jun1okamura/TR-1um_C4004_Clone2Build/Summary.md

# TR-1um C4004 4-bit CPU 設計・最適化 試行サマリー (`Summary.md`)

本ドキュメントは、OpenSUSI `TR-1um` PDK（1 µm CMOS、2層メタル `M1`/`M2`、電源電圧 `5.0 V`、`2500 µm × 2500 µm` 16パッドフレーム）を用いた Intel 4004 互換 4-bit CPU（`C4004`）の自動設計・レイアウト・ポストレイアウト検証の試行結果を試行番号順（**全10回試行：`TR-1um_C4004_01` 〜 `TR-1um_C4004_10` 完了**）に記載したものです。

---

## 試行比較一覧表（第1回〜第10回 全試行サマリー）

| 項目 | 第1回試行 (`TR-1um_C4004_01`) | 第2回試行 (`TR-1um_C4004_02`) | 第3回試行 (`TR-1um_C4004_03`) | 第4回試行 (`TR-1um_C4004_04`) | 第5回試行 (`TR-1um_C4004_05`) | 第6回試行 (`TR-1um_C4004_06`) | 第7回試行 (`TR-1um_C4004_07`) | 第8回試行 (`TR-1um_C4004_08`) | **第9回試行 (`TR-1um_C4004_09`) [最短WL・最低電力!]** | **第10回試行 (`TR-1um_C4004_10`) [歴代最速19.0MHz更新!!]** |
| :--- | :---: | :---: | :---: | :---: | :---: | :---: | :---: | :---: | :---: | :---: |
| **チップ外形 / コア領域** | `2500×2500 µm` / `1840×1840 µm` | `2500×2500 µm` / `1840×1840 µm` | `2500×2500 µm` / `1840×1840 µm` | `2500×2500 µm` / `1840×1840 µm` | `2500×2500 µm` / `1840×1840 µm` | `2500×2500 µm` / `1840×1840 µm` | `2500×2500 µm` / `1840×1840 µm` | `2500×2500 µm` / `1840×1840 µm` | `2500×2500 µm` / `1840×1840 µm` | **`2500×2500 µm` / `1840×1840 µm`** |
| **RTLマイクロアーキテクチャ最適化** | 基本37-FF + リップルキャリー共有加算器 | シャドウPCバイパス (`buf_l/m/h` 直出) + 明示的4-bit CLA | `X1` 先行レジスタ読出しパイプラインALU (`buf_l` 共用) | 完全ノンストップShadow PC + 専用 `reg_buf` `X1` 先行読出しフルサイクルCLA | 完全ノンストップShadow PC + 4-bit完全対称 `NAND3+MUXDFFRB` `reg_buf[3:0]` | 完全ノンストップShadow PC + 4-bit対称 `reg_buf[3:0]` + `d_hiz`/`d_oe` 専用高駆動 `BUF_X2` | 完全ノンストップShadow PC + 4-bit対称 `reg_buf[3:0]` + `d_hiz`/`d_oe` `BUF_X2` + `OR3+INV_X1` `sram_ce` ドライバ | 完全ノンストップShadow PC + 4-bit対称 `reg_buf[3:0]` + `clk_in_th` 直結単段 `NOR3` `sram_ce` + 9系統クロック/リセットツリー | 完全ノンストップShadow PC + 4-bit対称 `reg_buf[3:0]` + `clk_in_th` 直結単段 `NOR3` `sram_ce` + `_1072_` 南端直近配置 + 8系統低容量クロック/リセットツリー (`FO=9`) | **完全ノンストップShadow PC + 8系統クロック/リセットツリー (`FO=9`) + `d_hiz`/`d_oe` カスケード分離 (`FO(d_hiz_pre)=1`) + `X1` 半周期 `reg_buf[3:0]`・`NAND2/3` Row 8 `SRAM128` 直下集約配置** |
| **`SRAM128` 配置座標 `(X, Y)`** | `(338.2 µm, 1603.8 µm)` | `(334.8 µm, 1587.6 µm)` | `(334.8 µm, 1609.2 µm)` | `(334.8 µm, 1614.6 µm)` | `(340.2 µm, 1614.6 µm)` | `(345.6 µm, 1614.6 µm)` | `(340.2 µm, 1609.2 µm)` | `(340.2 µm, 1614.6 µm)` | `(334.8 µm, 1614.6 µm)` | **`(340.2 µm, 1614.6 µm)`（水平中央・北端）** |
| **スタンダードセル行数（チャネル数）** | `9` 行（ピッチ `178.2 µm` / チャネル `118.8 µm`） | `10` 行（ピッチ `156.6 µm` / チャネル `97.2 µm`） | `10` 行（GCell整合ピッチ `162.0 µm` / チャネル `102.6 µm`） | `11` 行（ピッチ `145.8 µm` / チャネル `86.4 µm` = 16トラック） | `11` 行（ピッチ `145.8 µm` / チャネル `86.4 µm` = 16トラック） | `11` 行（ピッチ `145.8 µm` / チャネル `86.4 µm` = 16トラック） | `11` 行（ピッチ `145.8 µm` / チャネル `86.4 µm` = 16トラック） | `11` 行（ピッチ `145.8 µm` / チャネル `86.4 µm` = 16トラック） | `11` 行（ピッチ `145.8 µm` / チャネル `86.4 µm` = 16トラック） | **`11` 行（ピッチ `145.8 µm` / チャネル `86.4 µm` = 16トラック）** |
| **総サイト数 / ロジック使用サイト数** | `2,925` / `2,726` (`93.20%`) | `3,250` / `2,649` (`81.51%`) | `3,250` / `2,764` (`85.05%`) | `3,575` / `2,839` (`79.41%`) | `3,575` / `2,837` (`79.36%`) | `3,575` / `2,843` (`79.52%`) | `3,575` / `2,846` (`79.61%`) | `3,575` / `2,837` (`79.36%`) | **`3,575` / `2,831` (`79.19%` 最低密度!)** | **`3,575` / `2,831` (`79.19%` 最低密度タイ!)** |
| **論理セル数（標準セル + マクロ）** | `599` (`598` stdcells + `1 SRAM128`) | `579` (`578` stdcells + `1 SRAM128`) | `607` (`606` stdcells + `1 SRAM128`) | `616` (`615` stdcells + `1 SRAM128`) | `614` (`613` stdcells + `1 SRAM128`) | `616` (`615` stdcells + `1 SRAM128`) | `617` (`616` stdcells + `1 SRAM128`) | `614` (`613` stdcells + `1 SRAM128`) | **`612` (`611` stdcells + `1 SRAM128` 41-FF最少!)** | **`612` (`611` stdcells + `1 SRAM128` 41-FF最少タイ!)** |
| **順序回路（FF）数** | `37` (`22 MUXDFFRB` + `15 DFFRB`) | `37` (`22 MUXDFFRB` + `15 DFFRB`) | `37` (`22 MUXDFFRB` + `15 DFFRB`) | `41` (`25 MUXDFFRB` + `16 DFFRB`) | `41` (`26 MUXDFFRB` + `15 DFFRB`) | `41` (`26 MUXDFFRB` + `15 DFFRB`) | `41` (`26 MUXDFFRB` + `15 DFFRB`) | `41` (`26 MUXDFFRB` + `15 DFFRB`) | `41` (`26 MUXDFFRB` + `15 DFFRB`) | **`41` (`26 MUXDFFRB` + `15 DFFRB`)** |
| **デキャップ（Filler）セル数 / サイト数** | `72` (`55 FILL3` + `17 FILL2`) / `199` sites | `211` (`179 FILL3` + `32 FILL2`) / `601` sites | `175` (`136 FILL3` + `39 FILL2`) / `486` sites | `257` (`222 FILL3` + `35 FILL2`) / `736` sites | `254` (`230 FILL3` + `24 FILL2`) / `738` sites | `253` (`226 FILL3` + `27 FILL2`) / `732` sites | `255` (`219 FILL3` + `36 FILL2`) / `729` sites | `258` (`222 FILL3` + `36 FILL2`) / `738` sites | **`256` (`232 FILL3` + `24 FILL2`) / `744` sites（最大!）** | **`258` (`228 FILL3` + `30 FILL2`) / `744` sites（最大タイ!）** |
| **総トランジスタ数（結合後 / マルチフィンガ展開）** | `6,108` / `6,368` MOSFETs (+ `28` Diodes) | `6,252` / `6,512` MOSFETs (+ `28` Diodes) | `6,364` / `6,624` MOSFETs (+ `28` Diodes) | `6,692` / `6,952` MOSFETs (+ `28` Diodes) | `6,686` / `6,946` MOSFETs (+ `28` Diodes) | `6,692` / `6,952` MOSFETs (+ `28` Diodes) | `6,700` / `6,960` MOSFETs (+ `28` Diodes) | `6,694` / `6,954` MOSFETs (+ `28` Diodes) | **`6,682` / `6,942` MOSFETs (+ `28` Diodes, 41-FF最少!)** | `6,686` / `6,946` MOSFETs (+ `28` Diodes) |
| **OpenROAD 総配線長 (`M1` + `M2`)** | `442,818 µm` (`218,035` + `224,783 µm`) | **`420,271 µm`** (`215,633` + `204,637 µm`) | `431,639 µm` (`214,383` + `217,256 µm`) | `448,871 µm` (`224,708` + `224,162 µm`) | `446,626 µm` (`222,628` + `223,997 µm`) | `448,037 µm` (`224,286` + `223,750 µm`) | `456,846 µm` (`225,921` + `230,924 µm`) | `438,162 µm` (`217,831` + `220,331 µm`) | **`430,680 µm` (`216,368` + `214,312 µm`) [41-FF最短!]** | `450,643 µm` (`220,437` + `230,206 µm`) |
| **信号ビア (`V1`) 総数** | `2,756` | `2,643` | **`2,607`（最小ビア数）** | `2,890` | `2,906` | `2,939` | `2,910` | `2,844` | **`2,717` [41-FF最少! 第1回37-FFより少!]** | `2,985` |
| **OpenROAD DRC / KLayout DRC** | **`0` 件 / `0` 件** | **`0` 件 / `0` 件** | **`0` 件 / `0` 件** | **`0` 件 / `0` 件** | **`0` 件 / `0` 件** | **`0` 件 / `0` 件** | **`0` 件 / `0` 件** | **`0` 件 / `0` 件** | **`0` 件 / `0` 件** | **`0` 件 / `0` 件** |
| **KLayout LVS (`deep` & `flat`)** | **`Match`（完全一致）** | **`Match`（完全一致）** | **`Match`（完全一致）** | **`Match`（完全一致）** | **`Match`（完全一致）** | **`Match`（完全一致）** | **`Match`（完全一致）** | **`Match`（完全一致）** | **`Match`（完全一致）** | **`Match`（完全一致）** |
| **最大動作周波数 `FMAX` (`ngspice`, `1.0 pF`)** | `8.0 MHz` (内部ALU `9.0 MHz`) | `11.0 MHz` (内部ALU `11.0 MHz`) | `8.5 MHz` (内部ALU `15.0 MHz`) | `16.5 MHz` (外部PC `20.0+ MHz`) | `17.0 MHz` (外部PC `20.0+ MHz`) | `17.0 MHz` (外部PC `22.0+ MHz`) | `16.0 MHz` | `18.5 MHz` (`+131.3%` / `2.313倍`) | `18.5 MHz` (`+131.3%` + `19 MHz` 外部バスPASS!) | **`19.0 MHz` (`+137.5%` / `2.375倍` 全10回歴代最高速更新!!)** |
| **命令サイクル時間 (`8 × T_clk`) @ `FMAX`** | `1.000 µs` (`1.00 MIPS`) | `0.727 µs` (`1.375 MIPS`) | `0.941 µs` (`1.063 MIPS`) | `0.485 µs` (`2.063 MIPS`) | `0.471 µs` (`2.125 MIPS`) | `0.471 µs` (`2.125 MIPS`) | `0.500 µs` (`2.000 MIPS`) | `0.432 µs` (`2.313 MIPS`) | `0.432 µs` (`2.313 MIPS`) | **`0.421 µs` (`2.375 MIPS` 歴代最高スループット更新!!)** |
| **パッド出力遅延 `t_pd` (`sync` / `cm_rom` / `d_oe` / `D[3:0]`)** | `33.66` / `33.89` / `43.13` / `39.83 ns` | `34.23` / `39.32` / `44.72` / `40.72 ns` | `33.82` / `34.03` / `44.66` / `39.44 ns` | `35.30` / `35.59` / `47.42` / `41.41 ns` | `35.29` / `35.57` / `47.40` / `41.39 ns` | `35.29` / `35.57` / `44.86` / `40.85 ns` | `34.78` / `35.09` / `44.39` / `40.37 ns` | `34.71` / `35.00` / `44.29` / `40.28 ns` | **`34.37` / `34.69` / `43.95` / `39.96 ns` (@ `18.5 MHz`)** | **`34.37` / `34.67` / `45.47` / `39.81 ns` (@ `19.0 MHz` 41-FF最短 `D[3:0]` 遅延!)** |
| **消費電力 (`@ 1 MHz` / `@ 8 MHz` / `@ FMAX`)** | `1.688 mW` / `12.509 mW` / `12.509 mW` | `1.560 mW` / `11.508 mW` / `15.750 mW` (`@ 11 MHz`) | `1.686 mW` / `12.407 mW` / `13.177 mW` (`@ 8.5 MHz`) | `1.604 mW` / `11.911 mW` / `24.329 mW` (`@ 16.5 MHz`) | `1.602 mW` / `11.897 mW` / `25.045 mW` (`@ 17.0 MHz`) | `1.613 mW` / `11.973 mW` / `25.208 mW` (`@ 17.0 MHz`) | `1.609 mW` / `11.952 mW` / `23.658 mW` (`@ 16.0 MHz`) | `1.588 mW` / `11.783 mW` / `26.995 mW` (`@ 18.5 MHz`) | **`1.570 mW` / `11.630 mW` (41-FF最小!) / `26.641 mW` (`@ 18.5 MHz`)** | `1.574 mW` / `11.673 mW` / **`27.469 mW` (`@ 19.0 MHz`)** |

---

## 第1回試行：`TR-1um_C4004_01`

### 1. アーキテクチャおよびフロアプランの特徴
1. **アーキテクチャ構成**:
   - Intel 4004 の全45命令を完全実装。16本の4-bitインデックスレジスタ（`R0〜R15`）および4レベルの12-bitプログラムカウンタ/スタック（`4 × 3 nibbles`）を単一の `SRAM128` に統合。
   - `A1〜A3` フェーズのシリアルPCインクリメンタと `X2` フェーズのALU/レジスタインクリメンタで単一の4-bit加算器を共有し、37個のフリップフロップ（`22 MUXDFFRB` + `15 DFFRB`）に状態機械を凝縮。
2. **フロアプラン・`SRAM128` 配置・チャネル構成**:
   - **スタンダードセル行数**: 9行（`Y = 32.4 µm 〜 1458.0 µm`、行ピッチ `178.2 µm`、配線チャネル高さ `118.8 µm` = 22トラック、全 `2,925` サイト）。
   - **`SRAM128` マクロ配置**: コア上部中央 `(X = 338.2 µm, Y = 1603.8 µm)` に配置。
   - **最大動作周波数**: ポストレイアウト `ngspice` 検証で **`FMAX = 8.0 MHz`**（内部ALUは `9.0 MHz` まで動作、`A1` での `negedge clk` からの `SRAM128` PC読み出し → `D[3:0]` パッド出力パスが律速）。

### 2. セル・素子・配線統計諸表 (`TR-1um_C4004_01`)

| カテゴリ | 項目 | 数値 | 備考 |
| :--- | :--- | :---: | :--- |
| **セル・サイト統計** | ロジック標準セル数 | `598` 個 | 使用サイト数 `2,726` / `2,925` (`93.20%`) |
| | 内 順序回路（FF） | `37` 個 | `MUXDFFRB`: 22個, `DFFRB`: 15個 |
| | 内 入力シュミットバッファ | `7` 個 | `BUFTH`: 7個 (`clk, rst, test, d_in[3:0]`) |
| | 内 クロック/リセット/高FOバッファ | `56` 個 | `BUF_X2`: クロック9 + リセット9 + 高FO 38個 |
| | 内 組み合わせ論理セル | `498` 個 | 基本37-FF + リップルキャリー共有加算器 |
| | メモリマクロ | `1` 個 | `SRAM128` (`(338.2 µm, 1603.8 µm)`, `1,212` MOSFETs) |
| | 基板タップセル (`TAP2`) | `36` 個 | 4列 × 9行 |
| | デキャップFillerセル | `72` 個 | `FILL3`: 55個 (`165` sites), `FILL2`: 17個 (`34` sites), `FILL1`: 0個（計 `199` sites） |
| **抽出素子統計** | フルチップ総MOSFET数（展開後） | `6,368` 個 | `PMOS`: 2,990, `NMOS`: 3,218, `NMOSE`: 160 (+`28` Diodes) |
| | フルチップ総MOSFET数（結合後） | `6,108` 個 | `PMOS`: 2,860, `NMOS`: 3,218, `NMOSE`: 30 (+`28` Diodes) |
| | コア (`c4004_core`) MOSFET数 | `5,824` 個 | `PMOS`: 2,718, `NMOS`: 3,106（内 `SRAM128`: `1,212` 個） |
| **配線・サインオフ** | 総信号ネット数 / 最大FO | `647` / `10` | 全ネット `FO <= 10` 達成 |
| | OpenROAD 総配線長 | `442,818 µm` | `METAL1`: `218,035 µm` (`49.24%`), `METAL2`: `224,783 µm` (`50.76%`) |
| | 信号ビア (`V1`) 数 | `2,756` 個 | OpenROAD DRC `0` 件完走 |
| | KLayout DRC / LVS | **`0` 件 / `Match`** | `deep` / `flat` 両モードで完全一致 |

### 3. ポストレイアウト `ngspice` 検証・周波数スイープ結果 (`TR-1um_C4004_01`)

| クロック周波数 | 周期 `T_clk` | 総合判定 | `PC` 出力 (`A1..A3`) | 内部ALU `ACC` (`X2`) | `t_pd(sync)` | `t_pd(cm_rom)` | `t_pd(d_oe)` | `t_pd(D[3:0])` | 平均電流 `I_VDD` | 平均消費電力 `P_avg` |
| :---: | :---: | :---: | :---: | :---: | :---: | :---: | :---: | :---: | :---: | :---: |
| **`1.0 MHz`** | `1000.0 ns` | **PASS** | `0x006` | **`0xA`** | `33.65 ns` | `33.87 ns` | `43.14 ns` | `39.84 ns` | `0.338 mA` | `1.688 mW` |
| **`2.0 MHz`** | `500.0 ns` | **PASS** | `0x006` | **`0xA`** | `33.66 ns` | `33.87 ns` | `43.14 ns` | `39.84 ns` | `0.649 mA` | `3.246 mW` |
| **`4.0 MHz`** | `250.0 ns` | **PASS** | `0x006` | **`0xA`** | `33.66 ns` | `33.88 ns` | `43.14 ns` | `39.84 ns` | `1.270 mA` | `6.349 mW` |
| **`6.0 MHz`** | `166.7 ns` | **PASS** | `0x006` | **`0xA`** | `33.66 ns` | `33.88 ns` | `43.13 ns` | `39.83 ns` | `1.886 mA` | `9.431 mW` |
| **`8.0 MHz`** | `125.0 ns` | **PASS (`FMAX`)** | `0x006` | **`0xA`** | `33.66 ns` | `33.89 ns` | `43.13 ns` | `39.83 ns` | `2.502 mA` | `12.509 mW` |
| `9.0 MHz` | `111.1 ns` | FAIL (外部PC) | `0x000` | **`0xA` (内部PASS)** | `33.65 ns` | `33.89 ns` | `43.12 ns` | `39.83 ns` | `2.753 mA` | `13.765 mW` |
| `10.0 MHz` | `100.0 ns` | FAIL | `0x009` | `0xB` | `33.65 ns` | `33.89 ns` | `43.12 ns` | `39.83 ns` | `3.004 mA` | `15.019 mW` |
| `12.0 MHz` | `83.3 ns` | FAIL | `0x019` | `0x3` | `33.54 ns` | `33.76 ns` | `42.99 ns` | `39.71 ns` | `3.707 mA` | `18.537 mW` |
| `14.0 MHz` | `71.4 ns` | FAIL | `0x819` | `0x9` | `33.46 ns` | `33.69 ns` | `42.92 ns` | `39.64 ns` | `4.656 mA` | `23.282 mW` |
| `16.0 MHz` | `62.5 ns` | FAIL | `0x819` | `0x5` | `33.42 ns` | `33.63 ns` | `42.86 ns` | `39.58 ns` | `5.210 mA` | `26.052 mW` |

---

## 第2回試行：`TR-1um_C4004_02`

### 1. RTL最適化・`SRAM128` 配置・チャネル構成の特徴
1. **RTLマイクロアーキテクチャの刷新**:
   - **シャドウPCバイパス (`pc_init_n` 機構)**: `A3` で `pc_init_n <= 1'b0` となった後は、`buf_l/m/h` に保持されているPC+1を次サイクルの `A1〜A3` で `posedge clk` 直後から直接出力・インクリメントするバイパス回路を実装し、外部PC出力タイミングを半クロック周期（`0.5 × T_clk`）前倒し。
   - **明示的4ビット桁上げ先見加算器 (CLA)**: 共有4ビット加算器を2段論理のCLAに変更。
2. **フロアプラン・`SRAM128` 配置・チャネル構成**:
   - **スタンダードセル行数**: 9行から **10行**（行ピッチ `156.6 µm`、チャネル幅 `97.2 µm` = 18トラック、全 `3,250` サイト）に拡張し、`SRAM128` を `(334.8 µm, 1587.6 µm)` に配置。
   - **デキャップ増強・配線短縮**: 空きサイトに **`211` 個（`601` サイト、第1回比 3.02倍）** のデキャップFillerを挿入し、総配線長を `420,271 µm`（`-5.09%`）に短縮。
   - **最大動作周波数**: **`FMAX = 11.0 MHz`（第1回比 `+37.5%` 高速化）** を達成。`11.5 MHz` では `X2` 半周期内での `SRAM128` 読み出し＋CLA加算パスが律速。

### 2. セル・素子・配線統計諸表 (`TR-1um_C4004_02`)

| カテゴリ | 項目 | 数値 | 備考 |
| :--- | :--- | :---: | :--- |
| **セル・サイト統計** | ロジック標準セル数 | `578` 個 | 使用サイト数 `2,649` / `3,250` (`81.51%`) |
| | 内 順序回路（FF） | `37` 個 | `MUXDFFRB`: 22個, `DFFRB`: 15個 |
| | 内 入力シュミットバッファ | `7` 個 | `BUFTH`: 7個 (`clk, rst, test, d_in[3:0]`) |
| | 内 クロック/リセット/高FOバッファ | `56` 個 | `BUF_X2`: クロック10 + リセット10 + 高FO 36個 |
| | 内 組み合わせ論理セル | `478` 個 | Shadow PCバイパス + 明示的4-bit CLA（`-20` セル削減） |
| | メモリマクロ | `1` 個 | `SRAM128` (`(334.8 µm, 1587.6 µm)`, `1,212` MOSFETs) |
| | 基板タップセル (`TAP2`) | `40` 個 | 4列 × 10行 |
| | デキャップFillerセル | `211` 個 | `FILL3`: 179個 (`537` sites), `FILL2`: 32個 (`64` sites), `FILL1`: 0個（計 `601` sites） |
| **抽出素子統計** | フルチップ総MOSFET数（展開後） | `6,512` 個 | `PMOS`: 3,062, `NMOS`: 3,290, `NMOSE`: 160 (+`28` Diodes) |
| | フルチップ総MOSFET数（結合後） | `6,252` 個 | `PMOS`: 2,932, `NMOS`: 3,290, `NMOSE`: 30 (+`28` Diodes) |
| | コア (`c4004_core`) MOSFET数 | `5,968` 個 | `PMOS`: 2,790, `NMOS`: 3,178（内 `SRAM128`: `1,212` 個） |
| **配線・サインオフ** | 総信号ネット数 / 最大FO | `627` / `10` | 全ネット `FO <= 10` 達成 |
| | OpenROAD 総配線長 | **`420,271 µm`** | `METAL1`: `215,633 µm` (`51.31%`), `METAL2`: `204,637 µm` (`48.69%`) [最短配線長] |
| | 信号ビア (`V1`) 数 | `2,643` 個 | OpenROAD DRC `0` 件完走 |
| | KLayout DRC / LVS | **`0` 件 / `Match`** | `deep` / `flat` 両モードで完全一致 |

### 3. ポストレイアウト `ngspice` 検証・周波数スイープ結果 (`TR-1um_C4004_02`)

| クロック周波数 | 周期 `T_clk` | 総合判定 | `PC` 出力 (`A1..A3`) | 内部ALU `ACC` (`X2`) | `t_pd(sync)` | `t_pd(cm_rom)` | `t_pd(d_oe)` | `t_pd(D[3:0])` | 平均電流 `I_VDD` | 平均消費電力 `P_avg` |
| :---: | :---: | :---: | :---: | :---: | :---: | :---: | :---: | :---: | :---: | :---: |
| **`1.0 MHz`** | `1000.0 ns` | **PASS** | `0x006` | **`0xA`** | `34.30 ns` | `39.38 ns` | `44.80 ns` | `40.80 ns` | `0.312 mA` | `1.560 mW` |
| **`2.0 MHz`** | `500.0 ns` | **PASS** | `0x006` | **`0xA`** | `34.30 ns` | `39.38 ns` | `44.80 ns` | `40.80 ns` | `0.599 mA` | `2.996 mW` |
| **`4.0 MHz`** | `250.0 ns` | **PASS** | `0x006` | **`0xA`** | `34.30 ns` | `39.39 ns` | `44.77 ns` | `40.79 ns` | `1.169 mA` | `5.846 mW` |
| **`6.0 MHz`** | `166.7 ns` | **PASS** | `0x006` | **`0xA`** | `34.30 ns` | `39.38 ns` | `44.80 ns` | `40.79 ns` | `1.733 mA` | `8.665 mW` |
| **`8.0 MHz`** | `125.0 ns` | **PASS** | `0x006` | **`0xA`** | `34.31 ns` | `39.39 ns` | `44.79 ns` | `40.79 ns` | `2.302 mA` | `11.508 mW` |
| **`8.5 MHz`** | `117.6 ns` | **PASS** | `0x006` | **`0xA`** | `34.31 ns` | `39.38 ns` | `44.79 ns` | `40.80 ns` | `2.444 mA` | `12.220 mW` |
| **`9.0 MHz`** | `111.1 ns` | **PASS** | `0x006` | **`0xA`** | `34.30 ns` | `39.38 ns` | `44.77 ns` | `40.79 ns` | `2.587 mA` | `12.933 mW` |
| **`9.5 MHz`** | `105.3 ns` | **PASS** | `0x006` | **`0xA`** | `34.28 ns` | `39.37 ns` | `44.77 ns` | `40.79 ns` | `2.729 mA` | `13.645 mW` |
| **`10.0 MHz`** | `100.0 ns` | **PASS** | `0x006` | **`0xA`** | `34.29 ns` | `39.37 ns` | `44.76 ns` | `40.78 ns` | `2.872 mA` | `14.359 mW` |
| **`10.5 MHz`** | `95.2 ns` | **PASS** | `0x006` | **`0xA`** | `34.26 ns` | `39.36 ns` | `44.72 ns` | `40.76 ns` | `3.010 mA` | `15.051 mW` |
| **`11.0 MHz`** | `90.9 ns` | **PASS (`FMAX`)** | `0x006` | **`0xA`** | `34.23 ns` | `39.32 ns` | `44.69 ns` | `40.72 ns` | `3.150 mA` | `15.750 mW` |
| `11.5 MHz` | `87.0 ns` | FAIL (`X2` SRAM+CLA) | `0x026` | `0x3` | `34.20 ns` | `39.29 ns` | `44.66 ns` | `40.70 ns` | `3.350 mA` | `16.749 mW` |
| `12.0 MHz` | `83.3 ns` | FAIL | `0x024` | `0x3` | `34.18 ns` | `39.26 ns` | `44.62 ns` | `40.67 ns` | `3.456 mA` | `17.282 mW` |
| `14.0 MHz` | `71.4 ns` | FAIL | `0x02B` | `0x7` | `34.10 ns` | `39.17 ns` | `44.55 ns` | `40.59 ns` | `4.102 mA` | `20.510 mW` |
| `16.0 MHz` | `62.5 ns` | FAIL | `0x02B` | `0xA` | `34.04 ns` | `39.12 ns` | `44.49 ns` | `40.53 ns` | `4.639 mA` | `23.195 mW` |

---

## 第3回試行：`TR-1um_C4004_03`

### 1. RTL最適化・`SRAM128` 配置・チャネル構成の特徴
1. **RTLマイクロアーキテクチャの刷新（`X1` 先行レジスタ読み出しパイプラインALU）**:
   - 第2回試行で `11.5 MHz` のボトルネックとなった「`X2` ステート半周期内での `SRAM128` インデックスレジスタ読み出し ＋ 4ビットCLA加算」を解消するため、命令コード `opr` とレジスタ番号 `opa` が `M2`（`phase == 4`）で既に確定していることを利用し、**1ステート前の `X1`（`phase == 5`）で `SRAM128` からインデックスレジスタ `R[opa]` を先行読み出しして `buf_l` FFに直接ラッチし、`X2`（`phase == 6`）では1クロック周期丸ごと（`1.0 × T_clk`）を使ってFF間（`buf_l` → CLA → `acc`）でALU演算を実行するパイプライン方式** を実装。
2. **フロアプラン・`SRAM128` 配置・チャネル構成の再設計（GCellグリッド完全整合10行）**:
   - OpenROAD の GCell グリッド（`81.0 µm = 15 × 5.4 µm`）に完全整合するよう、10行の行ピッチを **`162.0 µm`（`30` トラック = `2.0 × GCell`、`Y = 27.0 µm 〜 1485.0 µm`）** に拡大し、各行間の配線チャネル幅を **`102.6 µm`（19トラック）** に拡張。
   - `SRAM128` を北側の **`(X = 334.8 µm, Y = 1609.2 µm)`** に再配置。

### 2. セル・素子・配線統計諸表 (`TR-1um_C4004_03`)

| カテゴリ | 項目 | 数値 | 備考 |
| :--- | :--- | :---: | :--- |
| **セル・サイト統計** | ロジック標準セル数 | `606` 個 | 使用サイト数 `2,764` / `3,250` (`85.05%`) |
| | 内 順序回路（FF） | `37` 個 | `MUXDFFRB`: 22個, `DFFRB`: 15個（追加FFゼロでパイプライン化） |
| | 内 入力シュミットバッファ | `7` 個 | `BUFTH`: 7個 (`clk, rst, test, d_in[3:0]`) |
| | 内 クロック/リセット/高FOバッファ | `49` 個 | `BUF_X2`: クロック10 + リセット10 + 高FO 29個 (`-7` 個さらに削減) |
| | 内 組み合わせ論理セル | `513` 個 | `X1` 先行アドレス選択・`X2` スタック書き込み制御を含む |
| | メモリマクロ | `1` 個 | `SRAM128` (`(334.8 µm, 1609.2 µm)`, `1,212` MOSFETs) |
| | 基板タップセル (`TAP2`) | `40` 個 | 4列 × 10行 |
| | デキャップFillerセル | `175` 個 | `FILL3`: 136個 (`408` sites), `FILL2`: 39個 (`78` sites), `FILL1`: 0個（計 `486` sites） |
| **抽出素子統計** | フルチップ総MOSFET数（展開後） | `6,624` 個 | `PMOS`: 3,118, `NMOS`: 3,346, `NMOSE`: 160 |
| | フルチップ総MOSFET数（結合後） | `6,364` 個 | `PMOS`: 2,988, `NMOS`: 3,346, `NMOSE`: 30 |
| | コア (`c4004_core`) MOSFET数 | `6,080` 個 | `PMOS`: 2,846, `NMOS`: 3,234（内 `SRAM128`: `1,212` 個） |
| **配線・サインオフ** | 総信号ネット数 / 最大FO | `654` / `10` | 全ネット `FO <= 10` 達成 |
| | OpenROAD 総配線長 | `431,639 µm` | `METAL1`: `214,383 µm`（最小M1長更新）, `METAL2`: `217,256 µm` |
| | 信号ビア (`V1`) 数 | **`2,607` 個** | **全試行で最小ビア数更新（第1回比 `-149` 個 / `-5.41%`）**、13反復でDRC 0件収束 |
| | KLayout DRC / LVS | **`0` 件 / `Match`** | `deep` / `flat` 両モードで完全一致 |

### 3. ポストレイアウト `ngspice` 検証・周波数スイープ結果 (`TR-1um_C4004_03`)
- **`X1` 先行レジスタ読み出しパイプラインの効果**: 内部ALUおよびレジスタファイル演算結果（`ACC = 0xA`）は、第2回試行の上限 `11.0 MHz` を大きく超え、**`15.0 MHz`（`T_clk = 66.7 ns`、第1回比 `+66.7%`、第2回比 `+36.4%`）まで完全にPASS** しました。
- **`buf_l` 共用による副作用の発見**: FF数を37個に抑えるために `X1` の先行読み出しラッチ先として `buf_l`（Shadow PC_L）を共用し `pc_init_n <= 1'b1` に戻したため、`LD`/`ADD` 命令の直後の `A1` フェーズで毎回 `SRAM128` からのPC読み出しが発生し、外部バスへの `PC` 出力が `8.5 MHz` で律速となりました。

| クロック周波数 | 周期 `T_clk` | 総合判定 | `PC` 出力 (`A1..A3`) | 内部ALU `ACC` (`X2`) | `t_pd(sync)` | `t_pd(cm_rom)` | `t_pd(d_oe)` | `t_pd(D[3:0])` | 平均電流 `I_VDD` | 平均消費電力 `P_avg` |
| :---: | :---: | :---: | :---: | :---: | :---: | :---: | :---: | :---: | :---: | :---: |
| **`1.0 MHz`** | `1000.0 ns` | **PASS** | `0x006` | **`0xA` (PASS)** | `33.80 ns` | `34.03 ns` | `42.25 ns` | `39.43 ns` | `0.337 mA` | `1.686 mW` |
| **`2.0 MHz`** | `500.0 ns` | **PASS** | `0x006` | **`0xA` (PASS)** | `33.82 ns` | `34.03 ns` | `42.24 ns` | `39.44 ns` | `0.645 mA` | `3.224 mW` |
| **`4.0 MHz`** | `250.0 ns` | **PASS** | `0x006` | **`0xA` (PASS)** | `33.81 ns` | `34.01 ns` | `42.22 ns` | `39.44 ns` | `1.258 mA` | `6.292 mW` |
| **`6.0 MHz`** | `166.7 ns` | **PASS** | `0x006` | **`0xA` (PASS)** | `33.82 ns` | `34.03 ns` | `42.20 ns` | `39.44 ns` | `1.880 mA` | `9.399 mW` |
| **`8.0 MHz`** | `125.0 ns` | **PASS** | `0x006` | **`0xA` (PASS)** | `33.82 ns` | `34.03 ns` | `42.22 ns` | `39.44 ns` | `2.481 mA` | `12.407 mW` |
| **`8.5 MHz`** | `117.6 ns` | **PASS (`FMAX`)** | `0x006` | **`0xA` (PASS)** | `33.84 ns` | `34.03 ns` | `42.21 ns` | `39.45 ns` | `2.635 mA` | `13.177 mW` |
| `9.0 MHz` | `111.1 ns` | FAIL (外部PC) | `0x000` | **`0xA` (内部PASS)** | `33.83 ns` | `34.02 ns` | `42.22 ns` | `39.44 ns` | `2.789 mA` | `13.945 mW` |
| `10.0 MHz` | `100.0 ns` | FAIL (外部PC) | `0x069` | **`0xA` (内部PASS)** | `33.83 ns` | `34.04 ns` | `42.21 ns` | `39.44 ns` | `3.116 mA` | `15.582 mW` |
| `12.0 MHz` | `83.3 ns` | FAIL (外部PC) | `0x029` | **`0xA` (内部PASS)** | `33.71 ns` | `33.90 ns` | `42.07 ns` | `39.32 ns` | `3.672 mA` | `18.359 mW` |
| `14.0 MHz` | `71.4 ns` | FAIL (外部PC) | `0xA19` | **`0xA` (内部PASS)** | `33.64 ns` | `33.82 ns` | `41.98 ns` | `39.25 ns` | `4.396 mA` | `21.980 mW` |
| `15.0 MHz` | `66.7 ns` | FAIL (外部PC) | `0xA99` | **`0xA` (内部PASS!)** | `33.62 ns` | `33.80 ns` | `41.95 ns` | `39.22 ns` | `4.700 mA` | `23.501 mW` |
| `16.0 MHz` | `62.5 ns` | FAIL | `0xA99` | `0x2` | `33.58 ns` | `33.78 ns` | `41.94 ns` | `39.19 ns` | `5.069 mA` | `25.346 mW` |

---

## 第4回試行：`TR-1um_C4004_04`

### 1. RTL最適化・`SRAM128` 配置・チャネル構成の特徴
1. **RTLマイクロアーキテクチャの刷新（完全ノンストップShadow PC ＋ 専用 `reg_buf` `X1` 先行読み出しフルサイクルCLA）**:
   - 第2回試行（**Shadow PCバイパスによる外部PC高速出力**）と、第3回試行（**`X1` 先行レジスタ読み出しによる `15.0 MHz` 内部ALU動作**）を100%両立させるため、**専用4ビットパイプラインレジスタ `reg_buf[3:0]`（計41 FF）** を新設。
   - `X1`（`phase == 5`）で先行読み出ししたインデックスレジスタ値 `R[opa]` や、`FIM` 第2サイクル（`M1`/`M2`）の即値データをすべて `reg_buf[3:0]` に格納し、`FIM` では `M2`/`X1` で早期に `SRAM128` へ書き込むアーキテクチャを実装。
   - これにより、**`FIM`・`LD`・`ADD`・`SUB`・`INC`・`ISZ`・`XCH`・`SRC` の実行中も Shadow PC (`buf_l/buf_m/buf_h`) が一切上書きされず常時 `PC+1` を保持し続け（`pc_init_n` が常時 `0` を維持）**、外部PC出力も `SRC` アドレス出力も `X2` ALU演算もすべて `posedge clk` 直後からFF出力で動作するノンストップパイプラインを実現。
2. **フロアプラン・`SRAM128` 配置・11行チャネル構成の再設計**:
   - **スタンダードセル行数**: 10行から **11行**（行ピッチ `145.8 µm` = `27` トラック、配線チャネル幅 `86.4 µm` = `16` トラック×11チャネル、`Y = 27.0 µm 〜 1544.4 µm`、総サイト数 **`3,575` サイト**）に拡張。
   - **`SRAM128` マクロ配置**: 北側の **`(X = 334.8 µm, Y = 1614.6 µm)`** に配置。
   - **最大デキャップ容量**: ロジック使用率を **`79.41%`（`2,839 / 3,575` サイト）** まで低減し、空きサイトに **`257` 個（`222 FILL3` + `35 FILL2` = `736` サイト、第1回比 3.70倍、`FILL1 = 0`）** のMOSデカップリングキャパシタを配置。

### 2. セル・素子・配線統計諸表 (`TR-1um_C4004_04`)

| カテゴリ | 項目 | 数値 | 備考 |
| :--- | :--- | :---: | :--- |
| **セル・サイト統計** | ロジック標準セル数 | `615` 個 | 使用サイト数 `2,839` / `3,575` (`79.41%`) |
| | 内 順序回路（FF） | `41` 個 | `MUXDFFRB`: 25個, `DFFRB`: 16個（専用 `reg_buf[3:0]` 4-FF追加） |
| | 内 入力シュミットバッファ | `7` 個 | `BUFTH`: 7個 (`clk, rst, test, d_in[3:0]`) |
| | 内 クロック/リセット/高FOバッファ | `45` 個 | `BUF_X2`: クロック10 + リセット10 + 高FO 25個（第3回比 `-4` 個削減） |
| | 内 組み合わせ論理セル | `522` 個 | 完全ノンストップShadow PC + フルサイクルCLA制御 |
| | メモリマクロ | `1` 個 | `SRAM128` (`(334.8 µm, 1614.6 µm)`, `1,212` MOSFETs) |
| | 基板タップセル (`TAP2`) | `44` 個 | 4列 × 11行 |
| | デキャップFillerセル | `257` 個 | `FILL3`: 222個 (`666` sites), `FILL2`: 35個 (`70` sites), `FILL1`: 0個（計 `736` sites） |
| **抽出素子統計** | フルチップ総MOSFET数（展開後） | `6,952` 個 | `PMOS`: 3,282, `NMOS`: 3,510, `NMOSE`: 160 |
| | フルチップ総MOSFET数（結合後） | `6,692` 個 | `PMOS`: 3,152, `NMOS`: 3,510, `NMOSE`: 30 |
| | コア (`c4004_core`) MOSFET数 | `6,408` 個 | `PMOS`: 3,010, `NMOS`: 3,398（内 `SRAM128`: `1,212` 個） |
| **配線・サインオフ** | 総信号ネット数 / 最大FO | `667` / `10` | 全ネット `FO <= 10` 達成 |
| | OpenROAD 総配線長 | `448,871 µm` | `METAL1`: `224,708 µm` (`50.06%`), `METAL2`: `224,162 µm` (`49.94%`) |
| | 信号ビア (`V1`) 数 | `2,890` 個 | 13反復 (`68.69 s`) で OpenROAD DRC `0` 件収束 |
| | KLayout DRC / LVS | **`0` 件 / `Match`** | `deep` / `flat` 両モードで完全一致 |

### 3. ポストレイアウト `ngspice` 検証・周波数スイープ結果 (`TR-1um_C4004_04`)
- **大幅な最高周波数更新**:
   - Test 4 周波数スイープにおいて、**`1.0 MHz` から `16.5 MHz`（`T_clk = 60.61 ns`、命令実行速度 `2.063 MIPS`）まで外部PC出力（`0x006`）とALU演算結果（`0xA`）の両方が完全PASS** しました（第1回試行 `8.0 MHz` の `2.06倍`）。
   - 一方、`17.0 MHz`（`T_clk = 58.82 ns`）での内部波形を詳細解析した結果、`reg_buf[0..2]`（`_1143_.._1145_`）はすべて `NAND2 -> NAND3 -> MUXDFFRB` の高速2段反転＋統合マルチプレクサFF構成となっていて `17.0 MHz` でも余裕をもってラッチできていたのに対し、**最上位ビット `reg_buf[3]`（`_1146_`）のみがABCマッピングの非対称性により `NOR2 (_1005_) + AND3_X1 (_1011_) + AOI21 (_1012_) + DFFRB (_1146_)` という4段相当の直列ゲート＋単体FF構成となっていたため、`X1` 半周期（`29.4 ns`）の `sram_do[3] -> reg_buf[3]` パスが約 `1.5 ns` だけセットアップ時間に届いていない** ことを特定しました。

| クロック周波数 | 周期 `T_clk` | 総合判定 | `PC` 出力 (`A1..A3`) | 内部ALU `ACC` (`X2`) | `t_pd(sync)` | `t_pd(cm_rom)` | `t_pd(d_oe)` | `t_pd(D[3:0])` | 平均電流 `I_VDD` | 平均消費電力 `P_avg` |
| :---: | :---: | :---: | :---: | :---: | :---: | :---: | :---: | :---: | :---: | :---: |
| **`1.0 MHz`** | `1000.0 ns` | **PASS** | `0x006` | **`0xA`** | `35.55 ns` | `35.83 ns` | `47.77 ns` | `41.68 ns` | `0.321 mA` | `1.604 mW` |
| **`2.0 MHz`** | `500.0 ns` | **PASS** | `0x006` | **`0xA`** | `35.56 ns` | `35.84 ns` | `47.78 ns` | `41.69 ns` | `0.617 mA` | `3.087 mW` |
| **`4.0 MHz`** | `250.0 ns` | **PASS** | `0x006` | **`0xA`** | `35.56 ns` | `35.85 ns` | `47.77 ns` | `41.69 ns` | `1.207 mA` | `6.034 mW` |
| **`6.0 MHz`** | `166.7 ns` | **PASS** | `0x006` | **`0xA`** | `35.56 ns` | `35.84 ns` | `47.76 ns` | `41.67 ns` | `1.794 mA` | `8.969 mW` |
| **`8.0 MHz`** | `125.0 ns` | **PASS** | `0x006` | **`0xA`** | `35.56 ns` | `35.85 ns` | `47.74 ns` | `41.66 ns` | `2.382 mA` | `11.911 mW` |
| **`10.0 MHz`** | `100.0 ns` | **PASS** | `0x006` | **`0xA`** | `35.56 ns` | `35.84 ns` | `47.72 ns` | `41.67 ns` | `2.972 mA` | `14.860 mW` |
| **`11.0 MHz`** | `90.9 ns` | **PASS** | `0x006` | **`0xA`** | `35.49 ns` | `35.77 ns` | `47.64 ns` | `41.59 ns` | `3.262 mA` | `16.310 mW` |
| **`12.0 MHz`** | `83.3 ns` | **PASS** | `0x006` | **`0xA`** | `35.45 ns` | `35.73 ns` | `47.58 ns` | `41.56 ns` | `3.552 mA` | `17.761 mW` |
| **`13.0 MHz`** | `76.9 ns` | **PASS** | `0x006` | **`0xA`** | `35.40 ns` | `35.68 ns` | `47.56 ns` | `41.51 ns` | `3.842 mA` | `19.211 mW` |
| **`14.0 MHz`** | `71.4 ns` | **PASS** | `0x006` | **`0xA`** | `35.36 ns` | `35.65 ns` | `47.54 ns` | `41.47 ns` | `4.132 mA` | `20.661 mW` |
| **`15.0 MHz`** | `66.7 ns` | **PASS** | `0x006` | **`0xA`** | `35.33 ns` | `35.63 ns` | `47.49 ns` | `41.44 ns` | `4.425 mA` | `22.126 mW` |
| **`16.0 MHz`** | `62.5 ns` | **PASS** | `0x006` | **`0xA`** | `35.31 ns` | `35.60 ns` | `47.44 ns` | `41.42 ns` | `4.717 mA` | `23.587 mW` |
| **`16.5 MHz`** | `60.6 ns` | **PASS (`FMAX`)** | `0x006` | **`0xA`** | `35.30 ns` | `35.59 ns` | `47.42 ns` | `41.41 ns` | `4.866 mA` | `24.329 mW` |
| `17.0 MHz` | `58.8 ns` | FAIL (`reg_buf[3]`) | `0x006` (PASS) | `0x2` | `35.29 ns` | `35.57 ns` | `47.40 ns` | `41.39 ns` | `4.982 mA` | `24.909 mW` |
| `18.0 MHz` | `55.6 ns` | FAIL (`M1` バス解放待ち) | `0x006` (PASS) | `0x0` | `35.26 ns` | `35.55 ns` | `47.39 ns` | `41.37 ns` | `5.191 mA` | `25.954 mW` |
| `20.0 MHz` | `50.0 ns` | FAIL (`M1` バス解放待ち) | `0x006` (PASS) | `0x0` | `35.23 ns` | `35.52 ns` | `47.36 ns` | `41.33 ns` | `5.766 mA` | `28.829 mW` |

---

## 第5回試行：`TR-1um_C4004_05`（最終試行・最高性能達成）

### 1. RTL・ゲートレベル対称最適化・`SRAM128` 配置・チャネル構成の特徴
1. **`reg_buf[3:0]` の完全対称 `NAND3 + MUXDFFRB` パイプライン化（クリティカルパス2段削減）**:
   - 第4回試行の `17.0 MHz` において唯一のボトルネックであった `reg_buf[3]`（`_1146_`）の入力コーン `NOR2 (_1005_) + AND3_X1 (_1011_) + AOI21 (_1012_) -> DFFRB (_1146_)` が、ブール代数的に `MUX2(.A(reg_buf[3]), .B(NAND3(_0468_, _0469_, _0470_)), .S(_0307_))` と完全に等価であることに着目。
   - これを下位3ビット `reg_buf[0..2]`（`_0824_.._0837_` + `_1143_.._1145_`）と完全同一の **`NAND3 (_1011_) + MUXDFFRB (_1146_)`** 構造へ再構築し、全41個のFFのうち **`26` 個を `MUXDFFRB` に統合** しました。
   - これにより、`sram_do[3] -> reg_buf[3]` の `X1` プリリードパスから **ゲート段数2段分（約 `3.5 ns`）の遅延を削減** すると同時に、**標準セル数を `615` 個から `613` 個へ削減、使用サイト数を `2,839` サイトから `2,837` サイト（利用率 `79.36%`：全5回試行で最低密度！）へ削減** しました。
2. **フロアプラン・`SRAM128` 水平中央配置・11行チャネル構成**:
   - **スタンダードセル行数**: 11行構成（行ピッチ `145.8 µm` = `27` トラック、配線チャネル幅 `86.4 µm` = `16` トラック×11チャネル、`Y = 27.0 µm 〜 1544.4 µm`、総サイト数 `3,575` サイト）を採用。
   - **`SRAM128` マクロ配置**: 11行コアの水平方向完全中央である **`(X = 340.2 µm, Y = 1614.6 µm)`** に配置し、左右の `TAP2` 電源ストラップおよび東西信号パッドへの配線対称性を最適化。
   - **最大デキャップ容量の更新**: 空きサイト数が全試行最大の **`738` サイト（`230 FILL3` + `24 FILL2` = `254` 個、`FILL1 = 0`、第1回試行 `199` サイトの `3.71倍`）** に到達し、さらに `reg_buf[3]`（`_1146_`）の配置も第4回試行の Row 2（`Y = 318.6 µm`）から Row 3（`Y = 464.4 µm`）へと `SRAM128` に `145.8 µm` 近づいたことで、配線長を `448,871 µm` から **`446,626 µm`（`-2,245 µm` 短縮）** に改善しました。

### 2. セル・素子・配線統計諸表 (`TR-1um_C4004_05`)

| カテゴリ | 項目 | 数値 | 備考 |
| :--- | :--- | :---: | :--- |
| **セル・サイト統計** | ロジック標準セル数 | **`613` 個** | **使用サイト数 `2,837` / `3,575` (`79.36%`：全試行最低利用率!)** |
| | 内 順序回路（FF） | `41` 個 | **`MUXDFFRB`: 26個（`reg_buf[3:0]` 全4ビット統合!）**, `DFFRB`: 15個 |
| | 内 入力シュミットバッファ | `7` 個 | `BUFTH`: 7個 (`clk, rst, test, d_in[3:0]`) |
| | 内 クロック/リセット/高FOバッファ | `45` 個 | `BUF_X2`: クロック10 + リセット10 + 高FO 25個 |
| | 内 組み合わせ論理セル | `520` 個 | 第4回比 `-2` セル削減（`NOR2 _1005_` 削除 + `MUX2 _1012_` 統合） |
| | メモリマクロ | `1` 個 | `SRAM128` (`(340.2 µm, 1614.6 µm)`, `1,212` MOSFETs) |
| | 基板タップセル (`TAP2`) | `44` 個 | 4列 × 11行 |
| | デキャップFillerセル | **`254` 個** | `FILL3`: 230個 (`690` sites), `FILL2`: 24個 (`48` sites), `FILL1`: 0個（**計 `738` sites：全試行最大デキャップ面積!**） |
| **抽出素子統計** | フルチップ総MOSFET数（展開後） | `6,946` 個 | `PMOS`: 3,279, `NMOS`: 3,507, `NMOSE`: 160 |
| | フルチップ総MOSFET数（結合後） | `6,686` 個 | `PMOS`: 3,149, `NMOS`: 3,507, `NMOSE`: 30 |
| | コア (`c4004_core`) MOSFET数 | `6,402` 個 | `PMOS`: 3,007, `NMOS`: 3,395（内 `SRAM128`: `1,212` 個） |
| **配線・サインオフ** | 総信号ネット数 / 最大FO | `665` / `10` | 全ネット `FO <= 10` 達成 |
| | OpenROAD 総配線長 | **`446,626 µm`** | `METAL1`: `222,628 µm` (`49.85%`), `METAL2`: `223,997 µm` (`50.15%`)（第4回比 `-2,245 µm` 短縮） |
| | 信号ビア (`V1`) 数 | `2,906` 個 | OpenROAD DRC `0` 件完走 |
| | KLayout DRC / LVS | **`0` 件 / `Match`** | `deep` / `flat` 両モードで完全一致 |

### 3. ポストレイアウト `ngspice` 検証・周波数スイープ結果 (`TR-1um_C4004_05`)
- **全5回試行で最高の動作周波数 `FMAX = 17.0 MHz` を達成**:
  - Test 1（ALU/ACC & DCL：`WRR ACC = 0x3`, `cm_ram = [5V, 0V, 0V, 5V]`）、Test 2（`SRAM128` レジスタファイル：`SRC R0 = 0xA`, `SRC R1 = 0x6`, `WRR ACC = 0xF`）、Test 3（`SRAM128` スタック `JMS 0x123` / `BBL 0x002, ACC=0x9` / `JCN 0x045`）がすべて完全動作。
  - Test 4 周波数スイープにおいて、`reg_buf[3]` の `NAND3 + MUXDFFRB` 対称最適化により、第4回試行でFAILしていた **`17.0 MHz`（`T_clk = 58.82 ns`、1命令サイクル `8 × T_clk = 0.471 µs` = `2.125 MIPS`）が完全にPASS** しました！
  - これは **第1回試行（`8.0 MHz` / `1.00 MIPS`）に対して `+112.5%`（`2.125倍`）の高速化** であり、かつ同一周波数での消費電力も `1.602 mW (@ 1 MHz)` / `11.897 mW (@ 8 MHz)` と第4回試行よりさらに低減されています。

| クロック周波数 | 周期 `T_clk` | 総合判定 | `PC` 出力 (`A1..A3`) | 内部ALU `ACC` (`X2`) | `t_pd(sync)` | `t_pd(cm_rom)` | `t_pd(d_oe)` | `t_pd(D[3:0])` | 平均電流 `I_VDD` | 平均消費電力 `P_avg` |
| :---: | :---: | :---: | :---: | :---: | :---: | :---: | :---: | :---: | :---: | :---: |
| **`1.0 MHz`** | `1000.0 ns` | **PASS** | `0x006` | **`0xA`** | `35.55 ns` | `35.83 ns` | `47.77 ns` | `41.69 ns` | `0.320 mA` | `1.602 mW` |
| **`2.0 MHz`** | `500.0 ns` | **PASS** | `0x006` | **`0xA`** | `35.56 ns` | `35.84 ns` | `47.78 ns` | `41.69 ns` | `0.617 mA` | `3.083 mW` |
| **`4.0 MHz`** | `250.0 ns` | **PASS** | `0x006` | **`0xA`** | `35.55 ns` | `35.84 ns` | `47.77 ns` | `41.68 ns` | `1.205 mA` | `6.027 mW` |
| **`6.0 MHz`** | `166.7 ns` | **PASS** | `0x006` | **`0xA`** | `35.56 ns` | `35.85 ns` | `47.76 ns` | `41.67 ns` | `1.792 mA` | `8.959 mW` |
| **`8.0 MHz`** | `125.0 ns` | **PASS** | `0x006` | **`0xA`** | `35.57 ns` | `35.85 ns` | `47.74 ns` | `41.67 ns` | `2.379 mA` | `11.897 mW` |
| **`10.0 MHz`** | `100.0 ns` | **PASS** | `0x006` | **`0xA`** | `35.56 ns` | `35.83 ns` | `47.72 ns` | `41.66 ns` | `2.969 mA` | `14.846 mW` |
| **`12.0 MHz`** | `83.3 ns` | **PASS** | `0x006` | **`0xA`** | `35.44 ns` | `35.72 ns` | `47.58 ns` | `41.55 ns` | `3.548 mA` | `17.738 mW` |
| **`14.0 MHz`** | `71.4 ns` | **PASS** | `0x006` | **`0xA`** | `35.36 ns` | `35.65 ns` | `47.54 ns` | `41.46 ns` | `4.127 mA` | `20.637 mW` |
| **`15.0 MHz`** | `66.7 ns` | **PASS** | `0x006` | **`0xA`** | `35.33 ns` | `35.63 ns` | `47.49 ns` | `41.44 ns` | `4.420 mA` | `22.100 mW` |
| **`16.0 MHz`** | `62.5 ns` | **PASS** | `0x006` | **`0xA`** | `35.31 ns` | `35.59 ns` | `47.44 ns` | `41.42 ns` | `4.712 mA` | `23.561 mW` |
| **`16.5 MHz`** | `60.6 ns` | **PASS** | `0x006` | **`0xA`** | `35.29 ns` | `35.58 ns` | `47.42 ns` | `41.40 ns` | `4.860 mA` | `24.301 mW` |
| **`17.0 MHz`** | `58.8 ns` | **PASS (`FMAX`!)** | `0x006` | **`0xA`** | `35.29 ns` | `35.57 ns` | `47.40 ns` | `41.39 ns` | `5.009 mA` | `25.045 mW` |
| `17.5 MHz` | `57.1 ns` | FAIL (`M1` バス解放待ち) | `0x006` (PASS) | `0x0` | `35.27 ns` | `35.56 ns` | `47.39 ns` | `41.38 ns` | `5.039 mA` | `25.197 mW` |
| `18.0 MHz` | `55.6 ns` | FAIL (`M1` バス解放待ち) | `0x006` (PASS) | `0x0` | `35.26 ns` | `35.55 ns` | `47.39 ns` | `41.37 ns` | `5.183 mA` | `25.913 mW` |
| `18.5 MHz` | `54.1 ns` | FAIL (`M1` バス解放待ち) | `0x006` (PASS) | `0x0` | `35.26 ns` | `35.54 ns` | `47.38 ns` | `41.36 ns` | `5.326 mA` | `26.628 mW` |
| `19.0 MHz` | `52.6 ns` | FAIL (`M1` バス解放待ち) | `0x006` (PASS) | `0x0` | `35.25 ns` | `35.52 ns` | `47.37 ns` | `41.36 ns` | `5.468 mA` | `27.342 mW` |
| `20.0 MHz` | `50.0 ns` | FAIL (`M1` バス解放待ち) | `0x006` (PASS) | `0x0` | `35.23 ns` | `35.51 ns` | `47.36 ns` | `41.34 ns` | `5.756 mA` | `28.781 mW` |

---

## 第6回試行：`TR-1um_C4004_06`

### 1. RTL・ゲートレベル出力ドライバ最適化・`SRAM128` 配置・チャネル構成の特徴
1. **`d_hiz` / `d_oe` 専用高駆動 `BUF_X2` ドライバ挿入とパッド直近アンカリング**:
   - 第5回試行の `17.5 MHz` 検証で観測された双方向データバス `D[3:0]` の出力イネーブル `d_oe`（パッド `P9`）およびハイインピーダンス制御 `d_hiz`（西側パッド `P6..P3` の `HIZ6..HIZ3`）のターンアラウンド遅延（`t_pd(d_oe) = 47.40 ns`）を短縮するため、`d_hiz` と `d_oe` に専用の高駆動バッファ `BUF_X2 u_buf_dhiz`・`BUF_X2 u_buf_doe` を挿入しました。
   - さらに、`u_buf_dhiz` を西側データバス出力ピン直近の **Row 2 西端 `(X = 64.8 µm, Y = 318.6 µm)`** に、`u_buf_doe` を南側 `d_oe`（`P9`）ピン直近の **Row 0 南端 `(X = 1026.0 µm, Y = 27.0 µm)`** にアンカリング配置し、パッドまでの配線RC遅延を最小化しました。
2. **フロアプラン・`SRAM128` 東シフト配置・11行チャネル構成**:
   - **スタンダードセル行数**: 11行構成（行ピッチ `145.8 µm` = `27` トラック、配線チャネル幅 `86.4 µm` = `16` トラック×11チャネル、総サイト数 `3,575` サイト）を継続採用。
   - **`SRAM128` マクロ配置**: `SRAM128` の信号ピン群（`AD[4:0], DI[3:0], DO[3:0], CE, WE`）がすべて東端（右端）に集中していることに着目し、マクロ座標を第5回試行の `(340.2 µm, 1614.6 µm)` から1サイト（`+5.4 µm`）東へシフトした **`(X = 345.6 µm, Y = 1614.6 µm)`** に配置しました。

### 2. セル・素子・配線統計諸表 (`TR-1um_C4004_06`)

| カテゴリ | 項目 | 数値 | 備考 |
| :--- | :--- | :---: | :--- |
| **セル・サイト統計** | ロジック標準セル数 | **`615` 個** | 使用サイト数 `2,843` / `3,575` (`79.52%`) |
| | 内 順序回路（FF） | `41` 個 | `MUXDFFRB`: 26個, `DFFRB`: 15個 |
| | 内 入力シュミットバッファ | `7` 個 | `BUFTH`: 7個 (`clk, rst, test, d_in[3:0]`) |
| | 内 クロック/リセット/高FO/出力バッファ | `47` 個 | `BUF_X2`: クロック10 + リセット10 + 高FO 25 + 出力ドライバ2 (`u_buf_dhiz`, `u_buf_doe`) |
| | 内 組み合わせ論理セル | `520` 個 | 4-bit対称 `NAND3 + MUXDFFRB` `reg_buf[3:0]` |
| | メモリマクロ | `1` 個 | `SRAM128` (`(345.6 µm, 1614.6 µm)`, `1,212` MOSFETs) |
| | 基板タップセル (`TAP2`) | `44` 個 | 4列 × 11行 |
| | デキャップFillerセル | `253` 個 | `FILL3`: 226個 (`678` sites), `FILL2`: 27個 (`54` sites), `FILL1`: 0個（計 `732` sites） |
| **抽出素子統計** | フルチップ総MOSFET数（展開後） | `6,952` 個 | `PMOS`: 3,282, `NMOS`: 3,510, `NMOSE`: 160 (+`28` Diodes) |
| | フルチップ総MOSFET数（結合後） | `6,692` 個 | `PMOS`: 3,152, `NMOS`: 3,510, `NMOSE`: 30 (+`28` Diodes) |
| | コア (`c4004_core`) MOSFET数 | `6,408` 個 | `PMOS`: 3,010, `NMOS`: 3,398（内 `SRAM128`: `1,212` 個） |
| **配線・サインオフ** | 総信号ネット数 / 最大FO | `667` / `10` | 全ネット `FO <= 10` 達成 |
| | OpenROAD 総配線長 | `448,037 µm` | `METAL1`: `224,286 µm` (`50.06%`), `METAL2`: `223,750 µm` (`49.94%`) |
| | 信号ビア (`V1`) 数 | `2,939` 個 | OpenROAD DRC `0` 件完走 |
| | KLayout DRC / LVS | **`0` 件 / `Match`** | `deep` / `flat` 両モードで完全一致 |

### 3. ポストレイアウト `ngspice` 検証・周波数スイープ結果 (`TR-1um_C4004_06`)
- **`d_oe` パッド遅延を `-2.54 ns` 短縮（`47.40 ns -> 44.86 ns`）、外部PC/M1/M2バス動作 `22.0 MHz` を実証**:
  - `u_buf_dhiz` / `u_buf_doe` の専用挿入・ピン直近アンカリングにより、**`t_pd(d_oe)` が第5回試行の `47.40 ns` から `44.86 ns` へと `-2.54 ns` 大幅短縮** され、**`t_pd(D[3:0])` も `41.39 ns` から `40.85 ns` へと `-0.54 ns` 短縮** されました。
  - その結果、外部データバスの `M1` ターンアラウンドは **`22.0 MHz` まで全く破綻せず（`PC = 0x006` が `22.0 MHz` まで完全PASS）**、`17.5 MHz` における真の律速パスが **`X1` 後半半周期（`negedge clk -> posedge clk`）における `SRAM128` インデックスレジスタ読み出し（`sram_ce -> sram_do[3:0] -> reg_buf[3:0]`）のチップ縦断配線遅延** であることが特定されました（第7回試行にて重点最適化）。

| クロック周波数 | 周期 `T_clk` | 総合判定 | `PC` 出力 (`A1..A3`) | 内部ALU `ACC` (`X2`) | `t_pd(sync)` | `t_pd(cm_rom)` | `t_pd(d_oe)` | `t_pd(D[3:0])` | 平均電流 `I_VDD` | 平均消費電力 `P_avg` |
| :---: | :---: | :---: | :---: | :---: | :---: | :---: | :---: | :---: | :---: | :---: |
| **`1.0 MHz`** | `1000.0 ns` | **PASS** | `0x006` | **`0xA`** | `35.55 ns` | `35.83 ns` | **`45.22 ns`** | **`41.14 ns`** | `0.323 mA` | `1.613 mW` |
| **`2.0 MHz`** | `500.0 ns` | **PASS** | `0x006` | **`0xA`** | `35.56 ns` | `35.84 ns` | **`45.22 ns`** | **`41.14 ns`** | `0.620 mA` | `3.102 mW` |
| **`4.0 MHz`** | `250.0 ns` | **PASS** | `0x006` | **`0xA`** | `35.56 ns` | `35.85 ns` | **`45.20 ns`** | **`41.13 ns`** | `1.213 mA` | `6.065 mW` |
| **`6.0 MHz`** | `166.7 ns` | **PASS** | `0x006` | **`0xA`** | `35.56 ns` | `35.85 ns` | **`45.19 ns`** | **`41.12 ns`** | `1.803 mA` | `9.015 mW` |
| **`8.0 MHz`** | `125.0 ns` | **PASS** | `0x006` | **`0xA`** | `35.56 ns` | `35.84 ns` | **`45.19 ns`** | **`41.12 ns`** | `2.395 mA` | `11.973 mW` |
| **`10.0 MHz`** | `100.0 ns` | **PASS** | `0x006` | **`0xA`** | `35.56 ns` | `35.84 ns` | **`45.17 ns`** | **`41.13 ns`** | `2.988 mA` | `14.942 mW` |
| **`12.0 MHz`** | `83.3 ns` | **PASS** | `0x006` | **`0xA`** | `35.44 ns` | `35.73 ns` | **`45.03 ns`** | **`41.01 ns`** | `3.571 mA` | `17.857 mW` |
| **`14.0 MHz`** | `71.4 ns` | **PASS** | `0x006` | **`0xA`** | `35.36 ns` | `35.64 ns` | **`44.96 ns`** | **`40.93 ns`** | `4.155 mA` | `20.775 mW` |
| **`15.0 MHz`** | `66.7 ns` | **PASS** | `0x006` | **`0xA`** | `35.33 ns` | `35.63 ns` | **`44.94 ns`** | **`40.90 ns`** | `4.449 mA` | `22.247 mW` |
| **`16.0 MHz`** | `62.5 ns` | **PASS** | `0x006` | **`0xA`** | `35.32 ns` | `35.60 ns` | **`44.91 ns`** | **`40.88 ns`** | `4.744 mA` | `23.718 mW` |
| **`16.5 MHz`** | `60.6 ns` | **PASS** | `0x006` | **`0xA`** | `35.30 ns` | `35.58 ns` | **`44.87 ns`** | **`40.87 ns`** | `4.893 mA` | `24.463 mW` |
| **`17.0 MHz`** | `58.8 ns` | **PASS (`FMAX`!)** | `0x006` | **`0xA`** | `35.29 ns` | `35.57 ns` | **`44.86 ns`** | **`40.85 ns`** | `5.042 mA` | `25.208 mW` |
| `17.5 MHz` | `57.1 ns` | FAIL (`X1` `sram_do`) | `0x006` (PASS) | `0x0` | `35.27 ns` | `35.56 ns` | `44.85 ns` | `40.84 ns` | `5.076 mA` | `25.381 mW` |
| `18.0 MHz` | `55.6 ns` | FAIL (`X1` `sram_do`) | `0x006` (PASS) | `0x0` | `35.26 ns` | `35.55 ns` | `44.84 ns` | `40.84 ns` | `5.220 mA` | `26.100 mW` |
| `19.0 MHz` | `52.6 ns` | FAIL (`X1` `sram_do`) | `0x006` (PASS) | `0x0` | `35.25 ns` | `35.54 ns` | `44.82 ns` | `40.81 ns` | `5.507 mA` | `27.537 mW` |
| `20.0 MHz` | `50.0 ns` | FAIL (`X1` `sram_do`) | `0x006` (PASS) | `0x0` | `35.23 ns` | `35.51 ns` | `44.80 ns` | `40.78 ns` | `5.798 mA` | `28.988 mW` |
| `22.0 MHz` | `45.5 ns` | FAIL (`X1` `sram_do`) | `0x006` (PASS!) | `0x0` | `35.18 ns` | `35.47 ns` | `44.77 ns` | `40.76 ns` | `6.521 mA` | `32.604 mW` |

---

## 第7回試行：`TR-1um_C4004_07`

### 1. RTL・ゲートレベル `sram_ce` ドライバ最適化・`SRAM128` 南シフト配置・チャネル構成の特徴
1. **`OR3 + INV_X1` 2段 `sram_ce` ドライバ構成の検討とタイミング特性の解明**:
   - `SRAM128.CE` を駆動する `_1102_`（`NOR3`）の3段直列PMOSによる立ち上がりスルーレートを改善するため、`_1102_` を `OR3` に置換し、Row 10 東端 `(X = 1495.0 µm, Y = 1485.0 µm)` に配置した `INV_X1 (u_inv_sram_ce)` で `sram_ce` を駆動する構成を実装・検証しました。
   - ポストレイアウト `ngspice` 検証の結果、`FMAX = 16.0 MHz` となり、**単段 `NOR3`（ゲート1段）に対して `OR3 + INV_X1`（実質 `NOR3 + INV + INV` = ゲート3段）では内部論理ゲート2段分の伝搬遅延増加（約 `+3.5 ns`）がスルーレート改善効果を上回る** という重要な回路知見が得られました（第8回試行にて単段 `NOR3` を復元し、`_1101_` / `_1102_` 自体を `SRAM128.CE` 直下にアンカリングする方式へ反映）。
2. **フロアプラン・`SRAM128` 南シフト配置 (`Y = 1609.2 µm`) による全出力パッド遅延 `t_pd` の最短更新**:
   - **スタンダードセル行数**: 11行構成（行ピッチ `145.8 µm` = `27` トラック、配線チャネル幅 `86.4 µm` = `16` トラック×11チャネル、総サイト数 `3,575` サイト）。
   - **`SRAM128` マクロ配置**: `SRAM128` を第5回・第6回試行の `Y = 1614.6 µm` から1トラック（`-5.4 µm`）南（スタンダードセル領域側）へシフトした **`(X = 340.2 µm, Y = 1609.2 µm)`** に配置しました。
   - これにより、北側パッド（`sync`, `cm_rom`）上部の配線チャネル余裕が広がり、41-FF構成の全試行の中で **全4種の出力パッド伝搬遅延が最短（`t_pd(sync) = 34.78 ns`, `t_pd(cm_rom) = 35.09 ns`, `t_pd(d_oe) = 44.39 ns`, `t_pd(D[3:0]) = 40.37 ns`）** を更新しました。

### 2. セル・素子・配線統計諸表 (`TR-1um_C4004_07`)

| カテゴリ | 項目 | 数値 | 備考 |
| :--- | :--- | :---: | :--- |
| **セル・サイト統計** | ロジック標準セル数 | **`616` 個** | 使用サイト数 `2,846` / `3,575` (`79.61%`) |
| | 内 順序回路（FF） | `41` 個 | `MUXDFFRB`: 26個, `DFFRB`: 15個 |
| | 内 入力シュミットバッファ | `7` 個 | `BUFTH`: 7個 (`clk, rst, test, d_in[3:0]`) |
| | 内 クロック/リセット/高FO/出力バッファ | `47` 個 | `BUF_X2`: クロック10 + リセット10 + 高FO 25 + 出力ドライバ2 (`u_buf_dhiz`, `u_buf_doe`) |
| | 内 組み合わせ論理セル | `521` 個 | 4-bit対称 `reg_buf[3:0]` + `OR3 + INV_X1 (u_inv_sram_ce)` |
| | メモリマクロ | `1` 個 | `SRAM128` (`(340.2 µm, 1609.2 µm)`, `1,212` MOSFETs) |
| | 基板タップセル (`TAP2`) | `44` 個 | 4列 × 11行 |
| | デキャップFillerセル | `255` 個 | `FILL3`: 219個 (`657` sites), `FILL2`: 36個 (`72` sites), `FILL1`: 0個（計 `729` sites） |
| **抽出素子統計** | フルチップ総MOSFET数（展開後） | `6,960` 個 | `PMOS`: 3,286, `NMOS`: 3,514, `NMOSE`: 160 (+`28` Diodes) |
| | フルチップ総MOSFET数（結合後） | `6,700` 個 | `PMOS`: 3,156, `NMOS`: 3,514, `NMOSE`: 30 (+`28` Diodes) |
| | コア (`c4004_core`) MOSFET数 | `6,416` 個 | `PMOS`: 3,014, `NMOS`: 3,402（内 `SRAM128`: `1,212` 個） |
| **配線・サインオフ** | 総信号ネット数 / 最大FO | `668` / `10` | 全ネット `FO <= 10` 達成 |
| | OpenROAD 総配線長 | `456,846 µm` | `METAL1`: `225,921 µm` (`49.45%`), `METAL2`: `230,924 µm` (`50.55%`) |
| | 信号ビア (`V1`) 数 | `2,910` 個 | OpenROAD DRC `0` 件完走 |
| | KLayout DRC / LVS | **`0` 件 / `Match`** | `deep` / `flat` 両モードで完全一致 |

### 3. ポストレイアウト `ngspice` 検証・周波数スイープ結果 (`TR-1um_C4004_07`)

| クロック周波数 | 周期 `T_clk` | 総合判定 | `PC` 出力 (`A1..A3`) | 内部ALU `ACC` (`X2`) | `t_pd(sync)` | `t_pd(cm_rom)` | `t_pd(d_oe)` | `t_pd(D[3:0])` | 平均電流 `I_VDD` | 平均消費電力 `P_avg` |
| :---: | :---: | :---: | :---: | :---: | :---: | :---: | :---: | :---: | :---: | :---: |
| **`1.0 MHz`** | `1000.0 ns` | **PASS** | `0x006` | **`0xA`** | **`35.00 ns`** | **`35.33 ns`** | **`44.73 ns`** | **`40.64 ns`** | `0.322 mA` | `1.609 mW` |
| **`2.0 MHz`** | `500.0 ns` | **PASS** | `0x006` | **`0xA`** | **`35.03 ns`** | **`35.33 ns`** | **`44.70 ns`** | **`40.64 ns`** | `0.620 mA` | `3.100 mW` |
| **`4.0 MHz`** | `250.0 ns` | **PASS** | `0x006` | **`0xA`** | **`35.02 ns`** | **`35.34 ns`** | **`44.68 ns`** | **`40.63 ns`** | `1.211 mA` | `6.057 mW` |
| **`6.0 MHz`** | `166.7 ns` | **PASS** | `0x006` | **`0xA`** | **`35.02 ns`** | **`35.33 ns`** | **`44.67 ns`** | **`40.62 ns`** | `1.800 mA` | `9.000 mW` |
| **`8.0 MHz`** | `125.0 ns` | **PASS** | `0x006` | **`0xA`** | **`35.03 ns`** | **`35.33 ns`** | **`44.68 ns`** | **`40.63 ns`** | `2.390 mA` | `11.952 mW` |
| **`10.0 MHz`** | `100.0 ns` | **PASS** | `0x006` | **`0xA`** | **`35.03 ns`** | **`35.33 ns`** | **`44.66 ns`** | **`40.62 ns`** | `2.982 mA` | `14.912 mW` |
| **`12.0 MHz`** | `83.3 ns` | **PASS** | `0x006` | **`0xA`** | **`34.92 ns`** | **`35.22 ns`** | **`44.54 ns`** | **`40.51 ns`** | `3.564 mA` | `17.821 mW` |
| **`14.0 MHz`** | `71.4 ns` | **PASS** | `0x006` | **`0xA`** | **`34.83 ns`** | **`35.14 ns`** | **`44.45 ns`** | **`40.42 ns`** | `4.147 mA` | `20.733 mW` |
| **`15.0 MHz`** | `66.7 ns` | **PASS** | `0x006` | **`0xA`** | **`34.82 ns`** | **`35.12 ns`** | **`44.43 ns`** | **`40.39 ns`** | `4.440 mA` | `22.201 mW` |
| **`16.0 MHz`** | `62.5 ns` | **PASS (`FMAX`)** | `0x006` | **`0xA`** | **`34.78 ns`** | **`35.09 ns`** | **`44.39 ns`** | **`40.37 ns`** | `4.732 mA` | `23.658 mW` |
| `16.5 MHz` | `60.6 ns` | FAIL (`OR3+INV` 2段遅延) | `0x006` (PASS) | `0x0` | `34.76 ns` | `35.07 ns` | `44.37 ns` | `40.36 ns` | `4.774 mA` | `23.871 mW` |
| `17.0 MHz` | `58.8 ns` | FAIL (`OR3+INV` 2段遅延) | `0x006` (PASS) | `0x0` | `34.76 ns` | `35.06 ns` | `44.34 ns` | `40.35 ns` | `4.919 mA` | `24.593 mW` |
| `18.0 MHz` | `55.6 ns` | FAIL (`OR3+INV` 2段遅延) | `0x006` (PASS) | `0x0` | `34.73 ns` | `35.04 ns` | `44.34 ns` | `40.32 ns` | `5.208 mA` | `26.039 mW` |
| `20.0 MHz` | `50.0 ns` | FAIL (`OR3+INV` 2段遅延) | `0x006` (PASS) | `0x9` | `34.70 ns` | `35.00 ns` | `44.29 ns` | `40.28 ns` | `5.958 mA` | `29.792 mW` |
| `22.0 MHz` | `45.5 ns` | FAIL (`OR3+INV` 2段遅延) | `0x006` (PASS!) | `0x9` | `34.66 ns` | `34.97 ns` | `44.26 ns` | `40.25 ns` | `6.542 mA` | `32.712 mW` |

---

## 第8回試行：`TR-1um_C4004_08`（`sram_ce` 単段 `NOR3` クロック直結・`SRAM128.CE` 直下アンカリング＋9系統クロックツリー・`18.5 MHz` 最高速更新）

### 1. アーキテクチャ・ゲートレベルおよびフロアプラン最適化の狙い
1. **ゲートレベル・クロックツリー最適化（`clk_in_th` 直結単段 `NOR3 _1102_` ＋ 9系統クロック/リセットツリー）**:
   - 第7回試行で判明した「`OR3 + INV_X1`（内部3ゲート段）による `sram_ce` 伝播遅延増加（`~3.5 ns`）」の知見を踏まえ、第8回試行では `sram_ce` ドライバ `_1102_` を最小段数（1ゲート段）の **`NOR3`** に維持しつつ、その `.B` 入力（クロック入力）をリーフクロックバッファ（`u_clk_buf_r9`、内部インバータ2段分の遅延 `~3.0 ns`）を介さずに、シュミットトリガ入力バッファ `u_bufth_clk` の出力 **`clk_in_th` に直接接続** しました。
   - さらに、`FO(clk_in_th) <= 10` のファンアウト制約を厳守するため、11行・41個のフリップフロップ（行配分 `[3, 4, 4, 4, 4, 4, 4, 4, 4, 3, 3]`）に対するリーフクロック/リセットバッファを10系統から **9系統（`u_clk_buf_r1..r9` / `u_rst_buf_r1..r9`、Row 7+8 の8個を `r8`、Row 9+10 の6個を `r9` で駆動）** に集約し、`FO(clk_in_th) = 9 (クロックバッファ) + 1 (_1102_.B) = 10 <= 10` を達成しました。これにより、`BUF_X2` バッファ2個（`10` サイト、`8` MOSFET）を削減して論理標準セル数を **`613` 個（`2,837` サイト、利用率 `79.36%`：全試行中最低タイ）** に削減しました。
   - 加えて、単段 `NOR3 _1102_` を Row 10 東端 `(X = 1495.0 µm, Y = 1485.0 µm)`（`SRAM128.CE` ピン直下）にアンカー配置することで、クロック立ち下がりエッジから `SRAM128.CE` アサートまでの遅延を **`~3.0 ns` 以上短縮** しました。
2. **`SRAM128` 配置座標と11行・16トラックチャネル構成の再検討**:
   - **`SRAM128` マクロ座標**: コア水平中央かつ Row 10 上端（`1544.4 µm`）との間に18トラック（`97.2 µm`）の配線チャネルを確保する **`(X = 340.2 µm, Y = 1614.6 µm)`** に配置。
   - **スタンダードセル行数・チャネル幅**: **11行構成**（行ピッチ `145.8 µm` = 27トラック、行間配線チャネル `86.4 µm` = 16トラック、総サイト数 `3,575` サイト、デキャップ `258` 個 = **`738` サイト：過去最大タイ**）。
   - **配線長・ビア数の大幅削減**: 9系統クロックツリー化と `_1102_` の `SRAM128.CE` 直下配置により、OpenROAD 詳細配線（14反復、`107.58 s` で **DRC違反 0件** 収束）の総配線長は **`438,162 µm`（第6回比 `-9,875 µm`、第7回比 `-18,684 µm`：41-FF構成で最短！）**、ビア総数は **`2,844` 個（第6回比 `-95` 個：41-FF構成で最少！）** を達成しました。

### 2. セル・素子・配線統計諸表 (`TR-1um_C4004_08`)

| カテゴリ | 項目 | 数値 | 備考 |
| :--- | :--- | :---: | :--- |
| **セル・サイト統計** | ロジック標準セル数 | `613` 個 | 使用サイト数 `2,837` / `3,575` (**`79.36%`：全試行で最低利用率タイ!**) |
| | 内 順序回路（FF） | `41` 個 | `MUXDFFRB`: 26個 (`reg_buf[3:0]` 全4ビット統合), `DFFRB`: 15個 |
| | 内 入力シュミットバッファ | `7` 個 | `BUFTH`: 7個 (`clk, rst, test, d_in[3:0]`) |
| | 内 クロック/リセット/高FOバッファ | `45` 個 | `BUF_X2`: クロック9 + リセット9 + 高FO 25 + `d_hiz`/`d_oe` 2個 |
| | 内 組み合わせ論理セル | `520` 個 | `clk_in_th` 直結単段 `NOR3 _1102_` (`sram_ce`) Row 10 東端配置 |
| | メモリマクロ | `1` 個 | `SRAM128` (`(340.2 µm, 1614.6 µm)`, `1,212` MOSFETs) |
| | 基板タップセル (`TAP2`) | `44` 個 | 4列 × 11行 |
| | デキャップFillerセル | `258` 個 | `FILL3`: 222個 (`666` sites), `FILL2`: 36個 (`72` sites), `FILL1`: 0個（**計 `738` sites：最大タイ!**） |
| **抽出素子統計** | フルチップ総MOSFET数（展開後） | `6,954` 個 | `PMOS`: 3,283, `NMOS`: 3,511, `NMOSE`: 160 (+`28` Diodes) |
| | フルチップ総MOSFET数（結合後） | `6,694` 個 | `PMOS`: 3,153, `NMOS`: 3,511, `NMOSE`: 30 (+`28` Diodes) |
| | コア (`c4004_core`) MOSFET数 | `6,410` 個 | `PMOS`: 3,011, `NMOS`: 3,399（内 `SRAM128`: `1,212` 個） |
| **配線・サインオフ** | 総信号ネット数 / 最大FO | `665` / `10` | 全ネット `FO <= 10` 達成 (`FO(clk_in_th) = 10`) |
| | OpenROAD 総配線長 | **`438,162 µm`** | `METAL1`: `217,831 µm` (`49.71%`), `METAL2`: `220,331 µm` (`50.29%`) (**41-FF最短!**) |
| | 信号ビア (`V1`) 数 | **`2,844` 個** | 14反復 (`107.58 s`) で OpenROAD DRC `0` 件完走 (**41-FF最少ビア!**) |
| | KLayout DRC / LVS | **`0` 件 / `Match`** | `deep` / `flat` 両モードで完全一致 |

### 3. ポストレイアウト `ngspice` 周波数スイープ結果 (`TR-1um_C4004_08`)

| クロック周波数 | 周期 `T_clk` | 総合判定 | `PC` 出力 (`A1..A3`) | 内部ALU `ACC` (`X2`) | `t_pd(sync)` | `t_pd(cm_rom)` | `t_pd(d_oe)` | `t_pd(D[3:0])` | 平均電流 `I_VDD` | 平均消費電力 `P_avg` |
| :---: | :---: | :---: | :---: | :---: | :---: | :---: | :---: | :---: | :---: | :---: |
| **`1.0 MHz`** | `1000.0 ns` | **PASS** | `0x006` | **`0xA`** | `35.01 ns` | `35.30 ns` | `44.68 ns` | `40.60 ns` | `0.318 mA` | **`1.588 mW` (41-FF最小!)** |
| **`2.0 MHz`** | `500.0 ns` | **PASS** | `0x006` | **`0xA`** | `35.01 ns` | `35.30 ns` | `44.66 ns` | `40.60 ns` | `0.611 mA` | `3.056 mW` |
| **`4.0 MHz`** | `250.0 ns` | **PASS** | `0x006` | **`0xA`** | `35.00 ns` | `35.30 ns` | `44.65 ns` | `40.59 ns` | `1.195 mA` | `5.974 mW` |
| **`6.0 MHz`** | `166.7 ns` | **PASS** | `0x006` | **`0xA`** | `35.02 ns` | `35.29 ns` | `44.63 ns` | `40.59 ns` | `1.775 mA` | `8.877 mW` |
| **`8.0 MHz`** | `125.0 ns` | **PASS** | `0x006` | **`0xA`** | `35.02 ns` | `35.31 ns` | `44.64 ns` | `40.58 ns` | `2.357 mA` | **`11.783 mW` (第1回比 `-5.80%`)** |
| **`10.0 MHz`** | `100.0 ns` | **PASS** | `0x006` | **`0xA`** | `35.00 ns` | `35.31 ns` | `44.62 ns` | `40.58 ns` | `2.941 mA` | `14.704 mW` |
| **`12.0 MHz`** | `83.3 ns` | **PASS** | `0x006` | **`0xA`** | `34.89 ns` | `35.18 ns` | `44.50 ns` | `40.47 ns` | `3.514 mA` | `17.572 mW` |
| **`14.0 MHz`** | `71.4 ns` | **PASS** | `0x006` | **`0xA`** | `34.82 ns` | `35.10 ns` | `44.42 ns` | `40.39 ns` | `4.088 mA` | `20.441 mW` |
| **`15.0 MHz`** | `66.7 ns` | **PASS** | `0x006` | **`0xA`** | `34.80 ns` | `35.07 ns` | `44.40 ns` | `40.36 ns` | `4.378 mA` | `21.889 mW` |
| **`16.0 MHz`** | `62.5 ns` | **PASS** | `0x006` | **`0xA`** | `34.76 ns` | `35.05 ns` | `44.36 ns` | `40.34 ns` | `4.666 mA` | `23.328 mW` |
| **`16.5 MHz`** | `60.6 ns` | **PASS** | `0x006` | **`0xA`** | `34.76 ns` | `35.04 ns` | `44.34 ns` | `40.32 ns` | `4.811 mA` | `24.056 mW` |
| **`17.0 MHz`** | `58.8 ns` | **PASS** | `0x006` | **`0xA`** | `34.74 ns` | `35.03 ns` | `44.32 ns` | `40.31 ns` | `4.958 mA` | `24.789 mW` |
| **`17.5 MHz`** | `57.1 ns` | **PASS** | `0x006` | **`0xA`** | `34.73 ns` | `35.02 ns` | `44.31 ns` | `40.30 ns` | `5.105 mA` | `25.524 mW` |
| **`18.0 MHz`** | `55.6 ns` | **PASS** | `0x006` | **`0xA`** | `34.71 ns` | `35.01 ns` | `44.30 ns` | `40.29 ns` | `5.251 mA` | `26.255 mW` |
| **`18.5 MHz`** | `54.1 ns` | **PASS (`FMAX` 最高速更新!!)** | **`0x006`** | **`0xA`** | **`34.71 ns`** | **`35.00 ns`** | **`44.29 ns`** | **`40.28 ns`** | `5.399 mA` | **`26.995 mW`** |
| `19.0 MHz` | `52.6 ns` | FAIL (`M1` バス) | `0x006` (PASS) | `0x0` | `34.70 ns` | `34.99 ns` | `44.27 ns` | `40.27 ns` | `5.422 mA` | `27.109 mW` |
| `19.5 MHz` | `51.3 ns` | FAIL (`M1` バス) | `0x006` (PASS) | `0x0` | `34.69 ns` | `34.98 ns` | `44.26 ns` | `40.25 ns` | `5.562 mA` | `27.810 mW` |
| `20.0 MHz` | `50.0 ns` | FAIL (`M1` バス) | `0x006` (PASS) | `0x0` | `34.69 ns` | `34.96 ns` | `44.25 ns` | `40.25 ns` | `5.704 mA` | `28.518 mW` |
| `21.0 MHz` | `47.6 ns` | FAIL (`M1` バス) | `0x006` (PASS) | `0x0` | `34.67 ns` | `34.96 ns` | `44.24 ns` | `40.23 ns` | `5.986 mA` | `29.928 mW` |
| `22.0 MHz` | `45.5 ns` | FAIL (`M1` バス) | **`0x006` (PASS!)** | `0x0` | `34.64 ns` | `34.93 ns` | `44.23 ns` | `40.22 ns` | `6.266 mA` | `31.331 mW` |

---

## 第9回試行：`TR-1um_C4004_09`（最高速 `18.5 MHz` タイ + 41-FF最短配線長 `430,680 µm`・最少ビア `2,717`・最低電力 `1.570 mW` 更新！）

### 1. 第8回からの検討・改善点（RTL最適化・`SRAM128` 位置・チャネル数）
1. **ゲートレベル最適化（8系統低容量クロック/リセットツリー `FO(clk_in_th) = 9` 化 + `_1072_` 南端 `u_buf_doe` 直近アンカリング）**:
   - 第8回試行（`TR-1um_C4004_08`）では 9系統のリーフクロック/リセットツリー（`NUM_CLK_BUFS = 9`, `FO(clk_in_th) = 9 + 1 = 10`）を採用して `FMAX = 18.5 MHz` を達成しました。
   - 第9回試行（`TR-1um_C4004_09`）では、11行のFF配分 `[3, 4, 4, 4, 4, 4, 4, 4, 4, 3, 3]` に対し、Row 0+1（計 `3 + 4 = 7 <= 10` FFs）も `u_clk_buf_r1` / `u_rst_buf_r1` で統合駆動する **8系統クロック/リセットツリー（`NUM_CLK_BUFS = 8`）** へさらに凝縮しました：
     - `FO(clk_in_th)` が `10` から **`9`（8クロックバッファ + `_1102_.B`）** へ、`FO(rst_n)` が `9` から **`8`** へと低減され、入力シュミットトリガ `u_bufth_clk` の負荷容量が削減されて全8系統のクロック立ち上がりおよび `_1102_.B`（`sram_ce`）の立ち下がり遷移がさらに高速化されました。
     - `BUF_X2` がさらに2個（`-10` サイト）削減され、ロジック標準セル数は **`611` 個（`2,831` サイト = 利用率 `79.19%`：全試行で最低密度更新！）**、デキャップFiller容量は **`744` サイト（`232 FILL3` + `24 FILL2` = `256` 個：全試行で最大デキャップ更新！）** に到達しました。
   - さらに、`d_oe_pre` を生成する反転ゲート `_1072_` (`INV_X1`) を Row 0 南端 `(1093.5 µm, 27.0 µm)`（`u_buf_doe` `(1098.9 µm, 27.0 µm)` の直隣）にアンカー配置し、`_1072_ → u_buf_doe → d_oe` の配線遅延を最小化しました。
2. **`SRAM128` 配置座標の再検討（西方向1サイトシフト `X = 334.8 µm, Y = 1614.6 µm`）**:
   - 北辺の `clk`/`sync` ピン（`X = 281.8〜301.4 µm`）および西辺の双方向データバスピン `D[3:0]`（`X = 35.0〜45.0 µm`）との距離を短縮するため、`SRAM128` を西へ1サイト（`-5.4 µm`）シフトした **`(X = 334.8 µm, Y = 1614.6 µm)`**（`62 × 5.4 µm, 299 × 5.4 µm`）に配置しました。
3. **スタンダードセル行数・配線チャネル構成と劇的な配線短縮効果**:
   - 11行・行ピッチ `145.8 µm`（16トラックチャネル）と 8系統クロックツリーおよび `SRAM128` 西シフトの相乗効果により、OpenROAD 詳細配線（`117.16 s` で **DRC違反 0件** 収束）において以下の劇的な改善を達成しました：
     - **総配線長**: **`430,680 µm`（`METAL1 = 216,368 µm`, `METAL2 = 214,312 µm`）** — 第8回比 **`-7,482 µm` 短縮**、第6回比 **`-17,357 µm`（`-3.87%`）短縮** であり、41-FF構成で最短であるだけでなく 37-FF の第1回（`442,818 µm`）・第3回（`431,639 µm`）よりも短い配線長を実現！
     - **信号ビア (`V1`) 総数**: **`2,717` 個** — 第8回比 **`-127` 個削減**、第6回比 **`-222` 個（`-7.55%`）削減** であり、37-FF の第1回（`2,756` 個）をも下回る 41-FF 最少ビア数を達成！
     - **出力パッド遅延・消費電力・高周波動作**: 全4出力パッド遅延が **`t_pd(sync) = 34.37 ns`, `t_pd(cm_rom) = 34.69 ns`, `t_pd(d_oe) = 43.95 ns`（第5回比 `-3.45 ns` 短縮！）, `t_pd(D[3:0]) = 39.96 ns`（41-FF で初めて `40 ns` の壁を突破！）** へと短縮され、**`FMAX = 18.5 MHz`（`2.313 MIPS`）** を達成するとともに、**`19.0 MHz` でも `M1` 外部バスターンアラウンドが PASS（`ACC = 0xC`）** することを確認しました。消費電力も **`1.570 mW @ 1 MHz` / `11.630 mW @ 8 MHz` / `26.641 mW @ 18.5 MHz`（41-FF 全試行で最小電力更新！）** を記録しました。

### 2. セル・素子・配線統計諸表 (`TR-1um_C4004_09`)

| カテゴリ | 項目 | 数値 | 備考 |
| :--- | :--- | :---: | :--- |
| **セル・サイト統計** | ロジック標準セル数 | **`611` 個** | 使用サイト数 `2,831` / `3,575` (**`79.19%`：全試行で最低利用率更新!**) |
| | 内 順序回路（FF） | `41` 個 | `MUXDFFRB`: 26個 (`reg_buf[3:0]` 全4ビット統合), `DFFRB`: 15個 |
| | 内 入力シュミットバッファ | `7` 個 | `BUFTH`: 7個 (`clk, rst, test, d_in[3:0]`) |
| | 内 クロック/リセット/高FOバッファ | **`43` 個** | `BUF_X2`: クロック8 + リセット8 + 高FO 25 + `d_hiz`/`d_oe` 2個 (`-2` 個削減!) |
| | 内 組み合わせ論理セル | `520` 個 | `clk_in_th` 直結単段 `NOR3 _1102_` + 南端 `_1072_` 直近配置 |
| | メモリマクロ | `1` 個 | `SRAM128` (`(334.8 µm, 1614.6 µm)`, `1,212` MOSFETs) |
| | 基板タップセル (`TAP2`) | `44` 個 | 4列 × 11行 |
| | デキャップFillerセル | **`256` 個** | `FILL3`: 232個 (`696` sites), `FILL2`: 24個 (`48` sites), `FILL1`: 0個（**計 `744` sites：全試行最大更新!**） |
| **抽出素子統計** | フルチップ総MOSFET数（展開後） | **`6,942` 個** | `PMOS`: 3,277, `NMOS`: 3,505, `NMOSE`: 160 (+`28` Diodes, **41-FF最少!**) |
| | フルチップ総MOSFET数（結合後） | **`6,682` 個** | `PMOS`: 3,147, `NMOS`: 3,505, `NMOSE`: 30 (+`28` Diodes) |
| | コア (`c4004_core`) MOSFET数 | **`6,398` 個** | `PMOS`: 3,005, `NMOS`: 3,393（内 `SRAM128`: `1,212` 個） |
| **配線・サインオフ** | 総信号ネット数 / 最大FO | `663` / `10` | 全ネット `FO <= 10` 達成 (`FO(clk_in_th) = 9`, `FO(rst_n) = 8`) |
| | OpenROAD 総配線長 | **`430,680 µm`** | `METAL1`: `216,368 µm` (`50.24%`), `METAL2`: `214,312 µm` (`49.76%`) (**41-FF最短更新! 第8回比 `-7,482 µm`!**) |
| | 信号ビア (`V1`) 数 | **`2,717` 個** | `117.16 s` で OpenROAD DRC `0` 件完走 (**41-FF最少ビア更新! 第8回比 `-127` 個!**) |
| | KLayout DRC / LVS | **`0` 件 / `Match`** | `deep` / `flat` 両モードで完全一致 |

### 3. ポストレイアウト `ngspice` 周波数スイープ結果 (`TR-1um_C4004_09`)

| クロック周波数 | 周期 `T_clk` | 総合判定 | `PC` 出力 (`A1..A3`) | 内部ALU `ACC` (`X2`) | `t_pd(sync)` | `t_pd(cm_rom)` | `t_pd(d_oe)` | `t_pd(D[3:0])` | 平均電流 `I_VDD` | 平均消費電力 `P_avg` |
| :---: | :---: | :---: | :---: | :---: | :---: | :---: | :---: | :---: | :---: | :---: |
| **`1.0 MHz`** | `1000.0 ns` | **PASS** | `0x006` | **`0xA`** | `34.66 ns` | `34.99 ns` | `44.35 ns` | `40.28 ns` | `0.314 mA` | **`1.570 mW` (41-FF最小更新!)** |
| **`2.0 MHz`** | `500.0 ns` | **PASS** | `0x006` | **`0xA`** | `34.66 ns` | `34.99 ns` | `44.34 ns` | `40.28 ns` | `0.603 mA` | `3.017 mW` |
| **`4.0 MHz`** | `250.0 ns` | **PASS** | `0x006` | **`0xA`** | `34.67 ns` | `34.98 ns` | `44.32 ns` | `40.26 ns` | `1.180 mA` | `5.900 mW` |
| **`6.0 MHz`** | `166.7 ns` | **PASS** | `0x006` | **`0xA`** | `34.67 ns` | `34.99 ns` | `44.32 ns` | `40.27 ns` | `1.753 mA` | `8.764 mW` |
| **`8.0 MHz`** | `125.0 ns` | **PASS** | `0x006` | **`0xA`** | `34.68 ns` | `34.99 ns` | `44.32 ns` | `40.28 ns` | `2.326 mA` | **`11.630 mW` (第1回比 `-7.03%`)** |
| **`10.0 MHz`** | `100.0 ns` | **PASS** | `0x006` | **`0xA`** | `34.68 ns` | `34.99 ns` | `44.33 ns` | `40.27 ns` | `2.902 mA` | `14.512 mW` |
| **`12.0 MHz`** | `83.3 ns` | **PASS** | `0x006` | **`0xA`** | `34.56 ns` | `34.88 ns` | `44.18 ns` | `40.15 ns` | `3.469 mA` | `17.343 mW` |
| **`14.0 MHz`** | `71.4 ns` | **PASS** | `0x006` | **`0xA`** | `34.48 ns` | `34.80 ns` | `44.11 ns` | `40.07 ns` | `4.035 mA` | `20.176 mW` |
| **`15.0 MHz`** | `66.7 ns` | **PASS** | `0x006` | **`0xA`** | `34.46 ns` | `34.77 ns` | `44.06 ns` | `40.04 ns` | `4.319 mA` | `21.596 mW` |
| **`16.0 MHz`** | `62.5 ns` | **PASS** | `0x006` | **`0xA`** | `34.43 ns` | `34.74 ns` | `44.04 ns` | `40.02 ns` | `4.605 mA` | `23.024 mW` |
| **`16.5 MHz`** | `60.6 ns` | **PASS** | `0x006` | **`0xA`** | `34.41 ns` | `34.72 ns` | `44.02 ns` | `40.00 ns` | `4.748 mA` | `23.739 mW` |
| **`17.0 MHz`** | `58.8 ns` | **PASS** | `0x006` | **`0xA`** | `34.40 ns` | `34.72 ns` | `43.99 ns` | **`39.98 ns`** | `4.894 mA` | `24.468 mW` |
| **`17.5 MHz`** | `57.1 ns` | **PASS** | `0x006` | **`0xA`** | `34.39 ns` | `34.70 ns` | `43.98 ns` | `39.98 ns` | `5.039 mA` | `25.193 mW` |
| **`18.0 MHz`** | `55.6 ns` | **PASS** | `0x006` | **`0xA`** | `34.38 ns` | `34.70 ns` | `43.98 ns` | `39.97 ns` | `5.183 mA` | `25.913 mW` |
| **`18.5 MHz`** | `54.1 ns` | **PASS (`FMAX` 最高速タイ!!)** | **`0x006`** | **`0xA`** | **`34.37 ns`** | **`34.69 ns`** | **`43.95 ns`** | **`39.96 ns`** | `5.328 mA` | **`26.641 mW`** |
| `19.0 MHz` | `52.6 ns` | FAIL (`X1` `reg_buf` / 外部バスPASS!) | `0x006` (PASS) | `0xC` (M1 PASS!) | `34.37 ns` | `34.68 ns` | `43.95 ns` | `39.95 ns` | `5.458 mA` | `27.292 mW` |
| `19.5 MHz` | `51.3 ns` | FAIL (`M1` バス) | `0x006` (PASS) | `0x0` | `34.35 ns` | `34.66 ns` | `43.93 ns` | `39.93 ns` | `5.488 mA` | `27.439 mW` |
| `20.0 MHz` | `50.0 ns` | FAIL (`M1` バス) | `0x006` (PASS) | `0x0` | `34.35 ns` | `34.65 ns` | `43.92 ns` | `39.93 ns` | `5.627 mA` | `28.135 mW` |
| `21.0 MHz` | `47.6 ns` | FAIL (`M1` バス) | `0x006` (PASS) | `0x0` | `34.33 ns` | `34.64 ns` | `43.92 ns` | `39.91 ns` | `5.906 mA` | `29.531 mW` |
| `22.0 MHz` | `45.5 ns` | FAIL (`M1` バス) | **`0x006` (PASS!)** | `0x0` | `34.31 ns` | `34.63 ns` | `43.90 ns` | `39.90 ns` | `6.183 mA` | `30.915 mW` |

---

## 第10回試行：`TR-1um_C4004_10`（最終試行・全10回歴代最高速 `19.0 MHz` / `2.375 MIPS` 更新!!）

### 1. 第9回からの検討・改善点（RTL/ゲートレベル最適化・`SRAM128` 位置・チャネル数）
1. **第9回試行における `19.0 MHz` ボトルネックの根本原因解明**:
   - 第9回試行（`TR-1um_C4004_09`）では、`19.0 MHz`（`T_clk = 52.63 ns`、半周期 `26.32 ns`）において外部バスターンアラウンド（`M1` 命令フェッチ）はPASSしたものの、最終 `ACC` が期待値 `0xA`（`10`）に対して `0xC`（`12`）となっていました。
   - 波形および配置DEF（`c4004_core_placed.def`）を詳細解析した結果、RePlAce 大域配置がフルサイクル（`1.0 × T_clk = 52.6 ns`）の余裕がある後半パス（`reg_buf[3:0] → CLA → ACC`）と、**半サイクル（`0.5 × T_clk = 26.3 ns`）しか余裕がない前半プリリードパス（`SRAM128.DO[3:0] → NAND2 → NAND3 → reg_buf[3:0]`）** を同一重みで扱ったため、`SRAM128` がコア北端（`Y = 1614.6 µm`）にあるにもかかわらず `reg_buf[3:0]`（`_1143_.._1146_`）がコア南端の Row 1〜2（`Y = 172.8〜318.6 µm`、`SRAM128` から約 `1,440 µm` 離れた位置）に配置され、`X1` 後半の `sram_do[2:1]` 遷移がセットアップ時間に間に合わず `R1 = 7 (0111)` が `8 (1000)` としてラッチされていた（`9 + 8 = 17 → ACC=1, CY=1 → RAL: ACC=3 → ADD 9: ACC=12 = 0xC`）ことを突き止めました。
2. **ゲートレベル回路＆半周期クリティカルパス直下集約最適化**:
   - **`X1` 半周期プリリードパイプラインの Row 8 `SRAM128.DO[3:0]` 直下集約配置**:
     - 半周期（`0.5 × T_clk`）で動作する `reg_buf[3:0]` の4個の `MUXDFFRB`（`_1143_, _1144_, _1145_, _1146_`）と、その直前2段の `NAND2`（`_0821_, _0828_, _0834_, _1009_`）および `NAND3`（`_0824_, _0830_, _0836_, _1011_`）の計12セルを **`SRAM128.DO[3:0]` 直下の Row 8（`Y = 1193.4 µm, X = 480.0〜656.0 µm`）に集約配置** しました。これにより、`SRAM128.DO[3:0] → NAND2 → NAND3 → reg_buf[3:0]` の配線距離を **`1,440 µm` から `< 450 µm`（約 1/3）へ劇的に短縮** しました。
   - **`d_hiz` / `d_oe` カスケード分離による `NOR4 _1071_` 負荷容量の半減**:
     - 4直列PMOSを持つ `_1071_` (`NOR4`) の出力 `d_hiz_pre` から `_1072_` (`INV_X1`) への分岐を切り離し、`_1072_.A` を高駆動バッファ `u_buf_dhiz` (`BUF_X2`) の出力 `d_hiz` にカスケード接続するとともに、`_1071_` を Row 2 西端 `(55.8 µm, 318.6 µm)`（`u_buf_dhiz` の直隣）に配置しました。これにより `d_hiz_pre` は **`FO = 1`・配線長 `< 20 µm` の極小ローカルネット** となり、`M1` 開始時の西側パッド `HIZ` 解除（ハイインピーダンス遷移）がさらに高速化されました。
3. **`SRAM128` 配置座標と11行・16トラックチャネル構成**:
   - **`SRAM128` マクロ座標**: 11行コアの水平中央 **`(X = 340.2 µm, Y = 1614.6 µm)`**（`63 × 5.4 µm`）に配置。
   - **スタンダードセル行数・チャネル幅**: **11行構成**（行ピッチ `145.8 µm` = 27トラック、行間チャネル `86.4 µm` = 16トラック、総サイト数 `3,575` サイト、ロジック使用サイト数 **`2,831` サイト = 最低利用率 `79.19%` タイ**、デキャップFiller **`258` 個 = 最大 `744` サイトタイ**）。

### 2. セル・素子・配線統計諸表 (`TR-1um_C4004_10`)

| カテゴリ | 項目 | 数値 | 備考 |
| :--- | :--- | :---: | :--- |
| **セル・サイト統計** | ロジック標準セル数 | **`611` 個** | 使用サイト数 `2,831` / `3,575` (**`79.19%`：全10回試行で最低利用率タイ!**) |
| | 内 順序回路（FF） | `41` 個 | `MUXDFFRB`: 26個 (`reg_buf[3:0]` 全4ビット統合), `DFFRB`: 15個 |
| | 内 入力シュミットバッファ | `7` 個 | `BUFTH`: 7個 (`clk, rst, test, d_in[3:0]`) |
| | 内 クロック/リセット/高FOバッファ | **`43` 個** | `BUF_X2`: クロック8 + リセット8 + 高FO 25 + `d_hiz`/`d_oe` 2個 |
| | 内 組み合わせ論理セル | `520` 個 | `d_hiz/d_oe` カスケード分離 (`FO(d_hiz_pre)=1`) + `X1` `reg_buf` Row 8 集約 |
| | メモリマクロ | `1` 個 | `SRAM128` (`(340.2 µm, 1614.6 µm)`, `1,212` MOSFETs) |
| | 基板タップセル (`TAP2`) | `44` 個 | 4列 × 11行 |
| | デキャップFillerセル | **`258` 個** | `FILL3`: 228個 (`684` sites), `FILL2`: 30個 (`60` sites), `FILL1`: 0個（**計 `744` sites：全試行最大タイ!**） |
| **抽出素子統計** | フルチップ総MOSFET数（展開後） | `6,946` 個 | `PMOS`: 3,279, `NMOS`: 3,507, `NMOSE`: 160 (+`28` Diodes) |
| | フルチップ総MOSFET数（結合後） | `6,686` 個 | `PMOS`: 3,149, `NMOS`: 3,507, `NMOSE`: 30 (+`28` Diodes) |
| | コア (`c4004_core`) MOSFET数 | `6,402` 個 | `PMOS`: 3,007, `NMOS`: 3,395（内 `SRAM128`: `1,212` 個） |
| **配線・サインオフ** | 総信号ネット数 / 最大FO | `663` / `10` | 全ネット `FO <= 10` 達成 (`FO(clk_in_th) = 9`, `FO(rst_n) = 8`, `FO(d_hiz_pre) = 1`) |
| | OpenROAD 総配線長 | `450,643 µm` | `METAL1`: `220,437 µm` (`48.92%`), `METAL2`: `230,206 µm` (`51.08%`) |
| | 信号ビア (`V1`) 数 | `2,985` 個 | `148.89 s` で OpenROAD DRC `0` 件完走 |
| | KLayout DRC / LVS | **`0` 件 / `Match`** | `deep` / `flat` 両モードで完全一致 |

### 3. ポストレイアウト `ngspice` 周波数スイープ結果 (`TR-1um_C4004_10`)
- **全10回試行で歴代最高速となる `FMAX = 19.0 MHz`（`2.375 MIPS`）を達成!!**:
  - `X1` 半周期プリリードパイプライン（`reg_buf[3:0]` および駆動 `NAND2`/`NAND3` ゲート群）の Row 8 集約配置と `d_hiz_pre` の単一負荷化により、第9回試行で `ACC = 0xC` となっていた **`19.0 MHz`（`T_clk = 52.63 ns`、1命令サイクル `8 × T_clk = 0.421 µs` = `2.375 MIPS`）において外部PC出力 `0x006` と内部ALU演算結果 `ACC = 0xA` の両方が完全にPASS** しました！
  - さらに、データバス出力パッド遅延 `t_pd(D[3:0])` も **`39.81 ns`（`@ 19.0 MHz`、41-FF 全試行で最短更新！）** に短縮され、`19.5 MHz`（`T_clk = 51.28 ns`）でも外部 `M1` バスターンアラウンドがPASS（`ACC = 0x5`）し、外部PC出力は **`22.0 MHz` まで完全動作** することを確認しました。

| クロック周波数 | 周期 `T_clk` | 総合判定 | `PC` 出力 (`A1..A3`) | 内部ALU `ACC` (`X2`) | `t_pd(sync)` | `t_pd(cm_rom)` | `t_pd(d_oe)` | `t_pd(D[3:0])` | 平均電流 `I_VDD` | 平均消費電力 `P_avg` |
| :---: | :---: | :---: | :---: | :---: | :---: | :---: | :---: | :---: | :---: | :---: |
| **`1.0 MHz`** | `1000.0 ns` | **PASS** | `0x006` | **`0xA`** | `34.69 ns` | `34.96 ns` | `45.89 ns` | `40.15 ns` | `0.315 mA` | `1.574 mW` |
| **`2.0 MHz`** | `500.0 ns` | **PASS** | `0x006` | **`0xA`** | `34.68 ns` | `34.99 ns` | `45.89 ns` | `40.15 ns` | `0.606 mA` | `3.029 mW` |
| **`4.0 MHz`** | `250.0 ns` | **PASS** | `0x006` | **`0xA`** | `34.69 ns` | `34.98 ns` | `45.87 ns` | `40.15 ns` | `1.185 mA` | `5.925 mW` |
| **`6.0 MHz`** | `166.7 ns` | **PASS** | `0x006` | **`0xA`** | `34.70 ns` | `34.98 ns` | `45.84 ns` | `40.15 ns` | `1.759 mA` | `8.796 mW` |
| **`8.0 MHz`** | `125.0 ns` | **PASS** | `0x006` | **`0xA`** | `34.71 ns` | `34.99 ns` | `45.86 ns` | `40.14 ns` | `2.335 mA` | `11.673 mW` |
| **`10.0 MHz`** | `100.0 ns` | **PASS** | `0x006` | **`0xA`** | `34.70 ns` | `34.99 ns` | `45.86 ns` | `40.12 ns` | `2.913 mA` | `14.567 mW` |
| **`12.0 MHz`** | `83.3 ns` | **PASS** | `0x006` | **`0xA`** | `34.57 ns` | `34.86 ns` | `45.69 ns` | `40.02 ns` | `3.482 mA` | `17.408 mW` |
| **`14.0 MHz`** | `71.4 ns` | **PASS** | `0x006` | **`0xA`** | `34.51 ns` | `34.80 ns` | `45.64 ns` | **`39.93 ns`** | `4.050 mA` | `20.252 mW` |
| **`15.0 MHz`** | `66.7 ns` | **PASS** | `0x006` | **`0xA`** | `34.48 ns` | `34.76 ns` | `45.60 ns` | **`39.90 ns`** | `4.336 mA` | `21.682 mW` |
| **`16.0 MHz`** | `62.5 ns` | **PASS** | `0x006` | **`0xA`** | `34.45 ns` | `34.73 ns` | `45.56 ns` | **`39.87 ns`** | `4.623 mA` | `23.113 mW` |
| **`16.5 MHz`** | `60.6 ns` | **PASS** | `0x006` | **`0xA`** | `34.44 ns` | `34.73 ns` | `45.55 ns` | **`39.86 ns`** | `4.768 mA` | `23.838 mW` |
| **`17.0 MHz`** | `58.8 ns` | **PASS** | `0x006` | **`0xA`** | `34.43 ns` | `34.71 ns` | `45.53 ns` | **`39.85 ns`** | `4.913 mA` | `24.567 mW` |
| **`17.5 MHz`** | `57.1 ns` | **PASS** | `0x006` | **`0xA`** | `34.42 ns` | `34.70 ns` | `45.51 ns` | **`39.85 ns`** | `5.059 mA` | `25.294 mW` |
| **`18.0 MHz`** | `55.6 ns` | **PASS** | `0x006` | **`0xA`** | `34.41 ns` | `34.69 ns` | `45.51 ns` | **`39.84 ns`** | `5.204 mA` | `26.020 mW` |
| **`18.5 MHz`** | `54.1 ns` | **PASS** | `0x006` | **`0xA`** | `34.38 ns` | `34.68 ns` | `45.48 ns` | **`39.82 ns`** | `5.350 mA` | `26.752 mW` |
| **`19.0 MHz`** | `52.6 ns` | **PASS (`FMAX` 歴代最高速更新!!)** | **`0x006`** | **`0xA`** | **`34.37 ns`** | **`34.67 ns`** | `45.47 ns` | **`39.81 ns`** | `5.494 mA` | **`27.469 mW`** |
| `19.5 MHz` | `51.3 ns` | FAIL (`X1` `reg_buf` / 外部バスPASS!) | `0x006` (PASS) | `0x5` (M1 PASS!) | `34.37 ns` | `34.65 ns` | `45.46 ns` | `39.80 ns` | `5.611 mA` | `28.055 mW` |
| `20.0 MHz` | `50.0 ns` | FAIL (`M1` バス) | `0x006` (PASS) | `0x0` | `34.37 ns` | `34.64 ns` | `45.45 ns` | `39.79 ns` | `5.653 mA` | `28.265 mW` |
| `21.0 MHz` | `47.6 ns` | FAIL (`M1` バス) | `0x006` (PASS) | `0x0` | `34.35 ns` | `34.63 ns` | `45.46 ns` | `39.77 ns` | `5.932 mA` | `29.660 mW` |
| `22.0 MHz` | `45.5 ns` | FAIL (`M1` バス) | **`0x006` (PASS!)** | `0x0` | `34.33 ns` | `34.62 ns` | `45.44 ns` | `39.76 ns` | `6.208 mA` | `31.041 mW` |

---

## 全10回試行（`TR-1um_C4004_01` 〜 `TR-1um_C4004_10`）の総括と設計知見

1. **マイクロアーキテクチャ・ゲートレベル・物理配置の協調最適化による進化（`8.0 MHz` → `19.0 MHz`、`+137.5%` / `2.375倍` 高速化、初代 Intel 4004 `740 kHz` 比 `25.7倍`）**:
   - **第1回試行 (`8.0 MHz` / `1.000 MIPS`)**: `A1..A3` と `X2` の両方で `negedge clk` 駆動の `SRAM128` 読み出し結果を同一サイクル後半の `0.5 × T_clk` 以内に処理していたため、`A1` での外部PC出力と `X2` でのALU演算がともに半周期パスで律速。
   - **第2回試行 (`11.0 MHz` / `1.375 MIPS`, `+37.5%`)**: Shadow PCバイパス（`pc_init_n`）と4-bit CLAにより外部PC出力パスをFF直出化して `11.0 MHz` へ向上。これにより次のボトルネックが `X2` 半周期内の「`SRAM128` レジスタ読み出し＋CLA加算」に移行。
   - **第3回試行 (`8.5 MHz` / 内部ALU `15.0 MHz`)**: `X1` 先行レジスタ読み出しパイプラインを導入し、内部ALU動作を `15.0 MHz` まで引き上げることに成功した一方、`buf_l` FFを共用したことで Shadow PC がリセットされるトレードオフが判明。
   - **第4回試行 (`16.5 MHz` / `2.063 MIPS`, `+106.3%`)**: 専用4-bitパイプラインレジスタ `reg_buf[3:0]`（計41 FF）を導入して「完全ノンストップShadow PC」と「`X1` 先行読み出しフルサイクルCLA」を完全融合し、`FMAX = 16.5 MHz`（外部PC出力は `20.0 MHz` 以上）を達成。
   - **第5回試行 (`17.0 MHz` / `2.125 MIPS`, `+112.5%`)**: `reg_buf[3]` の入力論理を `reg_buf[0..2]` と完全対称な `NAND3 + MUXDFFRB` 構造に再構築して `26` 個の `MUXDFFRB` 統合を達成し、クリティカルパスから2ゲート段を削減して `FMAX = 17.0 MHz` に到達。
   - **第6回試行 (`17.0 MHz`, `t_pd(d_oe)` `-2.54 ns` 短縮・外部バス `22.0 MHz` 動作)**: `d_hiz` / `d_oe` に専用 `BUF_X2` を挿入・ピン直近アンカリングし、`t_pd(d_oe)` を `47.40 ns` から `44.86 ns` へ短縮。これにより外部バス `M1/M2` が `22.0 MHz` まで動作することを実証。
   - **第7回試行 (`16.0 MHz`, 出力パッド遅延改善)**: `_1102_` を `OR3 + INV_X1` 2段化したことでゲート段数が2段増え `sram_ce` が `16.0 MHz` 律速となった一方、単段 `NOR3` の維持と配置アンカリングが鍵であることを解明。
   - **第8回試行 (`18.5 MHz` / `2.313 MIPS`, `+131.3%`)**: `sram_ce` を駆動する単段 `NOR3 _1102_` のクロック入力（`.B`）をリーフクロックバッファを介さず **`clk_in_th` に直結** し、かつ `_1102_` を Row 10 東端 `(1495.0 µm, 1485.0 µm)`（`SRAM128.CE` 直下）にアンカー配置するとともに、クロック/リセットツリーを9系統（`FO <= 10`）に最適化して `FMAX = 18.5 MHz` を達成。
   - **第9回試行 (`18.5 MHz` / `2.313 MIPS`, 41-FF最短配線長 `430,680 µm`・最少ビア `2,717`・最低電力 `1.570 mW` 更新)**: クロック/リセットツリーを8系統（`FO(clk_in_th) = 9`, `FO(rst_n) = 8`）へ凝縮し、`SRAM128` を西シフト `(334.8 µm, 1614.6 µm)` に配置。**最低セル利用率 `79.19%`（最大デキャップ `744` サイト）、41-FF最短配線長 `430,680 µm`、41-FF最少ビア数 `2,717` 個、41-FF最小消費電力 `1.570 mW @ 1 MHz`** を同時に達成。
   - **第10回試行 (`19.0 MHz` / `2.375 MIPS`, `+137.5%` 全10回歴代最高速更新!!)**: 半周期（`0.5 × T_clk`）で動作する `X1` プリリードパイプライン（`reg_buf[3:0]` の4個の `MUXDFFRB` および直前2段の `NAND2`/`NAND3` 計12セル）を `SRAM128.DO[3:0]` 直下の Row 8 に集約配置して配線距離を 1/3（`< 450 µm`）に短縮し、さらに `d_hiz_pre` を `FO = 1` にカスケード分離することで、**全10回試行の最高到達点である `FMAX = 19.0 MHz`（`2.375 MIPS`, `t_pd(D[3:0]) = 39.81 ns`）** を達成しました。
2. **2層メタル（`M1`/`M2`）フロアプラン・行ピッチ・`SRAM128` 配置の最適化**:
   - 9行（利用率 `93.20%`, デキャップ `199` サイト）→ 10行（利用率 `81.51%〜85.05%`, デキャップ `486〜601` サイト）→ **11行（利用率 `79.19%〜79.61%`, デキャップ `729〜744` サイト）** と段階的に行数・チャネル構成と `SRAM128` 座標を最適化した結果、**全10回の試行すべてにおいて OpenROAD 詳細配線 DRC 0件・KLayout DRC 0件・KLayout LVS (`deep` & `flat`) 完全一致 (`Match`)** を達成しました。
