jun1okamura/TR-1um_C4004_Clone2Build/TR-1um_C4004_01/apr/sim_test1_alu.sp

* Test 1: ALU/ACC & DCL
.param vthMP=0 vthMN=0 vthMPE=0 vthMNE=0 magRR=1 magRS=1 magCSIO=1
.include "../TR-1um/libs.tech/spice/models/models_IP62_cap_v5p1.lib"
.include "../TR-1um/libs.tech/spice/models/models_IP62_diode_v2.lib"
.include "../TR-1um/libs.tech/spice/models/models_IP62_mos_v2.lib"
.include "../TR-1um/libs.tech/spice/models/models_IP62_res_v5.lib"
.include "OSS_FRAME_sim.spice"

.options reltol=1e-3 abstol=1e-9 vntol=1e-3 method=gear

* Power supplies
VVDD VDD 0 5.0
VVSS VSS 0 0.0

* DUT: Full-chip extracted netlist OSS_FRAME
* Pin order: P1 P10 P11 P12 P13 P14 P15 P2 P3 P4 P5 P6 P7 P9 VDD VSS
Xchip P1 P10 P11 P12 P13 P14 P15 P2 P3 P4 P5 P6 P7 P9 VDD VSS OSS_FRAME

* 1.0 pF load capacitance on all 14 signal pads
CP1  P1  0 1.0p
CP2  P2  0 1.0p
CP3  P3  0 1.0p
CP4  P4  0 1.0p
CP5  P5  0 1.0p
CP6  P6  0 1.0p
CP7  P7  0 1.0p
CP9  P9  0 1.0p
CP10 P10 0 1.0p
CP11 P11 0 1.0p
CP12 P12 0 1.0p
CP13 P13 0 1.0p
CP14 P14 0 1.0p
CP15 P15 0 1.0p

* Input stimulus on P1 (clk), P7 (rst), P10 (test)
VP1  P1  0 PWL(0.000n 0.0 998.000n 0.0 1000.000n 5.0 1498.000n 5.0 1500.000n 0.0 1998.000n 0.0 2000.000n 5.0 2498.000n 5.0 2500.000n 0.0 2998.000n 0.0 3000.000n 5.0 3498.000n 5.0 3500.000n 0.0 3998.000n 0.0 4000.000n 5.0 4498.000n 5.0 4500.000n 0.0 4998.000n 0.0 5000.000n 5.0 5498.000n 5.0 5500.000n 0.0 5998.000n 0.0 6000.000n 5.0 6498.000n 5.0 6500.000n 0.0 6998.000n 0.0 7000.000n 5.0 7498.000n 5.0 7500.000n 0.0 7998.000n 0.0 8000.000n 5.0 8498.000n 5.0 8500.000n 0.0 8998.000n 0.0 9000.000n 5.0 9498.000n 5.0 9500.000n 0.0 9998.000n 0.0 10000.000n 5.0 10498.000n 5.0 10500.000n 0.0 10998.000n 0.0 11000.000n 5.0 11498.000n 5.0 11500.000n 0.0 11998.000n 0.0 12000.000n 5.0 12498.000n 5.0 12500.000n 0.0 12998.000n 0.0 13000.000n 5.0 13498.000n 5.0 13500.000n 0.0 13998.000n 0.0 14000.000n 5.0 14498.000n 5.0 14500.000n 0.0 14998.000n 0.0 15000.000n 5.0 15498.000n 5.0 15500.000n 0.0 15998.000n 0.0 16000.000n 5.0 16498.000n 5.0 16500.000n 0.0 16998.000n 0.0 17000.000n 5.0 17498.000n 5.0 17500.000n 0.0 17998.000n 0.0 18000.000n 5.0 18498.000n 5.0 18500.000n 0.0 18998.000n 0.0 19000.000n 5.0 19498.000n 5.0 19500.000n 0.0 19998.000n 0.0 20000.000n 5.0 20498.000n 5.0 20500.000n 0.0 20998.000n 0.0 21000.000n 5.0 21498.000n 5.0 21500.000n 0.0 21998.000n 0.0 22000.000n 5.0 22498.000n 5.0 22500.000n 0.0 22998.000n 0.0 23000.000n 5.0 23498.000n 5.0 23500.000n 0.0 23998.000n 0.0 24000.000n 5.0 24498.000n 5.0 24500.000n 0.0 24998.000n 0.0 25000.000n 5.0 25498.000n 5.0 25500.000n 0.0 25998.000n 0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
Vrom_d3 rom_d3 0 PWL(0.000n 0.0 3148.000n 0.0 3150.000n 5.0 4098.000n 5.0 4100.000n 0.0 5048.000n 0.0 5050.000n 0.0 11148.000n 0.0 11150.000n 5.0 12098.000n 5.0 12100.000n 0.0 13048.000n 0.0 13050.000n 0.0 19148.000n 0.0 19150.000n 5.0 20098.000n 5.0 20100.000n 0.0 21048.000n 0.0 21050.000n 0.0 27148.000n 0.0 27150.000n 5.0 28098.000n 5.0 28100.000n 0.0 29048.000n 0.0 29050.000n 0.0 35148.000n 0.0 35150.000n 5.0 36098.000n 5.0 36100.000n 0.0 37048.000n 0.0 37050.000n 0.0 43148.000n 0.0 43150.000n 5.0 44098.000n 5.0 44100.000n 5.0 45048.000n 5.0 45050.000n 0.0 51148.000n 0.0 51150.000n 0.0 52098.000n 0.0 52100.000n 0.0 53048.000n 0.0 53050.000n 0.0)
Bd0 P6 0 I = V(drv_en) * (V(P6) - V(rom_d0)) / 50.0
Bd1 P5 0 I = V(drv_en) * (V(P5) - V(rom_d1)) / 50.0
Bd2 P4 0 I = V(drv_en) * (V(P4) - V(rom_d2)) / 50.0
Bd3 P3 0 I = V(drv_en) * (V(P3) - V(rom_d3)) / 50.0

.tran 10.000n 56000.000n
.meas tran wrr_acc_d0 FIND v(P6) AT=38900.000n
.meas tran wrr_acc_d1 FIND v(P5) AT=38900.000n
.meas tran wrr_acc_d2 FIND v(P4) AT=38900.000n
.meas tran wrr_acc_d3 FIND v(P3) AT=38900.000n
.meas tran wrr_acc_doe FIND v(P9) AT=38900.000n
.meas tran cmram0 FIND v(P11) AT=50900.000n
.meas tran cmram1 FIND v(P12) AT=50900.000n
.meas tran cmram2 FIND v(P13) AT=50900.000n
.meas tran cmram3 FIND v(P14) AT=50900.000n
.meas tran cmrom_a3 FIND v(P15) AT=50900.000n
.meas tran sync_x3 FIND v(P2) AT=7900.000n
.control
run
quit
.endc
.end
