jun1okamura/TR-1um_C4004_Clone2Build/TR-1um_C4004_01/apr/sim_test4_10MHz.sp

* Test 4: FMAX Sweep @ 10.0 MHz
.param vthMP=0 vthMN=0 vthMPE=0 vthMNE=0 magRR=1 magRS=1 magCSIO=1
.include "../TR-1um/libs.tech/spice/models/models_IP62_cap_v5p1.lib"
.include "../TR-1um/libs.tech/spice/models/models_IP62_diode_v2.lib"
.include "../TR-1um/libs.tech/spice/models/models_IP62_mos_v2.lib"
.include "../TR-1um/libs.tech/spice/models/models_IP62_res_v5.lib"
.include "OSS_FRAME_sim.spice"

.options reltol=1e-3 abstol=1e-9 vntol=1e-3 method=gear

* Power supplies
VVDD VDD 0 5.0
VVSS VSS 0 0.0

* DUT: Full-chip extracted netlist OSS_FRAME
* Pin order: P1 P10 P11 P12 P13 P14 P15 P2 P3 P4 P5 P6 P7 P9 VDD VSS
Xchip P1 P10 P11 P12 P13 P14 P15 P2 P3 P4 P5 P6 P7 P9 VDD VSS OSS_FRAME

* 1.0 pF load capacitance on all 14 signal pads
CP1  P1  0 1.0p
CP2  P2  0 1.0p
CP3  P3  0 1.0p
CP4  P4  0 1.0p
CP5  P5  0 1.0p
CP6  P6  0 1.0p
CP7  P7  0 1.0p
CP9  P9  0 1.0p
CP10 P10 0 1.0p
CP11 P11 0 1.0p
CP12 P12 0 1.0p
CP13 P13 0 1.0p
CP14 P14 0 1.0p
CP15 P15 0 1.0p

* Input stimulus on P1 (clk), P7 (rst), P10 (test)
VP1  P1  0 PWL(0.000n 0.0 98.000n 0.0 100.000n 5.0 148.000n 5.0 150.000n 0.0 198.000n 0.0 200.000n 5.0 248.000n 5.0 250.000n 0.0 298.000n 0.0 300.000n 5.0 348.000n 5.0 350.000n 0.0 398.000n 0.0 400.000n 5.0 448.000n 5.0 450.000n 0.0 498.000n 0.0 500.000n 5.0 548.000n 5.0 550.000n 0.0 598.000n 0.0 600.000n 5.0 648.000n 5.0 650.000n 0.0 698.000n 0.0 700.000n 5.0 748.000n 5.0 750.000n 0.0 798.000n 0.0 800.000n 5.0 848.000n 5.0 850.000n 0.0 898.000n 0.0 900.000n 5.0 948.000n 5.0 950.000n 0.0 998.000n 0.0 1000.000n 5.0 1048.000n 5.0 1050.000n 0.0 1098.000n 0.0 1100.000n 5.0 1148.000n 5.0 1150.000n 0.0 1198.000n 0.0 1200.000n 5.0 1248.000n 5.0 1250.000n 0.0 1298.000n 0.0 1300.000n 5.0 1348.000n 5.0 1350.000n 0.0 1398.000n 0.0 1400.000n 5.0 1448.000n 5.0 1450.000n 0.0 1498.000n 0.0 1500.000n 5.0 1548.000n 5.0 1550.000n 0.0 1598.000n 0.0 1600.000n 5.0 1648.000n 5.0 1650.000n 0.0 1698.000n 0.0 1700.000n 5.0 1748.000n 5.0 1750.000n 0.0 1798.000n 0.0 1800.000n 5.0 1848.000n 5.0 1850.000n 0.0 1898.000n 0.0 1900.000n 5.0 1948.000n 5.0 1950.000n 0.0 1998.000n 0.0 2000.000n 5.0 2048.000n 5.0 2050.000n 0.0 2098.000n 0.0 2100.000n 5.0 2148.000n 5.0 2150.000n 0.0 2198.000n 0.0 2200.000n 5.0 2248.000n 5.0 2250.000n 0.0 2298.000n 0.0 2300.000n 5.0 2348.000n 5.0 2350.000n 0.0 2398.000n 0.0 2400.000n 5.0 2448.000n 5.0 2450.000n 0.0 2498.000n 0.0 2500.000n 5.0 2548.000n 5.0 2550.000n 0.0 2598.000n 0.0 2600.000n 5.0 2648.000n 5.0 2650.000n 0.0 2698.000n 0.0 2700.000n 5.0 2748.000n 5.0 2750.000n 0.0 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
Vrom_d3 rom_d3 0 PWL(0.000n 0.0 313.000n 0.0 315.000n 0.0 408.000n 0.0 410.000n 0.0 503.000n 0.0 505.000n 0.0 1113.000n 0.0 1115.000n 5.0 1208.000n 5.0 1210.000n 0.0 1303.000n 0.0 1305.000n 0.0 1913.000n 0.0 1915.000n 5.0 2008.000n 5.0 2010.000n 0.0 2103.000n 0.0 2105.000n 0.0 2713.000n 0.0 2715.000n 5.0 2808.000n 5.0 2810.000n 0.0 2903.000n 0.0 2905.000n 0.0 3513.000n 0.0 3515.000n 5.0 3608.000n 5.0 3610.000n 0.0 3703.000n 0.0 3705.000n 0.0 4313.000n 0.0 4315.000n 5.0 4408.000n 5.0 4410.000n 0.0 4503.000n 0.0 4505.000n 0.0 5113.000n 0.0 5115.000n 5.0 5208.000n 5.0 5210.000n 0.0 5303.000n 0.0 5305.000n 0.0)
Bd0 P6 0 I = V(drv_en) * (V(P6) - V(rom_d0)) / 50.0
Bd1 P5 0 I = V(drv_en) * (V(P5) - V(rom_d1)) / 50.0
Bd2 P4 0 I = V(drv_en) * (V(P4) - V(rom_d2)) / 50.0
Bd3 P3 0 I = V(drv_en) * (V(P3) - V(rom_d3)) / 50.0

.tran 1.000n 5600.000n
.meas tran pc6_l_d0 FIND v(P6) AT=4890.000n
.meas tran pc6_l_d1 FIND v(P5) AT=4890.000n
.meas tran pc6_l_d2 FIND v(P4) AT=4890.000n
.meas tran pc6_l_d3 FIND v(P3) AT=4890.000n
.meas tran pc6_l_doe FIND v(P9) AT=4890.000n
.meas tran pc6_m_d0 FIND v(P6) AT=4990.000n
.meas tran pc6_m_d1 FIND v(P5) AT=4990.000n
.meas tran pc6_m_d2 FIND v(P4) AT=4990.000n
.meas tran pc6_m_d3 FIND v(P3) AT=4990.000n
.meas tran pc6_m_doe FIND v(P9) AT=4990.000n
.meas tran pc6_h_d0 FIND v(P6) AT=5090.000n
.meas tran pc6_h_d1 FIND v(P5) AT=5090.000n
.meas tran pc6_h_d2 FIND v(P4) AT=5090.000n
.meas tran pc6_h_d3 FIND v(P3) AT=5090.000n
.meas tran pc6_h_doe FIND v(P9) AT=5090.000n
.meas tran final_acc_d0 FIND v(P6) AT=5490.000n
.meas tran final_acc_d1 FIND v(P5) AT=5490.000n
.meas tran final_acc_d2 FIND v(P4) AT=5490.000n
.meas tran final_acc_d3 FIND v(P3) AT=5490.000n
.meas tran final_acc_doe FIND v(P9) AT=5490.000n
.meas tran tpd_sync TRIG v(P1) VAL=2.5 RISE=1 TD=680.000n TARG v(P2) VAL=2.5 RISE=1 TD=680.000n
.meas tran tpd_cmrom TRIG v(P1) VAL=2.5 RISE=1 TD=180.000n TARG v(P15) VAL=2.5 FALL=1 TD=180.000n
.meas tran tpd_cmram0 TRIG v(P1) VAL=2.5 RISE=1 TD=180.000n TARG v(P11) VAL=2.5 FALL=1 TD=180.000n
.meas tran tpd_doe TRIG v(P1) VAL=2.5 RISE=1 TD=280.000n TARG v(P9) VAL=2.5 FALL=1 TD=280.000n
.meas tran tpd_dout0 TRIG v(P1) VAL=2.5 RISE=1 TD=780.000n TARG v(P6) VAL=2.5 RISE=1 TD=780.000n
.meas tran i_vdd_avg AVG i(VVDD) FROM=100.000n TO=5600.000n
.control
run
quit
.endc
.end
