jun1okamura/TR-1um_C4004_Clone2Build/TR-1um_C4004_01/apr/sim_test4_12MHz.sp

* Test 4: FMAX Sweep @ 12.0 MHz
.param vthMP=0 vthMN=0 vthMPE=0 vthMNE=0 magRR=1 magRS=1 magCSIO=1
.include "../TR-1um/libs.tech/spice/models/models_IP62_cap_v5p1.lib"
.include "../TR-1um/libs.tech/spice/models/models_IP62_diode_v2.lib"
.include "../TR-1um/libs.tech/spice/models/models_IP62_mos_v2.lib"
.include "../TR-1um/libs.tech/spice/models/models_IP62_res_v5.lib"
.include "OSS_FRAME_sim.spice"

.options reltol=1e-3 abstol=1e-9 vntol=1e-3 method=gear

* Power supplies
VVDD VDD 0 5.0
VVSS VSS 0 0.0

* DUT: Full-chip extracted netlist OSS_FRAME
* Pin order: P1 P10 P11 P12 P13 P14 P15 P2 P3 P4 P5 P6 P7 P9 VDD VSS
Xchip P1 P10 P11 P12 P13 P14 P15 P2 P3 P4 P5 P6 P7 P9 VDD VSS OSS_FRAME

* 1.0 pF load capacitance on all 14 signal pads
CP1  P1  0 1.0p
CP2  P2  0 1.0p
CP3  P3  0 1.0p
CP4  P4  0 1.0p
CP5  P5  0 1.0p
CP6  P6  0 1.0p
CP7  P7  0 1.0p
CP9  P9  0 1.0p
CP10 P10 0 1.0p
CP11 P11 0 1.0p
CP12 P12 0 1.0p
CP13 P13 0 1.0p
CP14 P14 0 1.0p
CP15 P15 0 1.0p

* Input stimulus on P1 (clk), P7 (rst), P10 (test)
VP1  P1  0 PWL(0.000n 0.0 81.667n 0.0 83.333n 5.0 123.333n 5.0 125.000n 0.0 165.000n 0.0 166.667n 5.0 206.667n 5.0 208.333n 0.0 248.333n 0.0 250.000n 5.0 290.000n 5.0 291.667n 0.0 331.667n 0.0 333.333n 5.0 373.333n 5.0 375.000n 0.0 415.000n 0.0 416.667n 5.0 456.667n 5.0 458.333n 0.0 498.333n 0.0 500.000n 5.0 540.000n 5.0 541.667n 0.0 581.667n 0.0 583.333n 5.0 623.333n 5.0 625.000n 0.0 665.000n 0.0 666.667n 5.0 706.667n 5.0 708.333n 0.0 748.333n 0.0 750.000n 5.0 790.000n 5.0 791.667n 0.0 831.667n 0.0 833.333n 5.0 873.333n 5.0 875.000n 0.0 915.000n 0.0 916.667n 5.0 956.667n 5.0 958.333n 0.0 998.333n 0.0 1000.000n 5.0 1040.000n 5.0 1041.667n 0.0 1081.667n 0.0 1083.333n 5.0 1123.333n 5.0 1125.000n 0.0 1165.000n 0.0 1166.667n 5.0 1206.667n 5.0 1208.333n 0.0 1248.333n 0.0 1250.000n 5.0 1290.000n 5.0 1291.667n 0.0 1331.667n 0.0 1333.333n 5.0 1373.333n 5.0 1375.000n 0.0 1415.000n 0.0 1416.667n 5.0 1456.667n 5.0 1458.333n 0.0 1498.333n 0.0 1500.000n 5.0 1540.000n 5.0 1541.667n 0.0 1581.667n 0.0 1583.333n 5.0 1623.333n 5.0 1625.000n 0.0 1665.000n 0.0 1666.667n 5.0 1706.667n 5.0 1708.333n 0.0 1748.333n 0.0 1750.000n 5.0 1790.000n 5.0 1791.667n 0.0 1831.667n 0.0 1833.333n 5.0 1873.333n 5.0 1875.000n 0.0 1915.000n 0.0 1916.667n 5.0 1956.667n 5.0 1958.333n 0.0 1998.333n 0.0 2000.000n 5.0 2040.000n 5.0 2041.667n 0.0 2081.667n 0.0 2083.333n 5.0 2123.333n 5.0 2125.000n 0.0 2165.000n 0.0 2166.667n 5.0 2206.667n 5.0 2208.333n 0.0 2248.333n 0.0 2250.000n 5.0 2290.000n 5.0 2291.667n 0.0 2331.667n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
Vrom_d3 rom_d3 0 PWL(0.000n 0.0 260.833n 0.0 262.500n 0.0 340.000n 0.0 341.667n 0.0 419.167n 0.0 420.833n 0.0 927.500n 0.0 929.167n 5.0 1006.667n 5.0 1008.333n 0.0 1085.833n 0.0 1087.500n 0.0 1594.167n 0.0 1595.833n 5.0 1673.333n 5.0 1675.000n 0.0 1752.500n 0.0 1754.167n 0.0 2260.833n 0.0 2262.500n 5.0 2340.000n 5.0 2341.667n 0.0 2419.167n 0.0 2420.833n 0.0 2927.500n 0.0 2929.167n 5.0 3006.667n 5.0 3008.333n 0.0 3085.833n 0.0 3087.500n 0.0 3594.167n 0.0 3595.833n 5.0 3673.333n 5.0 3675.000n 0.0 3752.500n 0.0 3754.167n 0.0 4260.833n 0.0 4262.500n 5.0 4340.000n 5.0 4341.667n 0.0 4419.167n 0.0 4420.833n 0.0)
Bd0 P6 0 I = V(drv_en) * (V(P6) - V(rom_d0)) / 50.0
Bd1 P5 0 I = V(drv_en) * (V(P5) - V(rom_d1)) / 50.0
Bd2 P4 0 I = V(drv_en) * (V(P4) - V(rom_d2)) / 50.0
Bd3 P3 0 I = V(drv_en) * (V(P3) - V(rom_d3)) / 50.0

.tran 0.833n 4666.667n
.meas tran pc6_l_d0 FIND v(P6) AT=4075.000n
.meas tran pc6_l_d1 FIND v(P5) AT=4075.000n
.meas tran pc6_l_d2 FIND v(P4) AT=4075.000n
.meas tran pc6_l_d3 FIND v(P3) AT=4075.000n
.meas tran pc6_l_doe FIND v(P9) AT=4075.000n
.meas tran pc6_m_d0 FIND v(P6) AT=4158.333n
.meas tran pc6_m_d1 FIND v(P5) AT=4158.333n
.meas tran pc6_m_d2 FIND v(P4) AT=4158.333n
.meas tran pc6_m_d3 FIND v(P3) AT=4158.333n
.meas tran pc6_m_doe FIND v(P9) AT=4158.333n
.meas tran pc6_h_d0 FIND v(P6) AT=4241.667n
.meas tran pc6_h_d1 FIND v(P5) AT=4241.667n
.meas tran pc6_h_d2 FIND v(P4) AT=4241.667n
.meas tran pc6_h_d3 FIND v(P3) AT=4241.667n
.meas tran pc6_h_doe FIND v(P9) AT=4241.667n
.meas tran final_acc_d0 FIND v(P6) AT=4575.000n
.meas tran final_acc_d1 FIND v(P5) AT=4575.000n
.meas tran final_acc_d2 FIND v(P4) AT=4575.000n
.meas tran final_acc_d3 FIND v(P3) AT=4575.000n
.meas tran final_acc_doe FIND v(P9) AT=4575.000n
.meas tran tpd_sync TRIG v(P1) VAL=2.5 RISE=1 TD=566.667n TARG v(P2) VAL=2.5 RISE=1 TD=566.667n
.meas tran tpd_cmrom TRIG v(P1) VAL=2.5 RISE=1 TD=150.000n TARG v(P15) VAL=2.5 FALL=1 TD=150.000n
.meas tran tpd_cmram0 TRIG v(P1) VAL=2.5 RISE=1 TD=150.000n TARG v(P11) VAL=2.5 FALL=1 TD=150.000n
.meas tran tpd_doe TRIG v(P1) VAL=2.5 RISE=1 TD=233.333n TARG v(P9) VAL=2.5 FALL=1 TD=233.333n
.meas tran tpd_dout0 TRIG v(P1) VAL=2.5 RISE=1 TD=650.000n TARG v(P6) VAL=2.5 RISE=1 TD=650.000n
.meas tran i_vdd_avg AVG i(VVDD) FROM=83.333n TO=4666.667n
.control
run
quit
.endc
.end
