jun1okamura/TR-1um_C4004_Clone2Build/TR-1um_C4004_01/apr/sim_test4_14MHz.sp

* Test 4: FMAX Sweep @ 14.0 MHz
.param vthMP=0 vthMN=0 vthMPE=0 vthMNE=0 magRR=1 magRS=1 magCSIO=1
.include "../TR-1um/libs.tech/spice/models/models_IP62_cap_v5p1.lib"
.include "../TR-1um/libs.tech/spice/models/models_IP62_diode_v2.lib"
.include "../TR-1um/libs.tech/spice/models/models_IP62_mos_v2.lib"
.include "../TR-1um/libs.tech/spice/models/models_IP62_res_v5.lib"
.include "OSS_FRAME_sim.spice"

.options reltol=1e-3 abstol=1e-9 vntol=1e-3 method=gear

* Power supplies
VVDD VDD 0 5.0
VVSS VSS 0 0.0

* DUT: Full-chip extracted netlist OSS_FRAME
* Pin order: P1 P10 P11 P12 P13 P14 P15 P2 P3 P4 P5 P6 P7 P9 VDD VSS
Xchip P1 P10 P11 P12 P13 P14 P15 P2 P3 P4 P5 P6 P7 P9 VDD VSS OSS_FRAME

* 1.0 pF load capacitance on all 14 signal pads
CP1  P1  0 1.0p
CP2  P2  0 1.0p
CP3  P3  0 1.0p
CP4  P4  0 1.0p
CP5  P5  0 1.0p
CP6  P6  0 1.0p
CP7  P7  0 1.0p
CP9  P9  0 1.0p
CP10 P10 0 1.0p
CP11 P11 0 1.0p
CP12 P12 0 1.0p
CP13 P13 0 1.0p
CP14 P14 0 1.0p
CP15 P15 0 1.0p

* Input stimulus on P1 (clk), P7 (rst), P10 (test)
VP1  P1  0 PWL(0.000n 0.0 70.000n 0.0 71.429n 5.0 105.714n 5.0 107.143n 0.0 141.429n 0.0 142.857n 5.0 177.143n 5.0 178.571n 0.0 212.857n 0.0 214.286n 5.0 248.571n 5.0 250.000n 0.0 284.286n 0.0 285.714n 5.0 320.000n 5.0 321.429n 0.0 355.714n 0.0 357.143n 5.0 391.429n 5.0 392.857n 0.0 427.143n 0.0 428.571n 5.0 462.857n 5.0 464.286n 0.0 498.571n 0.0 500.000n 5.0 534.286n 5.0 535.714n 0.0 570.000n 0.0 571.429n 5.0 605.714n 5.0 607.143n 0.0 641.429n 0.0 642.857n 5.0 677.143n 5.0 678.571n 0.0 712.857n 0.0 714.286n 5.0 748.571n 5.0 750.000n 0.0 784.286n 0.0 785.714n 5.0 820.000n 5.0 821.429n 0.0 855.714n 0.0 857.143n 5.0 891.429n 5.0 892.857n 0.0 927.143n 0.0 928.571n 5.0 962.857n 5.0 964.286n 0.0 998.571n 0.0 1000.000n 5.0 1034.286n 5.0 1035.714n 0.0 1070.000n 0.0 1071.429n 5.0 1105.714n 5.0 1107.143n 0.0 1141.429n 0.0 1142.857n 5.0 1177.143n 5.0 1178.571n 0.0 1212.857n 0.0 1214.286n 5.0 1248.571n 5.0 1250.000n 0.0 1284.286n 0.0 1285.714n 5.0 1320.000n 5.0 1321.429n 0.0 1355.714n 0.0 1357.143n 5.0 1391.429n 5.0 1392.857n 0.0 1427.143n 0.0 1428.571n 5.0 1462.857n 5.0 1464.286n 0.0 1498.571n 0.0 1500.000n 5.0 1534.286n 5.0 1535.714n 0.0 1570.000n 0.0 1571.429n 5.0 1605.714n 5.0 1607.143n 0.0 1641.429n 0.0 1642.857n 5.0 1677.143n 5.0 1678.571n 0.0 1712.857n 0.0 1714.286n 5.0 1748.571n 5.0 1750.000n 0.0 1784.286n 0.0 1785.714n 5.0 1820.000n 5.0 1821.429n 0.0 1855.714n 0.0 1857.143n 5.0 1891.429n 5.0 1892.857n 0.0 1927.143n 0.0 1928.571n 5.0 1962.857n 5.0 1964.286n 0.0 1998.571n 0.0 200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
Vrom_d3 rom_d3 0 PWL(0.000n 0.0 223.571n 0.0 225.000n 0.0 291.429n 0.0 292.857n 0.0 359.286n 0.0 360.714n 0.0 795.000n 0.0 796.429n 5.0 862.857n 5.0 864.286n 0.0 930.714n 0.0 932.143n 0.0 1366.429n 0.0 1367.857n 5.0 1434.286n 5.0 1435.714n 0.0 1502.143n 0.0 1503.571n 0.0 1937.857n 0.0 1939.286n 5.0 2005.714n 5.0 2007.143n 0.0 2073.571n 0.0 2075.000n 0.0 2509.286n 0.0 2510.714n 5.0 2577.143n 5.0 2578.571n 0.0 2645.000n 0.0 2646.429n 0.0 3080.714n 0.0 3082.143n 5.0 3148.571n 5.0 3150.000n 0.0 3216.429n 0.0 3217.857n 0.0 3652.143n 0.0 3653.571n 5.0 3720.000n 5.0 3721.429n 0.0 3787.857n 0.0 3789.286n 0.0)
Bd0 P6 0 I = V(drv_en) * (V(P6) - V(rom_d0)) / 50.0
Bd1 P5 0 I = V(drv_en) * (V(P5) - V(rom_d1)) / 50.0
Bd2 P4 0 I = V(drv_en) * (V(P4) - V(rom_d2)) / 50.0
Bd3 P3 0 I = V(drv_en) * (V(P3) - V(rom_d3)) / 50.0

.tran 0.714n 4000.000n
.meas tran pc6_l_d0 FIND v(P6) AT=3492.857n
.meas tran pc6_l_d1 FIND v(P5) AT=3492.857n
.meas tran pc6_l_d2 FIND v(P4) AT=3492.857n
.meas tran pc6_l_d3 FIND v(P3) AT=3492.857n
.meas tran pc6_l_doe FIND v(P9) AT=3492.857n
.meas tran pc6_m_d0 FIND v(P6) AT=3564.286n
.meas tran pc6_m_d1 FIND v(P5) AT=3564.286n
.meas tran pc6_m_d2 FIND v(P4) AT=3564.286n
.meas tran pc6_m_d3 FIND v(P3) AT=3564.286n
.meas tran pc6_m_doe FIND v(P9) AT=3564.286n
.meas tran pc6_h_d0 FIND v(P6) AT=3635.714n
.meas tran pc6_h_d1 FIND v(P5) AT=3635.714n
.meas tran pc6_h_d2 FIND v(P4) AT=3635.714n
.meas tran pc6_h_d3 FIND v(P3) AT=3635.714n
.meas tran pc6_h_doe FIND v(P9) AT=3635.714n
.meas tran final_acc_d0 FIND v(P6) AT=3921.429n
.meas tran final_acc_d1 FIND v(P5) AT=3921.429n
.meas tran final_acc_d2 FIND v(P4) AT=3921.429n
.meas tran final_acc_d3 FIND v(P3) AT=3921.429n
.meas tran final_acc_doe FIND v(P9) AT=3921.429n
.meas tran tpd_sync TRIG v(P1) VAL=2.5 RISE=1 TD=485.714n TARG v(P2) VAL=2.5 RISE=1 TD=485.714n
.meas tran tpd_cmrom TRIG v(P1) VAL=2.5 RISE=1 TD=128.571n TARG v(P15) VAL=2.5 FALL=1 TD=128.571n
.meas tran tpd_cmram0 TRIG v(P1) VAL=2.5 RISE=1 TD=128.571n TARG v(P11) VAL=2.5 FALL=1 TD=128.571n
.meas tran tpd_doe TRIG v(P1) VAL=2.5 RISE=1 TD=200.000n TARG v(P9) VAL=2.5 FALL=1 TD=200.000n
.meas tran tpd_dout0 TRIG v(P1) VAL=2.5 RISE=1 TD=557.143n TARG v(P6) VAL=2.5 RISE=1 TD=557.143n
.meas tran i_vdd_avg AVG i(VVDD) FROM=71.429n TO=4000.000n
.control
run
quit
.endc
.end
