jun1okamura/TR-1um_C4004_Clone2Build/TR-1um_C4004_01/apr/sim_test4_16MHz.sp

* Test 4: FMAX Sweep @ 16.0 MHz
.param vthMP=0 vthMN=0 vthMPE=0 vthMNE=0 magRR=1 magRS=1 magCSIO=1
.include "../TR-1um/libs.tech/spice/models/models_IP62_cap_v5p1.lib"
.include "../TR-1um/libs.tech/spice/models/models_IP62_diode_v2.lib"
.include "../TR-1um/libs.tech/spice/models/models_IP62_mos_v2.lib"
.include "../TR-1um/libs.tech/spice/models/models_IP62_res_v5.lib"
.include "OSS_FRAME_sim.spice"

.options reltol=1e-3 abstol=1e-9 vntol=1e-3 method=gear

* Power supplies
VVDD VDD 0 5.0
VVSS VSS 0 0.0

* DUT: Full-chip extracted netlist OSS_FRAME
* Pin order: P1 P10 P11 P12 P13 P14 P15 P2 P3 P4 P5 P6 P7 P9 VDD VSS
Xchip P1 P10 P11 P12 P13 P14 P15 P2 P3 P4 P5 P6 P7 P9 VDD VSS OSS_FRAME

* 1.0 pF load capacitance on all 14 signal pads
CP1  P1  0 1.0p
CP2  P2  0 1.0p
CP3  P3  0 1.0p
CP4  P4  0 1.0p
CP5  P5  0 1.0p
CP6  P6  0 1.0p
CP7  P7  0 1.0p
CP9  P9  0 1.0p
CP10 P10 0 1.0p
CP11 P11 0 1.0p
CP12 P12 0 1.0p
CP13 P13 0 1.0p
CP14 P14 0 1.0p
CP15 P15 0 1.0p

* Input stimulus on P1 (clk), P7 (rst), P10 (test)
VP1  P1  0 PWL(0.000n 0.0 61.250n 0.0 62.500n 5.0 92.500n 5.0 93.750n 0.0 123.750n 0.0 125.000n 5.0 155.000n 5.0 156.250n 0.0 186.250n 0.0 187.500n 5.0 217.500n 5.0 218.750n 0.0 248.750n 0.0 250.000n 5.0 280.000n 5.0 281.250n 0.0 311.250n 0.0 312.500n 5.0 342.500n 5.0 343.750n 0.0 373.750n 0.0 375.000n 5.0 405.000n 5.0 406.250n 0.0 436.250n 0.0 437.500n 5.0 467.500n 5.0 468.750n 0.0 498.750n 0.0 500.000n 5.0 530.000n 5.0 531.250n 0.0 561.250n 0.0 562.500n 5.0 592.500n 5.0 593.750n 0.0 623.750n 0.0 625.000n 5.0 655.000n 5.0 656.250n 0.0 686.250n 0.0 687.500n 5.0 717.500n 5.0 718.750n 0.0 748.750n 0.0 750.000n 5.0 780.000n 5.0 781.250n 0.0 811.250n 0.0 812.500n 5.0 842.500n 5.0 843.750n 0.0 873.750n 0.0 875.000n 5.0 905.000n 5.0 906.250n 0.0 936.250n 0.0 937.500n 5.0 967.500n 5.0 968.750n 0.0 998.750n 0.0 1000.000n 5.0 1030.000n 5.0 1031.250n 0.0 1061.250n 0.0 1062.500n 5.0 1092.500n 5.0 1093.750n 0.0 1123.750n 0.0 1125.000n 5.0 1155.000n 5.0 1156.250n 0.0 1186.250n 0.0 1187.500n 5.0 1217.500n 5.0 1218.750n 0.0 1248.750n 0.0 1250.000n 5.0 1280.000n 5.0 1281.250n 0.0 1311.250n 0.0 1312.500n 5.0 1342.500n 5.0 1343.750n 0.0 1373.750n 0.0 1375.000n 5.0 1405.000n 5.0 1406.250n 0.0 1436.250n 0.0 1437.500n 5.0 1467.500n 5.0 1468.750n 0.0 1498.750n 0.0 1500.000n 5.0 1530.000n 5.0 1531.250n 0.0 1561.250n 0.0 1562.500n 5.0 1592.500n 5.0 1593.750n 0.0 1623.750n 0.0 1625.000n 5.0 1655.000n 5.0 1656.250n 0.0 1686.250n 0.0 1687.500n 5.0 1717.500n 5.0 1718.750n 0.0 1748.750n 0.0 1750.000n 5.0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
Vrom_d3 rom_d3 0 PWL(0.000n 0.0 195.625n 0.0 196.875n 0.0 255.000n 0.0 256.250n 0.0 314.375n 0.0 315.625n 0.0 695.625n 0.0 696.875n 5.0 755.000n 5.0 756.250n 0.0 814.375n 0.0 815.625n 0.0 1195.625n 0.0 1196.875n 5.0 1255.000n 5.0 1256.250n 0.0 1314.375n 0.0 1315.625n 0.0 1695.625n 0.0 1696.875n 5.0 1755.000n 5.0 1756.250n 0.0 1814.375n 0.0 1815.625n 0.0 2195.625n 0.0 2196.875n 5.0 2255.000n 5.0 2256.250n 0.0 2314.375n 0.0 2315.625n 0.0 2695.625n 0.0 2696.875n 5.0 2755.000n 5.0 2756.250n 0.0 2814.375n 0.0 2815.625n 0.0 3195.625n 0.0 3196.875n 5.0 3255.000n 5.0 3256.250n 0.0 3314.375n 0.0 3315.625n 0.0)
Bd0 P6 0 I = V(drv_en) * (V(P6) - V(rom_d0)) / 50.0
Bd1 P5 0 I = V(drv_en) * (V(P5) - V(rom_d1)) / 50.0
Bd2 P4 0 I = V(drv_en) * (V(P4) - V(rom_d2)) / 50.0
Bd3 P3 0 I = V(drv_en) * (V(P3) - V(rom_d3)) / 50.0

.tran 0.625n 3500.000n
.meas tran pc6_l_d0 FIND v(P6) AT=3056.250n
.meas tran pc6_l_d1 FIND v(P5) AT=3056.250n
.meas tran pc6_l_d2 FIND v(P4) AT=3056.250n
.meas tran pc6_l_d3 FIND v(P3) AT=3056.250n
.meas tran pc6_l_doe FIND v(P9) AT=3056.250n
.meas tran pc6_m_d0 FIND v(P6) AT=3118.750n
.meas tran pc6_m_d1 FIND v(P5) AT=3118.750n
.meas tran pc6_m_d2 FIND v(P4) AT=3118.750n
.meas tran pc6_m_d3 FIND v(P3) AT=3118.750n
.meas tran pc6_m_doe FIND v(P9) AT=3118.750n
.meas tran pc6_h_d0 FIND v(P6) AT=3181.250n
.meas tran pc6_h_d1 FIND v(P5) AT=3181.250n
.meas tran pc6_h_d2 FIND v(P4) AT=3181.250n
.meas tran pc6_h_d3 FIND v(P3) AT=3181.250n
.meas tran pc6_h_doe FIND v(P9) AT=3181.250n
.meas tran final_acc_d0 FIND v(P6) AT=3431.250n
.meas tran final_acc_d1 FIND v(P5) AT=3431.250n
.meas tran final_acc_d2 FIND v(P4) AT=3431.250n
.meas tran final_acc_d3 FIND v(P3) AT=3431.250n
.meas tran final_acc_doe FIND v(P9) AT=3431.250n
.meas tran tpd_sync TRIG v(P1) VAL=2.5 RISE=1 TD=425.000n TARG v(P2) VAL=2.5 RISE=1 TD=425.000n
.meas tran tpd_cmrom TRIG v(P1) VAL=2.5 RISE=1 TD=112.500n TARG v(P15) VAL=2.5 FALL=1 TD=112.500n
.meas tran tpd_cmram0 TRIG v(P1) VAL=2.5 RISE=1 TD=112.500n TARG v(P11) VAL=2.5 FALL=1 TD=112.500n
.meas tran tpd_doe TRIG v(P1) VAL=2.5 RISE=1 TD=175.000n TARG v(P9) VAL=2.5 FALL=1 TD=175.000n
.meas tran tpd_dout0 TRIG v(P1) VAL=2.5 RISE=1 TD=487.500n TARG v(P6) VAL=2.5 RISE=1 TD=487.500n
.meas tran i_vdd_avg AVG i(VVDD) FROM=62.500n TO=3500.000n
.control
run
quit
.endc
.end
