jun1okamura/TR-1um_C4004_Clone2Build/TR-1um_C4004_01/apr/sim_test4_2MHz.sp

* Test 4: FMAX Sweep @ 2.0 MHz
.param vthMP=0 vthMN=0 vthMPE=0 vthMNE=0 magRR=1 magRS=1 magCSIO=1
.include "../TR-1um/libs.tech/spice/models/models_IP62_cap_v5p1.lib"
.include "../TR-1um/libs.tech/spice/models/models_IP62_diode_v2.lib"
.include "../TR-1um/libs.tech/spice/models/models_IP62_mos_v2.lib"
.include "../TR-1um/libs.tech/spice/models/models_IP62_res_v5.lib"
.include "OSS_FRAME_sim.spice"

.options reltol=1e-3 abstol=1e-9 vntol=1e-3 method=gear

* Power supplies
VVDD VDD 0 5.0
VVSS VSS 0 0.0

* DUT: Full-chip extracted netlist OSS_FRAME
* Pin order: P1 P10 P11 P12 P13 P14 P15 P2 P3 P4 P5 P6 P7 P9 VDD VSS
Xchip P1 P10 P11 P12 P13 P14 P15 P2 P3 P4 P5 P6 P7 P9 VDD VSS OSS_FRAME

* 1.0 pF load capacitance on all 14 signal pads
CP1  P1  0 1.0p
CP2  P2  0 1.0p
CP3  P3  0 1.0p
CP4  P4  0 1.0p
CP5  P5  0 1.0p
CP6  P6  0 1.0p
CP7  P7  0 1.0p
CP9  P9  0 1.0p
CP10 P10 0 1.0p
CP11 P11 0 1.0p
CP12 P12 0 1.0p
CP13 P13 0 1.0p
CP14 P14 0 1.0p
CP15 P15 0 1.0p

* Input stimulus on P1 (clk), P7 (rst), P10 (test)
VP1  P1  0 PWL(0.000n 0.0 498.000n 0.0 500.000n 5.0 748.000n 5.0 750.000n 0.0 998.000n 0.0 1000.000n 5.0 1248.000n 5.0 1250.000n 0.0 1498.000n 0.0 1500.000n 5.0 1748.000n 5.0 1750.000n 0.0 1998.000n 0.0 2000.000n 5.0 2248.000n 5.0 2250.000n 0.0 2498.000n 0.0 2500.000n 5.0 2748.000n 5.0 2750.000n 0.0 2998.000n 0.0 3000.000n 5.0 3248.000n 5.0 3250.000n 0.0 3498.000n 0.0 3500.000n 5.0 3748.000n 5.0 3750.000n 0.0 3998.000n 0.0 4000.000n 5.0 4248.000n 5.0 4250.000n 0.0 4498.000n 0.0 4500.000n 5.0 4748.000n 5.0 4750.000n 0.0 4998.000n 0.0 5000.000n 5.0 5248.000n 5.0 5250.000n 0.0 5498.000n 0.0 5500.000n 5.0 5748.000n 5.0 5750.000n 0.0 5998.000n 0.0 6000.000n 5.0 6248.000n 5.0 6250.000n 0.0 6498.000n 0.0 6500.000n 5.0 6748.000n 5.0 6750.000n 0.0 6998.000n 0.0 7000.000n 5.0 7248.000n 5.0 7250.000n 0.0 7498.000n 0.0 7500.000n 5.0 7748.000n 5.0 7750.000n 0.0 7998.000n 0.0 8000.000n 5.0 8248.000n 5.0 8250.000n 0.0 8498.000n 0.0 8500.000n 5.0 8748.000n 5.0 8750.000n 0.0 8998.000n 0.0 9000.000n 5.0 9248.000n 5.0 9250.000n 0.0 9498.000n 0.0 9500.000n 5.0 9748.000n 5.0 9750.000n 0.0 9998.000n 0.0 10000.000n 5.0 10248.000n 5.0 10250.000n 0.0 10498.000n 0.0 10500.000n 5.0 10748.000n 5.0 10750.000n 0.0 10998.000n 0.0 11000.000n 5.0 11248.000n 5.0 11250.000n 0.0 11498.000n 0.0 11500.000n 5.0 11748.000n 5.0 11750.000n 0.0 11998.000n 0.0 12000.000n 5.0 12248.000n 5.0 12250.000n 0.0 12498.000n 0.0 12500.000n 5.0 12748.000n 5.0 12750.000n 0.0 12998.000n 0.0 13000.000n 5.0 13248.000n 5.0 13250.000n 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
Vrom_d3 rom_d3 0 PWL(0.000n 0.0 1573.000n 0.0 1575.000n 0.0 2048.000n 0.0 2050.000n 0.0 2523.000n 0.0 2525.000n 0.0 5573.000n 0.0 5575.000n 5.0 6048.000n 5.0 6050.000n 0.0 6523.000n 0.0 6525.000n 0.0 9573.000n 0.0 9575.000n 5.0 10048.000n 5.0 10050.000n 0.0 10523.000n 0.0 10525.000n 0.0 13573.000n 0.0 13575.000n 5.0 14048.000n 5.0 14050.000n 0.0 14523.000n 0.0 14525.000n 0.0 17573.000n 0.0 17575.000n 5.0 18048.000n 5.0 18050.000n 0.0 18523.000n 0.0 18525.000n 0.0 21573.000n 0.0 21575.000n 5.0 22048.000n 5.0 22050.000n 0.0 22523.000n 0.0 22525.000n 0.0 25573.000n 0.0 25575.000n 5.0 26048.000n 5.0 26050.000n 0.0 26523.000n 0.0 26525.000n 0.0)
Bd0 P6 0 I = V(drv_en) * (V(P6) - V(rom_d0)) / 50.0
Bd1 P5 0 I = V(drv_en) * (V(P5) - V(rom_d1)) / 50.0
Bd2 P4 0 I = V(drv_en) * (V(P4) - V(rom_d2)) / 50.0
Bd3 P3 0 I = V(drv_en) * (V(P3) - V(rom_d3)) / 50.0

.tran 5.000n 28000.000n
.meas tran pc6_l_d0 FIND v(P6) AT=24450.000n
.meas tran pc6_l_d1 FIND v(P5) AT=24450.000n
.meas tran pc6_l_d2 FIND v(P4) AT=24450.000n
.meas tran pc6_l_d3 FIND v(P3) AT=24450.000n
.meas tran pc6_l_doe FIND v(P9) AT=24450.000n
.meas tran pc6_m_d0 FIND v(P6) AT=24950.000n
.meas tran pc6_m_d1 FIND v(P5) AT=24950.000n
.meas tran pc6_m_d2 FIND v(P4) AT=24950.000n
.meas tran pc6_m_d3 FIND v(P3) AT=24950.000n
.meas tran pc6_m_doe FIND v(P9) AT=24950.000n
.meas tran pc6_h_d0 FIND v(P6) AT=25450.000n
.meas tran pc6_h_d1 FIND v(P5) AT=25450.000n
.meas tran pc6_h_d2 FIND v(P4) AT=25450.000n
.meas tran pc6_h_d3 FIND v(P3) AT=25450.000n
.meas tran pc6_h_doe FIND v(P9) AT=25450.000n
.meas tran final_acc_d0 FIND v(P6) AT=27450.000n
.meas tran final_acc_d1 FIND v(P5) AT=27450.000n
.meas tran final_acc_d2 FIND v(P4) AT=27450.000n
.meas tran final_acc_d3 FIND v(P3) AT=27450.000n
.meas tran final_acc_doe FIND v(P9) AT=27450.000n
.meas tran tpd_sync TRIG v(P1) VAL=2.5 RISE=1 TD=3400.000n TARG v(P2) VAL=2.5 RISE=1 TD=3400.000n
.meas tran tpd_cmrom TRIG v(P1) VAL=2.5 RISE=1 TD=900.000n TARG v(P15) VAL=2.5 FALL=1 TD=900.000n
.meas tran tpd_cmram0 TRIG v(P1) VAL=2.5 RISE=1 TD=900.000n TARG v(P11) VAL=2.5 FALL=1 TD=900.000n
.meas tran tpd_doe TRIG v(P1) VAL=2.5 RISE=1 TD=1400.000n TARG v(P9) VAL=2.5 FALL=1 TD=1400.000n
.meas tran tpd_dout0 TRIG v(P1) VAL=2.5 RISE=1 TD=3900.000n TARG v(P6) VAL=2.5 RISE=1 TD=3900.000n
.meas tran i_vdd_avg AVG i(VVDD) FROM=500.000n TO=28000.000n
.control
run
quit
.endc
.end
