jun1okamura/TR-1um_C4004_Clone2Build/TR-1um_C4004_01/apr/sim_test4_4MHz.sp

* Test 4: FMAX Sweep @ 4.0 MHz
.param vthMP=0 vthMN=0 vthMPE=0 vthMNE=0 magRR=1 magRS=1 magCSIO=1
.include "../TR-1um/libs.tech/spice/models/models_IP62_cap_v5p1.lib"
.include "../TR-1um/libs.tech/spice/models/models_IP62_diode_v2.lib"
.include "../TR-1um/libs.tech/spice/models/models_IP62_mos_v2.lib"
.include "../TR-1um/libs.tech/spice/models/models_IP62_res_v5.lib"
.include "OSS_FRAME_sim.spice"

.options reltol=1e-3 abstol=1e-9 vntol=1e-3 method=gear

* Power supplies
VVDD VDD 0 5.0
VVSS VSS 0 0.0

* DUT: Full-chip extracted netlist OSS_FRAME
* Pin order: P1 P10 P11 P12 P13 P14 P15 P2 P3 P4 P5 P6 P7 P9 VDD VSS
Xchip P1 P10 P11 P12 P13 P14 P15 P2 P3 P4 P5 P6 P7 P9 VDD VSS OSS_FRAME

* 1.0 pF load capacitance on all 14 signal pads
CP1  P1  0 1.0p
CP2  P2  0 1.0p
CP3  P3  0 1.0p
CP4  P4  0 1.0p
CP5  P5  0 1.0p
CP6  P6  0 1.0p
CP7  P7  0 1.0p
CP9  P9  0 1.0p
CP10 P10 0 1.0p
CP11 P11 0 1.0p
CP12 P12 0 1.0p
CP13 P13 0 1.0p
CP14 P14 0 1.0p
CP15 P15 0 1.0p

* Input stimulus on P1 (clk), P7 (rst), P10 (test)
VP1  P1  0 PWL(0.000n 0.0 248.000n 0.0 250.000n 5.0 373.000n 5.0 375.000n 0.0 498.000n 0.0 500.000n 5.0 623.000n 5.0 625.000n 0.0 748.000n 0.0 750.000n 5.0 873.000n 5.0 875.000n 0.0 998.000n 0.0 1000.000n 5.0 1123.000n 5.0 1125.000n 0.0 1248.000n 0.0 1250.000n 5.0 1373.000n 5.0 1375.000n 0.0 1498.000n 0.0 1500.000n 5.0 1623.000n 5.0 1625.000n 0.0 1748.000n 0.0 1750.000n 5.0 1873.000n 5.0 1875.000n 0.0 1998.000n 0.0 2000.000n 5.0 2123.000n 5.0 2125.000n 0.0 2248.000n 0.0 2250.000n 5.0 2373.000n 5.0 2375.000n 0.0 2498.000n 0.0 2500.000n 5.0 2623.000n 5.0 2625.000n 0.0 2748.000n 0.0 2750.000n 5.0 2873.000n 5.0 2875.000n 0.0 2998.000n 0.0 3000.000n 5.0 3123.000n 5.0 3125.000n 0.0 3248.000n 0.0 3250.000n 5.0 3373.000n 5.0 3375.000n 0.0 3498.000n 0.0 3500.000n 5.0 3623.000n 5.0 3625.000n 0.0 3748.000n 0.0 3750.000n 5.0 3873.000n 5.0 3875.000n 0.0 3998.000n 0.0 4000.000n 5.0 4123.000n 5.0 4125.000n 0.0 4248.000n 0.0 4250.000n 5.0 4373.000n 5.0 4375.000n 0.0 4498.000n 0.0 4500.000n 5.0 4623.000n 5.0 4625.000n 0.0 4748.000n 0.0 4750.000n 5.0 4873.000n 5.0 4875.000n 0.0 4998.000n 0.0 5000.000n 5.0 5123.000n 5.0 5125.000n 0.0 5248.000n 0.0 5250.000n 5.0 5373.000n 5.0 5375.000n 0.0 5498.000n 0.0 5500.000n 5.0 5623.000n 5.0 5625.000n 0.0 5748.000n 0.0 5750.000n 5.0 5873.000n 5.0 5875.000n 0.0 5998.000n 0.0 6000.000n 5.0 6123.000n 5.0 6125.000n 0.0 6248.000n 0.0 6250.000n 5.0 6373.000n 5.0 6375.000n 0.0 6498.000n 0.0 6500.000n 5.0 6623.000n 5.0 6625.000n 0.0 6748.000n 0.0 6750.000n 5.0 687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
Vrom_d3 rom_d3 0 PWL(0.000n 0.0 785.500n 0.0 787.500n 0.0 1023.000n 0.0 1025.000n 0.0 1260.500n 0.0 1262.500n 0.0 2785.500n 0.0 2787.500n 5.0 3023.000n 5.0 3025.000n 0.0 3260.500n 0.0 3262.500n 0.0 4785.500n 0.0 4787.500n 5.0 5023.000n 5.0 5025.000n 0.0 5260.500n 0.0 5262.500n 0.0 6785.500n 0.0 6787.500n 5.0 7023.000n 5.0 7025.000n 0.0 7260.500n 0.0 7262.500n 0.0 8785.500n 0.0 8787.500n 5.0 9023.000n 5.0 9025.000n 0.0 9260.500n 0.0 9262.500n 0.0 10785.500n 0.0 10787.500n 5.0 11023.000n 5.0 11025.000n 0.0 11260.500n 0.0 11262.500n 0.0 12785.500n 0.0 12787.500n 5.0 13023.000n 5.0 13025.000n 0.0 13260.500n 0.0 13262.500n 0.0)
Bd0 P6 0 I = V(drv_en) * (V(P6) - V(rom_d0)) / 50.0
Bd1 P5 0 I = V(drv_en) * (V(P5) - V(rom_d1)) / 50.0
Bd2 P4 0 I = V(drv_en) * (V(P4) - V(rom_d2)) / 50.0
Bd3 P3 0 I = V(drv_en) * (V(P3) - V(rom_d3)) / 50.0

.tran 2.500n 14000.000n
.meas tran pc6_l_d0 FIND v(P6) AT=12225.000n
.meas tran pc6_l_d1 FIND v(P5) AT=12225.000n
.meas tran pc6_l_d2 FIND v(P4) AT=12225.000n
.meas tran pc6_l_d3 FIND v(P3) AT=12225.000n
.meas tran pc6_l_doe FIND v(P9) AT=12225.000n
.meas tran pc6_m_d0 FIND v(P6) AT=12475.000n
.meas tran pc6_m_d1 FIND v(P5) AT=12475.000n
.meas tran pc6_m_d2 FIND v(P4) AT=12475.000n
.meas tran pc6_m_d3 FIND v(P3) AT=12475.000n
.meas tran pc6_m_doe FIND v(P9) AT=12475.000n
.meas tran pc6_h_d0 FIND v(P6) AT=12725.000n
.meas tran pc6_h_d1 FIND v(P5) AT=12725.000n
.meas tran pc6_h_d2 FIND v(P4) AT=12725.000n
.meas tran pc6_h_d3 FIND v(P3) AT=12725.000n
.meas tran pc6_h_doe FIND v(P9) AT=12725.000n
.meas tran final_acc_d0 FIND v(P6) AT=13725.000n
.meas tran final_acc_d1 FIND v(P5) AT=13725.000n
.meas tran final_acc_d2 FIND v(P4) AT=13725.000n
.meas tran final_acc_d3 FIND v(P3) AT=13725.000n
.meas tran final_acc_doe FIND v(P9) AT=13725.000n
.meas tran tpd_sync TRIG v(P1) VAL=2.5 RISE=1 TD=1700.000n TARG v(P2) VAL=2.5 RISE=1 TD=1700.000n
.meas tran tpd_cmrom TRIG v(P1) VAL=2.5 RISE=1 TD=450.000n TARG v(P15) VAL=2.5 FALL=1 TD=450.000n
.meas tran tpd_cmram0 TRIG v(P1) VAL=2.5 RISE=1 TD=450.000n TARG v(P11) VAL=2.5 FALL=1 TD=450.000n
.meas tran tpd_doe TRIG v(P1) VAL=2.5 RISE=1 TD=700.000n TARG v(P9) VAL=2.5 FALL=1 TD=700.000n
.meas tran tpd_dout0 TRIG v(P1) VAL=2.5 RISE=1 TD=1950.000n TARG v(P6) VAL=2.5 RISE=1 TD=1950.000n
.meas tran i_vdd_avg AVG i(VVDD) FROM=250.000n TO=14000.000n
.control
run
quit
.endc
.end
