jun1okamura/TR-1um_C4004_Clone2Build/TR-1um_C4004_01/apr/sim_test4_6MHz.sp

* Test 4: FMAX Sweep @ 6.0 MHz
.param vthMP=0 vthMN=0 vthMPE=0 vthMNE=0 magRR=1 magRS=1 magCSIO=1
.include "../TR-1um/libs.tech/spice/models/models_IP62_cap_v5p1.lib"
.include "../TR-1um/libs.tech/spice/models/models_IP62_diode_v2.lib"
.include "../TR-1um/libs.tech/spice/models/models_IP62_mos_v2.lib"
.include "../TR-1um/libs.tech/spice/models/models_IP62_res_v5.lib"
.include "OSS_FRAME_sim.spice"

.options reltol=1e-3 abstol=1e-9 vntol=1e-3 method=gear

* Power supplies
VVDD VDD 0 5.0
VVSS VSS 0 0.0

* DUT: Full-chip extracted netlist OSS_FRAME
* Pin order: P1 P10 P11 P12 P13 P14 P15 P2 P3 P4 P5 P6 P7 P9 VDD VSS
Xchip P1 P10 P11 P12 P13 P14 P15 P2 P3 P4 P5 P6 P7 P9 VDD VSS OSS_FRAME

* 1.0 pF load capacitance on all 14 signal pads
CP1  P1  0 1.0p
CP2  P2  0 1.0p
CP3  P3  0 1.0p
CP4  P4  0 1.0p
CP5  P5  0 1.0p
CP6  P6  0 1.0p
CP7  P7  0 1.0p
CP9  P9  0 1.0p
CP10 P10 0 1.0p
CP11 P11 0 1.0p
CP12 P12 0 1.0p
CP13 P13 0 1.0p
CP14 P14 0 1.0p
CP15 P15 0 1.0p

* Input stimulus on P1 (clk), P7 (rst), P10 (test)
VP1  P1  0 PWL(0.000n 0.0 164.667n 0.0 166.667n 5.0 248.000n 5.0 250.000n 0.0 331.333n 0.0 333.333n 5.0 414.667n 5.0 416.667n 0.0 498.000n 0.0 500.000n 5.0 581.333n 5.0 583.333n 0.0 664.667n 0.0 666.667n 5.0 748.000n 5.0 750.000n 0.0 831.333n 0.0 833.333n 5.0 914.667n 5.0 916.667n 0.0 998.000n 0.0 1000.000n 5.0 1081.333n 5.0 1083.333n 0.0 1164.667n 0.0 1166.667n 5.0 1248.000n 5.0 1250.000n 0.0 1331.333n 0.0 1333.333n 5.0 1414.667n 5.0 1416.667n 0.0 1498.000n 0.0 1500.000n 5.0 1581.333n 5.0 1583.333n 0.0 1664.667n 0.0 1666.667n 5.0 1748.000n 5.0 1750.000n 0.0 1831.333n 0.0 1833.333n 5.0 1914.667n 5.0 1916.667n 0.0 1998.000n 0.0 2000.000n 5.0 2081.333n 5.0 2083.333n 0.0 2164.667n 0.0 2166.667n 5.0 2248.000n 5.0 2250.000n 0.0 2331.333n 0.0 2333.333n 5.0 2414.667n 5.0 2416.667n 0.0 2498.000n 0.0 2500.000n 5.0 2581.333n 5.0 2583.333n 0.0 2664.667n 0.0 2666.667n 5.0 2748.000n 5.0 2750.000n 0.0 2831.333n 0.0 2833.333n 5.0 2914.667n 5.0 2916.667n 0.0 2998.000n 0.0 3000.000n 5.0 3081.333n 5.0 3083.333n 0.0 3164.667n 0.0 3166.667n 5.0 3248.000n 5.0 3250.000n 0.0 3331.333n 0.0 3333.333n 5.0 3414.667n 5.0 3416.667n 0.0 3498.000n 0.0 3500.000n 5.0 3581.333n 5.0 3583.333n 0.0 3664.667n 0.0 3666.667n 5.0 3748.000n 5.0 3750.000n 0.0 3831.333n 0.0 3833.333n 5.0 3914.667n 5.0 3916.667n 0.0 3998.000n 0.0 4000.000n 5.0 4081.333n 5.0 4083.333n 0.0 4164.667n 0.0 4166.667n 5.0 4248.000n 5.0 4250.000n 0.0 4331.333n 0.0 4333.333n 5.0 4414.667n 5.0 4416.667n 0.0 4498.000n 0.0 4500.000n 5.0 4581.333n 5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
Vrom_d3 rom_d3 0 PWL(0.000n 0.0 523.000n 0.0 525.000n 0.0 681.333n 0.0 683.333n 0.0 839.667n 0.0 841.667n 0.0 1856.333n 0.0 1858.333n 5.0 2014.667n 5.0 2016.667n 0.0 2173.000n 0.0 2175.000n 0.0 3189.667n 0.0 3191.667n 5.0 3348.000n 5.0 3350.000n 0.0 3506.333n 0.0 3508.333n 0.0 4523.000n 0.0 4525.000n 5.0 4681.333n 5.0 4683.333n 0.0 4839.667n 0.0 4841.667n 0.0 5856.333n 0.0 5858.333n 5.0 6014.667n 5.0 6016.667n 0.0 6173.000n 0.0 6175.000n 0.0 7189.667n 0.0 7191.667n 5.0 7348.000n 5.0 7350.000n 0.0 7506.333n 0.0 7508.333n 0.0 8523.000n 0.0 8525.000n 5.0 8681.333n 5.0 8683.333n 0.0 8839.667n 0.0 8841.667n 0.0)
Bd0 P6 0 I = V(drv_en) * (V(P6) - V(rom_d0)) / 50.0
Bd1 P5 0 I = V(drv_en) * (V(P5) - V(rom_d1)) / 50.0
Bd2 P4 0 I = V(drv_en) * (V(P4) - V(rom_d2)) / 50.0
Bd3 P3 0 I = V(drv_en) * (V(P3) - V(rom_d3)) / 50.0

.tran 1.667n 9333.333n
.meas tran pc6_l_d0 FIND v(P6) AT=8150.000n
.meas tran pc6_l_d1 FIND v(P5) AT=8150.000n
.meas tran pc6_l_d2 FIND v(P4) AT=8150.000n
.meas tran pc6_l_d3 FIND v(P3) AT=8150.000n
.meas tran pc6_l_doe FIND v(P9) AT=8150.000n
.meas tran pc6_m_d0 FIND v(P6) AT=8316.667n
.meas tran pc6_m_d1 FIND v(P5) AT=8316.667n
.meas tran pc6_m_d2 FIND v(P4) AT=8316.667n
.meas tran pc6_m_d3 FIND v(P3) AT=8316.667n
.meas tran pc6_m_doe FIND v(P9) AT=8316.667n
.meas tran pc6_h_d0 FIND v(P6) AT=8483.333n
.meas tran pc6_h_d1 FIND v(P5) AT=8483.333n
.meas tran pc6_h_d2 FIND v(P4) AT=8483.333n
.meas tran pc6_h_d3 FIND v(P3) AT=8483.333n
.meas tran pc6_h_doe FIND v(P9) AT=8483.333n
.meas tran final_acc_d0 FIND v(P6) AT=9150.000n
.meas tran final_acc_d1 FIND v(P5) AT=9150.000n
.meas tran final_acc_d2 FIND v(P4) AT=9150.000n
.meas tran final_acc_d3 FIND v(P3) AT=9150.000n
.meas tran final_acc_doe FIND v(P9) AT=9150.000n
.meas tran tpd_sync TRIG v(P1) VAL=2.5 RISE=1 TD=1133.333n TARG v(P2) VAL=2.5 RISE=1 TD=1133.333n
.meas tran tpd_cmrom TRIG v(P1) VAL=2.5 RISE=1 TD=300.000n TARG v(P15) VAL=2.5 FALL=1 TD=300.000n
.meas tran tpd_cmram0 TRIG v(P1) VAL=2.5 RISE=1 TD=300.000n TARG v(P11) VAL=2.5 FALL=1 TD=300.000n
.meas tran tpd_doe TRIG v(P1) VAL=2.5 RISE=1 TD=466.667n TARG v(P9) VAL=2.5 FALL=1 TD=466.667n
.meas tran tpd_dout0 TRIG v(P1) VAL=2.5 RISE=1 TD=1300.000n TARG v(P6) VAL=2.5 RISE=1 TD=1300.000n
.meas tran i_vdd_avg AVG i(VVDD) FROM=166.667n TO=9333.333n
.control
run
quit
.endc
.end
