jun1okamura/TR-1um_C4004_Clone2Build/TR-1um_C4004_01/apr/sim_test4_8MHz.sp

* Test 4: FMAX Sweep @ 8.0 MHz
.param vthMP=0 vthMN=0 vthMPE=0 vthMNE=0 magRR=1 magRS=1 magCSIO=1
.include "../TR-1um/libs.tech/spice/models/models_IP62_cap_v5p1.lib"
.include "../TR-1um/libs.tech/spice/models/models_IP62_diode_v2.lib"
.include "../TR-1um/libs.tech/spice/models/models_IP62_mos_v2.lib"
.include "../TR-1um/libs.tech/spice/models/models_IP62_res_v5.lib"
.include "OSS_FRAME_sim.spice"

.options reltol=1e-3 abstol=1e-9 vntol=1e-3 method=gear

* Power supplies
VVDD VDD 0 5.0
VVSS VSS 0 0.0

* DUT: Full-chip extracted netlist OSS_FRAME
* Pin order: P1 P10 P11 P12 P13 P14 P15 P2 P3 P4 P5 P6 P7 P9 VDD VSS
Xchip P1 P10 P11 P12 P13 P14 P15 P2 P3 P4 P5 P6 P7 P9 VDD VSS OSS_FRAME

* 1.0 pF load capacitance on all 14 signal pads
CP1  P1  0 1.0p
CP2  P2  0 1.0p
CP3  P3  0 1.0p
CP4  P4  0 1.0p
CP5  P5  0 1.0p
CP6  P6  0 1.0p
CP7  P7  0 1.0p
CP9  P9  0 1.0p
CP10 P10 0 1.0p
CP11 P11 0 1.0p
CP12 P12 0 1.0p
CP13 P13 0 1.0p
CP14 P14 0 1.0p
CP15 P15 0 1.0p

* Input stimulus on P1 (clk), P7 (rst), P10 (test)
VP1  P1  0 PWL(0.000n 0.0 123.000n 0.0 125.000n 5.0 185.500n 5.0 187.500n 0.0 248.000n 0.0 250.000n 5.0 310.500n 5.0 312.500n 0.0 373.000n 0.0 375.000n 5.0 435.500n 5.0 437.500n 0.0 498.000n 0.0 500.000n 5.0 560.500n 5.0 562.500n 0.0 623.000n 0.0 625.000n 5.0 685.500n 5.0 687.500n 0.0 748.000n 0.0 750.000n 5.0 810.500n 5.0 812.500n 0.0 873.000n 0.0 875.000n 5.0 935.500n 5.0 937.500n 0.0 998.000n 0.0 1000.000n 5.0 1060.500n 5.0 1062.500n 0.0 1123.000n 0.0 1125.000n 5.0 1185.500n 5.0 1187.500n 0.0 1248.000n 0.0 1250.000n 5.0 1310.500n 5.0 1312.500n 0.0 1373.000n 0.0 1375.000n 5.0 1435.500n 5.0 1437.500n 0.0 1498.000n 0.0 1500.000n 5.0 1560.500n 5.0 1562.500n 0.0 1623.000n 0.0 1625.000n 5.0 1685.500n 5.0 1687.500n 0.0 1748.000n 0.0 1750.000n 5.0 1810.500n 5.0 1812.500n 0.0 1873.000n 0.0 1875.000n 5.0 1935.500n 5.0 1937.500n 0.0 1998.000n 0.0 2000.000n 5.0 2060.500n 5.0 2062.500n 0.0 2123.000n 0.0 2125.000n 5.0 2185.500n 5.0 2187.500n 0.0 2248.000n 0.0 2250.000n 5.0 2310.500n 5.0 2312.500n 0.0 2373.000n 0.0 2375.000n 5.0 2435.500n 5.0 2437.500n 0.0 2498.000n 0.0 2500.000n 5.0 2560.500n 5.0 2562.500n 0.0 2623.000n 0.0 2625.000n 5.0 2685.500n 5.0 2687.500n 0.0 2748.000n 0.0 2750.000n 5.0 2810.500n 5.0 2812.500n 0.0 2873.000n 0.0 2875.000n 5.0 2935.500n 5.0 2937.500n 0.0 2998.000n 0.0 3000.000n 5.0 3060.500n 5.0 3062.500n 0.0 3123.000n 0.0 3125.000n 5.0 3185.500n 5.0 3187.500n 0.0 3248.000n 0.0 3250.000n 5.0 3310.500n 5.0 3312.500n 0.0 3373.000n 0.0 3375.000n 5.0 3435.500n 5.0 3437.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
Vrom_d3 rom_d3 0 PWL(0.000n 0.0 391.750n 0.0 393.750n 0.0 510.500n 0.0 512.500n 0.0 629.250n 0.0 631.250n 0.0 1391.750n 0.0 1393.750n 5.0 1510.500n 5.0 1512.500n 0.0 1629.250n 0.0 1631.250n 0.0 2391.750n 0.0 2393.750n 5.0 2510.500n 5.0 2512.500n 0.0 2629.250n 0.0 2631.250n 0.0 3391.750n 0.0 3393.750n 5.0 3510.500n 5.0 3512.500n 0.0 3629.250n 0.0 3631.250n 0.0 4391.750n 0.0 4393.750n 5.0 4510.500n 5.0 4512.500n 0.0 4629.250n 0.0 4631.250n 0.0 5391.750n 0.0 5393.750n 5.0 5510.500n 5.0 5512.500n 0.0 5629.250n 0.0 5631.250n 0.0 6391.750n 0.0 6393.750n 5.0 6510.500n 5.0 6512.500n 0.0 6629.250n 0.0 6631.250n 0.0)
Bd0 P6 0 I = V(drv_en) * (V(P6) - V(rom_d0)) / 50.0
Bd1 P5 0 I = V(drv_en) * (V(P5) - V(rom_d1)) / 50.0
Bd2 P4 0 I = V(drv_en) * (V(P4) - V(rom_d2)) / 50.0
Bd3 P3 0 I = V(drv_en) * (V(P3) - V(rom_d3)) / 50.0

.tran 1.250n 7000.000n
.meas tran pc6_l_d0 FIND v(P6) AT=6112.500n
.meas tran pc6_l_d1 FIND v(P5) AT=6112.500n
.meas tran pc6_l_d2 FIND v(P4) AT=6112.500n
.meas tran pc6_l_d3 FIND v(P3) AT=6112.500n
.meas tran pc6_l_doe FIND v(P9) AT=6112.500n
.meas tran pc6_m_d0 FIND v(P6) AT=6237.500n
.meas tran pc6_m_d1 FIND v(P5) AT=6237.500n
.meas tran pc6_m_d2 FIND v(P4) AT=6237.500n
.meas tran pc6_m_d3 FIND v(P3) AT=6237.500n
.meas tran pc6_m_doe FIND v(P9) AT=6237.500n
.meas tran pc6_h_d0 FIND v(P6) AT=6362.500n
.meas tran pc6_h_d1 FIND v(P5) AT=6362.500n
.meas tran pc6_h_d2 FIND v(P4) AT=6362.500n
.meas tran pc6_h_d3 FIND v(P3) AT=6362.500n
.meas tran pc6_h_doe FIND v(P9) AT=6362.500n
.meas tran final_acc_d0 FIND v(P6) AT=6862.500n
.meas tran final_acc_d1 FIND v(P5) AT=6862.500n
.meas tran final_acc_d2 FIND v(P4) AT=6862.500n
.meas tran final_acc_d3 FIND v(P3) AT=6862.500n
.meas tran final_acc_doe FIND v(P9) AT=6862.500n
.meas tran tpd_sync TRIG v(P1) VAL=2.5 RISE=1 TD=850.000n TARG v(P2) VAL=2.5 RISE=1 TD=850.000n
.meas tran tpd_cmrom TRIG v(P1) VAL=2.5 RISE=1 TD=225.000n TARG v(P15) VAL=2.5 FALL=1 TD=225.000n
.meas tran tpd_cmram0 TRIG v(P1) VAL=2.5 RISE=1 TD=225.000n TARG v(P11) VAL=2.5 FALL=1 TD=225.000n
.meas tran tpd_doe TRIG v(P1) VAL=2.5 RISE=1 TD=350.000n TARG v(P9) VAL=2.5 FALL=1 TD=350.000n
.meas tran tpd_dout0 TRIG v(P1) VAL=2.5 RISE=1 TD=975.000n TARG v(P6) VAL=2.5 RISE=1 TD=975.000n
.meas tran i_vdd_avg AVG i(VVDD) FROM=125.000n TO=7000.000n
.control
run
quit
.endc
.end
