jun1okamura/TR-1um_C4004_Clone2Build/TR-1um_C4004_01/apr/sim_test4_8p5MHz.sp

* Test 4: FMAX Sweep @ 8.5 MHz
.param vthMP=0 vthMN=0 vthMPE=0 vthMNE=0 magRR=1 magRS=1 magCSIO=1
.include "../TR-1um/libs.tech/spice/models/models_IP62_cap_v5p1.lib"
.include "../TR-1um/libs.tech/spice/models/models_IP62_diode_v2.lib"
.include "../TR-1um/libs.tech/spice/models/models_IP62_mos_v2.lib"
.include "../TR-1um/libs.tech/spice/models/models_IP62_res_v5.lib"
.include "OSS_FRAME_sim.spice"

.options reltol=1e-3 abstol=1e-9 vntol=1e-3 method=gear

* Power supplies
VVDD VDD 0 5.0
VVSS VSS 0 0.0

* DUT: Full-chip extracted netlist OSS_FRAME
* Pin order: P1 P10 P11 P12 P13 P14 P15 P2 P3 P4 P5 P6 P7 P9 VDD VSS
Xchip P1 P10 P11 P12 P13 P14 P15 P2 P3 P4 P5 P6 P7 P9 VDD VSS OSS_FRAME

* 1.0 pF load capacitance on all 14 signal pads
CP1  P1  0 1.0p
CP2  P2  0 1.0p
CP3  P3  0 1.0p
CP4  P4  0 1.0p
CP5  P5  0 1.0p
CP6  P6  0 1.0p
CP7  P7  0 1.0p
CP9  P9  0 1.0p
CP10 P10 0 1.0p
CP11 P11 0 1.0p
CP12 P12 0 1.0p
CP13 P13 0 1.0p
CP14 P14 0 1.0p
CP15 P15 0 1.0p

* Input stimulus on P1 (clk), P7 (rst), P10 (test)
VP1  P1  0 PWL(0.000n 0.0 115.647n 0.0 117.647n 5.0 174.471n 5.0 176.471n 0.0 233.294n 0.0 235.294n 5.0 292.118n 5.0 294.118n 0.0 350.941n 0.0 352.941n 5.0 409.765n 5.0 411.765n 0.0 468.588n 0.0 470.588n 5.0 527.412n 5.0 529.412n 0.0 586.235n 0.0 588.235n 5.0 645.059n 5.0 647.059n 0.0 703.882n 0.0 705.882n 5.0 762.706n 5.0 764.706n 0.0 821.529n 0.0 823.529n 5.0 880.353n 5.0 882.353n 0.0 939.176n 0.0 941.176n 5.0 998.000n 5.0 1000.000n 0.0 1056.824n 0.0 1058.824n 5.0 1115.647n 5.0 1117.647n 0.0 1174.471n 0.0 1176.471n 5.0 1233.294n 5.0 1235.294n 0.0 1292.118n 0.0 1294.118n 5.0 1350.941n 5.0 1352.941n 0.0 1409.765n 0.0 1411.765n 5.0 1468.588n 5.0 1470.588n 0.0 1527.412n 0.0 1529.412n 5.0 1586.235n 5.0 1588.235n 0.0 1645.059n 0.0 1647.059n 5.0 1703.882n 5.0 1705.882n 0.0 1762.706n 0.0 1764.706n 5.0 1821.529n 5.0 1823.529n 0.0 1880.353n 0.0 1882.353n 5.0 1939.176n 5.0 1941.176n 0.0 1998.000n 0.0 2000.000n 5.0 2056.824n 5.0 2058.824n 0.0 2115.647n 0.0 2117.647n 5.0 2174.471n 5.0 2176.471n 0.0 2233.294n 0.0 2235.294n 5.0 2292.118n 5.0 2294.118n 0.0 2350.941n 0.0 2352.941n 5.0 2409.765n 5.0 2411.765n 0.0 2468.588n 0.0 2470.588n 5.0 2527.412n 5.0 2529.412n 0.0 2586.235n 0.0 2588.235n 5.0 2645.059n 5.0 2647.059n 0.0 2703.882n 0.0 2705.882n 5.0 2762.706n 5.0 2764.706n 0.0 2821.529n 0.0 2823.529n 5.0 2880.353n 5.0 2882.353n 0.0 2939.176n 0.0 2941.176n 5.0 2998.000n 5.0 3000.000n 0.0 3056.824n 0.0 3058.824n 5.0 3115.647n 5.0 3117.647n 0.0 3174.471n 0.0 3176.471n 5.0 3233.294n 5.0 3235.29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
Vrom_d3 rom_d3 0 PWL(0.000n 0.0 368.588n 0.0 370.588n 0.0 480.353n 0.0 482.353n 0.0 592.118n 0.0 594.118n 0.0 1309.765n 0.0 1311.765n 5.0 1421.529n 5.0 1423.529n 0.0 1533.294n 0.0 1535.294n 0.0 2250.941n 0.0 2252.941n 5.0 2362.706n 5.0 2364.706n 0.0 2474.471n 0.0 2476.471n 0.0 3192.118n 0.0 3194.118n 5.0 3303.882n 5.0 3305.882n 0.0 3415.647n 0.0 3417.647n 0.0 4133.294n 0.0 4135.294n 5.0 4245.059n 5.0 4247.059n 0.0 4356.824n 0.0 4358.824n 0.0 5074.471n 0.0 5076.471n 5.0 5186.235n 5.0 5188.235n 0.0 5298.000n 0.0 5300.000n 0.0 6015.647n 0.0 6017.647n 5.0 6127.412n 5.0 6129.412n 0.0 6239.176n 0.0 6241.176n 0.0)
Bd0 P6 0 I = V(drv_en) * (V(P6) - V(rom_d0)) / 50.0
Bd1 P5 0 I = V(drv_en) * (V(P5) - V(rom_d1)) / 50.0
Bd2 P4 0 I = V(drv_en) * (V(P4) - V(rom_d2)) / 50.0
Bd3 P3 0 I = V(drv_en) * (V(P3) - V(rom_d3)) / 50.0

.tran 1.176n 6588.235n
.meas tran pc6_l_d0 FIND v(P6) AT=5752.941n
.meas tran pc6_l_d1 FIND v(P5) AT=5752.941n
.meas tran pc6_l_d2 FIND v(P4) AT=5752.941n
.meas tran pc6_l_d3 FIND v(P3) AT=5752.941n
.meas tran pc6_l_doe FIND v(P9) AT=5752.941n
.meas tran pc6_m_d0 FIND v(P6) AT=5870.588n
.meas tran pc6_m_d1 FIND v(P5) AT=5870.588n
.meas tran pc6_m_d2 FIND v(P4) AT=5870.588n
.meas tran pc6_m_d3 FIND v(P3) AT=5870.588n
.meas tran pc6_m_doe FIND v(P9) AT=5870.588n
.meas tran pc6_h_d0 FIND v(P6) AT=5988.235n
.meas tran pc6_h_d1 FIND v(P5) AT=5988.235n
.meas tran pc6_h_d2 FIND v(P4) AT=5988.235n
.meas tran pc6_h_d3 FIND v(P3) AT=5988.235n
.meas tran pc6_h_doe FIND v(P9) AT=5988.235n
.meas tran final_acc_d0 FIND v(P6) AT=6458.824n
.meas tran final_acc_d1 FIND v(P5) AT=6458.824n
.meas tran final_acc_d2 FIND v(P4) AT=6458.824n
.meas tran final_acc_d3 FIND v(P3) AT=6458.824n
.meas tran final_acc_doe FIND v(P9) AT=6458.824n
.meas tran tpd_sync TRIG v(P1) VAL=2.5 RISE=1 TD=800.000n TARG v(P2) VAL=2.5 RISE=1 TD=800.000n
.meas tran tpd_cmrom TRIG v(P1) VAL=2.5 RISE=1 TD=211.765n TARG v(P15) VAL=2.5 FALL=1 TD=211.765n
.meas tran tpd_cmram0 TRIG v(P1) VAL=2.5 RISE=1 TD=211.765n TARG v(P11) VAL=2.5 FALL=1 TD=211.765n
.meas tran tpd_doe TRIG v(P1) VAL=2.5 RISE=1 TD=329.412n TARG v(P9) VAL=2.5 FALL=1 TD=329.412n
.meas tran tpd_dout0 TRIG v(P1) VAL=2.5 RISE=1 TD=917.647n TARG v(P6) VAL=2.5 RISE=1 TD=917.647n
.meas tran i_vdd_avg AVG i(VVDD) FROM=117.647n TO=6588.235n
.control
run
quit
.endc
.end
