jun1okamura/TR-1um_C4004_Clone2Build/TR-1um_C4004_01/apr/sim_test4_9MHz.sp

* Test 4: FMAX Sweep @ 9.0 MHz
.param vthMP=0 vthMN=0 vthMPE=0 vthMNE=0 magRR=1 magRS=1 magCSIO=1
.include "../TR-1um/libs.tech/spice/models/models_IP62_cap_v5p1.lib"
.include "../TR-1um/libs.tech/spice/models/models_IP62_diode_v2.lib"
.include "../TR-1um/libs.tech/spice/models/models_IP62_mos_v2.lib"
.include "../TR-1um/libs.tech/spice/models/models_IP62_res_v5.lib"
.include "OSS_FRAME_sim.spice"

.options reltol=1e-3 abstol=1e-9 vntol=1e-3 method=gear

* Power supplies
VVDD VDD 0 5.0
VVSS VSS 0 0.0

* DUT: Full-chip extracted netlist OSS_FRAME
* Pin order: P1 P10 P11 P12 P13 P14 P15 P2 P3 P4 P5 P6 P7 P9 VDD VSS
Xchip P1 P10 P11 P12 P13 P14 P15 P2 P3 P4 P5 P6 P7 P9 VDD VSS OSS_FRAME

* 1.0 pF load capacitance on all 14 signal pads
CP1  P1  0 1.0p
CP2  P2  0 1.0p
CP3  P3  0 1.0p
CP4  P4  0 1.0p
CP5  P5  0 1.0p
CP6  P6  0 1.0p
CP7  P7  0 1.0p
CP9  P9  0 1.0p
CP10 P10 0 1.0p
CP11 P11 0 1.0p
CP12 P12 0 1.0p
CP13 P13 0 1.0p
CP14 P14 0 1.0p
CP15 P15 0 1.0p

* Input stimulus on P1 (clk), P7 (rst), P10 (test)
VP1  P1  0 PWL(0.000n 0.0 109.111n 0.0 111.111n 5.0 164.667n 5.0 166.667n 0.0 220.222n 0.0 222.222n 5.0 275.778n 5.0 277.778n 0.0 331.333n 0.0 333.333n 5.0 386.889n 5.0 388.889n 0.0 442.444n 0.0 444.444n 5.0 498.000n 5.0 500.000n 0.0 553.556n 0.0 555.556n 5.0 609.111n 5.0 611.111n 0.0 664.667n 0.0 666.667n 5.0 720.222n 5.0 722.222n 0.0 775.778n 0.0 777.778n 5.0 831.333n 5.0 833.333n 0.0 886.889n 0.0 888.889n 5.0 942.444n 5.0 944.444n 0.0 998.000n 0.0 1000.000n 5.0 1053.556n 5.0 1055.556n 0.0 1109.111n 0.0 1111.111n 5.0 1164.667n 5.0 1166.667n 0.0 1220.222n 0.0 1222.222n 5.0 1275.778n 5.0 1277.778n 0.0 1331.333n 0.0 1333.333n 5.0 1386.889n 5.0 1388.889n 0.0 1442.444n 0.0 1444.444n 5.0 1498.000n 5.0 1500.000n 0.0 1553.556n 0.0 1555.556n 5.0 1609.111n 5.0 1611.111n 0.0 1664.667n 0.0 1666.667n 5.0 1720.222n 5.0 1722.222n 0.0 1775.778n 0.0 1777.778n 5.0 1831.333n 5.0 1833.333n 0.0 1886.889n 0.0 1888.889n 5.0 1942.444n 5.0 1944.444n 0.0 1998.000n 0.0 2000.000n 5.0 2053.556n 5.0 2055.556n 0.0 2109.111n 0.0 2111.111n 5.0 2164.667n 5.0 2166.667n 0.0 2220.222n 0.0 2222.222n 5.0 2275.778n 5.0 2277.778n 0.0 2331.333n 0.0 2333.333n 5.0 2386.889n 5.0 2388.889n 0.0 2442.444n 0.0 2444.444n 5.0 2498.000n 5.0 2500.000n 0.0 2553.556n 0.0 2555.556n 5.0 2609.111n 5.0 2611.111n 0.0 2664.667n 0.0 2666.667n 5.0 2720.222n 5.0 2722.222n 0.0 2775.778n 0.0 2777.778n 5.0 2831.333n 5.0 2833.333n 0.0 2886.889n 0.0 2888.889n 5.0 2942.444n 5.0 2944.444n 0.0 2998.000n 0.0 3000.000n 5.0 3053.556n 5.0 3055.556n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
Vrom_d3 rom_d3 0 PWL(0.000n 0.0 348.000n 0.0 350.000n 0.0 453.556n 0.0 455.556n 0.0 559.111n 0.0 561.111n 0.0 1236.889n 0.0 1238.889n 5.0 1342.444n 5.0 1344.444n 0.0 1448.000n 0.0 1450.000n 0.0 2125.778n 0.0 2127.778n 5.0 2231.333n 5.0 2233.333n 0.0 2336.889n 0.0 2338.889n 0.0 3014.667n 0.0 3016.667n 5.0 3120.222n 5.0 3122.222n 0.0 3225.778n 0.0 3227.778n 0.0 3903.556n 0.0 3905.556n 5.0 4009.111n 5.0 4011.111n 0.0 4114.667n 0.0 4116.667n 0.0 4792.444n 0.0 4794.444n 5.0 4898.000n 5.0 4900.000n 0.0 5003.556n 0.0 5005.556n 0.0 5681.333n 0.0 5683.333n 5.0 5786.889n 5.0 5788.889n 0.0 5892.444n 0.0 5894.444n 0.0)
Bd0 P6 0 I = V(drv_en) * (V(P6) - V(rom_d0)) / 50.0
Bd1 P5 0 I = V(drv_en) * (V(P5) - V(rom_d1)) / 50.0
Bd2 P4 0 I = V(drv_en) * (V(P4) - V(rom_d2)) / 50.0
Bd3 P3 0 I = V(drv_en) * (V(P3) - V(rom_d3)) / 50.0

.tran 1.111n 6222.222n
.meas tran pc6_l_d0 FIND v(P6) AT=5433.333n
.meas tran pc6_l_d1 FIND v(P5) AT=5433.333n
.meas tran pc6_l_d2 FIND v(P4) AT=5433.333n
.meas tran pc6_l_d3 FIND v(P3) AT=5433.333n
.meas tran pc6_l_doe FIND v(P9) AT=5433.333n
.meas tran pc6_m_d0 FIND v(P6) AT=5544.444n
.meas tran pc6_m_d1 FIND v(P5) AT=5544.444n
.meas tran pc6_m_d2 FIND v(P4) AT=5544.444n
.meas tran pc6_m_d3 FIND v(P3) AT=5544.444n
.meas tran pc6_m_doe FIND v(P9) AT=5544.444n
.meas tran pc6_h_d0 FIND v(P6) AT=5655.556n
.meas tran pc6_h_d1 FIND v(P5) AT=5655.556n
.meas tran pc6_h_d2 FIND v(P4) AT=5655.556n
.meas tran pc6_h_d3 FIND v(P3) AT=5655.556n
.meas tran pc6_h_doe FIND v(P9) AT=5655.556n
.meas tran final_acc_d0 FIND v(P6) AT=6100.000n
.meas tran final_acc_d1 FIND v(P5) AT=6100.000n
.meas tran final_acc_d2 FIND v(P4) AT=6100.000n
.meas tran final_acc_d3 FIND v(P3) AT=6100.000n
.meas tran final_acc_doe FIND v(P9) AT=6100.000n
.meas tran tpd_sync TRIG v(P1) VAL=2.5 RISE=1 TD=755.556n TARG v(P2) VAL=2.5 RISE=1 TD=755.556n
.meas tran tpd_cmrom TRIG v(P1) VAL=2.5 RISE=1 TD=200.000n TARG v(P15) VAL=2.5 FALL=1 TD=200.000n
.meas tran tpd_cmram0 TRIG v(P1) VAL=2.5 RISE=1 TD=200.000n TARG v(P11) VAL=2.5 FALL=1 TD=200.000n
.meas tran tpd_doe TRIG v(P1) VAL=2.5 RISE=1 TD=311.111n TARG v(P9) VAL=2.5 FALL=1 TD=311.111n
.meas tran tpd_dout0 TRIG v(P1) VAL=2.5 RISE=1 TD=866.667n TARG v(P6) VAL=2.5 RISE=1 TD=866.667n
.meas tran i_vdd_avg AVG i(VVDD) FROM=111.111n TO=6222.222n
.control
run
quit
.endc
.end
