jun1okamura/TR-1um_C4004_Clone2Build/TR-1um_C4004_01/apr/sim_test4_9p5MHz.sp

* Test 4: FMAX Sweep @ 9.5 MHz
.param vthMP=0 vthMN=0 vthMPE=0 vthMNE=0 magRR=1 magRS=1 magCSIO=1
.include "../TR-1um/libs.tech/spice/models/models_IP62_cap_v5p1.lib"
.include "../TR-1um/libs.tech/spice/models/models_IP62_diode_v2.lib"
.include "../TR-1um/libs.tech/spice/models/models_IP62_mos_v2.lib"
.include "../TR-1um/libs.tech/spice/models/models_IP62_res_v5.lib"
.include "OSS_FRAME_sim.spice"

.options reltol=1e-3 abstol=1e-9 vntol=1e-3 method=gear

* Power supplies
VVDD VDD 0 5.0
VVSS VSS 0 0.0

* DUT: Full-chip extracted netlist OSS_FRAME
* Pin order: P1 P10 P11 P12 P13 P14 P15 P2 P3 P4 P5 P6 P7 P9 VDD VSS
Xchip P1 P10 P11 P12 P13 P14 P15 P2 P3 P4 P5 P6 P7 P9 VDD VSS OSS_FRAME

* 1.0 pF load capacitance on all 14 signal pads
CP1  P1  0 1.0p
CP2  P2  0 1.0p
CP3  P3  0 1.0p
CP4  P4  0 1.0p
CP5  P5  0 1.0p
CP6  P6  0 1.0p
CP7  P7  0 1.0p
CP9  P9  0 1.0p
CP10 P10 0 1.0p
CP11 P11 0 1.0p
CP12 P12 0 1.0p
CP13 P13 0 1.0p
CP14 P14 0 1.0p
CP15 P15 0 1.0p

* Input stimulus on P1 (clk), P7 (rst), P10 (test)
VP1  P1  0 PWL(0.000n 0.0 103.263n 0.0 105.263n 5.0 155.895n 5.0 157.895n 0.0 208.526n 0.0 210.526n 5.0 261.158n 5.0 263.158n 0.0 313.789n 0.0 315.789n 5.0 366.421n 5.0 368.421n 0.0 419.053n 0.0 421.053n 5.0 471.684n 5.0 473.684n 0.0 524.316n 0.0 526.316n 5.0 576.947n 5.0 578.947n 0.0 629.579n 0.0 631.579n 5.0 682.211n 5.0 684.211n 0.0 734.842n 0.0 736.842n 5.0 787.474n 5.0 789.474n 0.0 840.105n 0.0 842.105n 5.0 892.737n 5.0 894.737n 0.0 945.368n 0.0 947.368n 5.0 998.000n 5.0 1000.000n 0.0 1050.632n 0.0 1052.632n 5.0 1103.263n 5.0 1105.263n 0.0 1155.895n 0.0 1157.895n 5.0 1208.526n 5.0 1210.526n 0.0 1261.158n 0.0 1263.158n 5.0 1313.789n 5.0 1315.789n 0.0 1366.421n 0.0 1368.421n 5.0 1419.053n 5.0 1421.053n 0.0 1471.684n 0.0 1473.684n 5.0 1524.316n 5.0 1526.316n 0.0 1576.947n 0.0 1578.947n 5.0 1629.579n 5.0 1631.579n 0.0 1682.211n 0.0 1684.211n 5.0 1734.842n 5.0 1736.842n 0.0 1787.474n 0.0 1789.474n 5.0 1840.105n 5.0 1842.105n 0.0 1892.737n 0.0 1894.737n 5.0 1945.368n 5.0 1947.368n 0.0 1998.000n 0.0 2000.000n 5.0 2050.632n 5.0 2052.632n 0.0 2103.263n 0.0 2105.263n 5.0 2155.895n 5.0 2157.895n 0.0 2208.526n 0.0 2210.526n 5.0 2261.158n 5.0 2263.158n 0.0 2313.789n 0.0 2315.789n 5.0 2366.421n 5.0 2368.421n 0.0 2419.053n 0.0 2421.053n 5.0 2471.684n 5.0 2473.684n 0.0 2524.316n 0.0 2526.316n 5.0 2576.947n 5.0 2578.947n 0.0 2629.579n 0.0 2631.579n 5.0 2682.211n 5.0 2684.211n 0.0 2734.842n 0.0 2736.842n 5.0 2787.474n 5.0 2789.474n 0.0 2840.105n 0.0 2842.105n 5.0 2892.737n 5.0 2894.737n 0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
Vrom_d3 rom_d3 0 PWL(0.000n 0.0 329.579n 0.0 331.579n 0.0 429.579n 0.0 431.579n 0.0 529.579n 0.0 531.579n 0.0 1171.684n 0.0 1173.684n 5.0 1271.684n 5.0 1273.684n 0.0 1371.684n 0.0 1373.684n 0.0 2013.789n 0.0 2015.789n 5.0 2113.789n 5.0 2115.789n 0.0 2213.789n 0.0 2215.789n 0.0 2855.895n 0.0 2857.895n 5.0 2955.895n 5.0 2957.895n 0.0 3055.895n 0.0 3057.895n 0.0 3698.000n 0.0 3700.000n 5.0 3798.000n 5.0 3800.000n 0.0 3898.000n 0.0 3900.000n 0.0 4540.105n 0.0 4542.105n 5.0 4640.105n 5.0 4642.105n 0.0 4740.105n 0.0 4742.105n 0.0 5382.211n 0.0 5384.211n 5.0 5482.211n 5.0 5484.211n 0.0 5582.211n 0.0 5584.211n 0.0)
Bd0 P6 0 I = V(drv_en) * (V(P6) - V(rom_d0)) / 50.0
Bd1 P5 0 I = V(drv_en) * (V(P5) - V(rom_d1)) / 50.0
Bd2 P4 0 I = V(drv_en) * (V(P4) - V(rom_d2)) / 50.0
Bd3 P3 0 I = V(drv_en) * (V(P3) - V(rom_d3)) / 50.0

.tran 1.053n 5894.737n
.meas tran pc6_l_d0 FIND v(P6) AT=5147.368n
.meas tran pc6_l_d1 FIND v(P5) AT=5147.368n
.meas tran pc6_l_d2 FIND v(P4) AT=5147.368n
.meas tran pc6_l_d3 FIND v(P3) AT=5147.368n
.meas tran pc6_l_doe FIND v(P9) AT=5147.368n
.meas tran pc6_m_d0 FIND v(P6) AT=5252.632n
.meas tran pc6_m_d1 FIND v(P5) AT=5252.632n
.meas tran pc6_m_d2 FIND v(P4) AT=5252.632n
.meas tran pc6_m_d3 FIND v(P3) AT=5252.632n
.meas tran pc6_m_doe FIND v(P9) AT=5252.632n
.meas tran pc6_h_d0 FIND v(P6) AT=5357.895n
.meas tran pc6_h_d1 FIND v(P5) AT=5357.895n
.meas tran pc6_h_d2 FIND v(P4) AT=5357.895n
.meas tran pc6_h_d3 FIND v(P3) AT=5357.895n
.meas tran pc6_h_doe FIND v(P9) AT=5357.895n
.meas tran final_acc_d0 FIND v(P6) AT=5778.947n
.meas tran final_acc_d1 FIND v(P5) AT=5778.947n
.meas tran final_acc_d2 FIND v(P4) AT=5778.947n
.meas tran final_acc_d3 FIND v(P3) AT=5778.947n
.meas tran final_acc_doe FIND v(P9) AT=5778.947n
.meas tran tpd_sync TRIG v(P1) VAL=2.5 RISE=1 TD=715.789n TARG v(P2) VAL=2.5 RISE=1 TD=715.789n
.meas tran tpd_cmrom TRIG v(P1) VAL=2.5 RISE=1 TD=189.474n TARG v(P15) VAL=2.5 FALL=1 TD=189.474n
.meas tran tpd_cmram0 TRIG v(P1) VAL=2.5 RISE=1 TD=189.474n TARG v(P11) VAL=2.5 FALL=1 TD=189.474n
.meas tran tpd_doe TRIG v(P1) VAL=2.5 RISE=1 TD=294.737n TARG v(P9) VAL=2.5 FALL=1 TD=294.737n
.meas tran tpd_dout0 TRIG v(P1) VAL=2.5 RISE=1 TD=821.053n TARG v(P6) VAL=2.5 RISE=1 TD=821.053n
.meas tran i_vdd_avg AVG i(VVDD) FROM=105.263n TO=5894.737n
.control
run
quit
.endc
.end
