jun1okamura/TR-1um_C4004_Clone2Build/TR-1um_C4004_02/apr/sim_test4_10p5MHz.sp

* Test 4: FMAX Sweep @ 10.5 MHz
.param vthMP=0 vthMN=0 vthMPE=0 vthMNE=0 magRR=1 magRS=1 magCSIO=1
.include "../TR-1um/libs.tech/spice/models/models_IP62_cap_v5p1.lib"
.include "../TR-1um/libs.tech/spice/models/models_IP62_diode_v2.lib"
.include "../TR-1um/libs.tech/spice/models/models_IP62_mos_v2.lib"
.include "../TR-1um/libs.tech/spice/models/models_IP62_res_v5.lib"
.include "OSS_FRAME_sim.spice"

.options reltol=1e-3 abstol=1e-9 vntol=1e-3 method=gear

* Power supplies
VVDD VDD 0 5.0
VVSS VSS 0 0.0

* DUT: Full-chip extracted netlist OSS_FRAME
* Pin order: P1 P10 P11 P12 P13 P14 P15 P2 P3 P4 P5 P6 P7 P9 VDD VSS
Xchip P1 P10 P11 P12 P13 P14 P15 P2 P3 P4 P5 P6 P7 P9 VDD VSS OSS_FRAME

* 1.0 pF load capacitance on all 14 signal pads
CP1  P1  0 1.0p
CP2  P2  0 1.0p
CP3  P3  0 1.0p
CP4  P4  0 1.0p
CP5  P5  0 1.0p
CP6  P6  0 1.0p
CP7  P7  0 1.0p
CP9  P9  0 1.0p
CP10 P10 0 1.0p
CP11 P11 0 1.0p
CP12 P12 0 1.0p
CP13 P13 0 1.0p
CP14 P14 0 1.0p
CP15 P15 0 1.0p

* Input stimulus on P1 (clk), P7 (rst), P10 (test)
VP1  P1  0 PWL(0.000n 0.0 93.333n 0.0 95.238n 5.0 140.952n 5.0 142.857n 0.0 188.571n 0.0 190.476n 5.0 236.190n 5.0 238.095n 0.0 283.810n 0.0 285.714n 5.0 331.429n 5.0 333.333n 0.0 379.048n 0.0 380.952n 5.0 426.667n 5.0 428.571n 0.0 474.286n 0.0 476.190n 5.0 521.905n 5.0 523.810n 0.0 569.524n 0.0 571.429n 5.0 617.143n 5.0 619.048n 0.0 664.762n 0.0 666.667n 5.0 712.381n 5.0 714.286n 0.0 760.000n 0.0 761.905n 5.0 807.619n 5.0 809.524n 0.0 855.238n 0.0 857.143n 5.0 902.857n 5.0 904.762n 0.0 950.476n 0.0 952.381n 5.0 998.095n 5.0 1000.000n 0.0 1045.714n 0.0 1047.619n 5.0 1093.333n 5.0 1095.238n 0.0 1140.952n 0.0 1142.857n 5.0 1188.571n 5.0 1190.476n 0.0 1236.190n 0.0 1238.095n 5.0 1283.810n 5.0 1285.714n 0.0 1331.429n 0.0 1333.333n 5.0 1379.048n 5.0 1380.952n 0.0 1426.667n 0.0 1428.571n 5.0 1474.286n 5.0 1476.190n 0.0 1521.905n 0.0 1523.810n 5.0 1569.524n 5.0 1571.429n 0.0 1617.143n 0.0 1619.048n 5.0 1664.762n 5.0 1666.667n 0.0 1712.381n 0.0 1714.286n 5.0 1760.000n 5.0 1761.905n 0.0 1807.619n 0.0 1809.524n 5.0 1855.238n 5.0 1857.143n 0.0 1902.857n 0.0 1904.762n 5.0 1950.476n 5.0 1952.381n 0.0 1998.095n 0.0 2000.000n 5.0 2045.714n 5.0 2047.619n 0.0 2093.333n 0.0 2095.238n 5.0 2140.952n 5.0 2142.857n 0.0 2188.571n 0.0 2190.476n 5.0 2236.190n 5.0 2238.095n 0.0 2283.810n 0.0 2285.714n 5.0 2331.429n 5.0 2333.333n 0.0 2379.048n 0.0 2380.952n 5.0 2426.667n 5.0 2428.571n 0.0 2474.286n 0.0 2476.190n 5.0 2521.905n 5.0 2523.810n 0.0 2569.524n 0.0 2571.429n 5.0 2617.143n 5.0 2619.048n 0.0 266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
Vrom_d3 rom_d3 0 PWL(0.000n 0.0 298.095n 0.0 300.000n 0.0 388.571n 0.0 390.476n 0.0 479.048n 0.0 480.952n 0.0 1060.000n 0.0 1061.905n 5.0 1150.476n 5.0 1152.381n 0.0 1240.952n 0.0 1242.857n 0.0 1821.905n 0.0 1823.810n 5.0 1912.381n 5.0 1914.286n 0.0 2002.857n 0.0 2004.762n 0.0 2583.810n 0.0 2585.714n 5.0 2674.286n 5.0 2676.190n 0.0 2764.762n 0.0 2766.667n 0.0 3345.714n 0.0 3347.619n 5.0 3436.190n 5.0 3438.095n 0.0 3526.667n 0.0 3528.571n 0.0 4107.619n 0.0 4109.524n 5.0 4198.095n 5.0 4200.000n 0.0 4288.571n 0.0 4290.476n 0.0 4869.524n 0.0 4871.429n 5.0 4960.000n 5.0 4961.905n 0.0 5050.476n 0.0 5052.381n 0.0)
Bd0 P6 0 I = V(drv_en) * (V(P6) - V(rom_d0)) / 50.0
Bd1 P5 0 I = V(drv_en) * (V(P5) - V(rom_d1)) / 50.0
Bd2 P4 0 I = V(drv_en) * (V(P4) - V(rom_d2)) / 50.0
Bd3 P3 0 I = V(drv_en) * (V(P3) - V(rom_d3)) / 50.0

.tran 0.952n 5333.333n
.meas tran pc6_l_d0 FIND v(P6) AT=4657.143n
.meas tran pc6_l_d1 FIND v(P5) AT=4657.143n
.meas tran pc6_l_d2 FIND v(P4) AT=4657.143n
.meas tran pc6_l_d3 FIND v(P3) AT=4657.143n
.meas tran pc6_l_doe FIND v(P9) AT=4657.143n
.meas tran pc6_m_d0 FIND v(P6) AT=4752.381n
.meas tran pc6_m_d1 FIND v(P5) AT=4752.381n
.meas tran pc6_m_d2 FIND v(P4) AT=4752.381n
.meas tran pc6_m_d3 FIND v(P3) AT=4752.381n
.meas tran pc6_m_doe FIND v(P9) AT=4752.381n
.meas tran pc6_h_d0 FIND v(P6) AT=4847.619n
.meas tran pc6_h_d1 FIND v(P5) AT=4847.619n
.meas tran pc6_h_d2 FIND v(P4) AT=4847.619n
.meas tran pc6_h_d3 FIND v(P3) AT=4847.619n
.meas tran pc6_h_doe FIND v(P9) AT=4847.619n
.meas tran final_acc_d0 FIND v(P6) AT=5228.571n
.meas tran final_acc_d1 FIND v(P5) AT=5228.571n
.meas tran final_acc_d2 FIND v(P4) AT=5228.571n
.meas tran final_acc_d3 FIND v(P3) AT=5228.571n
.meas tran final_acc_doe FIND v(P9) AT=5228.571n
.meas tran tpd_sync TRIG v(P1) VAL=2.5 RISE=1 TD=647.619n TARG v(P2) VAL=2.5 RISE=1 TD=647.619n
.meas tran tpd_cmrom TRIG v(P1) VAL=2.5 RISE=1 TD=171.429n TARG v(P15) VAL=2.5 FALL=1 TD=171.429n
.meas tran tpd_cmram0 TRIG v(P1) VAL=2.5 RISE=1 TD=171.429n TARG v(P11) VAL=2.5 FALL=1 TD=171.429n
.meas tran tpd_doe TRIG v(P1) VAL=2.5 RISE=1 TD=266.667n TARG v(P9) VAL=2.5 FALL=1 TD=266.667n
.meas tran tpd_dout0 TRIG v(P1) VAL=2.5 RISE=1 TD=742.857n TARG v(P6) VAL=2.5 RISE=1 TD=742.857n
.meas tran i_vdd_avg AVG i(VVDD) FROM=95.238n TO=5333.333n
.control
run
quit
.endc
.end
