jun1okamura/TR-1um_C4004_Clone2Build/TR-1um_C4004_02/apr/sim_test4_11MHz.sp

* Test 4: FMAX Sweep @ 11.0 MHz
.param vthMP=0 vthMN=0 vthMPE=0 vthMNE=0 magRR=1 magRS=1 magCSIO=1
.include "../TR-1um/libs.tech/spice/models/models_IP62_cap_v5p1.lib"
.include "../TR-1um/libs.tech/spice/models/models_IP62_diode_v2.lib"
.include "../TR-1um/libs.tech/spice/models/models_IP62_mos_v2.lib"
.include "../TR-1um/libs.tech/spice/models/models_IP62_res_v5.lib"
.include "OSS_FRAME_sim.spice"

.options reltol=1e-3 abstol=1e-9 vntol=1e-3 method=gear

* Power supplies
VVDD VDD 0 5.0
VVSS VSS 0 0.0

* DUT: Full-chip extracted netlist OSS_FRAME
* Pin order: P1 P10 P11 P12 P13 P14 P15 P2 P3 P4 P5 P6 P7 P9 VDD VSS
Xchip P1 P10 P11 P12 P13 P14 P15 P2 P3 P4 P5 P6 P7 P9 VDD VSS OSS_FRAME

* 1.0 pF load capacitance on all 14 signal pads
CP1  P1  0 1.0p
CP2  P2  0 1.0p
CP3  P3  0 1.0p
CP4  P4  0 1.0p
CP5  P5  0 1.0p
CP6  P6  0 1.0p
CP7  P7  0 1.0p
CP9  P9  0 1.0p
CP10 P10 0 1.0p
CP11 P11 0 1.0p
CP12 P12 0 1.0p
CP13 P13 0 1.0p
CP14 P14 0 1.0p
CP15 P15 0 1.0p

* Input stimulus on P1 (clk), P7 (rst), P10 (test)
VP1  P1  0 PWL(0.000n 0.0 89.091n 0.0 90.909n 5.0 134.545n 5.0 136.364n 0.0 180.000n 0.0 181.818n 5.0 225.455n 5.0 227.273n 0.0 270.909n 0.0 272.727n 5.0 316.364n 5.0 318.182n 0.0 361.818n 0.0 363.636n 5.0 407.273n 5.0 409.091n 0.0 452.727n 0.0 454.545n 5.0 498.182n 5.0 500.000n 0.0 543.636n 0.0 545.455n 5.0 589.091n 5.0 590.909n 0.0 634.545n 0.0 636.364n 5.0 680.000n 5.0 681.818n 0.0 725.455n 0.0 727.273n 5.0 770.909n 5.0 772.727n 0.0 816.364n 0.0 818.182n 5.0 861.818n 5.0 863.636n 0.0 907.273n 0.0 909.091n 5.0 952.727n 5.0 954.545n 0.0 998.182n 0.0 1000.000n 5.0 1043.636n 5.0 1045.455n 0.0 1089.091n 0.0 1090.909n 5.0 1134.545n 5.0 1136.364n 0.0 1180.000n 0.0 1181.818n 5.0 1225.455n 5.0 1227.273n 0.0 1270.909n 0.0 1272.727n 5.0 1316.364n 5.0 1318.182n 0.0 1361.818n 0.0 1363.636n 5.0 1407.273n 5.0 1409.091n 0.0 1452.727n 0.0 1454.545n 5.0 1498.182n 5.0 1500.000n 0.0 1543.636n 0.0 1545.455n 5.0 1589.091n 5.0 1590.909n 0.0 1634.545n 0.0 1636.364n 5.0 1680.000n 5.0 1681.818n 0.0 1725.455n 0.0 1727.273n 5.0 1770.909n 5.0 1772.727n 0.0 1816.364n 0.0 1818.182n 5.0 1861.818n 5.0 1863.636n 0.0 1907.273n 0.0 1909.091n 5.0 1952.727n 5.0 1954.545n 0.0 1998.182n 0.0 2000.000n 5.0 2043.636n 5.0 2045.455n 0.0 2089.091n 0.0 2090.909n 5.0 2134.545n 5.0 2136.364n 0.0 2180.000n 0.0 2181.818n 5.0 2225.455n 5.0 2227.273n 0.0 2270.909n 0.0 2272.727n 5.0 2316.364n 5.0 2318.182n 0.0 2361.818n 0.0 2363.636n 5.0 2407.273n 5.0 2409.091n 0.0 2452.727n 0.0 2454.545n 5.0 2498.182n 5.0 2500.000n 0.0 2543.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
Vrom_d3 rom_d3 0 PWL(0.000n 0.0 284.545n 0.0 286.364n 0.0 370.909n 0.0 372.727n 0.0 457.273n 0.0 459.091n 0.0 1011.818n 0.0 1013.636n 5.0 1098.182n 5.0 1100.000n 0.0 1184.545n 0.0 1186.364n 0.0 1739.091n 0.0 1740.909n 5.0 1825.455n 5.0 1827.273n 0.0 1911.818n 0.0 1913.636n 0.0 2466.364n 0.0 2468.182n 5.0 2552.727n 5.0 2554.545n 0.0 2639.091n 0.0 2640.909n 0.0 3193.636n 0.0 3195.455n 5.0 3280.000n 5.0 3281.818n 0.0 3366.364n 0.0 3368.182n 0.0 3920.909n 0.0 3922.727n 5.0 4007.273n 5.0 4009.091n 0.0 4093.636n 0.0 4095.455n 0.0 4648.182n 0.0 4650.000n 5.0 4734.545n 5.0 4736.364n 0.0 4820.909n 0.0 4822.727n 0.0)
Bd0 P6 0 I = V(drv_en) * (V(P6) - V(rom_d0)) / 50.0
Bd1 P5 0 I = V(drv_en) * (V(P5) - V(rom_d1)) / 50.0
Bd2 P4 0 I = V(drv_en) * (V(P4) - V(rom_d2)) / 50.0
Bd3 P3 0 I = V(drv_en) * (V(P3) - V(rom_d3)) / 50.0

.tran 0.909n 5090.909n
.meas tran pc6_l_d0 FIND v(P6) AT=4445.455n
.meas tran pc6_l_d1 FIND v(P5) AT=4445.455n
.meas tran pc6_l_d2 FIND v(P4) AT=4445.455n
.meas tran pc6_l_d3 FIND v(P3) AT=4445.455n
.meas tran pc6_l_doe FIND v(P9) AT=4445.455n
.meas tran pc6_m_d0 FIND v(P6) AT=4536.364n
.meas tran pc6_m_d1 FIND v(P5) AT=4536.364n
.meas tran pc6_m_d2 FIND v(P4) AT=4536.364n
.meas tran pc6_m_d3 FIND v(P3) AT=4536.364n
.meas tran pc6_m_doe FIND v(P9) AT=4536.364n
.meas tran pc6_h_d0 FIND v(P6) AT=4627.273n
.meas tran pc6_h_d1 FIND v(P5) AT=4627.273n
.meas tran pc6_h_d2 FIND v(P4) AT=4627.273n
.meas tran pc6_h_d3 FIND v(P3) AT=4627.273n
.meas tran pc6_h_doe FIND v(P9) AT=4627.273n
.meas tran final_acc_d0 FIND v(P6) AT=4990.909n
.meas tran final_acc_d1 FIND v(P5) AT=4990.909n
.meas tran final_acc_d2 FIND v(P4) AT=4990.909n
.meas tran final_acc_d3 FIND v(P3) AT=4990.909n
.meas tran final_acc_doe FIND v(P9) AT=4990.909n
.meas tran tpd_sync TRIG v(P1) VAL=2.5 RISE=1 TD=618.182n TARG v(P2) VAL=2.5 RISE=1 TD=618.182n
.meas tran tpd_cmrom TRIG v(P1) VAL=2.5 RISE=1 TD=163.636n TARG v(P15) VAL=2.5 FALL=1 TD=163.636n
.meas tran tpd_cmram0 TRIG v(P1) VAL=2.5 RISE=1 TD=163.636n TARG v(P11) VAL=2.5 FALL=1 TD=163.636n
.meas tran tpd_doe TRIG v(P1) VAL=2.5 RISE=1 TD=254.545n TARG v(P9) VAL=2.5 FALL=1 TD=254.545n
.meas tran tpd_dout0 TRIG v(P1) VAL=2.5 RISE=1 TD=709.091n TARG v(P6) VAL=2.5 RISE=1 TD=709.091n
.meas tran i_vdd_avg AVG i(VVDD) FROM=90.909n TO=5090.909n
.control
run
quit
.endc
.end
