jun1okamura/TR-1um_C4004_Clone2Build/TR-1um_C4004_02/apr/sim_test4_11p5MHz.sp

* Test 4: FMAX Sweep @ 11.5 MHz
.param vthMP=0 vthMN=0 vthMPE=0 vthMNE=0 magRR=1 magRS=1 magCSIO=1
.include "../TR-1um/libs.tech/spice/models/models_IP62_cap_v5p1.lib"
.include "../TR-1um/libs.tech/spice/models/models_IP62_diode_v2.lib"
.include "../TR-1um/libs.tech/spice/models/models_IP62_mos_v2.lib"
.include "../TR-1um/libs.tech/spice/models/models_IP62_res_v5.lib"
.include "OSS_FRAME_sim.spice"

.options reltol=1e-3 abstol=1e-9 vntol=1e-3 method=gear

* Power supplies
VVDD VDD 0 5.0
VVSS VSS 0 0.0

* DUT: Full-chip extracted netlist OSS_FRAME
* Pin order: P1 P10 P11 P12 P13 P14 P15 P2 P3 P4 P5 P6 P7 P9 VDD VSS
Xchip P1 P10 P11 P12 P13 P14 P15 P2 P3 P4 P5 P6 P7 P9 VDD VSS OSS_FRAME

* 1.0 pF load capacitance on all 14 signal pads
CP1  P1  0 1.0p
CP2  P2  0 1.0p
CP3  P3  0 1.0p
CP4  P4  0 1.0p
CP5  P5  0 1.0p
CP6  P6  0 1.0p
CP7  P7  0 1.0p
CP9  P9  0 1.0p
CP10 P10 0 1.0p
CP11 P11 0 1.0p
CP12 P12 0 1.0p
CP13 P13 0 1.0p
CP14 P14 0 1.0p
CP15 P15 0 1.0p

* Input stimulus on P1 (clk), P7 (rst), P10 (test)
VP1  P1  0 PWL(0.000n 0.0 85.217n 0.0 86.957n 5.0 128.696n 5.0 130.435n 0.0 172.174n 0.0 173.913n 5.0 215.652n 5.0 217.391n 0.0 259.130n 0.0 260.870n 5.0 302.609n 5.0 304.348n 0.0 346.087n 0.0 347.826n 5.0 389.565n 5.0 391.304n 0.0 433.043n 0.0 434.783n 5.0 476.522n 5.0 478.261n 0.0 520.000n 0.0 521.739n 5.0 563.478n 5.0 565.217n 0.0 606.957n 0.0 608.696n 5.0 650.435n 5.0 652.174n 0.0 693.913n 0.0 695.652n 5.0 737.391n 5.0 739.130n 0.0 780.870n 0.0 782.609n 5.0 824.348n 5.0 826.087n 0.0 867.826n 0.0 869.565n 5.0 911.304n 5.0 913.043n 0.0 954.783n 0.0 956.522n 5.0 998.261n 5.0 1000.000n 0.0 1041.739n 0.0 1043.478n 5.0 1085.217n 5.0 1086.957n 0.0 1128.696n 0.0 1130.435n 5.0 1172.174n 5.0 1173.913n 0.0 1215.652n 0.0 1217.391n 5.0 1259.130n 5.0 1260.870n 0.0 1302.609n 0.0 1304.348n 5.0 1346.087n 5.0 1347.826n 0.0 1389.565n 0.0 1391.304n 5.0 1433.043n 5.0 1434.783n 0.0 1476.522n 0.0 1478.261n 5.0 1520.000n 5.0 1521.739n 0.0 1563.478n 0.0 1565.217n 5.0 1606.957n 5.0 1608.696n 0.0 1650.435n 0.0 1652.174n 5.0 1693.913n 5.0 1695.652n 0.0 1737.391n 0.0 1739.130n 5.0 1780.870n 5.0 1782.609n 0.0 1824.348n 0.0 1826.087n 5.0 1867.826n 5.0 1869.565n 0.0 1911.304n 0.0 1913.043n 5.0 1954.783n 5.0 1956.522n 0.0 1998.261n 0.0 2000.000n 5.0 2041.739n 5.0 2043.478n 0.0 2085.217n 0.0 2086.957n 5.0 2128.696n 5.0 2130.435n 0.0 2172.174n 0.0 2173.913n 5.0 2215.652n 5.0 2217.391n 0.0 2259.130n 0.0 2260.870n 5.0 2302.609n 5.0 2304.348n 0.0 2346.087n 0.0 2347.826n 5.0 2389.565n 5.0 2391.304n 0.0 2433.04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
Vrom_d3 rom_d3 0 PWL(0.000n 0.0 272.174n 0.0 273.913n 0.0 354.783n 0.0 356.522n 0.0 437.391n 0.0 439.130n 0.0 967.826n 0.0 969.565n 5.0 1050.435n 5.0 1052.174n 0.0 1133.043n 0.0 1134.783n 0.0 1663.478n 0.0 1665.217n 5.0 1746.087n 5.0 1747.826n 0.0 1828.696n 0.0 1830.435n 0.0 2359.130n 0.0 2360.870n 5.0 2441.739n 5.0 2443.478n 0.0 2524.348n 0.0 2526.087n 0.0 3054.783n 0.0 3056.522n 5.0 3137.391n 5.0 3139.130n 0.0 3220.000n 0.0 3221.739n 0.0 3750.435n 0.0 3752.174n 5.0 3833.043n 5.0 3834.783n 0.0 3915.652n 0.0 3917.391n 0.0 4446.087n 0.0 4447.826n 5.0 4528.696n 5.0 4530.435n 0.0 4611.304n 0.0 4613.043n 0.0)
Bd0 P6 0 I = V(drv_en) * (V(P6) - V(rom_d0)) / 50.0
Bd1 P5 0 I = V(drv_en) * (V(P5) - V(rom_d1)) / 50.0
Bd2 P4 0 I = V(drv_en) * (V(P4) - V(rom_d2)) / 50.0
Bd3 P3 0 I = V(drv_en) * (V(P3) - V(rom_d3)) / 50.0

.tran 0.870n 4869.565n
.meas tran pc6_l_d0 FIND v(P6) AT=4252.174n
.meas tran pc6_l_d1 FIND v(P5) AT=4252.174n
.meas tran pc6_l_d2 FIND v(P4) AT=4252.174n
.meas tran pc6_l_d3 FIND v(P3) AT=4252.174n
.meas tran pc6_l_doe FIND v(P9) AT=4252.174n
.meas tran pc6_m_d0 FIND v(P6) AT=4339.130n
.meas tran pc6_m_d1 FIND v(P5) AT=4339.130n
.meas tran pc6_m_d2 FIND v(P4) AT=4339.130n
.meas tran pc6_m_d3 FIND v(P3) AT=4339.130n
.meas tran pc6_m_doe FIND v(P9) AT=4339.130n
.meas tran pc6_h_d0 FIND v(P6) AT=4426.087n
.meas tran pc6_h_d1 FIND v(P5) AT=4426.087n
.meas tran pc6_h_d2 FIND v(P4) AT=4426.087n
.meas tran pc6_h_d3 FIND v(P3) AT=4426.087n
.meas tran pc6_h_doe FIND v(P9) AT=4426.087n
.meas tran final_acc_d0 FIND v(P6) AT=4773.913n
.meas tran final_acc_d1 FIND v(P5) AT=4773.913n
.meas tran final_acc_d2 FIND v(P4) AT=4773.913n
.meas tran final_acc_d3 FIND v(P3) AT=4773.913n
.meas tran final_acc_doe FIND v(P9) AT=4773.913n
.meas tran tpd_sync TRIG v(P1) VAL=2.5 RISE=1 TD=591.304n TARG v(P2) VAL=2.5 RISE=1 TD=591.304n
.meas tran tpd_cmrom TRIG v(P1) VAL=2.5 RISE=1 TD=156.522n TARG v(P15) VAL=2.5 FALL=1 TD=156.522n
.meas tran tpd_cmram0 TRIG v(P1) VAL=2.5 RISE=1 TD=156.522n TARG v(P11) VAL=2.5 FALL=1 TD=156.522n
.meas tran tpd_doe TRIG v(P1) VAL=2.5 RISE=1 TD=243.478n TARG v(P9) VAL=2.5 FALL=1 TD=243.478n
.meas tran tpd_dout0 TRIG v(P1) VAL=2.5 RISE=1 TD=678.261n TARG v(P6) VAL=2.5 RISE=1 TD=678.261n
.meas tran i_vdd_avg AVG i(VVDD) FROM=86.957n TO=4869.565n
.control
run
quit
.endc
.end
