jun1okamura/TR-1um_C4004_Clone2Build/TR-1um_C4004_01/openroad/c4004_core_syn.v

// Synthesized and Buffered Gate-Level Netlist for c4004_core
module c4004_core (
  clk,
  rst,
  test,
  d_in,
  d_out,
  d_oe,
  d_hiz,
  sync,
  cm_rom,
  cm_ram
);
  input clk;
  input rst;
  input test;
  input [3:0] d_in;
  output [3:0] d_out;
  output d_oe;
  output d_hiz;
  output sync;
  output cm_rom;
  output [3:0] cm_ram;

  wire [3:0] sram_din;
  wire [3:0] sram_do;
  wire _0000_;
  wire _0001_;
  wire _0002_;
  wire _0003_;
  wire _0004_;
  wire _0005_;
  wire _0006_;
  wire _0007_;
  wire _0008_;
  wire _0009_;
  wire _0010_;
  wire _0011_;
  wire _0012_;
  wire _0013_;
  wire _0014_;
  wire _0029_;
  wire _0031_;
  wire _0033_;
  wire _0034_;
  wire _0035_;
  wire _0036_;
  wire _0037_;
  wire _0038_;
  wire _0039_;
  wire _0040_;
  wire _0041_;
  wire _0046_;
  wire _0049_;
  wire _0050_;
  wire _0051_;
  wire _0052_;
  wire _0053_;
  wire _0054_;
  wire _0055_;
  wire _0056_;
  wire _0057_;
  wire _0058_;
  wire _0059_;
  wire _0060_;
  wire _0061_;
  wire _0062_;
  wire _0063_;
  wire _0064_;
  wire _0065_;
  wire _0066_;
  wire _0067_;
  wire _0068_;
  wire _0069_;
  wire _0070_;
  wire _0071_;
  wire _0072_;
  wire _0073_;
  wire _0074_;
  wire _0075_;
  wire _0076_;
  wire _0077_;
  wire _0078_;
  wire _0079_;
  wire _0080_;
  wire _0081_;
  wire _0082_;
  wire _0083_;
  wire _0084_;
  wire _0085_;
  wire _0086_;
  wire _0087_;
  wire _0088_;
  wire _0089_;
  wire _0090_;
  wire _0091_;
  wire _0092_;
  wire _0093_;
  wire _0094_;
  wire _0095_;
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
  wire fo_net_25_g0;
  wire fo_net_26_g1;
  wire fo_net_27_g0;
  wire fo_net_28_g1;
  wire fo_net_29_g0;
  wire fo_net_2_g1;
  wire fo_net_30_g1;
  wire fo_net_31_g0;
  wire fo_net_32_g1;
  wire fo_net_33_g0;
  wire fo_net_34_g1;
  wire fo_net_35_g0;
  wire fo_net_36_g1;
  wire fo_net_37_g0;
  wire fo_net_38_g1;
  wire fo_net_39_g0;
  wire fo_net_3_g0;
  wire fo_net_40_g1;
  wire fo_net_41_g0;
  wire fo_net_42_g1;
  wire fo_net_43_g0;
  wire fo_net_44_g1;
  wire fo_net_45_g0;
  wire fo_net_46_g1;
  wire fo_net_47_g0;
  wire fo_net_48_g1;
  wire fo_net_49_g0;
  wire fo_net_4_g1;
  wire fo_net_50_g1;
  wire fo_net_51_g0;
  wire fo_net_52_g1;
  wire fo_net_53_g0;
  wire fo_net_54_g1;
  wire fo_net_55_g0;
  wire fo_net_56_g1;
  wire fo_net_5_g0;
  wire fo_net_6_g1;
  wire fo_net_7_g0;
  wire fo_net_8_g1;
  wire fo_net_9_g0;
  wire isz_taken;
  wire opa_0;
  wire opa_1;
  wire opa_2;
  wire opa_3;
  wire opr_0;
  wire opr_1;
  wire opr_2;
  wire opr_3;
  wire pc_cout;
  wire pc_init_n;
  wire phase_0;
  wire phase_1;
  wire phase_2;
  wire rst_in_th;
  wire rst_n;
  wire rst_n_buf_r1;
  wire rst_n_buf_r2;
  wire rst_n_buf_r3;
  wire rst_n_buf_r4;
  wire rst_n_buf_r5;
  wire rst_n_buf_r6;
  wire rst_n_buf_r7;
  wire rst_n_buf_r8;
  wire rst_n_buf_r9;
  wire sp_0;
  wire sp_1;
  wire sram_addr_0;
  wire sram_addr_1;
  wire sram_addr_2;
  wire sram_addr_3;
  wire sram_addr_4;
  wire sram_ce;
  wire sram_we;
  wire test_in_th;
  wire two_cycle;
  INV_X1 _0515_ ( .A(fo_net_1_g0), .Y(_0049_) );
  INV_X1 _0516_ ( .A(din0_in_th), .Y(_0050_) );
  INV_X1 _0517_ ( .A(fo_net_3_g0), .Y(_0051_) );
  INV_X1 _0518_ ( .A(din1_in_th), .Y(_0052_) );
  INV_X1 _0519_ ( .A(acc_3), .Y(_0053_) );
  INV_X1 _0520_ ( .A(fo_net_6_g1), .Y(_0054_) );
  INV_X1 _0521_ ( .A(fo_net_7_g0), .Y(_0055_) );
  INV_X1 _0522_ ( .A(fo_net_9_g0), .Y(_0056_) );
  INV_X1 _0523_ ( .A(din3_in_th), .Y(_0057_) );
  INV_X1 _0524_ ( .A(fo_net_11_g0), .Y(_0058_) );
  INV_X1 _0525_ ( .A(fo_net_14_g1), .Y(_0059_) );
  INV_X1 _0526_ ( .A(fo_net_15_g0), .Y(_0060_) );
  INV_X1 _0527_ ( .A(fo_net_18_g1), .Y(_0061_) );
  INV_X1 _0528_ ( .A(rst_in_th), .Y(rst_n) );
  INV_X1 _0529_ ( .A(phase_2), .Y(_0062_) );
  INV_X1 _0530_ ( .A(cy), .Y(_0063_) );
  INV_X1 _0531_ ( .A(buf_h_1), .Y(_0064_) );
  INV_X1 _0532_ ( .A(buf_h_3), .Y(_0065_) );
  INV_X1 _0533_ ( .A(buf_h_2), .Y(_0066_) );
  OR3 _0534_ ( .A(_0014_), .B(_0506_), .C(_0002_), .Y(_0067_) );
  INV_X1 _0535_ ( .A(fo_net_19_g0), .Y(sync) );
  NOR2 _0536_ ( .A(opr_3), .B(_0513_), .Y(_0068_) );
  NOR2 _0537_ ( .A(_0514_), .B(fo_net_21_g0), .Y(_0069_) );
  NOR3 _0538_ ( .A(opr_3), .B(fo_net_21_g0), .C(_0513_), .Y(_0070_) );
  OR3 _0539_ ( .A(opr_3), .B(fo_net_21_g0), .C(_0513_), .Y(_0071_) );
  NAND2 _0540_ ( .A(_0068_), .B(_0069_), .Y(_0072_) );
  NAND2 _0541_ ( .A(_0053_), .B(_0055_), .Y(_0073_) );
  NOR3 _0542_ ( .A(fo_net_6_g1), .B(fo_net_10_g1), .C(_0073_), .Y(_0074_) );
  OAI22 _0543_ ( .A1(_0051_), .A2(_0063_), .B1(test_in_th), .B2(_0049_), .Y(_0075_) );
  AOI21 _0544_ ( .A1(fo_net_24_g1), .A2(_0074_), .B(_0075_), .Y(_0076_) );
  XNOR2 _0545_ ( .A(fo_net_26_g1), .B(_0076_), .Y(_0077_) );
  NOR2 _0546_ ( .A(opr_2), .B(opr_3), .Y(_0078_) );
  NOR2 _0547_ ( .A(_0514_), .B(opr_1), .Y(_0079_) );
  NAND2 _0548_ ( .A(_0078_), .B(_0079_), .Y(_0080_) );
  OAI22 _0549_ ( .A1(isz_taken), .A2(_0072_), .B1(_0077_), .B2(_0080_), .Y(_0081_) );
  NAND2 _0550_ ( .A(fo_net_28_g1), .B(_0081_), .Y(_0082_) );
  NOR2 _0551_ ( .A(fo_net_30_g1), .B(_0082_), .Y(_0083_) );
  NOR3 _0552_ ( .A(phase_2), .B(_0014_), .C(_0506_), .Y(_0084_) );
  INV_X1 _0553_ ( .A(_0084_), .Y(_0085_) );
  NOR3 _0554_ ( .A(fo_net_32_g1), .B(_0014_), .C(_0002_), .Y(_0086_) );
  OR3 _0555_ ( .A(fo_net_32_g1), .B(_0014_), .C(_0002_), .Y(_0087_) );
  NOR2 _0556_ ( .A(fo_net_28_g1), .B(_0086_), .Y(_0088_) );
  NAND2 _0557_ ( .A(fo_net_20_g1), .B(fo_net_34_g1), .Y(_0089_) );
  NOR2 _0558_ ( .A(_0084_), .B(fo_net_35_g0), .Y(_0090_) );
  NOR3 _0559_ ( .A(fo_net_31_g0), .B(phase_1), .C(phase_2), .Y(_0091_) );
  NAND2 _0560_ ( .A(fo_net_38_g1), .B(_0078_), .Y(_0092_) );
  NOR2 _0561_ ( .A(fo_net_22_g1), .B(_0092_), .Y(_0093_) );
  OR2 _0562_ ( .A(fo_net_22_g1), .B(_0092_), .Y(_0094_) );
  NOR4 _0563_ ( .A(opr_2), .B(opr_3), .C(_0514_), .D(fo_net_21_g0), .Y(_0095_) );
  NOR2 _0564_ ( .A(_0514_), .B(_0094_), .Y(_0096_) );
  NAND2 _0565_ ( .A(fo_net_37_g0), .B(_0095_), .Y(_0097_) );
  MUX2 _0566_ ( .A(_0090_), .B(_0096_), .S(_0091_), .Y(_0098_) );
  NOR2 _0567_ ( .A(opr_0), .B(opr_1), .Y(_0099_) );
  AOI21 _0568_ ( .A1(_0514_), .A2(opr_0), .B(opr_1), .Y(_0100_) );
  NAND2 _0569_ ( .A(_0068_), .B(_0100_), .Y(_0101_) );
  NAND3 _0570_ ( .A(_0072_), .B(_0080_), .C(_0101_), .Y(_0102_) );
  OR2 _0571_ ( .A(fo_net_20_g1), .B(_0102_), .Y(_0103_) );
  NOR2 _0572_ ( .A(fo_net_30_g1), .B(_0103_), .Y(_0104_) );
  NOR2 _0573_ ( .A(fo_net_22_g1), .B(opr_0), .Y(_0105_) );
  AOI21 _0574_ ( .A1(_0514_), .A2(opr_0), .B(fo_net_22_g1), .Y(_0106_) );
  NAND2 _0575_ ( .A(_0068_), .B(_0106_), .Y(_0107_) );
  NOR2 _0576_ ( .A(opr_2), .B(_0003_), .Y(_0108_) );
  NAND2 _0577_ ( .A(_0069_), .B(_0108_), .Y(_0109_) );
  NAND2 _0578_ ( .A(fo_net_40_g1), .B(_0109_), .Y(_0110_) );
  NOR2 _0579_ ( .A(fo_net_34_g1), .B(_0110_), .Y(_0111_) );
  OR2 _0580_ ( .A(fo_net_38_g1), .B(fo_net_20_g1), .Y(_0112_) );
  NOR2 _0581_ ( .A(_0095_), .B(_0112_), .Y(_0113_) );
  OAI22 _0582_ ( .A1(fo_net_38_g1), .A2(_0085_), .B1(fo_net_34_g1), .B2(fo_net_29_g0), .Y(_0114_) );
  OR4 _0583_ ( .A(_0104_), .B(_0111_), .C(_0113_), .D(_0114_), .Y(_0115_) );
  NOR3 _0584_ ( .A(_0083_), .B(_0098_), .C(_0115_), .Y(_0116_) );
  AOI21 _0585_ ( .A1(_0054_), .A2(fo_net_39_g0), .B(fo_net_33_g0), .Y(_0117_) );
  OR2 _0586_ ( .A(phase_1), .B(_0506_), .Y(_0118_) );
  AOI21 _0587_ ( .A1(fo_net_37_g0), .A2(_0095_), .B(_0001_), .Y(_0119_) );
  MUX2 _0588_ ( .A(buf_m_1), .B(fo_net_13_g0), .S(fo_net_41_g0), .Y(_0120_) );
  MUX2 _0589_ ( .A(buf_h_1), .B(fo_net_13_g0), .S(pc_init_n), .Y(_0121_) );
  INV_X1 _0590_ ( .A(_0121_), .Y(_0122_) );
  OAI21 _0591_ ( .A1(fo_net_31_g0), .A2(phase_1), .B(_0062_), .Y(_0123_) );
  AOI21 _0592_ ( .A1(fo_net_43_g0), .A2(_0122_), .B(_0123_), .Y(_0124_) );
  OAI21 _0593_ ( .A1(fo_net_43_g0), .A2(_0120_), .B(_0124_), .Y(_0125_) );
  MUX2 _0594_ ( .A(buf_l_1), .B(fo_net_13_g0), .S(fo_net_41_g0), .Y(_0126_) );
  NAND2 _0595_ ( .A(_0091_), .B(_0126_), .Y(_0127_) );
  AOI21 _0596_ ( .A1(_0059_), .A2(fo_net_45_g0), .B(_0062_), .Y(_0128_) );
  OAI21 _0597_ ( .A1(fo_net_5_g0), .A2(fo_net_45_g0), .B(_0128_), .Y(_0129_) );
  NAND3 _0598_ ( .A(_0125_), .B(_0127_), .C(_0129_), .Y(_0130_) );
  AND2_X1 _0599_ ( .A(_0079_), .B(_0108_), .Y(_0131_) );
  NAND2 _0600_ ( .A(_0079_), .B(_0108_), .Y(_0132_) );
  AND3_X1 _0601_ ( .A(_0511_), .B(fo_net_9_g0), .C(_0510_), .Y(_0133_) );
  AOI21 _0602_ ( .A1(_0511_), .A2(fo_net_5_g0), .B(fo_net_7_g0), .Y(_0134_) );
  OR3 _0603_ ( .A(_0053_), .B(_0133_), .C(_0134_), .Y(_0135_) );
  NOR4 _0604_ ( .A(fo_net_1_g0), .B(fo_net_3_g0), .C(fo_net_23_g0), .D(fo_net_47_g0), .Y(_0136_) );
  OR4 _0605_ ( .A(fo_net_1_g0), .B(fo_net_3_g0), .C(fo_net_23_g0), .D(fo_net_47_g0), .Y(_0137_) );
  NOR2 _0606_ ( .A(cy), .B(_0136_), .Y(_0138_) );
  NOR2 _0607_ ( .A(_0003_), .B(_0513_), .Y(_0139_) );
  AND2_X1 _0608_ ( .A(_0105_), .B(_0139_), .Y(_0140_) );
  OR4 _0609_ ( .A(fo_net_21_g0), .B(opr_0), .C(_0003_), .D(_0513_), .Y(_0141_) );
  NOR2 _0610_ ( .A(_0012_), .B(fo_net_50_g1), .Y(_0142_) );
  NOR4 _0611_ ( .A(fo_net_24_g1), .B(_0012_), .C(fo_net_47_g0), .D(fo_net_49_g0), .Y(_0143_) );
  OR4 _0612_ ( .A(fo_net_24_g1), .B(_0012_), .C(fo_net_47_g0), .D(fo_net_49_g0), .Y(_0144_) );
  NOR2 _0613_ ( .A(_0136_), .B(_0143_), .Y(_0145_) );
  OAI21 _0614_ ( .A1(_0136_), .A2(_0143_), .B(fo_net_51_g0), .Y(_0146_) );
  AOI21 _0615_ ( .A1(_0135_), .A2(_0138_), .B(_0146_), .Y(_0147_) );
  NOR2 _0616_ ( .A(fo_net_1_g0), .B(fo_net_51_g0), .Y(_0148_) );
  NOR2 _0617_ ( .A(_0049_), .B(fo_net_52_g1), .Y(_0149_) );
  MUX2 _0618_ ( .A(_0148_), .B(_0149_), .S(din1_in_th), .Y(_0150_) );
  OAI21 _0619_ ( .A1(_0147_), .A2(_0150_), .B(_0132_), .Y(_0151_) );
  AND2_X1 _0620_ ( .A(_0099_), .B(_0108_), .Y(_0152_) );
  NAND2 _0621_ ( .A(_0099_), .B(_0108_), .Y(_0153_) );
  AOI21 _0622_ ( .A1(_0059_), .A2(_0131_), .B(_0152_), .Y(_0154_) );
  NAND2 _0623_ ( .A(_0151_), .B(_0154_), .Y(_0155_) );
  NAND2 _0624_ ( .A(phase_2), .B(_0071_), .Y(_0156_) );
  AOI21 _0625_ ( .A1(_0059_), .A2(_0152_), .B(_0156_), .Y(_0157_) );
  NAND2 _0626_ ( .A(_0155_), .B(_0157_), .Y(_0158_) );
  NAND3 _0627_ ( .A(_0130_), .B(_0155_), .C(_0157_), .Y(_0159_) );
  AOI21 _0628_ ( .A1(_0155_), .A2(_0157_), .B(_0130_), .Y(_0160_) );
  XOR2 _0629_ ( .A(_0130_), .B(_0158_), .Y(_0161_) );
  MUX2 _0630_ ( .A(buf_h_0), .B(fo_net_15_g0), .S(pc_init_n), .Y(_0162_) );
  INV_X1 _0631_ ( .A(_0162_), .Y(_0163_) );
  MUX2 _0632_ ( .A(buf_m_0), .B(fo_net_15_g0), .S(fo_net_42_g1), .Y(_0164_) );
  AOI21 _0633_ ( .A1(fo_net_43_g0), .A2(_0163_), .B(_0123_), .Y(_0165_) );
  OAI21 _0634_ ( .A1(fo_net_44_g1), .A2(_0164_), .B(_0165_), .Y(_0166_) );
  MUX2 _0635_ ( .A(buf_l_0), .B(fo_net_15_g0), .S(fo_net_42_g1), .Y(_0167_) );
  NAND2 _0636_ ( .A(_0091_), .B(_0167_), .Y(_0168_) );
  AOI21 _0637_ ( .A1(_0060_), .A2(fo_net_46_g1), .B(_0062_), .Y(_0169_) );
  OAI21 _0638_ ( .A1(fo_net_9_g0), .A2(fo_net_46_g1), .B(_0169_), .Y(_0170_) );
  AND3_X1 _0639_ ( .A(_0166_), .B(_0168_), .C(_0170_), .Y(_0171_) );
  NAND2 _0640_ ( .A(din0_in_th), .B(_0149_), .Y(_0172_) );
  NOR2 _0641_ ( .A(_0137_), .B(_0140_), .Y(_0173_) );
  AOI22 _0642_ ( .A1(_0136_), .A2(fo_net_51_g0), .B1(_0148_), .B2(_0050_), .Y(_0174_) );
  AOI21 _0643_ ( .A1(_0172_), .A2(_0174_), .B(_0131_), .Y(_0175_) );
  OAI21 _0644_ ( .A1(fo_net_16_g1), .A2(_0132_), .B(_0153_), .Y(_0176_) );
  AOI21 _0645_ ( .A1(_0060_), .A2(_0152_), .B(_0156_), .Y(_0177_) );
  OAI21 _0646_ ( .A1(_0175_), .A2(_0176_), .B(_0177_), .Y(_0178_) );
  OR2 _0647_ ( .A(_0171_), .B(_0178_), .Y(_0179_) );
  NOR2 _0648_ ( .A(pc_cout), .B(_0123_), .Y(_0180_) );
  AOI21 _0649_ ( .A1(_0132_), .A2(_0149_), .B(_0152_), .Y(_0181_) );
  NOR2 _0650_ ( .A(_0131_), .B(_0148_), .Y(_0182_) );
  NOR2 _0651_ ( .A(_0005_), .B(_0182_), .Y(_0183_) );
  NOR2 _0652_ ( .A(fo_net_2_g1), .B(_0012_), .Y(_0184_) );
  NOR2 _0653_ ( .A(fo_net_23_g0), .B(fo_net_25_g0), .Y(_0185_) );
  AND2_X1 _0654_ ( .A(_0184_), .B(_0185_), .Y(_0186_) );
  NAND2 _0655_ ( .A(_0184_), .B(_0185_), .Y(_0187_) );
  NAND2 _0656_ ( .A(_0132_), .B(_0153_), .Y(_0188_) );
  NAND3 _0657_ ( .A(_0132_), .B(fo_net_52_g1), .C(_0153_), .Y(_0189_) );
  OAI22 _0658_ ( .A1(cy), .A2(_0181_), .B1(_0186_), .B2(_0189_), .Y(_0190_) );
  AOI21 _0659_ ( .A1(_0153_), .A2(_0183_), .B(_0190_), .Y(_0191_) );
  NOR2 _0660_ ( .A(_0156_), .B(_0191_), .Y(_0192_) );
  NOR2 _0661_ ( .A(_0180_), .B(_0192_), .Y(_0193_) );
  XNOR2 _0662_ ( .A(_0171_), .B(_0178_), .Y(_0194_) );
  OR3 _0663_ ( .A(_0180_), .B(_0192_), .C(_0194_), .Y(_0195_) );
  NAND2 _0664_ ( .A(_0179_), .B(_0195_), .Y(_0196_) );
  XNOR2 _0665_ ( .A(_0161_), .B(_0196_), .Y(_0197_) );
  OAI21 _0666_ ( .A1(_0090_), .A2(_0117_), .B(_0197_), .Y(_0198_) );
  MUX2 _0667_ ( .A(fo_net_14_g1), .B(buf_m_1), .S(fo_net_37_g0), .Y(_0199_) );
  AOI22 _0668_ ( .A1(din1_in_th), .A2(_0084_), .B1(_0199_), .B2(fo_net_27_g0), .Y(_0200_) );
  NAND2 _0669_ ( .A(fo_net_40_g1), .B(_0117_), .Y(_0201_) );
  NAND3 _0670_ ( .A(_0198_), .B(_0200_), .C(_0201_), .Y(_0202_) );
  AOI21 _0672_ ( .A1(_0055_), .A2(fo_net_40_g1), .B(fo_net_33_g0), .Y(_0203_) );
  NOR2 _0673_ ( .A(_0090_), .B(_0203_), .Y(_0204_) );
  NOR2 _0674_ ( .A(_0161_), .B(_0195_), .Y(_0205_) );
  MUX2 _0675_ ( .A(buf_m_2), .B(fo_net_11_g0), .S(fo_net_41_g0), .Y(_0206_) );
  MUX2 _0676_ ( .A(buf_h_2), .B(fo_net_11_g0), .S(pc_init_n), .Y(_0207_) );
  INV_X1 _0677_ ( .A(_0207_), .Y(_0208_) );
  AOI21 _0678_ ( .A1(fo_net_43_g0), .A2(_0208_), .B(_0123_), .Y(_0209_) );
  OAI21 _0679_ ( .A1(fo_net_43_g0), .A2(_0206_), .B(_0209_), .Y(_0210_) );
  MUX2 _0680_ ( .A(buf_l_2), .B(fo_net_11_g0), .S(fo_net_41_g0), .Y(_0211_) );
  NAND2 _0681_ ( .A(_0091_), .B(_0211_), .Y(_0212_) );
  AOI21 _0682_ ( .A1(_0058_), .A2(fo_net_45_g0), .B(_0062_), .Y(_0213_) );
  OAI21 _0683_ ( .A1(fo_net_7_g0), .A2(fo_net_45_g0), .B(_0213_), .Y(_0214_) );
  NAND3 _0684_ ( .A(_0210_), .B(_0212_), .C(_0214_), .Y(_0215_) );
  MUX2 _0685_ ( .A(_0148_), .B(_0149_), .S(din2_in_th), .Y(_0216_) );
  NOR3 _0686_ ( .A(_0131_), .B(_0147_), .C(_0216_), .Y(_0217_) );
  NOR2 _0687_ ( .A(_0058_), .B(_0132_), .Y(_0218_) );
  OAI21 _0688_ ( .A1(_0217_), .A2(_0218_), .B(_0153_), .Y(_0219_) );
  AOI21 _0689_ ( .A1(_0058_), .A2(_0152_), .B(_0156_), .Y(_0220_) );
  AND2_X1 _0690_ ( .A(_0219_), .B(_0220_), .Y(_0221_) );
  AND2_X1 _0691_ ( .A(_0215_), .B(_0221_), .Y(_0222_) );
  OR2 _0692_ ( .A(_0215_), .B(_0221_), .Y(_0223_) );
  XNOR2 _0693_ ( .A(_0215_), .B(_0221_), .Y(_0224_) );
  OAI21 _0694_ ( .A1(_0160_), .A2(_0179_), .B(_0159_), .Y(_0225_) );
  XNOR2 _0695_ ( .A(_0224_), .B(_0225_), .Y(_0226_) );
  AND2_X1 _0696_ ( .A(_0205_), .B(_0226_), .Y(_0227_) );
  XNOR2 _0697_ ( .A(_0205_), .B(_0226_), .Y(_0228_) );
  MUX2 _0698_ ( .A(fo_net_12_g1), .B(buf_m_2), .S(fo_net_37_g0), .Y(_0229_) );
  AOI22 _0699_ ( .A1(din2_in_th), .A2(_0084_), .B1(_0229_), .B2(fo_net_28_g1), .Y(_0230_) );
  NAND2 _0700_ ( .A(fo_net_40_g1), .B(_0203_), .Y(_0231_) );
  AND2_X1 _0701_ ( .A(_0230_), .B(_0231_), .Y(_0232_) );
  OAI21 _0702_ ( .A1(_0204_), .A2(_0228_), .B(_0232_), .Y(_0233_) );
  NOR3 _0704_ ( .A(fo_net_31_g0), .B(phase_1), .C(_0002_), .Y(_0234_) );
  OR3 _0705_ ( .A(fo_net_31_g0), .B(phase_1), .C(_0002_), .Y(_0235_) );
  NAND2 _0706_ ( .A(fo_net_29_g0), .B(_0234_), .Y(_0236_) );
  OAI22 _0710_ ( .A1(fo_net_34_g1), .A2(_0095_), .B1(_0235_), .B2(fo_net_38_g1), .Y(_0237_) );
  OAI21 _0711_ ( .A1(fo_net_29_g0), .A2(fo_net_34_g1), .B(_0112_), .Y(_0238_) );
  NOR2 _0712_ ( .A(_0237_), .B(_0238_), .Y(_0239_) );
  NOR2 _0713_ ( .A(phase_2), .B(fo_net_44_g1), .Y(_0240_) );
  NOR2 _0714_ ( .A(_0234_), .B(_0240_), .Y(_0241_) );
  AOI22 _0715_ ( .A1(_0096_), .A2(_0240_), .B1(_0241_), .B2(_0088_), .Y(_0242_) );
  AND4_X1 _0716_ ( .A(_0082_), .B(_0103_), .C(_0239_), .D(_0242_), .Y(_0243_) );
  NOR2 _0717_ ( .A(fo_net_35_g0), .B(_0234_), .Y(_0244_) );
  XNOR2 _0718_ ( .A(_0193_), .B(_0194_), .Y(_0245_) );
  XOR2 _0719_ ( .A(_0193_), .B(_0194_), .Y(_0246_) );
  NAND2 _0720_ ( .A(_0244_), .B(_0245_), .Y(_0247_) );
  NAND2 _0721_ ( .A(fo_net_16_g1), .B(_0086_), .Y(_0248_) );
  AOI22 _0722_ ( .A1(buf_l_0), .A2(fo_net_27_g0), .B1(_0234_), .B2(din0_in_th), .Y(_0249_) );
  NAND3 _0723_ ( .A(_0247_), .B(_0248_), .C(_0249_), .Y(_0250_) );
  NAND2 _0725_ ( .A(_0120_), .B(_0240_), .Y(_0251_) );
  AND3_X1 _0726_ ( .A(fo_net_2_g1), .B(fo_net_30_g1), .C(_0078_), .Y(_0252_) );
  NAND2 _0727_ ( .A(_0105_), .B(_0252_), .Y(_0253_) );
  NOR2 _0728_ ( .A(_0088_), .B(_0253_), .Y(_0254_) );
  NOR3 _0729_ ( .A(fo_net_32_g1), .B(phase_2), .C(_0014_), .Y(_0255_) );
  AOI22 _0730_ ( .A1(fo_net_13_g0), .A2(_0254_), .B1(fo_net_53_g0), .B2(_0121_), .Y(_0256_) );
  NAND2 _0731_ ( .A(fo_net_30_g1), .B(_0086_), .Y(_0257_) );
  NOR2 _0732_ ( .A(fo_net_52_g1), .B(_0257_), .Y(_0258_) );
  AND2_X1 _0733_ ( .A(fo_net_47_g0), .B(_0258_), .Y(_0259_) );
  NAND3 _0734_ ( .A(fo_net_5_g0), .B(_0253_), .C(_0259_), .Y(_0260_) );
  NAND4 _0735_ ( .A(_0127_), .B(_0251_), .C(_0256_), .D(_0260_), .Y(d_out[1]) );
  NAND2 _0736_ ( .A(_0164_), .B(_0240_), .Y(_0261_) );
  NAND3 _0737_ ( .A(fo_net_9_g0), .B(_0253_), .C(_0259_), .Y(_0262_) );
  AOI22 _0738_ ( .A1(fo_net_15_g0), .A2(_0254_), .B1(fo_net_53_g0), .B2(_0162_), .Y(_0263_) );
  NAND4 _0739_ ( .A(_0168_), .B(_0261_), .C(_0262_), .D(_0263_), .Y(d_out[0]) );
  NAND2 _0740_ ( .A(_0206_), .B(_0240_), .Y(_0264_) );
  AOI22 _0741_ ( .A1(fo_net_11_g0), .A2(_0254_), .B1(fo_net_53_g0), .B2(_0207_), .Y(_0265_) );
  NAND3 _0742_ ( .A(fo_net_7_g0), .B(_0253_), .C(_0259_), .Y(_0266_) );
  NAND4 _0743_ ( .A(_0212_), .B(_0264_), .C(_0265_), .D(_0266_), .Y(d_out[2]) );
  NOR2 _0744_ ( .A(_0002_), .B(fo_net_44_g1), .Y(_0267_) );
  NOR2 _0745_ ( .A(_0234_), .B(_0267_), .Y(_0268_) );
  MUX2 _0746_ ( .A(_0094_), .B(_0268_), .S(fo_net_19_g0), .Y(_0269_) );
  OAI21 _0747_ ( .A1(fo_net_19_g0), .A2(_0094_), .B(_0235_), .Y(_0270_) );
  NAND2 _0748_ ( .A(buf_h_0), .B(_0267_), .Y(_0271_) );
  AOI22 _0749_ ( .A1(buf_l_0), .A2(_0269_), .B1(_0270_), .B2(buf_m_0), .Y(_0272_) );
  NAND2 _0750_ ( .A(_0271_), .B(_0272_), .Y(sram_din[0]) );
  NAND2 _0751_ ( .A(fo_net_29_g0), .B(_0084_), .Y(_0273_) );
  NOR3 _0753_ ( .A(_0136_), .B(fo_net_52_g1), .C(_0143_), .Y(_0274_) );
  NOR2 _0754_ ( .A(_0013_), .B(fo_net_48_g1), .Y(_0275_) );
  OAI21 _0755_ ( .A1(_0142_), .A2(_0184_), .B(_0275_), .Y(_0276_) );
  NOR2 _0756_ ( .A(fo_net_4_g1), .B(fo_net_50_g1), .Y(_0277_) );
  NOR4 _0757_ ( .A(fo_net_4_g1), .B(fo_net_24_g1), .C(fo_net_48_g1), .D(fo_net_50_g1), .Y(_0278_) );
  NOR4 _0758_ ( .A(fo_net_2_g1), .B(fo_net_4_g1), .C(_0013_), .D(fo_net_48_g1), .Y(_0279_) );
  INV_X1 _0759_ ( .A(_0279_), .Y(_0280_) );
  AND2_X1 _0760_ ( .A(_0275_), .B(_0277_), .Y(_0281_) );
  OR4 _0761_ ( .A(fo_net_2_g1), .B(fo_net_24_g1), .C(_0012_), .D(fo_net_48_g1), .Y(_0282_) );
  NOR3 _0762_ ( .A(_0278_), .B(_0279_), .C(_0281_), .Y(_0283_) );
  NAND3 _0763_ ( .A(_0276_), .B(_0282_), .C(_0283_), .Y(_0284_) );
  INV_X1 _0764_ ( .A(_0284_), .Y(_0285_) );
  AOI21 _0765_ ( .A1(_0274_), .A2(_0285_), .B(_0257_), .Y(_0286_) );
  AND2_X1 _0766_ ( .A(_0069_), .B(_0139_), .Y(_0287_) );
  NOR4 _0767_ ( .A(fo_net_1_g0), .B(_0013_), .C(fo_net_25_g0), .D(_0012_), .Y(_0288_) );
  NOR4 _0768_ ( .A(fo_net_4_g1), .B(_0013_), .C(fo_net_26_g1), .D(fo_net_49_g0), .Y(_0289_) );
  NOR4 _0769_ ( .A(_0136_), .B(_0186_), .C(_0288_), .D(_0289_), .Y(_0290_) );
  NOR4 _0770_ ( .A(fo_net_2_g1), .B(fo_net_4_g1), .C(_0013_), .D(fo_net_26_g1), .Y(_0291_) );
  NOR4 _0771_ ( .A(_0013_), .B(fo_net_26_g1), .C(_0012_), .D(fo_net_49_g0), .Y(_0292_) );
  NOR2 _0772_ ( .A(_0278_), .B(_0292_), .Y(_0293_) );
  NAND3 _0773_ ( .A(_0049_), .B(_0051_), .C(_0185_), .Y(_0294_) );
  NAND3 _0774_ ( .A(_0144_), .B(_0290_), .C(_0294_), .Y(_0295_) );
  NOR4 _0775_ ( .A(_0278_), .B(_0291_), .C(_0292_), .D(_0295_), .Y(_0296_) );
  NAND2 _0776_ ( .A(_0280_), .B(_0296_), .Y(_0297_) );
  AND2_X1 _0777_ ( .A(_0106_), .B(_0108_), .Y(_0298_) );
  AND2_X1 _0778_ ( .A(_0100_), .B(_0139_), .Y(_0299_) );
  NOR3 _0779_ ( .A(_0189_), .B(_0298_), .C(_0299_), .Y(_0300_) );
  OR3 _0780_ ( .A(_0189_), .B(_0298_), .C(_0299_), .Y(_0301_) );
  MUX2 _0781_ ( .A(_0301_), .B(_0297_), .S(_0287_), .Y(_0302_) );
  NAND2 _0782_ ( .A(_0286_), .B(_0302_), .Y(_0303_) );
  OAI21 _0783_ ( .A1(din2_in_th), .A2(_0285_), .B(_0140_), .Y(_0304_) );
  AOI21 _0784_ ( .A1(_0145_), .A2(_0187_), .B(_0301_), .Y(_0305_) );
  NOR2 _0785_ ( .A(_0188_), .B(_0305_), .Y(_0306_) );
  OR2 _0786_ ( .A(_0188_), .B(_0305_), .Y(_0307_) );
  AOI21 _0787_ ( .A1(_0304_), .A2(_0306_), .B(_0228_), .Y(_0308_) );
  NOR4 _0788_ ( .A(fo_net_6_g1), .B(fo_net_8_g1), .C(fo_net_10_g1), .D(_0007_), .Y(_0309_) );
  OR4 _0789_ ( .A(_0511_), .B(acc_3), .C(fo_net_5_g0), .D(fo_net_9_g0), .Y(_0310_) );
  OR2 _0790_ ( .A(fo_net_9_g0), .B(_0510_), .Y(_0311_) );
  OAI21 _0791_ ( .A1(_0073_), .A2(_0311_), .B(_0310_), .Y(_0312_) );
  OR2 _0792_ ( .A(fo_net_5_g0), .B(_0512_), .Y(_0313_) );
  NOR2 _0793_ ( .A(_0073_), .B(_0313_), .Y(_0314_) );
  NOR3 _0794_ ( .A(_0074_), .B(_0309_), .C(_0314_), .Y(_0315_) );
  NOR4 _0795_ ( .A(_0074_), .B(_0309_), .C(_0312_), .D(_0314_), .Y(_0316_) );
  AOI22 _0796_ ( .A1(acc_3), .A2(_0288_), .B1(_0291_), .B2(_0511_), .Y(_0317_) );
  NAND2 _0797_ ( .A(_0296_), .B(_0316_), .Y(_0318_) );
  AOI22 _0798_ ( .A1(fo_net_6_g1), .A2(_0289_), .B1(_0296_), .B2(_0309_), .Y(_0319_) );
  AND2_X1 _0799_ ( .A(_0317_), .B(_0319_), .Y(_0320_) );
  AOI21 _0800_ ( .A1(_0318_), .A2(_0320_), .B(_0301_), .Y(_0321_) );
  NAND3 _0801_ ( .A(din2_in_th), .B(_0140_), .C(_0284_), .Y(_0322_) );
  AOI22 _0802_ ( .A1(fo_net_12_g1), .A2(_0298_), .B1(_0299_), .B2(fo_net_23_g0), .Y(_0323_) );
  NAND4 _0803_ ( .A(_0286_), .B(_0302_), .C(_0322_), .D(_0323_), .Y(_0324_) );
  NOR3 _0804_ ( .A(_0308_), .B(_0321_), .C(_0324_), .Y(_0325_) );
  AOI21 _0805_ ( .A1(_0055_), .A2(_0303_), .B(_0325_), .Y(_0029_) );
  NAND2 _0806_ ( .A(buf_h_1), .B(_0267_), .Y(_0326_) );
  AOI22 _0807_ ( .A1(buf_l_1), .A2(_0269_), .B1(_0270_), .B2(buf_m_1), .Y(_0327_) );
  NAND2 _0808_ ( .A(_0326_), .B(_0327_), .Y(sram_din[1]) );
  NAND2 _0809_ ( .A(buf_l_2), .B(_0269_), .Y(_0328_) );
  AOI22 _0810_ ( .A1(buf_h_2), .A2(_0267_), .B1(_0270_), .B2(buf_m_2), .Y(_0329_) );
  NAND2 _0811_ ( .A(_0328_), .B(_0329_), .Y(sram_din[2]) );
  NAND4 _0812_ ( .A(fo_net_30_g1), .B(_0086_), .C(_0281_), .D(_0287_), .Y(_0330_) );
  NOR2 _0814_ ( .A(fo_net_54_g1), .B(_0267_), .Y(_0331_) );
  NAND3 _0815_ ( .A(fo_net_36_g1), .B(_0241_), .C(_0331_), .Y(sram_addr_4) );
  NAND2 _0816_ ( .A(sp_1), .B(sram_addr_4), .Y(_0332_) );
  NAND3 _0817_ ( .A(fo_net_49_g0), .B(fo_net_29_g0), .C(_0095_), .Y(_0333_) );
  NOR2 _0818_ ( .A(_0093_), .B(_0333_), .Y(_0334_) );
  NAND2 _0819_ ( .A(fo_net_26_g1), .B(fo_net_36_g1), .Y(_0335_) );
  OAI21 _0820_ ( .A1(_0334_), .A2(_0335_), .B(_0332_), .Y(sram_addr_3) );
  NAND2 _0821_ ( .A(sp_0), .B(sram_addr_4), .Y(_0336_) );
  NAND2 _0822_ ( .A(fo_net_24_g1), .B(fo_net_36_g1), .Y(_0337_) );
  OAI21 _0823_ ( .A1(_0334_), .A2(_0337_), .B(_0336_), .Y(sram_addr_2) );
  AOI21 _0824_ ( .A1(_0052_), .A2(_0284_), .B(fo_net_51_g0), .Y(_0338_) );
  OAI21 _0825_ ( .A1(_0307_), .A2(_0338_), .B(_0197_), .Y(_0339_) );
  OAI21 _0826_ ( .A1(_0312_), .A2(_0315_), .B(_0296_), .Y(_0340_) );
  AOI22 _0827_ ( .A1(cy), .A2(_0278_), .B1(_0288_), .B2(fo_net_8_g1), .Y(_0341_) );
  AOI22 _0828_ ( .A1(fo_net_10_g1), .A2(_0289_), .B1(_0291_), .B2(_0510_), .Y(_0342_) );
  NAND3 _0829_ ( .A(_0340_), .B(_0341_), .C(_0342_), .Y(_0343_) );
  NAND2 _0830_ ( .A(_0300_), .B(_0343_), .Y(_0344_) );
  NAND2 _0831_ ( .A(_0284_), .B(_0338_), .Y(_0345_) );
  AOI22 _0832_ ( .A1(fo_net_14_g1), .A2(_0298_), .B1(_0299_), .B2(fo_net_3_g0), .Y(_0346_) );
  NAND4 _0833_ ( .A(_0339_), .B(_0344_), .C(_0345_), .D(_0346_), .Y(_0347_) );
  NAND2 _0835_ ( .A(fo_net_32_g1), .B(phase_1), .Y(_0348_) );
  XNOR2 _0836_ ( .A(phase_2), .B(_0348_), .Y(_0508_) );
  AOI22 _0838_ ( .A1(fo_net_30_g1), .A2(_0140_), .B1(_0281_), .B2(_0287_), .Y(_0349_) );
  AOI21 _0839_ ( .A1(_0253_), .A2(_0349_), .B(_0257_), .Y(_0350_) );
  NOR2 _0840_ ( .A(fo_net_54_g1), .B(_0350_), .Y(_0351_) );
  OR2 _0841_ ( .A(_0009_), .B(_0351_), .Y(cm_ram[2]) );
  OR2 _0842_ ( .A(_0008_), .B(_0351_), .Y(cm_ram[1]) );
  OR4 _0843_ ( .A(bank_sel_1), .B(bank_sel_3), .C(bank_sel_2), .D(_0351_), .Y(cm_ram[0]) );
  MUX2 _0847_ ( .A(fo_net_28_g1), .B(_0097_), .S(fo_net_54_g1), .Y(_0352_) );
  OAI21 _0848_ ( .A1(fo_net_1_g0), .A2(_0112_), .B(_0352_), .Y(_0353_) );
  NOR4 _0849_ ( .A(_0083_), .B(_0104_), .C(_0113_), .D(_0353_), .Y(_0354_) );
  NAND2 _0851_ ( .A(fo_net_3_g0), .B(fo_net_35_g0), .Y(_0355_) );
  OAI21 _0852_ ( .A1(_0334_), .A2(_0355_), .B(_0331_), .Y(sram_addr_1) );
  NAND2 _0853_ ( .A(_0197_), .B(_0244_), .Y(_0356_) );
  OAI22 _0854_ ( .A1(_0059_), .A2(fo_net_33_g0), .B1(_0235_), .B2(_0052_), .Y(_0357_) );
  AOI21 _0855_ ( .A1(buf_l_1), .A2(fo_net_27_g0), .B(_0357_), .Y(_0358_) );
  NAND2 _0856_ ( .A(_0356_), .B(_0358_), .Y(_0359_) );
  NOR2 _0858_ ( .A(buf_l_3), .B(_0116_), .Y(_0360_) );
  AOI21 _0859_ ( .A1(_0223_), .A2(_0225_), .B(_0222_), .Y(_0361_) );
  MUX2 _0860_ ( .A(buf_m_3), .B(fo_net_17_g0), .S(fo_net_42_g1), .Y(_0362_) );
  MUX2 _0861_ ( .A(buf_h_3), .B(fo_net_17_g0), .S(pc_init_n), .Y(_0363_) );
  INV_X1 _0862_ ( .A(_0363_), .Y(_0364_) );
  AOI21 _0863_ ( .A1(fo_net_44_g1), .A2(_0364_), .B(_0123_), .Y(_0365_) );
  OAI21 _0864_ ( .A1(fo_net_44_g1), .A2(_0362_), .B(_0365_), .Y(_0366_) );
  MUX2 _0865_ ( .A(buf_l_3), .B(fo_net_17_g0), .S(fo_net_42_g1), .Y(_0367_) );
  NAND2 _0866_ ( .A(_0091_), .B(_0367_), .Y(_0368_) );
  AOI21 _0867_ ( .A1(_0061_), .A2(fo_net_46_g1), .B(_0062_), .Y(_0369_) );
  OAI21 _0868_ ( .A1(acc_3), .A2(fo_net_46_g1), .B(_0369_), .Y(_0370_) );
  NAND3 _0869_ ( .A(_0366_), .B(_0368_), .C(_0370_), .Y(_0371_) );
  MUX2 _0870_ ( .A(_0148_), .B(_0149_), .S(din3_in_th), .Y(_0372_) );
  OAI21 _0871_ ( .A1(_0173_), .A2(_0372_), .B(_0132_), .Y(_0373_) );
  AOI21 _0872_ ( .A1(_0061_), .A2(_0131_), .B(_0152_), .Y(_0374_) );
  AOI21 _0873_ ( .A1(_0373_), .A2(_0374_), .B(_0156_), .Y(_0375_) );
  OAI21 _0874_ ( .A1(fo_net_17_g0), .A2(_0153_), .B(_0375_), .Y(_0376_) );
  INV_X1 _0875_ ( .A(_0376_), .Y(_0377_) );
  NAND2 _0876_ ( .A(_0371_), .B(_0377_), .Y(_0378_) );
  XOR2 _0877_ ( .A(_0371_), .B(_0376_), .Y(_0379_) );
  XOR2 _0878_ ( .A(_0361_), .B(_0379_), .Y(_0380_) );
  AND2_X1 _0879_ ( .A(_0227_), .B(_0380_), .Y(_0381_) );
  XOR2 _0880_ ( .A(_0227_), .B(_0380_), .Y(_0382_) );
  AOI21 _0881_ ( .A1(_0053_), .A2(fo_net_39_g0), .B(fo_net_33_g0), .Y(_0383_) );
  OAI21 _0882_ ( .A1(_0090_), .A2(_0383_), .B(_0382_), .Y(_0384_) );
  MUX2 _0883_ ( .A(fo_net_18_g1), .B(buf_m_3), .S(fo_net_37_g0), .Y(_0385_) );
  AOI22 _0884_ ( .A1(din3_in_th), .A2(_0084_), .B1(_0385_), .B2(fo_net_27_g0), .Y(_0386_) );
  NAND2 _0885_ ( .A(_0116_), .B(_0386_), .Y(_0387_) );
  AOI21 _0886_ ( .A1(fo_net_39_g0), .A2(_0383_), .B(_0387_), .Y(_0388_) );
  AOI21 _0887_ ( .A1(_0384_), .A2(_0388_), .B(_0360_), .Y(_0046_) );
  XOR2 _0888_ ( .A(fo_net_31_g0), .B(phase_1), .Y(_0507_) );
  OR3 _0889_ ( .A(fo_net_35_g0), .B(_0228_), .C(_0234_), .Y(_0389_) );
  NAND2 _0890_ ( .A(buf_l_2), .B(fo_net_27_g0), .Y(_0390_) );
  AOI22 _0891_ ( .A1(fo_net_12_g1), .A2(_0086_), .B1(_0234_), .B2(din2_in_th), .Y(_0391_) );
  NAND3 _0892_ ( .A(_0389_), .B(_0390_), .C(_0391_), .Y(_0392_) );
  NAND2 _0894_ ( .A(_0094_), .B(_0333_), .Y(_0393_) );
  AND2_X1 _0895_ ( .A(_0078_), .B(_0106_), .Y(_0394_) );
  NAND2 _0896_ ( .A(_0106_), .B(_0252_), .Y(_0395_) );
  NAND4 _0897_ ( .A(fo_net_2_g1), .B(_0086_), .C(_0094_), .D(_0395_), .Y(_0396_) );
  OAI21 _0898_ ( .A1(fo_net_2_g1), .A2(_0393_), .B(fo_net_28_g1), .Y(_0397_) );
  NAND3 _0899_ ( .A(_0241_), .B(_0396_), .C(_0397_), .Y(sram_addr_0) );
  NOR2 _0900_ ( .A(_0072_), .B(_0257_), .Y(_0398_) );
  NAND4 _0901_ ( .A(fo_net_12_g1), .B(fo_net_14_g1), .C(fo_net_16_g1), .D(fo_net_18_g1), .Y(_0399_) );
  OR2 _0905_ ( .A(_0091_), .B(_0240_), .Y(_0400_) );
  NAND2 _0906_ ( .A(_0097_), .B(_0400_), .Y(_0401_) );
  OAI21 _0907_ ( .A1(_0361_), .A2(_0379_), .B(_0378_), .Y(_0402_) );
  AOI21 _0908_ ( .A1(_0227_), .A2(_0380_), .B(_0402_), .Y(_0403_) );
  OR2 _0909_ ( .A(_0381_), .B(_0402_), .Y(_0404_) );
  NOR2 _0911_ ( .A(buf_m_3), .B(_0243_), .Y(_0405_) );
  OAI22 _0912_ ( .A1(_0061_), .A2(fo_net_33_g0), .B1(_0235_), .B2(_0057_), .Y(_0406_) );
  AOI21 _0913_ ( .A1(buf_l_3), .A2(fo_net_27_g0), .B(_0406_), .Y(_0407_) );
  NAND2 _0914_ ( .A(_0243_), .B(_0407_), .Y(_0408_) );
  AOI21 _0915_ ( .A1(_0244_), .A2(_0382_), .B(_0408_), .Y(_0409_) );
  NOR2 _0916_ ( .A(_0405_), .B(_0409_), .Y(_0041_) );
  NAND2 _0917_ ( .A(_0142_), .B(_0185_), .Y(_0410_) );
  OAI21 _0918_ ( .A1(_0142_), .A2(_0277_), .B(_0185_), .Y(_0411_) );
  AND4_X1 _0919_ ( .A(_0282_), .B(_0293_), .C(_0294_), .D(_0411_), .Y(_0412_) );
  AND4_X1 _0920_ ( .A(_0144_), .B(_0287_), .C(_0290_), .D(_0412_), .Y(_0413_) );
  NOR3 _0921_ ( .A(_0257_), .B(_0274_), .C(_0413_), .Y(_0414_) );
  OAI21 _0922_ ( .A1(_0189_), .A2(_0287_), .B(_0414_), .Y(_0415_) );
  NAND2 _0923_ ( .A(_0290_), .B(_0412_), .Y(_0416_) );
  AOI21 _0924_ ( .A1(_0063_), .A2(_0403_), .B(_0416_), .Y(_0417_) );
  NAND2 _0925_ ( .A(acc_3), .B(_0289_), .Y(_0418_) );
  NAND3 _0926_ ( .A(_0005_), .B(_0142_), .C(_0185_), .Y(_0419_) );
  NAND2 _0927_ ( .A(fo_net_10_g1), .B(_0288_), .Y(_0420_) );
  NAND4 _0928_ ( .A(_0282_), .B(_0418_), .C(_0419_), .D(_0420_), .Y(_0421_) );
  OAI21 _0929_ ( .A1(_0417_), .A2(_0421_), .B(_0287_), .Y(_0422_) );
  NAND3 _0930_ ( .A(_0137_), .B(_0187_), .C(_0287_), .Y(_0423_) );
  AOI21 _0931_ ( .A1(_0404_), .A2(_0423_), .B(_0415_), .Y(_0424_) );
  AOI22 _0932_ ( .A1(_0063_), .A2(_0415_), .B1(_0422_), .B2(_0424_), .Y(_0040_) );
  NAND2 _0933_ ( .A(fo_net_38_g1), .B(fo_net_20_g1), .Y(_0425_) );
  AOI21 _0934_ ( .A1(fo_net_50_g1), .A2(_0394_), .B(_0102_), .Y(_0426_) );
  OAI21 _0935_ ( .A1(_0112_), .A2(_0426_), .B(_0425_), .Y(_0039_) );
  AOI21 _0936_ ( .A1(_0057_), .A2(_0284_), .B(fo_net_51_g0), .Y(_0427_) );
  OAI21 _0937_ ( .A1(_0307_), .A2(_0427_), .B(_0382_), .Y(_0428_) );
  AOI22 _0938_ ( .A1(fo_net_8_g1), .A2(_0289_), .B1(_0291_), .B2(_0007_), .Y(_0429_) );
  AOI21 _0939_ ( .A1(cy), .A2(_0288_), .B(_0278_), .Y(_0430_) );
  NAND3 _0940_ ( .A(_0318_), .B(_0429_), .C(_0430_), .Y(_0431_) );
  NAND2 _0941_ ( .A(_0284_), .B(_0427_), .Y(_0432_) );
  AOI22 _0942_ ( .A1(fo_net_18_g1), .A2(_0298_), .B1(_0299_), .B2(fo_net_25_g0), .Y(_0433_) );
  AOI21 _0943_ ( .A1(_0300_), .A2(_0431_), .B(_0303_), .Y(_0434_) );
  AND3_X1 _0944_ ( .A(_0428_), .B(_0432_), .C(_0433_), .Y(_0435_) );
  AOI22 _0945_ ( .A1(_0053_), .A2(_0303_), .B1(_0434_), .B2(_0435_), .Y(_0038_) );
  AOI21 _0946_ ( .A1(_0099_), .A2(_0139_), .B(fo_net_34_g1), .Y(_0436_) );
  AOI21 _0947_ ( .A1(_0068_), .A2(_0079_), .B(fo_net_20_g1), .Y(_0437_) );
  NOR4 _0948_ ( .A(_0088_), .B(_0238_), .C(_0436_), .D(_0437_), .Y(_0438_) );
  XNOR2 _0949_ ( .A(sp_0), .B(fo_net_28_g1), .Y(_0439_) );
  NAND2 _0950_ ( .A(_0438_), .B(_0439_), .Y(_0440_) );
  XNOR2 _0951_ ( .A(sp_1), .B(_0440_), .Y(_0037_) );
  NOR4 _0952_ ( .A(_0254_), .B(fo_net_53_g0), .C(_0259_), .D(_0400_), .Y(d_hiz) );
  INV_X1 _0953_ ( .A(d_hiz), .Y(d_oe) );
  NAND2 _0954_ ( .A(_0240_), .B(_0362_), .Y(_0441_) );
  AOI22 _0955_ ( .A1(fo_net_17_g0), .A2(_0254_), .B1(fo_net_53_g0), .B2(_0363_), .Y(_0442_) );
  NAND3 _0956_ ( .A(acc_3), .B(_0253_), .C(_0259_), .Y(_0443_) );
  NAND4 _0957_ ( .A(_0368_), .B(_0441_), .C(_0442_), .D(_0443_), .Y(d_out[3]) );
  NAND2 _0958_ ( .A(fo_net_28_g1), .B(_0101_), .Y(_0444_) );
  AND3_X1 _0959_ ( .A(_0112_), .B(_0352_), .C(_0444_), .Y(_0445_) );
  NOR2 _0960_ ( .A(fo_net_25_g0), .B(fo_net_19_g0), .Y(_0446_) );
  OAI21 _0961_ ( .A1(fo_net_28_g1), .A2(_0382_), .B(fo_net_55_g0), .Y(_0447_) );
  OAI22 _0962_ ( .A1(_0065_), .A2(fo_net_56_g1), .B1(_0446_), .B2(_0447_), .Y(_0036_) );
  NOR2 _0963_ ( .A(buf_h_0), .B(fo_net_55_g0), .Y(_0448_) );
  OAI21 _0964_ ( .A1(fo_net_27_g0), .A2(_0246_), .B(fo_net_55_g0), .Y(_0449_) );
  AOI21 _0965_ ( .A1(fo_net_1_g0), .A2(fo_net_27_g0), .B(_0449_), .Y(_0450_) );
  NOR2 _0966_ ( .A(_0448_), .B(_0450_), .Y(_0035_) );
  NOR2 _0967_ ( .A(fo_net_27_g0), .B(_0197_), .Y(_0451_) );
  OAI21 _0968_ ( .A1(fo_net_3_g0), .A2(fo_net_19_g0), .B(fo_net_56_g1), .Y(_0452_) );
  OAI22 _0969_ ( .A1(_0064_), .A2(fo_net_55_g0), .B1(_0451_), .B2(_0452_), .Y(_0034_) );
  AND2_X1 _0970_ ( .A(fo_net_19_g0), .B(_0228_), .Y(_0453_) );
  OAI21 _0971_ ( .A1(fo_net_23_g0), .A2(fo_net_20_g1), .B(fo_net_56_g1), .Y(_0454_) );
  OAI22 _0972_ ( .A1(_0066_), .A2(fo_net_56_g1), .B1(_0453_), .B2(_0454_), .Y(_0033_) );
  OR2 _0974_ ( .A(_0004_), .B(_0351_), .Y(cm_ram[3]) );
  NAND3 _0975_ ( .A(_0187_), .B(_0282_), .C(_0410_), .Y(_0455_) );
  AOI21 _0976_ ( .A1(_0258_), .A2(_0455_), .B(fo_net_54_g1), .Y(cm_rom) );
  NAND2 _0977_ ( .A(fo_net_29_g0), .B(_0110_), .Y(_0456_) );
  NAND3 _0978_ ( .A(fo_net_28_g1), .B(_0333_), .C(_0395_), .Y(_0457_) );
  AOI21 _0979_ ( .A1(_0085_), .A2(_0268_), .B(_0096_), .Y(_0458_) );
  AOI21 _0980_ ( .A1(fo_net_36_g1), .A2(_0093_), .B(_0458_), .Y(_0459_) );
  OAI21 _0981_ ( .A1(_0456_), .A2(_0457_), .B(_0459_), .Y(sram_we) );
  NAND2 _0982_ ( .A(buf_l_3), .B(_0269_), .Y(_0460_) );
  AOI22 _0983_ ( .A1(buf_h_3), .A2(_0267_), .B1(_0270_), .B2(buf_m_3), .Y(_0461_) );
  NAND2 _0984_ ( .A(_0460_), .B(_0461_), .Y(sram_din[3]) );
  AOI21 _0985_ ( .A1(_0056_), .A2(fo_net_39_g0), .B(fo_net_33_g0), .Y(_0462_) );
  OAI21 _0986_ ( .A1(_0090_), .A2(_0462_), .B(_0245_), .Y(_0463_) );
  MUX2 _0987_ ( .A(fo_net_16_g1), .B(buf_m_0), .S(fo_net_37_g0), .Y(_0464_) );
  AOI22 _0988_ ( .A1(din0_in_th), .A2(_0084_), .B1(_0464_), .B2(fo_net_27_g0), .Y(_0465_) );
  NAND2 _0989_ ( .A(fo_net_39_g0), .B(_0462_), .Y(_0466_) );
  NAND3 _0990_ ( .A(_0463_), .B(_0465_), .C(_0466_), .Y(_0467_) );
  NOR2 _0992_ ( .A(_0086_), .B(_0456_), .Y(_0468_) );
  NAND3 _0993_ ( .A(opr_0), .B(_0513_), .C(opr_1), .Y(_0469_) );
  NAND2 _0994_ ( .A(opr_2), .B(_0469_), .Y(_0470_) );
  NAND2 _0995_ ( .A(opr_3), .B(_0470_), .Y(_0471_) );
  AOI21 _0996_ ( .A1(fo_net_40_g1), .A2(_0471_), .B(_0257_), .Y(_0472_) );
  NOR3 _0997_ ( .A(_0393_), .B(_0468_), .C(_0472_), .Y(_0473_) );
  AOI21 _0998_ ( .A1(_0395_), .A2(_0473_), .B(_0088_), .Y(_0474_) );
  NOR2 _0999_ ( .A(fo_net_35_g0), .B(_0096_), .Y(_0475_) );
  OAI21 _1000_ ( .A1(fo_net_54_g1), .A2(_0475_), .B(pc_init_n), .Y(_0476_) );
  INV_X1 _1001_ ( .A(_0476_), .Y(_0477_) );
  NOR3 _1002_ ( .A(_0458_), .B(_0474_), .C(_0477_), .Y(_0478_) );
  NOR3 _1003_ ( .A(rst_in_th), .B(clk_buf_r9), .C(_0478_), .Y(sram_ce) );
  OAI21 _1004_ ( .A1(din0_in_th), .A2(_0285_), .B(_0140_), .Y(_0479_) );
  OAI21 _1005_ ( .A1(_0073_), .A2(_0313_), .B(_0310_), .Y(_0480_) );
  OAI21 _1006_ ( .A1(_0316_), .A2(_0480_), .B(_0296_), .Y(_0481_) );
  OAI21 _1007_ ( .A1(_0289_), .A2(_0292_), .B(cy), .Y(_0482_) );
  AOI22 _1008_ ( .A1(_0005_), .A2(_0278_), .B1(_0288_), .B2(fo_net_6_g1), .Y(_0483_) );
  NAND2 _1009_ ( .A(_0482_), .B(_0483_), .Y(_0484_) );
  AOI21 _1010_ ( .A1(_0512_), .A2(_0291_), .B(_0484_), .Y(_0485_) );
  AOI21 _1011_ ( .A1(_0481_), .A2(_0485_), .B(_0301_), .Y(_0486_) );
  AOI22 _1012_ ( .A1(fo_net_16_g1), .A2(_0298_), .B1(_0299_), .B2(fo_net_1_g0), .Y(_0487_) );
  AOI21 _1013_ ( .A1(_0306_), .A2(_0479_), .B(_0246_), .Y(_0488_) );
  OAI21 _1014_ ( .A1(_0285_), .A2(_0479_), .B(_0487_), .Y(_0489_) );
  NOR4 _1015_ ( .A(_0303_), .B(_0486_), .C(_0488_), .D(_0489_), .Y(_0490_) );
  AOI21 _1016_ ( .A1(_0056_), .A2(_0303_), .B(_0490_), .Y(_0031_) );
  MUXDFFRB _1017_ ( .CK(clk_buf_r4), .Q(pc_cout), .QB(_0493_), .RSTB(rst_n_buf_r4), .A(_0404_), .B(pc_cout), .S(_0401_) );
  DFFRB _1018_ ( .CK(clk_buf_r5), .D(_0035_), .Q(buf_h_0), .QB(_0497_), .RSTB(rst_n_buf_r5) );
  DFFRB _1019_ ( .CK(clk_buf_r6), .D(_0034_), .Q(buf_h_1), .QB(_0498_), .RSTB(rst_n_buf_r6) );
  DFFRB _1020_ ( .CK(clk_buf_r6), .D(_0033_), .Q(buf_h_2), .QB(_0499_), .RSTB(rst_n_buf_r6) );
  DFFRB _1021_ ( .CK(clk_buf_r7), .D(_0036_), .Q(buf_h_3), .QB(_0496_), .RSTB(rst_n_buf_r7) );
  MUXDFFRB _1022_ ( .CK(clk_buf_r8), .Q(sp_0), .QB(_0509_), .RSTB(rst_n_buf_r8), .A(sp_0), .B(_0509_), .S(_0438_) );
  DFFRB _1023_ ( .CK(clk_buf_r8), .D(_0037_), .Q(sp_1), .QB(_0495_), .RSTB(rst_n_buf_r8) );
  DFFRB _1024_ ( .CK(clk_buf_r2), .D(_0031_), .Q(acc_0), .QB(_0512_), .RSTB(rst_n_buf_r2) );
  MUXDFFRB _1025_ ( .CK(clk_buf_r1), .Q(acc_1), .QB(_0510_), .RSTB(rst_n_buf_r1), .A(_0347_), .B(fo_net_5_g0), .S(_0303_) );
  DFFRB _1026_ ( .CK(clk_buf_r1), .D(_0029_), .Q(acc_2), .QB(_0511_), .RSTB(rst_n_buf_r1) );
  DFFRB _1027_ ( .CK(clk_buf_r2), .D(_0038_), .Q(acc_3), .QB(_0007_), .RSTB(rst_n_buf_r2) );
  DFFRB _1028_ ( .CK(clk_buf_r6), .D(_0039_), .Q(two_cycle), .QB(_0006_), .RSTB(rst_n_buf_r6) );
  DFFRB _1029_ ( .CK(clk_buf_r1), .D(_0040_), .Q(cy), .QB(_0005_), .RSTB(rst_n_buf_r1) );
  MUXDFFRB _1030_ ( .CK(clk_buf_r9), .Q(buf_m_0), .QB(_0500_), .RSTB(rst_n_buf_r9), .A(buf_m_0), .B(_0250_), .S(_0243_) );
  MUXDFFRB _1031_ ( .CK(clk_buf_r7), .Q(buf_m_1), .QB(_0501_), .RSTB(rst_n_buf_r7), .A(buf_m_1), .B(_0359_), .S(_0243_) );
  MUXDFFRB _1032_ ( .CK(clk_buf_r9), .Q(buf_m_2), .QB(_0502_), .RSTB(rst_n_buf_r9), .A(buf_m_2), .B(_0392_), .S(_0243_) );
  DFFRB _1033_ ( .CK(clk_buf_r8), .D(_0041_), .Q(buf_m_3), .QB(_0494_), .RSTB(rst_n_buf_r8) );
  MUXDFFRB _1034_ ( .CK(clk_buf_r3), .Q(bank_sel_1), .QB(_0008_), .RSTB(rst_n_buf_r3), .A(fo_net_10_g1), .B(bank_sel_1), .S(_0330_) );
  MUXDFFRB _1035_ ( .CK(clk_buf_r4), .Q(bank_sel_2), .QB(_0009_), .RSTB(rst_n_buf_r4), .A(fo_net_6_g1), .B(bank_sel_2), .S(_0330_) );
  MUXDFFRB _1036_ ( .CK(clk_buf_r3), .Q(bank_sel_3), .QB(_0004_), .RSTB(rst_n_buf_r3), .A(fo_net_8_g1), .B(bank_sel_3), .S(_0330_) );
  MUXDFFRB _1037_ ( .CK(clk_buf_r5), .Q(opr_0), .QB(_0514_), .RSTB(rst_n_buf_r5), .A(din0_in_th), .B(opr_0), .S(_0273_) );
  MUXDFFRB _1038_ ( .CK(clk_buf_r5), .Q(opr_1), .QB(_0010_), .RSTB(rst_n_buf_r5), .A(din1_in_th), .B(opr_1), .S(_0273_) );
  MUXDFFRB _1039_ ( .CK(clk_buf_r5), .Q(opr_2), .QB(_0513_), .RSTB(rst_n_buf_r5), .A(din2_in_th), .B(opr_2), .S(_0273_) );
  MUXDFFRB _1040_ ( .CK(clk_buf_r4), .Q(opr_3), .QB(_0003_), .RSTB(rst_n_buf_r4), .A(din3_in_th), .B(opr_3), .S(_0273_) );
  MUXDFFRB _1041_ ( .CK(clk_buf_r6), .Q(isz_taken), .QB(_0492_), .RSTB(rst_n_buf_r6), .A(isz_taken), .B(_0399_), .S(_0398_) );
  MUXDFFRB _1042_ ( .CK(clk_buf_r7), .Q(buf_l_0), .QB(_0503_), .RSTB(rst_n_buf_r7), .A(buf_l_0), .B(_0467_), .S(_0116_) );
  MUXDFFRB _1043_ ( .CK(clk_buf_r9), .Q(buf_l_1), .QB(_0504_), .RSTB(rst_n_buf_r9), .A(buf_l_1), .B(_0202_), .S(_0116_) );
  MUXDFFRB _1044_ ( .CK(clk_buf_r8), .Q(buf_l_2), .QB(_0505_), .RSTB(rst_n_buf_r8), .A(buf_l_2), .B(_0233_), .S(_0116_) );
  DFFRB _1045_ ( .CK(clk_buf_r6), .D(_0046_), .Q(buf_l_3), .QB(_0491_), .RSTB(rst_n_buf_r6) );
  MUXDFFRB _1046_ ( .CK(clk_buf_r7), .Q(pc_init_n), .QB(_0001_), .RSTB(rst_n_buf_r7), .A(pc_init_n), .B(fo_net_19_g0), .S(_0354_) );
  MUXDFFRB _1047_ ( .CK(clk_buf_r4), .Q(opa_0), .QB(_0011_), .RSTB(rst_n_buf_r4), .A(din0_in_th), .B(fo_net_2_g1), .S(_0236_) );
  MUXDFFRB _1048_ ( .CK(clk_buf_r2), .Q(opa_1), .QB(_0012_), .RSTB(rst_n_buf_r2), .A(din1_in_th), .B(fo_net_4_g1), .S(_0236_) );
  MUXDFFRB _1049_ ( .CK(clk_buf_r2), .Q(opa_2), .QB(_0013_), .RSTB(rst_n_buf_r2), .A(din2_in_th), .B(fo_net_23_g0), .S(_0236_) );
  MUXDFFRB _1050_ ( .CK(clk_buf_r3), .Q(opa_3), .QB(_0000_), .RSTB(rst_n_buf_r3), .A(din3_in_th), .B(fo_net_25_g0), .S(_0236_) );
  DFFRB _1051_ ( .CK(clk_buf_r5), .D(_0506_), .Q(phase_0), .QB(_0506_), .RSTB(rst_n_buf_r5) );
  DFFRB _1052_ ( .CK(clk_buf_r4), .D(_0507_), .Q(phase_1), .QB(_0014_), .RSTB(rst_n_buf_r4) );
  DFFRB _1053_ ( .CK(clk_buf_r3), .D(_0508_), .Q(phase_2), .QB(_0002_), .RSTB(rst_n_buf_r3) );
  SRAM128 u_sram ( .A0(sram_addr_0), .A1(sram_addr_1), .A2(sram_addr_2), .A3(sram_addr_3), .A4(sram_addr_4), .CE(sram_ce), .DIN(sram_din), .DO(sram_do), .WR(sram_we) );
  BUFTH u_bufth_clk ( .A(clk), .Y(clk_in_th) );
  BUFTH u_bufth_rst ( .A(rst), .Y(rst_in_th) );
  BUFTH u_bufth_test ( .A(test), .Y(test_in_th) );
  BUFTH u_bufth_din0 ( .A(d_in[0]), .Y(din0_in_th) );
  BUFTH u_bufth_din1 ( .A(d_in[1]), .Y(din1_in_th) );
  BUFTH u_bufth_din2 ( .A(d_in[2]), .Y(din2_in_th) );
  BUFTH u_bufth_din3 ( .A(d_in[3]), .Y(din3_in_th) );
  BUF_X2 u_clk_buf_r1 ( .A(clk_in_th), .Y(clk_buf_r1) );
  BUF_X2 u_rst_buf_r1 ( .A(rst_n), .Y(rst_n_buf_r1) );
  BUF_X2 u_clk_buf_r2 ( .A(clk_in_th), .Y(clk_buf_r2) );
  BUF_X2 u_rst_buf_r2 ( .A(rst_n), .Y(rst_n_buf_r2) );
  BUF_X2 u_clk_buf_r3 ( .A(clk_in_th), .Y(clk_buf_r3) );
  BUF_X2 u_rst_buf_r3 ( .A(rst_n), .Y(rst_n_buf_r3) );
  BUF_X2 u_clk_buf_r4 ( .A(clk_in_th), .Y(clk_buf_r4) );
  BUF_X2 u_rst_buf_r4 ( .A(rst_n), .Y(rst_n_buf_r4) );
  BUF_X2 u_clk_buf_r5 ( .A(clk_in_th), .Y(clk_buf_r5) );
  BUF_X2 u_rst_buf_r5 ( .A(rst_n), .Y(rst_n_buf_r5) );
  BUF_X2 u_clk_buf_r6 ( .A(clk_in_th), .Y(clk_buf_r6) );
  BUF_X2 u_rst_buf_r6 ( .A(rst_n), .Y(rst_n_buf_r6) );
  BUF_X2 u_clk_buf_r7 ( .A(clk_in_th), .Y(clk_buf_r7) );
  BUF_X2 u_rst_buf_r7 ( .A(rst_n), .Y(rst_n_buf_r7) );
  BUF_X2 u_clk_buf_r8 ( .A(clk_in_th), .Y(clk_buf_r8) );
  BUF_X2 u_rst_buf_r8 ( .A(rst_n), .Y(rst_n_buf_r8) );
  BUF_X2 u_clk_buf_r9 ( .A(clk_in_th), .Y(clk_buf_r9) );
  BUF_X2 u_rst_buf_r9 ( .A(rst_n), .Y(rst_n_buf_r9) );
  BUF_X2 u_fobuf_1_g0 ( .A(opa_0), .Y(fo_net_1_g0) );
  BUF_X2 u_fobuf_2_g1 ( .A(opa_0), .Y(fo_net_2_g1) );
  BUF_X2 u_fobuf_3_g0 ( .A(opa_1), .Y(fo_net_3_g0) );
  BUF_X2 u_fobuf_4_g1 ( .A(opa_1), .Y(fo_net_4_g1) );
  BUF_X2 u_fobuf_5_g0 ( .A(acc_1), .Y(fo_net_5_g0) );
  BUF_X2 u_fobuf_6_g1 ( .A(acc_1), .Y(fo_net_6_g1) );
  BUF_X2 u_fobuf_7_g0 ( .A(acc_2), .Y(fo_net_7_g0) );
  BUF_X2 u_fobuf_8_g1 ( .A(acc_2), .Y(fo_net_8_g1) );
  BUF_X2 u_fobuf_9_g0 ( .A(acc_0), .Y(fo_net_9_g0) );
  BUF_X2 u_fobuf_10_g1 ( .A(acc_0), .Y(fo_net_10_g1) );
  BUF_X2 u_fobuf_11_g0 ( .A(sram_do[2]), .Y(fo_net_11_g0) );
  BUF_X2 u_fobuf_12_g1 ( .A(sram_do[2]), .Y(fo_net_12_g1) );
  BUF_X2 u_fobuf_13_g0 ( .A(sram_do[1]), .Y(fo_net_13_g0) );
  BUF_X2 u_fobuf_14_g1 ( .A(sram_do[1]), .Y(fo_net_14_g1) );
  BUF_X2 u_fobuf_15_g0 ( .A(sram_do[0]), .Y(fo_net_15_g0) );
  BUF_X2 u_fobuf_16_g1 ( .A(sram_do[0]), .Y(fo_net_16_g1) );
  BUF_X2 u_fobuf_17_g0 ( .A(sram_do[3]), .Y(fo_net_17_g0) );
  BUF_X2 u_fobuf_18_g1 ( .A(sram_do[3]), .Y(fo_net_18_g1) );
  BUF_X2 u_fobuf_19_g0 ( .A(_0067_), .Y(fo_net_19_g0) );
  BUF_X2 u_fobuf_20_g1 ( .A(_0067_), .Y(fo_net_20_g1) );
  BUF_X2 u_fobuf_21_g0 ( .A(_0010_), .Y(fo_net_21_g0) );
  BUF_X2 u_fobuf_22_g1 ( .A(_0010_), .Y(fo_net_22_g1) );
  BUF_X2 u_fobuf_23_g0 ( .A(opa_2), .Y(fo_net_23_g0) );
  BUF_X2 u_fobuf_24_g1 ( .A(opa_2), .Y(fo_net_24_g1) );
  BUF_X2 u_fobuf_25_g0 ( .A(opa_3), .Y(fo_net_25_g0) );
  BUF_X2 u_fobuf_26_g1 ( .A(opa_3), .Y(fo_net_26_g1) );
  BUF_X2 u_fobuf_27_g0 ( .A(sync), .Y(fo_net_27_g0) );
  BUF_X2 u_fobuf_28_g1 ( .A(sync), .Y(fo_net_28_g1) );
  BUF_X2 u_fobuf_29_g0 ( .A(_0006_), .Y(fo_net_29_g0) );
  BUF_X2 u_fobuf_30_g1 ( .A(_0006_), .Y(fo_net_30_g1) );
  BUF_X2 u_fobuf_31_g0 ( .A(phase_0), .Y(fo_net_31_g0) );
  BUF_X2 u_fobuf_32_g1 ( .A(phase_0), .Y(fo_net_32_g1) );
  BUF_X2 u_fobuf_33_g0 ( .A(_0087_), .Y(fo_net_33_g0) );
  BUF_X2 u_fobuf_34_g1 ( .A(_0087_), .Y(fo_net_34_g1) );
  BUF_X2 u_fobuf_35_g0 ( .A(_0089_), .Y(fo_net_35_g0) );
  BUF_X2 u_fobuf_36_g1 ( .A(_0089_), .Y(fo_net_36_g1) );
  BUF_X2 u_fobuf_37_g0 ( .A(two_cycle), .Y(fo_net_37_g0) );
  BUF_X2 u_fobuf_38_g1 ( .A(two_cycle), .Y(fo_net_38_g1) );
  BUF_X2 u_fobuf_39_g0 ( .A(_0107_), .Y(fo_net_39_g0) );
  BUF_X2 u_fobuf_40_g1 ( .A(_0107_), .Y(fo_net_40_g1) );
  BUF_X2 u_fobuf_41_g0 ( .A(_0119_), .Y(fo_net_41_g0) );
  BUF_X2 u_fobuf_42_g1 ( .A(_0119_), .Y(fo_net_42_g1) );
  BUF_X2 u_fobuf_43_g0 ( .A(_0118_), .Y(fo_net_43_g0) );
  BUF_X2 u_fobuf_44_g1 ( .A(_0118_), .Y(fo_net_44_g1) );
  BUF_X2 u_fobuf_45_g0 ( .A(_0070_), .Y(fo_net_45_g0) );
  BUF_X2 u_fobuf_46_g1 ( .A(_0070_), .Y(fo_net_46_g1) );
  BUF_X2 u_fobuf_47_g0 ( .A(_0000_), .Y(fo_net_47_g0) );
  BUF_X2 u_fobuf_48_g1 ( .A(_0000_), .Y(fo_net_48_g1) );
  BUF_X2 u_fobuf_49_g0 ( .A(_0011_), .Y(fo_net_49_g0) );
  BUF_X2 u_fobuf_50_g1 ( .A(_0011_), .Y(fo_net_50_g1) );
  BUF_X2 u_fobuf_51_g0 ( .A(_0141_), .Y(fo_net_51_g0) );
  BUF_X2 u_fobuf_52_g1 ( .A(_0141_), .Y(fo_net_52_g1) );
  BUF_X2 u_fobuf_53_g0 ( .A(_0255_), .Y(fo_net_53_g0) );
  BUF_X2 u_fobuf_54_g1 ( .A(_0255_), .Y(fo_net_54_g1) );
  BUF_X2 u_fobuf_55_g0 ( .A(_0445_), .Y(fo_net_55_g0) );
  BUF_X2 u_fobuf_56_g1 ( .A(_0445_), .Y(fo_net_56_g1) );
endmodule
