jun1okamura/TR-1um_C4004_Clone2Build/TR-1um_C4004_02/openroad/c4004_core_syn.v

// Synthesized and Buffered Gate-Level Netlist for c4004_core (Trial 02: 10 Rows)
module c4004_core (
  clk,
  rst,
  test,
  d_in,
  d_out,
  d_oe,
  d_hiz,
  sync,
  cm_rom,
  cm_ram
);
  input clk;
  input rst;
  input test;
  input [3:0] d_in;
  output [3:0] d_out;
  output d_oe;
  output d_hiz;
  output sync;
  output cm_rom;
  output [3:0] cm_ram;

  wire [3:0] sram_din;
  wire [3:0] sram_do;
  wire _0000_;
  wire _0001_;
  wire _0002_;
  wire _0003_;
  wire _0004_;
  wire _0005_;
  wire _0006_;
  wire _0007_;
  wire _0008_;
  wire _0009_;
  wire _0010_;
  wire _0011_;
  wire _0012_;
  wire _0013_;
  wire _0014_;
  wire _0029_;
  wire _0031_;
  wire _0033_;
  wire _0034_;
  wire _0035_;
  wire _0036_;
  wire _0037_;
  wire _0038_;
  wire _0039_;
  wire _0040_;
  wire _0045_;
  wire _0048_;
  wire _0049_;
  wire _0050_;
  wire _0051_;
  wire _0052_;
  wire _0053_;
  wire _0054_;
  wire _0055_;
  wire _0056_;
  wire _0057_;
  wire _0058_;
  wire _0059_;
  wire _0060_;
  wire _0061_;
  wire _0062_;
  wire _0063_;
  wire _0064_;
  wire _0065_;
  wire _0066_;
  wire _0067_;
  wire _0068_;
  wire _0069_;
  wire _0070_;
  wire _0071_;
  wire _0072_;
  wire _0073_;
  wire _0074_;
  wire _0075_;
  wire _0076_;
  wire _0077_;
  wire _0078_;
  wire _0079_;
  wire _0080_;
  wire _0081_;
  wire _0082_;
  wire _0083_;
  wire _0084_;
  wire _0085_;
  wire _0086_;
  wire _0087_;
  wire _0088_;
  wire _0089_;
  wire _0090_;
  wire _0091_;
  wire _0092_;
  wire _0093_;
  wire _0094_;
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
  wire fo_net_25_g0;
  wire fo_net_26_g1;
  wire fo_net_27_g0;
  wire fo_net_28_g1;
  wire fo_net_29_g0;
  wire fo_net_2_g1;
  wire fo_net_30_g1;
  wire fo_net_31_g0;
  wire fo_net_32_g1;
  wire fo_net_33_g0;
  wire fo_net_34_g1;
  wire fo_net_35_g0;
  wire fo_net_36_g1;
  wire fo_net_3_g0;
  wire fo_net_4_g1;
  wire fo_net_5_g0;
  wire fo_net_6_g1;
  wire fo_net_7_g0;
  wire fo_net_8_g1;
  wire fo_net_9_g0;
  wire isz_taken;
  wire opa_0;
  wire opa_1;
  wire opa_2;
  wire opa_3;
  wire opr_0;
  wire opr_1;
  wire opr_2;
  wire opr_3;
  wire pc_cout;
  wire pc_init_n;
  wire phase_0;
  wire phase_1;
  wire phase_2;
  wire rst_in_th;
  wire rst_n;
  wire rst_n_buf_r1;
  wire rst_n_buf_r10;
  wire rst_n_buf_r2;
  wire rst_n_buf_r3;
  wire rst_n_buf_r4;
  wire rst_n_buf_r5;
  wire rst_n_buf_r6;
  wire rst_n_buf_r7;
  wire rst_n_buf_r8;
  wire rst_n_buf_r9;
  wire sp_0;
  wire sp_1;
  wire sram_addr_0;
  wire sram_addr_1;
  wire sram_addr_2;
  wire sram_addr_3;
  wire sram_addr_4;
  wire sram_ce;
  wire sram_we;
  wire test_in_th;
  wire two_cycle;
  INV_X1 _0513_ ( .A(fo_net_2_g1), .Y(_0049_) );
  INV_X1 _0514_ ( .A(din0_in_th), .Y(_0050_) );
  INV_X1 _0515_ ( .A(fo_net_4_g1), .Y(_0051_) );
  INV_X1 _0516_ ( .A(din1_in_th), .Y(_0052_) );
  INV_X1 _0517_ ( .A(din2_in_th), .Y(_0053_) );
  INV_X1 _0518_ ( .A(fo_net_5_g0), .Y(_0054_) );
  INV_X1 _0519_ ( .A(_0011_), .Y(_0055_) );
  INV_X1 _0520_ ( .A(cy), .Y(_0056_) );
  INV_X1 _0521_ ( .A(fo_net_8_g1), .Y(_0057_) );
  INV_X1 _0522_ ( .A(sp_1), .Y(_0058_) );
  INV_X1 _0523_ ( .A(acc_3), .Y(_0059_) );
  INV_X1 _0524_ ( .A(fo_net_10_g1), .Y(_0060_) );
  INV_X1 _0525_ ( .A(sp_0), .Y(_0061_) );
  INV_X1 _0526_ ( .A(fo_net_12_g1), .Y(_0062_) );
  INV_X1 _0527_ ( .A(rst_in_th), .Y(rst_n) );
  INV_X1 _0528_ ( .A(buf_h_1), .Y(_0063_) );
  INV_X1 _0529_ ( .A(phase_2), .Y(_0064_) );
  INV_X1 _0530_ ( .A(fo_net_13_g0), .Y(_0065_) );
  INV_X1 _0531_ ( .A(din3_in_th), .Y(_0066_) );
  INV_X1 _0532_ ( .A(two_cycle), .Y(_0067_) );
  INV_X1 _0533_ ( .A(fo_net_15_g0), .Y(_0068_) );
  INV_X1 _0534_ ( .A(_0009_), .Y(_0069_) );
  INV_X1 _0535_ ( .A(_0008_), .Y(_0070_) );
  INV_X1 _0536_ ( .A(_0004_), .Y(_0071_) );
  OR3 _0537_ ( .A(_0002_), .B(_0014_), .C(_0504_), .Y(_0072_) );
  INV_X1 _0538_ ( .A(fo_net_17_g0), .Y(sync) );
  NOR2 _0539_ ( .A(opr_3), .B(_0511_), .Y(_0073_) );
  NOR3 _0540_ ( .A(fo_net_19_g0), .B(opr_3), .C(_0511_), .Y(_0074_) );
  OR3 _0541_ ( .A(fo_net_19_g0), .B(opr_3), .C(_0511_), .Y(_0075_) );
  OR2 _0542_ ( .A(_0512_), .B(_0075_), .Y(_0076_) );
  NOR4 _0543_ ( .A(fo_net_7_g0), .B(acc_3), .C(fo_net_9_g0), .D(fo_net_11_g0), .Y(_0077_) );
  AOI22 _0544_ ( .A1(fo_net_4_g1), .A2(cy), .B1(_0077_), .B2(fo_net_21_g0), .Y(_0078_) );
  OAI21 _0545_ ( .A1(_0049_), .A2(test_in_th), .B(_0078_), .Y(_0079_) );
  XOR2 _0546_ ( .A(fo_net_24_g1), .B(_0079_), .Y(_0080_) );
  NOR2 _0547_ ( .A(opr_3), .B(opr_2), .Y(_0081_) );
  NOR2 _0548_ ( .A(opr_1), .B(_0512_), .Y(_0082_) );
  NAND2 _0549_ ( .A(_0081_), .B(_0082_), .Y(_0083_) );
  OAI22 _0550_ ( .A1(isz_taken), .A2(_0076_), .B1(_0080_), .B2(_0083_), .Y(_0084_) );
  NAND2 _0551_ ( .A(fo_net_26_g1), .B(_0084_), .Y(_0085_) );
  NOR2 _0552_ ( .A(fo_net_28_g1), .B(_0085_), .Y(_0086_) );
  NOR3 _0553_ ( .A(_0002_), .B(phase_0), .C(_0014_), .Y(_0087_) );
  OR3 _0554_ ( .A(_0002_), .B(phase_0), .C(_0014_), .Y(_0088_) );
  NOR2 _0555_ ( .A(opr_0), .B(fo_net_19_g0), .Y(_0089_) );
  AOI21 _0556_ ( .A1(opr_0), .A2(_0512_), .B(fo_net_20_g1), .Y(_0090_) );
  INV_X1 _0557_ ( .A(_0090_), .Y(_0091_) );
  NAND2 _0558_ ( .A(_0073_), .B(_0090_), .Y(_0092_) );
  OR4 _0559_ ( .A(fo_net_20_g1), .B(opr_2), .C(_0003_), .D(_0512_), .Y(_0093_) );
  NAND2 _0560_ ( .A(_0092_), .B(_0093_), .Y(_0094_) );
  NOR4 _0561_ ( .A(fo_net_20_g1), .B(opr_3), .C(opr_2), .D(_0512_), .Y(_0095_) );
  NOR2 _0562_ ( .A(two_cycle), .B(fo_net_18_g1), .Y(_0096_) );
  OAI22 _0563_ ( .A1(two_cycle), .A2(fo_net_18_g1), .B1(fo_net_30_g1), .B2(fo_net_28_g1), .Y(_0097_) );
  OAI21 _0564_ ( .A1(fo_net_28_g1), .A2(fo_net_30_g1), .B(_0095_), .Y(_0098_) );
  NAND2 _0565_ ( .A(_0097_), .B(_0098_), .Y(_0099_) );
  NOR3 _0566_ ( .A(phase_2), .B(_0014_), .C(_0504_), .Y(_0100_) );
  NAND2 _0567_ ( .A(_0067_), .B(_0100_), .Y(_0101_) );
  AOI21 _0568_ ( .A1(opr_0), .A2(_0512_), .B(opr_1), .Y(_0102_) );
  NAND2 _0569_ ( .A(_0073_), .B(_0102_), .Y(_0103_) );
  NAND3 _0570_ ( .A(_0076_), .B(_0083_), .C(_0103_), .Y(_0104_) );
  OR2 _0571_ ( .A(fo_net_18_g1), .B(_0104_), .Y(_0105_) );
  NOR2 _0572_ ( .A(fo_net_28_g1), .B(_0105_), .Y(_0106_) );
  NAND2 _0573_ ( .A(two_cycle), .B(_0081_), .Y(_0107_) );
  NOR2 _0574_ ( .A(fo_net_19_g0), .B(_0107_), .Y(_0108_) );
  OR2 _0575_ ( .A(fo_net_19_g0), .B(_0107_), .Y(_0109_) );
  NOR2 _0576_ ( .A(_0512_), .B(_0109_), .Y(_0110_) );
  NAND2 _0577_ ( .A(two_cycle), .B(_0095_), .Y(_0111_) );
  NOR3 _0578_ ( .A(phase_2), .B(phase_0), .C(phase_1), .Y(_0112_) );
  NOR2 _0579_ ( .A(fo_net_26_g1), .B(_0087_), .Y(_0113_) );
  NAND2 _0580_ ( .A(fo_net_18_g1), .B(fo_net_29_g0), .Y(_0114_) );
  NOR2 _0581_ ( .A(_0100_), .B(fo_net_31_g0), .Y(_0115_) );
  OR2 _0582_ ( .A(_0100_), .B(fo_net_32_g1), .Y(_0116_) );
  OAI22 _0583_ ( .A1(fo_net_30_g1), .A2(_0094_), .B1(_0112_), .B2(_0116_), .Y(_0117_) );
  AOI21 _0584_ ( .A1(_0110_), .A2(_0112_), .B(_0117_), .Y(_0118_) );
  NAND3 _0585_ ( .A(_0099_), .B(_0101_), .C(_0118_), .Y(_0119_) );
  NOR3 _0586_ ( .A(_0086_), .B(_0106_), .C(_0119_), .Y(_0120_) );
  AOI21 _0587_ ( .A1(_0060_), .A2(_0092_), .B(fo_net_29_g0), .Y(_0121_) );
  NOR2 _0588_ ( .A(phase_1), .B(_0504_), .Y(_0122_) );
  OR2 _0589_ ( .A(phase_1), .B(_0504_), .Y(_0123_) );
  AOI21 _0590_ ( .A1(two_cycle), .A2(_0095_), .B(_0001_), .Y(_0124_) );
  MUX2 _0591_ ( .A(buf_m_0), .B(fo_net_5_g0), .S(_0124_), .Y(_0125_) );
  MUX2 _0592_ ( .A(buf_h_0), .B(fo_net_5_g0), .S(pc_init_n), .Y(_0126_) );
  INV_X1 _0593_ ( .A(_0126_), .Y(_0127_) );
  OAI21 _0594_ ( .A1(phase_0), .A2(phase_1), .B(_0064_), .Y(_0128_) );
  AOI21 _0595_ ( .A1(_0123_), .A2(_0127_), .B(_0128_), .Y(_0129_) );
  OAI21 _0596_ ( .A1(_0123_), .A2(_0125_), .B(_0129_), .Y(_0130_) );
  MUX2 _0597_ ( .A(buf_l_0), .B(fo_net_5_g0), .S(_0124_), .Y(_0131_) );
  NAND2 _0598_ ( .A(_0112_), .B(_0131_), .Y(_0132_) );
  AOI21 _0599_ ( .A1(_0054_), .A2(_0074_), .B(_0064_), .Y(_0133_) );
  OAI21 _0600_ ( .A1(fo_net_11_g0), .A2(_0074_), .B(_0133_), .Y(_0134_) );
  NAND3 _0601_ ( .A(_0130_), .B(_0132_), .C(_0134_), .Y(_0135_) );
  NOR4 _0602_ ( .A(opr_1), .B(opr_2), .C(_0003_), .D(_0512_), .Y(_0136_) );
  OR4 _0603_ ( .A(opr_1), .B(opr_2), .C(_0003_), .D(_0512_), .Y(_0137_) );
  NOR2 _0604_ ( .A(_0511_), .B(_0003_), .Y(_0138_) );
  NOR4 _0605_ ( .A(opr_0), .B(fo_net_19_g0), .C(_0511_), .D(_0003_), .Y(_0139_) );
  OR4 _0606_ ( .A(opr_0), .B(fo_net_20_g1), .C(_0511_), .D(_0003_), .Y(_0140_) );
  NAND2 _0607_ ( .A(_0049_), .B(_0139_), .Y(_0141_) );
  NAND3 _0608_ ( .A(_0049_), .B(_0050_), .C(_0139_), .Y(_0142_) );
  NAND2 _0609_ ( .A(fo_net_2_g1), .B(_0139_), .Y(_0143_) );
  NAND3 _0610_ ( .A(fo_net_2_g1), .B(din0_in_th), .C(_0139_), .Y(_0144_) );
  NOR4 _0611_ ( .A(fo_net_2_g1), .B(fo_net_4_g1), .C(fo_net_22_g1), .D(_0000_), .Y(_0145_) );
  OR4 _0612_ ( .A(fo_net_2_g1), .B(fo_net_4_g1), .C(fo_net_22_g1), .D(_0000_), .Y(_0146_) );
  NAND2 _0613_ ( .A(_0140_), .B(_0145_), .Y(_0147_) );
  NAND3 _0614_ ( .A(_0142_), .B(_0144_), .C(_0147_), .Y(_0148_) );
  OR4 _0615_ ( .A(opr_0), .B(opr_1), .C(opr_2), .D(_0003_), .Y(_0149_) );
  OAI21 _0616_ ( .A1(fo_net_6_g1), .A2(_0137_), .B(fo_net_33_g0), .Y(_0150_) );
  AOI21 _0617_ ( .A1(_0137_), .A2(_0148_), .B(_0150_), .Y(_0151_) );
  NOR2 _0618_ ( .A(_0064_), .B(_0074_), .Y(_0152_) );
  NAND2 _0619_ ( .A(phase_2), .B(_0075_), .Y(_0153_) );
  OAI21 _0620_ ( .A1(fo_net_6_g1), .A2(fo_net_33_g0), .B(_0152_), .Y(_0154_) );
  NOR2 _0621_ ( .A(_0151_), .B(_0154_), .Y(_0155_) );
  NAND2 _0622_ ( .A(_0135_), .B(_0155_), .Y(_0156_) );
  NOR2 _0623_ ( .A(_0135_), .B(_0155_), .Y(_0157_) );
  XOR2 _0624_ ( .A(_0135_), .B(_0155_), .Y(_0158_) );
  OAI21 _0625_ ( .A1(_0136_), .A2(_0143_), .B(fo_net_34_g1), .Y(_0159_) );
  NAND2 _0626_ ( .A(cy), .B(_0159_), .Y(_0160_) );
  NOR2 _0627_ ( .A(fo_net_2_g1), .B(_0012_), .Y(_0161_) );
  NOR2 _0628_ ( .A(fo_net_22_g1), .B(fo_net_24_g1), .Y(_0162_) );
  NAND2 _0629_ ( .A(_0161_), .B(_0162_), .Y(_0163_) );
  AND2_X1 _0630_ ( .A(_0137_), .B(fo_net_34_g1), .Y(_0164_) );
  NAND2 _0631_ ( .A(_0140_), .B(_0164_), .Y(_0165_) );
  OR2 _0632_ ( .A(_0163_), .B(_0165_), .Y(_0166_) );
  NAND2 _0633_ ( .A(_0005_), .B(fo_net_34_g1), .Y(_0167_) );
  AOI21 _0634_ ( .A1(_0137_), .A2(_0141_), .B(_0167_), .Y(_0168_) );
  NAND3 _0635_ ( .A(_0152_), .B(_0160_), .C(_0166_), .Y(_0169_) );
  OAI22 _0636_ ( .A1(pc_cout), .A2(_0128_), .B1(_0168_), .B2(_0169_), .Y(_0170_) );
  OAI21 _0637_ ( .A1(_0157_), .A2(_0170_), .B(_0156_), .Y(_0171_) );
  MUX2 _0638_ ( .A(buf_m_1), .B(fo_net_15_g0), .S(_0124_), .Y(_0172_) );
  MUX2 _0639_ ( .A(buf_h_1), .B(fo_net_15_g0), .S(pc_init_n), .Y(_0173_) );
  INV_X1 _0640_ ( .A(_0173_), .Y(_0174_) );
  AOI21 _0641_ ( .A1(_0123_), .A2(_0174_), .B(_0128_), .Y(_0175_) );
  OAI21 _0642_ ( .A1(_0123_), .A2(_0172_), .B(_0175_), .Y(_0176_) );
  MUX2 _0643_ ( .A(buf_l_1), .B(fo_net_15_g0), .S(_0124_), .Y(_0177_) );
  NAND2 _0644_ ( .A(_0112_), .B(_0177_), .Y(_0178_) );
  AOI21 _0645_ ( .A1(_0068_), .A2(_0074_), .B(_0064_), .Y(_0179_) );
  OAI21 _0646_ ( .A1(fo_net_9_g0), .A2(_0074_), .B(_0179_), .Y(_0180_) );
  NAND3 _0647_ ( .A(_0176_), .B(_0178_), .C(_0180_), .Y(_0181_) );
  AND3_X1 _0648_ ( .A(_0509_), .B(fo_net_12_g1), .C(_0508_), .Y(_0182_) );
  AOI21 _0649_ ( .A1(fo_net_10_g1), .A2(_0509_), .B(fo_net_8_g1), .Y(_0183_) );
  NOR3 _0650_ ( .A(_0059_), .B(_0182_), .C(_0183_), .Y(_0184_) );
  NAND2 _0651_ ( .A(_0056_), .B(_0146_), .Y(_0185_) );
  NOR2 _0652_ ( .A(_0011_), .B(_0012_), .Y(_0186_) );
  OR4 _0653_ ( .A(fo_net_22_g1), .B(_0011_), .C(_0012_), .D(_0000_), .Y(_0187_) );
  AOI21 _0654_ ( .A1(_0146_), .A2(_0187_), .B(_0139_), .Y(_0188_) );
  OAI21 _0655_ ( .A1(_0184_), .A2(_0185_), .B(_0188_), .Y(_0189_) );
  MUX2 _0656_ ( .A(_0141_), .B(_0143_), .S(din1_in_th), .Y(_0190_) );
  AOI21 _0657_ ( .A1(_0189_), .A2(_0190_), .B(_0136_), .Y(_0191_) );
  OAI21 _0658_ ( .A1(fo_net_16_g1), .A2(_0137_), .B(fo_net_33_g0), .Y(_0192_) );
  OR2 _0659_ ( .A(_0191_), .B(_0192_), .Y(_0193_) );
  OR2 _0660_ ( .A(fo_net_16_g1), .B(fo_net_33_g0), .Y(_0194_) );
  NAND3 _0661_ ( .A(_0152_), .B(_0193_), .C(_0194_), .Y(_0195_) );
  AND4_X1 _0662_ ( .A(_0152_), .B(_0181_), .C(_0193_), .D(_0194_), .Y(_0196_) );
  XNOR2 _0663_ ( .A(_0181_), .B(_0195_), .Y(_0197_) );
  XNOR2 _0664_ ( .A(_0171_), .B(_0197_), .Y(_0198_) );
  INV_X1 _0665_ ( .A(_0198_), .Y(_0199_) );
  OAI21 _0666_ ( .A1(_0115_), .A2(_0121_), .B(_0199_), .Y(_0200_) );
  NAND2 _0667_ ( .A(_0092_), .B(_0121_), .Y(_0201_) );
  AND2_X1 _0668_ ( .A(two_cycle), .B(fo_net_26_g1), .Y(_0202_) );
  INV_X1 _0669_ ( .A(_0202_), .Y(_0203_) );
  NAND2 _0670_ ( .A(fo_net_16_g1), .B(_0096_), .Y(_0204_) );
  AOI22 _0671_ ( .A1(din1_in_th), .A2(_0100_), .B1(_0202_), .B2(buf_m_1), .Y(_0205_) );
  NAND4 _0672_ ( .A(_0200_), .B(_0201_), .C(_0204_), .D(_0205_), .Y(_0206_) );
  AOI21 _0674_ ( .A1(_0171_), .A2(_0197_), .B(_0196_), .Y(_0207_) );
  MUX2 _0675_ ( .A(buf_m_2), .B(fo_net_13_g0), .S(_0124_), .Y(_0208_) );
  MUX2 _0676_ ( .A(buf_h_2), .B(fo_net_13_g0), .S(pc_init_n), .Y(_0209_) );
  INV_X1 _0677_ ( .A(_0209_), .Y(_0210_) );
  AOI21 _0678_ ( .A1(_0123_), .A2(_0210_), .B(_0128_), .Y(_0211_) );
  OAI21 _0679_ ( .A1(_0123_), .A2(_0208_), .B(_0211_), .Y(_0212_) );
  MUX2 _0680_ ( .A(buf_l_2), .B(fo_net_13_g0), .S(_0124_), .Y(_0213_) );
  NAND2 _0681_ ( .A(_0112_), .B(_0213_), .Y(_0214_) );
  AOI21 _0682_ ( .A1(_0065_), .A2(_0074_), .B(_0064_), .Y(_0215_) );
  OAI21 _0683_ ( .A1(fo_net_7_g0), .A2(_0074_), .B(_0215_), .Y(_0216_) );
  NAND3 _0684_ ( .A(_0212_), .B(_0214_), .C(_0216_), .Y(_0217_) );
  MUX2 _0685_ ( .A(_0141_), .B(_0143_), .S(din2_in_th), .Y(_0218_) );
  AOI21 _0686_ ( .A1(_0189_), .A2(_0218_), .B(_0136_), .Y(_0219_) );
  OAI21 _0687_ ( .A1(fo_net_14_g1), .A2(_0137_), .B(fo_net_33_g0), .Y(_0220_) );
  NOR2 _0688_ ( .A(fo_net_14_g1), .B(fo_net_33_g0), .Y(_0221_) );
  OAI21 _0689_ ( .A1(_0219_), .A2(_0220_), .B(_0152_), .Y(_0222_) );
  NOR2 _0690_ ( .A(_0221_), .B(_0222_), .Y(_0223_) );
  NAND2 _0691_ ( .A(_0217_), .B(_0223_), .Y(_0224_) );
  XNOR2 _0692_ ( .A(_0217_), .B(_0223_), .Y(_0225_) );
  XOR2 _0693_ ( .A(_0207_), .B(_0225_), .Y(_0226_) );
  AOI21 _0694_ ( .A1(_0057_), .A2(_0092_), .B(fo_net_29_g0), .Y(_0227_) );
  OAI21 _0695_ ( .A1(_0115_), .A2(_0227_), .B(_0226_), .Y(_0228_) );
  NAND2 _0696_ ( .A(_0092_), .B(_0227_), .Y(_0229_) );
  NAND2 _0697_ ( .A(buf_m_2), .B(_0202_), .Y(_0230_) );
  AOI22 _0698_ ( .A1(fo_net_14_g1), .A2(_0096_), .B1(_0100_), .B2(din2_in_th), .Y(_0231_) );
  NAND4 _0699_ ( .A(_0228_), .B(_0229_), .C(_0230_), .D(_0231_), .Y(_0232_) );
  NOR3 _0701_ ( .A(_0002_), .B(phase_0), .C(phase_1), .Y(_0233_) );
  OR3 _0702_ ( .A(_0002_), .B(phase_0), .C(phase_1), .Y(_0234_) );
  NAND2 _0703_ ( .A(fo_net_27_g0), .B(_0233_), .Y(_0235_) );
  NOR2 _0707_ ( .A(phase_2), .B(_0123_), .Y(_0236_) );
  NOR2 _0708_ ( .A(_0233_), .B(_0236_), .Y(_0237_) );
  AOI22 _0709_ ( .A1(_0110_), .A2(_0236_), .B1(_0237_), .B2(_0113_), .Y(_0238_) );
  OAI22 _0710_ ( .A1(fo_net_29_g0), .A2(_0095_), .B1(_0234_), .B2(two_cycle), .Y(_0239_) );
  NOR2 _0711_ ( .A(_0097_), .B(_0239_), .Y(_0240_) );
  AND4_X1 _0712_ ( .A(_0085_), .B(_0105_), .C(_0238_), .D(_0240_), .Y(_0241_) );
  NOR2 _0713_ ( .A(fo_net_31_g0), .B(_0233_), .Y(_0242_) );
  NAND2 _0714_ ( .A(_0226_), .B(_0242_), .Y(_0243_) );
  NAND2 _0715_ ( .A(din2_in_th), .B(_0233_), .Y(_0244_) );
  AOI22 _0716_ ( .A1(buf_l_2), .A2(fo_net_25_g0), .B1(_0087_), .B2(fo_net_13_g0), .Y(_0245_) );
  NAND3 _0717_ ( .A(_0243_), .B(_0244_), .C(_0245_), .Y(_0246_) );
  NOR2 _0719_ ( .A(fo_net_17_g0), .B(_0109_), .Y(_0247_) );
  NOR2 _0720_ ( .A(_0002_), .B(_0123_), .Y(_0248_) );
  OAI21 _0721_ ( .A1(_0002_), .A2(_0123_), .B(_0234_), .Y(_0249_) );
  AOI21 _0722_ ( .A1(fo_net_17_g0), .A2(_0249_), .B(_0247_), .Y(_0250_) );
  NAND2 _0723_ ( .A(buf_h_2), .B(_0248_), .Y(_0251_) );
  OAI21 _0724_ ( .A1(fo_net_17_g0), .A2(_0109_), .B(_0234_), .Y(_0252_) );
  AOI22 _0725_ ( .A1(buf_l_2), .A2(_0250_), .B1(_0252_), .B2(buf_m_2), .Y(_0253_) );
  NAND2 _0726_ ( .A(_0251_), .B(_0253_), .Y(sram_din[2]) );
  NOR3 _0727_ ( .A(phase_2), .B(phase_0), .C(_0014_), .Y(_0254_) );
  OR3 _0728_ ( .A(phase_2), .B(phase_0), .C(_0014_), .Y(_0255_) );
  NOR2 _0729_ ( .A(_0248_), .B(_0254_), .Y(_0256_) );
  AND3_X1 _0730_ ( .A(fo_net_31_g0), .B(_0237_), .C(_0256_), .Y(_0257_) );
  INV_X1 _0731_ ( .A(_0257_), .Y(sram_addr_4) );
  NAND3 _0732_ ( .A(_0011_), .B(fo_net_27_g0), .C(_0095_), .Y(_0258_) );
  NOR2 _0733_ ( .A(_0108_), .B(_0258_), .Y(_0259_) );
  NAND2 _0734_ ( .A(fo_net_24_g1), .B(fo_net_32_g1), .Y(_0260_) );
  OAI22 _0735_ ( .A1(_0058_), .A2(_0257_), .B1(_0259_), .B2(_0260_), .Y(sram_addr_3) );
  NAND2 _0736_ ( .A(fo_net_3_g0), .B(fo_net_31_g0), .Y(_0261_) );
  OAI21 _0737_ ( .A1(_0259_), .A2(_0261_), .B(_0256_), .Y(sram_addr_1) );
  NAND2 _0738_ ( .A(buf_h_0), .B(_0248_), .Y(_0262_) );
  AOI22 _0739_ ( .A1(buf_l_0), .A2(_0250_), .B1(_0252_), .B2(buf_m_0), .Y(_0263_) );
  NAND2 _0740_ ( .A(_0262_), .B(_0263_), .Y(sram_din[0]) );
  NAND2 _0741_ ( .A(buf_h_1), .B(_0248_), .Y(_0264_) );
  AOI22 _0742_ ( .A1(buf_l_1), .A2(_0250_), .B1(_0252_), .B2(buf_m_1), .Y(_0265_) );
  NAND2 _0743_ ( .A(_0264_), .B(_0265_), .Y(sram_din[1]) );
  XNOR2 _0744_ ( .A(_0158_), .B(_0170_), .Y(_0266_) );
  NAND2 _0745_ ( .A(_0242_), .B(_0266_), .Y(_0267_) );
  AOI22 _0746_ ( .A1(buf_l_0), .A2(fo_net_25_g0), .B1(_0233_), .B2(din0_in_th), .Y(_0268_) );
  NAND2 _0747_ ( .A(fo_net_5_g0), .B(_0087_), .Y(_0269_) );
  NAND3 _0748_ ( .A(_0267_), .B(_0268_), .C(_0269_), .Y(_0270_) );
  NAND2 _0750_ ( .A(fo_net_21_g0), .B(fo_net_31_g0), .Y(_0271_) );
  OAI22 _0751_ ( .A1(_0061_), .A2(_0257_), .B1(_0259_), .B2(_0271_), .Y(sram_addr_2) );
  NAND4 _0752_ ( .A(fo_net_2_g1), .B(fo_net_27_g0), .C(_0081_), .D(_0090_), .Y(_0272_) );
  NAND4 _0753_ ( .A(fo_net_1_g0), .B(_0087_), .C(_0109_), .D(_0272_), .Y(_0273_) );
  NAND2 _0754_ ( .A(_0109_), .B(_0258_), .Y(_0274_) );
  NAND2 _0755_ ( .A(fo_net_1_g0), .B(fo_net_25_g0), .Y(_0275_) );
  OAI21 _0756_ ( .A1(fo_net_1_g0), .A2(_0274_), .B(fo_net_26_g1), .Y(_0276_) );
  NAND3 _0757_ ( .A(_0237_), .B(_0273_), .C(_0276_), .Y(sram_addr_0) );
  NAND2 _0758_ ( .A(phase_0), .B(phase_1), .Y(_0277_) );
  XOR2 _0759_ ( .A(phase_0), .B(phase_1), .Y(_0505_) );
  NOR4 _0760_ ( .A(fo_net_4_g1), .B(fo_net_22_g1), .C(_0011_), .D(_0000_), .Y(_0278_) );
  NOR4 _0761_ ( .A(_0011_), .B(_0012_), .C(fo_net_24_g1), .D(_0013_), .Y(_0279_) );
  NOR2 _0762_ ( .A(_0278_), .B(_0279_), .Y(_0280_) );
  NOR4 _0763_ ( .A(fo_net_3_g0), .B(_0011_), .C(fo_net_23_g0), .D(_0013_), .Y(_0281_) );
  NOR4 _0764_ ( .A(fo_net_1_g0), .B(_0012_), .C(fo_net_23_g0), .D(_0013_), .Y(_0282_) );
  NOR4 _0765_ ( .A(fo_net_1_g0), .B(fo_net_3_g0), .C(fo_net_21_g0), .D(fo_net_23_g0), .Y(_0283_) );
  NOR3 _0766_ ( .A(_0281_), .B(_0282_), .C(_0283_), .Y(_0284_) );
  NAND2 _0767_ ( .A(_0280_), .B(_0284_), .Y(_0285_) );
  AOI21 _0768_ ( .A1(_0161_), .A2(_0162_), .B(_0145_), .Y(_0286_) );
  AND2_X1 _0769_ ( .A(_0187_), .B(_0286_), .Y(_0287_) );
  NAND2 _0770_ ( .A(_0187_), .B(_0286_), .Y(_0288_) );
  NOR4 _0771_ ( .A(fo_net_1_g0), .B(fo_net_3_g0), .C(fo_net_24_g1), .D(_0013_), .Y(_0289_) );
  NOR3 _0772_ ( .A(_0285_), .B(_0288_), .C(_0289_), .Y(_0290_) );
  NOR2 _0773_ ( .A(_0000_), .B(_0013_), .Y(_0291_) );
  NAND3 _0774_ ( .A(_0049_), .B(_0051_), .C(_0291_), .Y(_0292_) );
  NOR4 _0775_ ( .A(fo_net_20_g1), .B(_0511_), .C(_0003_), .D(_0512_), .Y(_0293_) );
  NAND3 _0776_ ( .A(_0290_), .B(_0292_), .C(_0293_), .Y(_0294_) );
  AND2_X1 _0777_ ( .A(fo_net_27_g0), .B(_0087_), .Y(_0295_) );
  NAND2 _0778_ ( .A(fo_net_27_g0), .B(_0087_), .Y(_0296_) );
  NAND3 _0779_ ( .A(_0139_), .B(_0146_), .C(_0187_), .Y(_0297_) );
  AND2_X1 _0780_ ( .A(_0295_), .B(_0297_), .Y(_0298_) );
  OAI21 _0781_ ( .A1(_0161_), .A2(_0186_), .B(_0291_), .Y(_0299_) );
  OR4 _0782_ ( .A(fo_net_1_g0), .B(fo_net_22_g1), .C(_0012_), .D(_0000_), .Y(_0300_) );
  NOR4 _0783_ ( .A(fo_net_4_g1), .B(_0011_), .C(_0000_), .D(_0013_), .Y(_0301_) );
  NOR2 _0784_ ( .A(_0278_), .B(_0301_), .Y(_0302_) );
  NAND4 _0785_ ( .A(_0292_), .B(_0299_), .C(_0300_), .D(_0302_), .Y(_0303_) );
  AOI21 _0786_ ( .A1(_0295_), .A2(_0303_), .B(_0298_), .Y(_0304_) );
  NOR3 _0787_ ( .A(opr_2), .B(_0003_), .C(_0091_), .Y(_0305_) );
  AND2_X1 _0788_ ( .A(_0102_), .B(_0138_), .Y(_0306_) );
  OR3 _0789_ ( .A(_0165_), .B(_0305_), .C(_0306_), .Y(_0307_) );
  INV_X1 _0790_ ( .A(_0307_), .Y(_0308_) );
  OAI21 _0791_ ( .A1(_0293_), .A2(_0307_), .B(_0294_), .Y(_0309_) );
  OR2 _0792_ ( .A(_0304_), .B(_0309_), .Y(_0310_) );
  AOI21 _0793_ ( .A1(_0052_), .A2(_0303_), .B(_0140_), .Y(_0311_) );
  OAI21 _0794_ ( .A1(_0287_), .A2(_0307_), .B(_0164_), .Y(_0312_) );
  OAI21 _0795_ ( .A1(_0311_), .A2(_0312_), .B(_0199_), .Y(_0313_) );
  NOR4 _0796_ ( .A(acc_3), .B(fo_net_9_g0), .C(_0509_), .D(fo_net_11_g0), .Y(_0314_) );
  NOR4 _0797_ ( .A(fo_net_7_g0), .B(acc_3), .C(fo_net_9_g0), .D(_0510_), .Y(_0315_) );
  OR2 _0798_ ( .A(_0314_), .B(_0315_), .Y(_0316_) );
  NOR4 _0799_ ( .A(fo_net_7_g0), .B(_0007_), .C(fo_net_10_g1), .D(fo_net_11_g0), .Y(_0317_) );
  NOR4 _0800_ ( .A(fo_net_7_g0), .B(acc_3), .C(fo_net_11_g0), .D(_0508_), .Y(_0318_) );
  NOR4 _0801_ ( .A(_0077_), .B(_0316_), .C(_0317_), .D(_0318_), .Y(_0319_) );
  NAND2 _0802_ ( .A(_0290_), .B(_0319_), .Y(_0320_) );
  OAI21 _0803_ ( .A1(_0314_), .A2(_0318_), .B(_0290_), .Y(_0321_) );
  AOI22 _0804_ ( .A1(fo_net_12_g1), .A2(_0281_), .B1(_0282_), .B2(fo_net_8_g1), .Y(_0322_) );
  AOI22 _0805_ ( .A1(cy), .A2(_0278_), .B1(_0289_), .B2(_0508_), .Y(_0323_) );
  NAND4 _0806_ ( .A(_0320_), .B(_0321_), .C(_0322_), .D(_0323_), .Y(_0324_) );
  NAND2 _0807_ ( .A(_0308_), .B(_0324_), .Y(_0325_) );
  AOI22 _0808_ ( .A1(fo_net_15_g0), .A2(_0305_), .B1(_0306_), .B2(fo_net_3_g0), .Y(_0326_) );
  NAND2 _0809_ ( .A(_0303_), .B(_0311_), .Y(_0327_) );
  NAND4 _0810_ ( .A(_0313_), .B(_0325_), .C(_0326_), .D(_0327_), .Y(_0328_) );
  NAND2 _0812_ ( .A(_0172_), .B(_0236_), .Y(_0329_) );
  NOR2 _0813_ ( .A(_0140_), .B(_0296_), .Y(_0330_) );
  AND2_X1 _0814_ ( .A(_0000_), .B(_0330_), .Y(_0331_) );
  NAND4 _0815_ ( .A(fo_net_2_g1), .B(fo_net_27_g0), .C(_0081_), .D(_0089_), .Y(_0332_) );
  NAND3 _0816_ ( .A(fo_net_9_g0), .B(_0331_), .C(_0332_), .Y(_0333_) );
  NOR2 _0817_ ( .A(_0113_), .B(_0332_), .Y(_0334_) );
  AOI22 _0818_ ( .A1(_0173_), .A2(_0254_), .B1(_0334_), .B2(fo_net_15_g0), .Y(_0335_) );
  NAND4 _0819_ ( .A(_0178_), .B(_0329_), .C(_0333_), .D(_0335_), .Y(d_out[1]) );
  NAND3 _0820_ ( .A(_0293_), .B(_0295_), .C(_0301_), .Y(_0336_) );
  NAND2 _0822_ ( .A(fo_net_28_g1), .B(_0100_), .Y(_0337_) );
  NAND2 _0824_ ( .A(_0199_), .B(_0242_), .Y(_0338_) );
  NAND2 _0825_ ( .A(fo_net_16_g1), .B(_0087_), .Y(_0339_) );
  AOI22 _0826_ ( .A1(buf_l_1), .A2(fo_net_26_g1), .B1(_0233_), .B2(din1_in_th), .Y(_0340_) );
  NAND3 _0827_ ( .A(_0338_), .B(_0339_), .C(_0340_), .Y(_0341_) );
  OAI21 _0830_ ( .A1(_0296_), .A2(_0332_), .B(_0336_), .Y(_0342_) );
  OR3 _0831_ ( .A(_0254_), .B(_0330_), .C(_0342_), .Y(_0343_) );
  NAND2 _0832_ ( .A(_0069_), .B(_0343_), .Y(cm_ram[2]) );
  NAND2 _0833_ ( .A(_0070_), .B(_0343_), .Y(cm_ram[1]) );
  NOR3 _0834_ ( .A(bank_sel_2), .B(bank_sel_3), .C(bank_sel_1), .Y(_0344_) );
  NAND2 _0835_ ( .A(_0343_), .B(_0344_), .Y(cm_ram[0]) );
  NAND2 _0837_ ( .A(_0125_), .B(_0236_), .Y(_0345_) );
  AOI22 _0838_ ( .A1(_0126_), .A2(_0254_), .B1(_0334_), .B2(fo_net_5_g0), .Y(_0346_) );
  NAND3 _0839_ ( .A(fo_net_11_g0), .B(_0331_), .C(_0332_), .Y(_0347_) );
  NAND4 _0840_ ( .A(_0132_), .B(_0345_), .C(_0346_), .D(_0347_), .Y(d_out[0]) );
  XNOR2 _0841_ ( .A(phase_2), .B(_0277_), .Y(_0506_) );
  OAI22 _0842_ ( .A1(_0103_), .A2(_0203_), .B1(_0255_), .B2(fo_net_25_g0), .Y(_0348_) );
  OAI21 _0843_ ( .A1(_0111_), .A2(_0255_), .B(_0348_), .Y(_0349_) );
  INV_X1 _0844_ ( .A(_0349_), .Y(_0350_) );
  NAND2 _0845_ ( .A(buf_h_3), .B(_0349_), .Y(_0351_) );
  OAI21 _0846_ ( .A1(_0207_), .A2(_0225_), .B(_0224_), .Y(_0352_) );
  MUX2 _0847_ ( .A(buf_m_3), .B(fo_net_35_g0), .S(_0124_), .Y(_0353_) );
  NOR2 _0848_ ( .A(_0123_), .B(_0353_), .Y(_0354_) );
  MUX2 _0849_ ( .A(buf_h_3), .B(fo_net_35_g0), .S(pc_init_n), .Y(_0355_) );
  NOR2 _0850_ ( .A(_0122_), .B(_0355_), .Y(_0356_) );
  NOR3 _0851_ ( .A(_0128_), .B(_0354_), .C(_0356_), .Y(_0357_) );
  MUX2 _0852_ ( .A(buf_l_3), .B(fo_net_35_g0), .S(_0124_), .Y(_0358_) );
  AND2_X1 _0853_ ( .A(_0112_), .B(_0358_), .Y(_0359_) );
  OAI21 _0854_ ( .A1(fo_net_35_g0), .A2(_0075_), .B(phase_2), .Y(_0360_) );
  AOI21 _0855_ ( .A1(_0059_), .A2(_0075_), .B(_0360_), .Y(_0361_) );
  NOR3 _0856_ ( .A(_0357_), .B(_0359_), .C(_0361_), .Y(_0362_) );
  MUX2 _0857_ ( .A(_0141_), .B(_0143_), .S(din3_in_th), .Y(_0363_) );
  AOI21 _0858_ ( .A1(_0147_), .A2(_0363_), .B(_0136_), .Y(_0364_) );
  OAI21 _0859_ ( .A1(fo_net_36_g1), .A2(_0137_), .B(fo_net_34_g1), .Y(_0365_) );
  OAI22 _0860_ ( .A1(fo_net_36_g1), .A2(fo_net_34_g1), .B1(_0364_), .B2(_0365_), .Y(_0366_) );
  NOR2 _0861_ ( .A(_0153_), .B(_0366_), .Y(_0367_) );
  NOR3 _0862_ ( .A(_0153_), .B(_0362_), .C(_0366_), .Y(_0368_) );
  XNOR2 _0863_ ( .A(_0362_), .B(_0367_), .Y(_0369_) );
  AND2_X1 _0864_ ( .A(_0352_), .B(_0369_), .Y(_0370_) );
  XOR2 _0865_ ( .A(_0352_), .B(_0369_), .Y(_0371_) );
  NOR2 _0866_ ( .A(fo_net_23_g0), .B(fo_net_17_g0), .Y(_0372_) );
  OAI21 _0867_ ( .A1(fo_net_25_g0), .A2(_0371_), .B(_0350_), .Y(_0373_) );
  OAI21 _0868_ ( .A1(_0372_), .A2(_0373_), .B(_0351_), .Y(_0048_) );
  NOR4 _0870_ ( .A(opr_0), .B(opr_1), .C(_0511_), .D(_0003_), .Y(_0374_) );
  NOR3 _0871_ ( .A(fo_net_30_g1), .B(_0094_), .C(_0374_), .Y(_0375_) );
  OAI21 _0872_ ( .A1(_0116_), .A2(_0254_), .B(_0099_), .Y(_0376_) );
  NOR4 _0873_ ( .A(_0086_), .B(_0106_), .C(_0375_), .D(_0376_), .Y(_0377_) );
  NOR2 _0874_ ( .A(_0111_), .B(fo_net_31_g0), .Y(_0378_) );
  OAI21 _0875_ ( .A1(pc_init_n), .A2(two_cycle), .B(_0100_), .Y(_0379_) );
  AOI22 _0876_ ( .A1(_0011_), .A2(_0096_), .B1(_0378_), .B2(pc_init_n), .Y(_0380_) );
  NAND3 _0877_ ( .A(fo_net_29_g0), .B(_0379_), .C(_0380_), .Y(_0381_) );
  AOI21 _0879_ ( .A1(_0053_), .A2(_0303_), .B(_0140_), .Y(_0382_) );
  OAI21 _0880_ ( .A1(_0312_), .A2(_0382_), .B(_0226_), .Y(_0383_) );
  NAND2 _0881_ ( .A(_0303_), .B(_0382_), .Y(_0384_) );
  AOI22 _0882_ ( .A1(fo_net_14_g1), .A2(_0305_), .B1(_0306_), .B2(fo_net_21_g0), .Y(_0385_) );
  NAND2 _0883_ ( .A(_0384_), .B(_0385_), .Y(_0386_) );
  AOI22 _0884_ ( .A1(fo_net_10_g1), .A2(_0281_), .B1(_0282_), .B2(acc_3), .Y(_0387_) );
  AOI22 _0885_ ( .A1(_0509_), .A2(_0289_), .B1(_0290_), .B2(_0317_), .Y(_0388_) );
  NAND3 _0886_ ( .A(_0320_), .B(_0387_), .C(_0388_), .Y(_0389_) );
  AND2_X1 _0887_ ( .A(_0308_), .B(_0389_), .Y(_0390_) );
  NOR3 _0888_ ( .A(_0310_), .B(_0386_), .C(_0390_), .Y(_0391_) );
  AOI22 _0889_ ( .A1(_0057_), .A2(_0310_), .B1(_0383_), .B2(_0391_), .Y(_0029_) );
  NAND2 _0890_ ( .A(_0208_), .B(_0236_), .Y(_0392_) );
  NAND3 _0891_ ( .A(fo_net_7_g0), .B(_0331_), .C(_0332_), .Y(_0393_) );
  AOI22 _0892_ ( .A1(_0209_), .A2(_0254_), .B1(_0334_), .B2(fo_net_13_g0), .Y(_0394_) );
  NAND4 _0893_ ( .A(_0214_), .B(_0392_), .C(_0393_), .D(_0394_), .Y(d_out[2]) );
  AOI21 _0894_ ( .A1(_0059_), .A2(_0092_), .B(fo_net_29_g0), .Y(_0395_) );
  OAI21 _0895_ ( .A1(_0115_), .A2(_0395_), .B(_0371_), .Y(_0396_) );
  NAND2 _0896_ ( .A(_0092_), .B(_0395_), .Y(_0397_) );
  NAND2 _0897_ ( .A(fo_net_36_g1), .B(_0096_), .Y(_0398_) );
  AOI22 _0898_ ( .A1(din3_in_th), .A2(_0100_), .B1(_0202_), .B2(buf_m_3), .Y(_0399_) );
  AND4_X1 _0899_ ( .A(_0120_), .B(_0397_), .C(_0398_), .D(_0399_), .Y(_0400_) );
  NOR2 _0900_ ( .A(buf_l_3), .B(_0120_), .Y(_0401_) );
  AOI21 _0901_ ( .A1(_0396_), .A2(_0400_), .B(_0401_), .Y(_0045_) );
  NOR2 _0902_ ( .A(_0076_), .B(_0296_), .Y(_0402_) );
  NAND4 _0903_ ( .A(fo_net_6_g1), .B(fo_net_36_g1), .C(fo_net_14_g1), .D(fo_net_16_g1), .Y(_0403_) );
  OR2 _0907_ ( .A(_0112_), .B(_0236_), .Y(_0404_) );
  NAND2 _0908_ ( .A(_0111_), .B(_0404_), .Y(_0405_) );
  OR2 _0909_ ( .A(_0368_), .B(_0370_), .Y(_0406_) );
  NOR2 _0911_ ( .A(buf_m_3), .B(_0241_), .Y(_0407_) );
  NAND2 _0912_ ( .A(din3_in_th), .B(_0233_), .Y(_0408_) );
  AOI22 _0913_ ( .A1(buf_l_3), .A2(fo_net_25_g0), .B1(_0087_), .B2(fo_net_35_g0), .Y(_0409_) );
  NAND3 _0914_ ( .A(_0241_), .B(_0408_), .C(_0409_), .Y(_0410_) );
  AOI21 _0915_ ( .A1(_0242_), .A2(_0371_), .B(_0410_), .Y(_0411_) );
  NOR2 _0916_ ( .A(_0407_), .B(_0411_), .Y(_0040_) );
  NAND2 _0917_ ( .A(_0162_), .B(_0186_), .Y(_0412_) );
  NAND3 _0918_ ( .A(_0051_), .B(_0055_), .C(_0162_), .Y(_0413_) );
  NAND4 _0919_ ( .A(_0286_), .B(_0300_), .C(_0412_), .D(_0413_), .Y(_0414_) );
  NOR2 _0920_ ( .A(_0285_), .B(_0414_), .Y(_0415_) );
  NAND3 _0921_ ( .A(_0187_), .B(_0293_), .C(_0415_), .Y(_0416_) );
  OR2 _0922_ ( .A(_0165_), .B(_0293_), .Y(_0417_) );
  NAND3 _0923_ ( .A(_0298_), .B(_0416_), .C(_0417_), .Y(_0418_) );
  NAND2 _0924_ ( .A(_0286_), .B(_0293_), .Y(_0419_) );
  OAI22 _0925_ ( .A1(_0368_), .A2(_0370_), .B1(_0415_), .B2(_0419_), .Y(_0420_) );
  NAND2 _0926_ ( .A(cy), .B(_0415_), .Y(_0421_) );
  NAND3 _0927_ ( .A(_0005_), .B(_0162_), .C(_0186_), .Y(_0422_) );
  AOI22 _0928_ ( .A1(acc_3), .A2(_0281_), .B1(_0282_), .B2(fo_net_12_g1), .Y(_0423_) );
  NAND4 _0929_ ( .A(_0300_), .B(_0421_), .C(_0422_), .D(_0423_), .Y(_0424_) );
  AOI21 _0930_ ( .A1(_0293_), .A2(_0424_), .B(_0418_), .Y(_0425_) );
  AOI22 _0931_ ( .A1(_0056_), .A2(_0418_), .B1(_0420_), .B2(_0425_), .Y(_0039_) );
  NAND4 _0932_ ( .A(_0011_), .B(_0081_), .C(_0090_), .D(_0096_), .Y(_0426_) );
  NAND2 _0933_ ( .A(_0096_), .B(_0104_), .Y(_0427_) );
  NAND2 _0934_ ( .A(two_cycle), .B(fo_net_18_g1), .Y(_0428_) );
  NAND3 _0935_ ( .A(_0426_), .B(_0427_), .C(_0428_), .Y(_0038_) );
  AOI21 _0936_ ( .A1(_0066_), .A2(_0303_), .B(_0140_), .Y(_0429_) );
  OAI21 _0937_ ( .A1(_0312_), .A2(_0429_), .B(_0371_), .Y(_0430_) );
  NAND2 _0938_ ( .A(_0303_), .B(_0429_), .Y(_0431_) );
  AOI22 _0939_ ( .A1(fo_net_36_g1), .A2(_0305_), .B1(_0306_), .B2(fo_net_23_g0), .Y(_0432_) );
  NAND2 _0940_ ( .A(_0431_), .B(_0432_), .Y(_0433_) );
  AOI21 _0941_ ( .A1(fo_net_8_g1), .A2(_0281_), .B(_0278_), .Y(_0434_) );
  AOI22 _0942_ ( .A1(cy), .A2(_0282_), .B1(_0289_), .B2(_0007_), .Y(_0435_) );
  AND2_X1 _0943_ ( .A(_0434_), .B(_0435_), .Y(_0436_) );
  AOI21 _0944_ ( .A1(_0320_), .A2(_0436_), .B(_0307_), .Y(_0437_) );
  NOR3 _0945_ ( .A(_0310_), .B(_0433_), .C(_0437_), .Y(_0438_) );
  AOI22 _0946_ ( .A1(_0059_), .A2(_0310_), .B1(_0430_), .B2(_0438_), .Y(_0037_) );
  NOR4 _0947_ ( .A(_0254_), .B(_0331_), .C(_0334_), .D(_0404_), .Y(d_hiz) );
  INV_X1 _0948_ ( .A(d_hiz), .Y(d_oe) );
  NAND3 _0949_ ( .A(acc_3), .B(_0331_), .C(_0332_), .Y(_0439_) );
  AOI21 _0950_ ( .A1(fo_net_35_g0), .A2(_0334_), .B(_0359_), .Y(_0440_) );
  AOI22 _0951_ ( .A1(_0236_), .A2(_0353_), .B1(_0355_), .B2(_0254_), .Y(_0441_) );
  NAND3 _0952_ ( .A(_0439_), .B(_0440_), .C(_0441_), .Y(d_out[3]) );
  AOI21 _0953_ ( .A1(_0073_), .A2(_0082_), .B(fo_net_18_g1), .Y(_0442_) );
  OAI21 _0954_ ( .A1(fo_net_30_g1), .A2(_0374_), .B(fo_net_32_g1), .Y(_0443_) );
  NOR3 _0955_ ( .A(_0097_), .B(_0442_), .C(_0443_), .Y(_0444_) );
  XNOR2 _0956_ ( .A(sp_0), .B(fo_net_26_g1), .Y(_0445_) );
  NAND2 _0957_ ( .A(_0444_), .B(_0445_), .Y(_0446_) );
  XNOR2 _0958_ ( .A(sp_1), .B(_0446_), .Y(_0036_) );
  NOR2 _0959_ ( .A(buf_h_0), .B(_0350_), .Y(_0447_) );
  AOI21 _0960_ ( .A1(fo_net_17_g0), .A2(_0266_), .B(_0349_), .Y(_0448_) );
  AOI21 _0961_ ( .A1(_0275_), .A2(_0448_), .B(_0447_), .Y(_0035_) );
  AOI21 _0962_ ( .A1(fo_net_17_g0), .A2(_0198_), .B(_0349_), .Y(_0449_) );
  OAI21 _0963_ ( .A1(fo_net_3_g0), .A2(fo_net_17_g0), .B(_0449_), .Y(_0450_) );
  OAI21 _0964_ ( .A1(_0063_), .A2(_0350_), .B(_0450_), .Y(_0034_) );
  NAND2 _0965_ ( .A(buf_h_2), .B(_0349_), .Y(_0451_) );
  NOR2 _0966_ ( .A(fo_net_21_g0), .B(fo_net_18_g1), .Y(_0452_) );
  OAI21 _0967_ ( .A1(fo_net_25_g0), .A2(_0226_), .B(_0350_), .Y(_0453_) );
  OAI21 _0968_ ( .A1(_0452_), .A2(_0453_), .B(_0451_), .Y(_0033_) );
  NAND2 _0971_ ( .A(_0071_), .B(_0343_), .Y(cm_ram[3]) );
  NAND3 _0972_ ( .A(_0163_), .B(_0300_), .C(_0412_), .Y(_0454_) );
  AOI21 _0973_ ( .A1(_0330_), .A2(_0454_), .B(_0254_), .Y(cm_rom) );
  AND2_X1 _0974_ ( .A(fo_net_28_g1), .B(_0094_), .Y(_0455_) );
  NAND4 _0975_ ( .A(fo_net_26_g1), .B(_0258_), .C(_0272_), .D(_0455_), .Y(_0456_) );
  OAI21 _0976_ ( .A1(_0100_), .A2(_0249_), .B(_0111_), .Y(_0457_) );
  NAND2 _0977_ ( .A(_0108_), .B(fo_net_32_g1), .Y(_0458_) );
  NAND3 _0978_ ( .A(_0456_), .B(_0457_), .C(_0458_), .Y(sram_we) );
  AOI21 _0979_ ( .A1(_0062_), .A2(_0092_), .B(fo_net_29_g0), .Y(_0459_) );
  OAI21 _0980_ ( .A1(_0115_), .A2(_0459_), .B(_0266_), .Y(_0460_) );
  NAND2 _0981_ ( .A(_0092_), .B(_0459_), .Y(_0461_) );
  NAND2 _0982_ ( .A(din0_in_th), .B(_0100_), .Y(_0462_) );
  AOI22 _0983_ ( .A1(fo_net_6_g1), .A2(_0096_), .B1(_0202_), .B2(buf_m_0), .Y(_0463_) );
  NAND4 _0984_ ( .A(_0460_), .B(_0461_), .C(_0462_), .D(_0463_), .Y(_0464_) );
  NAND3 _0986_ ( .A(opr_0), .B(opr_1), .C(_0511_), .Y(_0465_) );
  NAND2 _0987_ ( .A(opr_2), .B(_0465_), .Y(_0466_) );
  NAND2 _0988_ ( .A(opr_3), .B(_0466_), .Y(_0467_) );
  AOI21 _0989_ ( .A1(_0092_), .A2(_0467_), .B(_0296_), .Y(_0468_) );
  AOI21 _0990_ ( .A1(fo_net_30_g1), .A2(_0455_), .B(_0468_), .Y(_0469_) );
  NAND4 _0991_ ( .A(_0109_), .B(_0258_), .C(_0272_), .D(_0469_), .Y(_0470_) );
  NAND3 _0992_ ( .A(pc_init_n), .B(_0111_), .C(_0113_), .Y(_0471_) );
  NAND2 _0993_ ( .A(pc_init_n), .B(_0254_), .Y(_0472_) );
  NAND3 _0994_ ( .A(_0457_), .B(_0471_), .C(_0472_), .Y(_0473_) );
  AOI21 _0995_ ( .A1(fo_net_32_g1), .A2(_0470_), .B(_0473_), .Y(_0474_) );
  NOR3 _0996_ ( .A(rst_in_th), .B(clk_buf_r10), .C(_0474_), .Y(sram_ce) );
  NAND2 _0997_ ( .A(buf_l_3), .B(_0250_), .Y(_0475_) );
  AOI22 _0998_ ( .A1(buf_h_3), .A2(_0248_), .B1(_0252_), .B2(buf_m_3), .Y(_0476_) );
  NAND2 _0999_ ( .A(_0475_), .B(_0476_), .Y(sram_din[3]) );
  AOI21 _1000_ ( .A1(_0050_), .A2(_0303_), .B(_0140_), .Y(_0477_) );
  OAI21 _1001_ ( .A1(_0312_), .A2(_0477_), .B(_0266_), .Y(_0478_) );
  OAI21 _1002_ ( .A1(_0279_), .A2(_0281_), .B(cy), .Y(_0479_) );
  AOI22 _1003_ ( .A1(_0005_), .A2(_0278_), .B1(_0289_), .B2(_0510_), .Y(_0480_) );
  NAND2 _1004_ ( .A(fo_net_10_g1), .B(_0282_), .Y(_0481_) );
  NAND3 _1005_ ( .A(_0479_), .B(_0480_), .C(_0481_), .Y(_0482_) );
  AOI21 _1006_ ( .A1(_0290_), .A2(_0316_), .B(_0482_), .Y(_0483_) );
  AOI21 _1007_ ( .A1(_0320_), .A2(_0483_), .B(_0307_), .Y(_0484_) );
  NAND2 _1008_ ( .A(_0303_), .B(_0477_), .Y(_0485_) );
  AOI22 _1009_ ( .A1(fo_net_6_g1), .A2(_0305_), .B1(_0306_), .B2(fo_net_1_g0), .Y(_0486_) );
  NAND3 _1010_ ( .A(_0478_), .B(_0485_), .C(_0486_), .Y(_0487_) );
  NOR3 _1011_ ( .A(_0310_), .B(_0484_), .C(_0487_), .Y(_0488_) );
  AOI21 _1012_ ( .A1(_0062_), .A2(_0310_), .B(_0488_), .Y(_0031_) );
  MUXDFFRB _1013_ ( .CK(clk_buf_r3), .Q(pc_cout), .QB(_0492_), .RSTB(rst_n_buf_r3), .A(_0406_), .B(pc_cout), .S(_0405_) );
  DFFRB _1014_ ( .CK(clk_buf_r9), .D(_0035_), .Q(buf_h_0), .QB(_0495_), .RSTB(rst_n_buf_r9) );
  DFFRB _1015_ ( .CK(clk_buf_r9), .D(_0034_), .Q(buf_h_1), .QB(_0496_), .RSTB(rst_n_buf_r9) );
  DFFRB _1016_ ( .CK(clk_buf_r10), .D(_0033_), .Q(buf_h_2), .QB(_0497_), .RSTB(rst_n_buf_r10) );
  DFFRB _1017_ ( .CK(clk_buf_r9), .D(_0048_), .Q(buf_h_3), .QB(_0489_), .RSTB(rst_n_buf_r9) );
  MUXDFFRB _1018_ ( .CK(clk_buf_r10), .Q(sp_0), .QB(_0507_), .RSTB(rst_n_buf_r10), .A(sp_0), .B(_0507_), .S(_0444_) );
  DFFRB _1019_ ( .CK(clk_buf_r10), .D(_0036_), .Q(sp_1), .QB(_0494_), .RSTB(rst_n_buf_r10) );
  DFFRB _1020_ ( .CK(clk_buf_r1), .D(_0031_), .Q(acc_0), .QB(_0510_), .RSTB(rst_n_buf_r1) );
  MUXDFFRB _1021_ ( .CK(clk_buf_r2), .Q(acc_1), .QB(_0508_), .RSTB(rst_n_buf_r2), .A(_0328_), .B(fo_net_9_g0), .S(_0310_) );
  DFFRB _1022_ ( .CK(clk_buf_r2), .D(_0029_), .Q(acc_2), .QB(_0509_), .RSTB(rst_n_buf_r2) );
  DFFRB _1023_ ( .CK(clk_buf_r1), .D(_0037_), .Q(acc_3), .QB(_0007_), .RSTB(rst_n_buf_r1) );
  DFFRB _1024_ ( .CK(clk_buf_r7), .D(_0038_), .Q(two_cycle), .QB(_0006_), .RSTB(rst_n_buf_r7) );
  DFFRB _1025_ ( .CK(clk_buf_r2), .D(_0039_), .Q(cy), .QB(_0005_), .RSTB(rst_n_buf_r2) );
  MUXDFFRB _1026_ ( .CK(clk_buf_r6), .Q(buf_m_0), .QB(_0498_), .RSTB(rst_n_buf_r6), .A(buf_m_0), .B(_0270_), .S(_0241_) );
  MUXDFFRB _1027_ ( .CK(clk_buf_r5), .Q(buf_m_1), .QB(_0499_), .RSTB(rst_n_buf_r5), .A(buf_m_1), .B(_0341_), .S(_0241_) );
  MUXDFFRB _1028_ ( .CK(clk_buf_r5), .Q(buf_m_2), .QB(_0500_), .RSTB(rst_n_buf_r5), .A(buf_m_2), .B(_0246_), .S(_0241_) );
  DFFRB _1029_ ( .CK(clk_buf_r4), .D(_0040_), .Q(buf_m_3), .QB(_0493_), .RSTB(rst_n_buf_r4) );
  MUXDFFRB _1030_ ( .CK(clk_buf_r3), .Q(bank_sel_1), .QB(_0008_), .RSTB(rst_n_buf_r3), .A(fo_net_12_g1), .B(bank_sel_1), .S(_0336_) );
  MUXDFFRB _1031_ ( .CK(clk_buf_r3), .Q(bank_sel_2), .QB(_0009_), .RSTB(rst_n_buf_r3), .A(fo_net_10_g1), .B(bank_sel_2), .S(_0336_) );
  MUXDFFRB _1032_ ( .CK(clk_buf_r4), .Q(bank_sel_3), .QB(_0004_), .RSTB(rst_n_buf_r4), .A(fo_net_8_g1), .B(bank_sel_3), .S(_0336_) );
  MUXDFFRB _1033_ ( .CK(clk_buf_r6), .Q(opr_0), .QB(_0512_), .RSTB(rst_n_buf_r6), .A(din0_in_th), .B(opr_0), .S(_0337_) );
  MUXDFFRB _1034_ ( .CK(clk_buf_r6), .Q(opr_1), .QB(_0010_), .RSTB(rst_n_buf_r6), .A(din1_in_th), .B(opr_1), .S(_0337_) );
  MUXDFFRB _1035_ ( .CK(clk_buf_r4), .Q(opr_2), .QB(_0511_), .RSTB(rst_n_buf_r4), .A(din2_in_th), .B(opr_2), .S(_0337_) );
  MUXDFFRB _1036_ ( .CK(clk_buf_r5), .Q(opr_3), .QB(_0003_), .RSTB(rst_n_buf_r5), .A(din3_in_th), .B(opr_3), .S(_0337_) );
  MUXDFFRB _1037_ ( .CK(clk_buf_r5), .Q(isz_taken), .QB(_0491_), .RSTB(rst_n_buf_r5), .A(isz_taken), .B(_0403_), .S(_0402_) );
  MUXDFFRB _1038_ ( .CK(clk_buf_r7), .Q(buf_l_0), .QB(_0501_), .RSTB(rst_n_buf_r7), .A(buf_l_0), .B(_0464_), .S(_0120_) );
  MUXDFFRB _1039_ ( .CK(clk_buf_r7), .Q(buf_l_1), .QB(_0502_), .RSTB(rst_n_buf_r7), .A(buf_l_1), .B(_0206_), .S(_0120_) );
  MUXDFFRB _1040_ ( .CK(clk_buf_r8), .Q(buf_l_2), .QB(_0503_), .RSTB(rst_n_buf_r8), .A(buf_l_2), .B(_0232_), .S(_0120_) );
  DFFRB _1041_ ( .CK(clk_buf_r8), .D(_0045_), .Q(buf_l_3), .QB(_0490_), .RSTB(rst_n_buf_r8) );
  MUXDFFRB _1042_ ( .CK(clk_buf_r8), .Q(pc_init_n), .QB(_0001_), .RSTB(rst_n_buf_r8), .A(pc_init_n), .B(_0381_), .S(_0377_) );
  MUXDFFRB _1043_ ( .CK(clk_buf_r4), .Q(opa_0), .QB(_0011_), .RSTB(rst_n_buf_r4), .A(din0_in_th), .B(fo_net_1_g0), .S(_0235_) );
  MUXDFFRB _1044_ ( .CK(clk_buf_r2), .Q(opa_1), .QB(_0012_), .RSTB(rst_n_buf_r2), .A(din1_in_th), .B(fo_net_3_g0), .S(_0235_) );
  MUXDFFRB _1045_ ( .CK(clk_buf_r1), .Q(opa_2), .QB(_0013_), .RSTB(rst_n_buf_r1), .A(din2_in_th), .B(fo_net_21_g0), .S(_0235_) );
  MUXDFFRB _1046_ ( .CK(clk_buf_r3), .Q(opa_3), .QB(_0000_), .RSTB(rst_n_buf_r3), .A(din3_in_th), .B(fo_net_23_g0), .S(_0235_) );
  DFFRB _1047_ ( .CK(clk_buf_r8), .D(_0504_), .Q(phase_0), .QB(_0504_), .RSTB(rst_n_buf_r8) );
  DFFRB _1048_ ( .CK(clk_buf_r7), .D(_0505_), .Q(phase_1), .QB(_0014_), .RSTB(rst_n_buf_r7) );
  DFFRB _1049_ ( .CK(clk_buf_r6), .D(_0506_), .Q(phase_2), .QB(_0002_), .RSTB(rst_n_buf_r6) );
  SRAM128 u_sram ( .A0(sram_addr_0), .A1(sram_addr_1), .A2(sram_addr_2), .A3(sram_addr_3), .A4(sram_addr_4), .CE(sram_ce), .DIN(sram_din), .DO(sram_do), .WR(sram_we) );
  BUFTH u_bufth_clk ( .A(clk), .Y(clk_in_th) );
  BUFTH u_bufth_rst ( .A(rst), .Y(rst_in_th) );
  BUFTH u_bufth_test ( .A(test), .Y(test_in_th) );
  BUFTH u_bufth_din0 ( .A(d_in[0]), .Y(din0_in_th) );
  BUFTH u_bufth_din1 ( .A(d_in[1]), .Y(din1_in_th) );
  BUFTH u_bufth_din2 ( .A(d_in[2]), .Y(din2_in_th) );
  BUFTH u_bufth_din3 ( .A(d_in[3]), .Y(din3_in_th) );
  BUF_X2 u_clk_buf_r1 ( .A(clk_in_th), .Y(clk_buf_r1) );
  BUF_X2 u_rst_buf_r1 ( .A(rst_n), .Y(rst_n_buf_r1) );
  BUF_X2 u_clk_buf_r2 ( .A(clk_in_th), .Y(clk_buf_r2) );
  BUF_X2 u_rst_buf_r2 ( .A(rst_n), .Y(rst_n_buf_r2) );
  BUF_X2 u_clk_buf_r3 ( .A(clk_in_th), .Y(clk_buf_r3) );
  BUF_X2 u_rst_buf_r3 ( .A(rst_n), .Y(rst_n_buf_r3) );
  BUF_X2 u_clk_buf_r4 ( .A(clk_in_th), .Y(clk_buf_r4) );
  BUF_X2 u_rst_buf_r4 ( .A(rst_n), .Y(rst_n_buf_r4) );
  BUF_X2 u_clk_buf_r5 ( .A(clk_in_th), .Y(clk_buf_r5) );
  BUF_X2 u_rst_buf_r5 ( .A(rst_n), .Y(rst_n_buf_r5) );
  BUF_X2 u_clk_buf_r6 ( .A(clk_in_th), .Y(clk_buf_r6) );
  BUF_X2 u_rst_buf_r6 ( .A(rst_n), .Y(rst_n_buf_r6) );
  BUF_X2 u_clk_buf_r7 ( .A(clk_in_th), .Y(clk_buf_r7) );
  BUF_X2 u_rst_buf_r7 ( .A(rst_n), .Y(rst_n_buf_r7) );
  BUF_X2 u_clk_buf_r8 ( .A(clk_in_th), .Y(clk_buf_r8) );
  BUF_X2 u_rst_buf_r8 ( .A(rst_n), .Y(rst_n_buf_r8) );
  BUF_X2 u_clk_buf_r9 ( .A(clk_in_th), .Y(clk_buf_r9) );
  BUF_X2 u_rst_buf_r9 ( .A(rst_n), .Y(rst_n_buf_r9) );
  BUF_X2 u_clk_buf_r10 ( .A(clk_in_th), .Y(clk_buf_r10) );
  BUF_X2 u_rst_buf_r10 ( .A(rst_n), .Y(rst_n_buf_r10) );
  BUF_X2 u_fobuf_1_g0 ( .A(opa_0), .Y(fo_net_1_g0) );
  BUF_X2 u_fobuf_2_g1 ( .A(opa_0), .Y(fo_net_2_g1) );
  BUF_X2 u_fobuf_3_g0 ( .A(opa_1), .Y(fo_net_3_g0) );
  BUF_X2 u_fobuf_4_g1 ( .A(opa_1), .Y(fo_net_4_g1) );
  BUF_X2 u_fobuf_5_g0 ( .A(sram_do[0]), .Y(fo_net_5_g0) );
  BUF_X2 u_fobuf_6_g1 ( .A(sram_do[0]), .Y(fo_net_6_g1) );
  BUF_X2 u_fobuf_7_g0 ( .A(acc_2), .Y(fo_net_7_g0) );
  BUF_X2 u_fobuf_8_g1 ( .A(acc_2), .Y(fo_net_8_g1) );
  BUF_X2 u_fobuf_9_g0 ( .A(acc_1), .Y(fo_net_9_g0) );
  BUF_X2 u_fobuf_10_g1 ( .A(acc_1), .Y(fo_net_10_g1) );
  BUF_X2 u_fobuf_11_g0 ( .A(acc_0), .Y(fo_net_11_g0) );
  BUF_X2 u_fobuf_12_g1 ( .A(acc_0), .Y(fo_net_12_g1) );
  BUF_X2 u_fobuf_13_g0 ( .A(sram_do[2]), .Y(fo_net_13_g0) );
  BUF_X2 u_fobuf_14_g1 ( .A(sram_do[2]), .Y(fo_net_14_g1) );
  BUF_X2 u_fobuf_15_g0 ( .A(sram_do[1]), .Y(fo_net_15_g0) );
  BUF_X2 u_fobuf_16_g1 ( .A(sram_do[1]), .Y(fo_net_16_g1) );
  BUF_X2 u_fobuf_17_g0 ( .A(_0072_), .Y(fo_net_17_g0) );
  BUF_X2 u_fobuf_18_g1 ( .A(_0072_), .Y(fo_net_18_g1) );
  BUF_X2 u_fobuf_19_g0 ( .A(_0010_), .Y(fo_net_19_g0) );
  BUF_X2 u_fobuf_20_g1 ( .A(_0010_), .Y(fo_net_20_g1) );
  BUF_X2 u_fobuf_21_g0 ( .A(opa_2), .Y(fo_net_21_g0) );
  BUF_X2 u_fobuf_22_g1 ( .A(opa_2), .Y(fo_net_22_g1) );
  BUF_X2 u_fobuf_23_g0 ( .A(opa_3), .Y(fo_net_23_g0) );
  BUF_X2 u_fobuf_24_g1 ( .A(opa_3), .Y(fo_net_24_g1) );
  BUF_X2 u_fobuf_25_g0 ( .A(sync), .Y(fo_net_25_g0) );
  BUF_X2 u_fobuf_26_g1 ( .A(sync), .Y(fo_net_26_g1) );
  BUF_X2 u_fobuf_27_g0 ( .A(_0006_), .Y(fo_net_27_g0) );
  BUF_X2 u_fobuf_28_g1 ( .A(_0006_), .Y(fo_net_28_g1) );
  BUF_X2 u_fobuf_29_g0 ( .A(_0088_), .Y(fo_net_29_g0) );
  BUF_X2 u_fobuf_30_g1 ( .A(_0088_), .Y(fo_net_30_g1) );
  BUF_X2 u_fobuf_31_g0 ( .A(_0114_), .Y(fo_net_31_g0) );
  BUF_X2 u_fobuf_32_g1 ( .A(_0114_), .Y(fo_net_32_g1) );
  BUF_X2 u_fobuf_33_g0 ( .A(_0149_), .Y(fo_net_33_g0) );
  BUF_X2 u_fobuf_34_g1 ( .A(_0149_), .Y(fo_net_34_g1) );
  BUF_X2 u_fobuf_35_g0 ( .A(sram_do[3]), .Y(fo_net_35_g0) );
  BUF_X2 u_fobuf_36_g1 ( .A(sram_do[3]), .Y(fo_net_36_g1) );
endmodule
