jun1okamura/TR-1um_C4004_Clone2Build/TR-1um_C4004_03/openroad/c4004_core_syn.v

// Synthesized and Buffered Gate-Level Netlist for c4004_core (Trial 02: 10 Rows)
module c4004_core (
  clk,
  rst,
  test,
  d_in,
  d_out,
  d_oe,
  d_hiz,
  sync,
  cm_rom,
  cm_ram
);
  input clk;
  input rst;
  input test;
  input [3:0] d_in;
  output [3:0] d_out;
  output d_oe;
  output d_hiz;
  output sync;
  output cm_rom;
  output [3:0] cm_ram;

  wire [3:0] sram_din;
  wire [3:0] sram_do;
  wire _0000_;
  wire _0001_;
  wire _0002_;
  wire _0003_;
  wire _0004_;
  wire _0005_;
  wire _0006_;
  wire _0007_;
  wire _0008_;
  wire _0009_;
  wire _0010_;
  wire _0011_;
  wire _0012_;
  wire _0013_;
  wire _0014_;
  wire _0015_;
  wire _0016_;
  wire _0017_;
  wire _0018_;
  wire _0019_;
  wire _0035_;
  wire _0037_;
  wire _0038_;
  wire _0039_;
  wire _0040_;
  wire _0041_;
  wire _0042_;
  wire _0043_;
  wire _0044_;
  wire _0048_;
  wire _0051_;
  wire _0053_;
  wire _0054_;
  wire _0055_;
  wire _0056_;
  wire _0057_;
  wire _0058_;
  wire _0059_;
  wire _0060_;
  wire _0061_;
  wire _0062_;
  wire _0063_;
  wire _0064_;
  wire _0065_;
  wire _0066_;
  wire _0067_;
  wire _0068_;
  wire _0069_;
  wire _0070_;
  wire _0071_;
  wire _0072_;
  wire _0073_;
  wire _0074_;
  wire _0075_;
  wire _0076_;
  wire _0077_;
  wire _0078_;
  wire _0079_;
  wire _0080_;
  wire _0081_;
  wire _0082_;
  wire _0083_;
  wire _0084_;
  wire _0085_;
  wire _0086_;
  wire _0087_;
  wire _0088_;
  wire _0089_;
  wire _0090_;
  wire _0091_;
  wire _0092_;
  wire _0093_;
  wire _0094_;
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
  wire clk_buf_r5;
  wire clk_buf_r6;
  wire clk_buf_r7;
  wire clk_buf_r8;
  wire clk_buf_r9;
  wire clk_in_th;
  wire cy;
  wire din0_in_th;
  wire din1_in_th;
  wire din2_in_th;
  wire din3_in_th;
  wire fo_net_10_g1;
  wire fo_net_11_g0;
  wire fo_net_12_g1;
  wire fo_net_13_g0;
  wire fo_net_14_g1;
  wire fo_net_15_g0;
  wire fo_net_16_g1;
  wire fo_net_17_g0;
  wire fo_net_18_g1;
  wire fo_net_19_g2;
  wire fo_net_1_g0;
  wire fo_net_20_g0;
  wire fo_net_21_g1;
  wire fo_net_22_g0;
  wire fo_net_23_g1;
  wire fo_net_24_g0;
  wire fo_net_25_g1;
  wire fo_net_26_g0;
  wire fo_net_27_g1;
  wire fo_net_28_g0;
  wire fo_net_29_g1;
  wire fo_net_2_g1;
  wire fo_net_3_g0;
  wire fo_net_4_g1;
  wire fo_net_5_g0;
  wire fo_net_6_g1;
  wire fo_net_7_g0;
  wire fo_net_8_g1;
  wire fo_net_9_g0;
  wire isz_taken;
  wire opa_0;
  wire opa_1;
  wire opa_2;
  wire opa_3;
  wire opr_0;
  wire opr_1;
  wire opr_2;
  wire opr_3;
  wire pc_cout;
  wire pc_init_n;
  wire phase_0;
  wire phase_1;
  wire phase_2;
  wire rst_in_th;
  wire rst_n;
  wire rst_n_buf_r1;
  wire rst_n_buf_r10;
  wire rst_n_buf_r2;
  wire rst_n_buf_r3;
  wire rst_n_buf_r4;
  wire rst_n_buf_r5;
  wire rst_n_buf_r6;
  wire rst_n_buf_r7;
  wire rst_n_buf_r8;
  wire rst_n_buf_r9;
  wire sp_0;
  wire sp_1;
  wire sram_addr_0;
  wire sram_addr_1;
  wire sram_addr_2;
  wire sram_addr_3;
  wire sram_addr_4;
  wire sram_ce;
  wire sram_we;
  wire test_in_th;
  wire two_cycle;
  INV_X1 _0548_ ( .A(buf_m_2), .Y(_0053_) );
  INV_X1 _0549_ ( .A(fo_net_1_g0), .Y(_0054_) );
  INV_X1 _0550_ ( .A(buf_l_2), .Y(_0055_) );
  INV_X1 _0551_ ( .A(buf_l_1), .Y(_0056_) );
  INV_X1 _0552_ ( .A(fo_net_3_g0), .Y(_0057_) );
  INV_X1 _0553_ ( .A(buf_l_0), .Y(_0058_) );
  INV_X1 _0554_ ( .A(opa_3), .Y(_0059_) );
  INV_X1 _0555_ ( .A(acc_0), .Y(_0060_) );
  INV_X1 _0556_ ( .A(buf_m_3), .Y(_0061_) );
  INV_X1 _0557_ ( .A(cy), .Y(_0062_) );
  INV_X1 _0558_ ( .A(fo_net_5_g0), .Y(_0063_) );
  INV_X1 _0559_ ( .A(acc_3), .Y(_0064_) );
  INV_X1 _0560_ ( .A(fo_net_7_g0), .Y(_0065_) );
  INV_X1 _0561_ ( .A(sp_0), .Y(_0066_) );
  INV_X1 _0562_ ( .A(sp_1), .Y(_0067_) );
  INV_X1 _0563_ ( .A(_0007_), .Y(_0068_) );
  INV_X1 _0564_ ( .A(phase_2), .Y(_0069_) );
  INV_X1 _0565_ ( .A(din1_in_th), .Y(_0070_) );
  INV_X1 _0566_ ( .A(din3_in_th), .Y(_0071_) );
  INV_X1 _0567_ ( .A(din2_in_th), .Y(_0072_) );
  INV_X1 _0568_ ( .A(din0_in_th), .Y(_0073_) );
  INV_X1 _0569_ ( .A(fo_net_10_g1), .Y(_0074_) );
  INV_X1 _0570_ ( .A(buf_l_3), .Y(_0075_) );
  INV_X1 _0571_ ( .A(rst_in_th), .Y(rst_n) );
  INV_X1 _0572_ ( .A(buf_h_2), .Y(_0076_) );
  INV_X1 _0573_ ( .A(buf_h_1), .Y(_0077_) );
  INV_X1 _0574_ ( .A(buf_h_0), .Y(_0078_) );
  INV_X1 _0575_ ( .A(fo_net_12_g1), .Y(_0079_) );
  INV_X1 _0576_ ( .A(buf_h_3), .Y(_0080_) );
  NOR4 _0577_ ( .A(acc_0), .B(fo_net_6_g1), .C(acc_3), .D(fo_net_8_g1), .Y(_0081_) );
  AOI22 _0578_ ( .A1(opa_1), .A2(cy), .B1(_0081_), .B2(fo_net_1_g0), .Y(_0082_) );
  OAI21 _0579_ ( .A1(_0057_), .A2(test_in_th), .B(_0082_), .Y(_0083_) );
  OR3 _0580_ ( .A(_0018_), .B(_0539_), .C(_0000_), .Y(_0084_) );
  INV_X1 _0581_ ( .A(fo_net_13_g0), .Y(sync) );
  NOR2 _0582_ ( .A(opr_3), .B(opr_2), .Y(_0085_) );
  NOR2 _0583_ ( .A(_0547_), .B(opr_1), .Y(_0086_) );
  NAND2 _0584_ ( .A(_0085_), .B(_0086_), .Y(_0087_) );
  XNOR2 _0585_ ( .A(_0059_), .B(_0083_), .Y(_0088_) );
  OR3 _0586_ ( .A(fo_net_14_g1), .B(_0087_), .C(_0088_), .Y(_0089_) );
  INV_X1 _0587_ ( .A(_0089_), .Y(_0090_) );
  NOR2 _0588_ ( .A(_0546_), .B(opr_3), .Y(_0091_) );
  NOR2 _0589_ ( .A(opr_1), .B(opr_0), .Y(_0092_) );
  NOR2 _0590_ ( .A(_0086_), .B(_0092_), .Y(_0093_) );
  OAI21 _0591_ ( .A1(_0086_), .A2(_0092_), .B(_0091_), .Y(_0094_) );
  NOR2 _0592_ ( .A(_0547_), .B(fo_net_16_g1), .Y(_0095_) );
  OR3 _0593_ ( .A(_0546_), .B(fo_net_15_g0), .C(opr_3), .Y(_0096_) );
  NAND2 _0594_ ( .A(_0091_), .B(_0095_), .Y(_0097_) );
  NAND3 _0595_ ( .A(_0087_), .B(_0094_), .C(_0097_), .Y(_0098_) );
  OAI21 _0596_ ( .A1(isz_taken), .A2(_0097_), .B(_0098_), .Y(_0099_) );
  NAND2 _0597_ ( .A(fo_net_19_g2), .B(_0099_), .Y(_0100_) );
  OR2 _0598_ ( .A(phase_0), .B(phase_1), .Y(_0101_) );
  NOR2 _0599_ ( .A(_0000_), .B(_0101_), .Y(_0102_) );
  NOR2 _0600_ ( .A(fo_net_19_g2), .B(_0102_), .Y(_0103_) );
  NAND3 _0601_ ( .A(fo_net_4_g1), .B(fo_net_12_g1), .C(_0085_), .Y(_0104_) );
  NAND4 _0602_ ( .A(fo_net_4_g1), .B(fo_net_12_g1), .C(_0085_), .D(_0095_), .Y(_0105_) );
  OR2 _0603_ ( .A(phase_1), .B(_0539_), .Y(_0106_) );
  NOR2 _0604_ ( .A(_0000_), .B(fo_net_21_g1), .Y(_0107_) );
  OR2 _0605_ ( .A(_0000_), .B(fo_net_21_g1), .Y(_0108_) );
  NOR4 _0606_ ( .A(_0547_), .B(fo_net_15_g0), .C(opr_3), .D(opr_2), .Y(_0109_) );
  INV_X1 _0607_ ( .A(_0109_), .Y(_0110_) );
  AND3_X1 _0608_ ( .A(_0015_), .B(fo_net_12_g1), .C(_0109_), .Y(_0111_) );
  INV_X1 _0609_ ( .A(_0111_), .Y(_0112_) );
  NOR2 _0610_ ( .A(_0108_), .B(_0111_), .Y(_0113_) );
  NAND2 _0611_ ( .A(_0105_), .B(_0113_), .Y(_0114_) );
  NOR3 _0612_ ( .A(fo_net_17_g0), .B(_0102_), .C(fo_net_22_g0), .Y(_0115_) );
  NAND2 _0613_ ( .A(_0103_), .B(_0108_), .Y(_0116_) );
  NOR2 _0614_ ( .A(phase_2), .B(fo_net_20_g0), .Y(_0117_) );
  NAND2 _0615_ ( .A(fo_net_10_g1), .B(_0085_), .Y(_0118_) );
  NOR2 _0616_ ( .A(fo_net_16_g1), .B(_0118_), .Y(_0119_) );
  OR2 _0617_ ( .A(fo_net_16_g1), .B(_0118_), .Y(_0120_) );
  NOR2 _0618_ ( .A(_0074_), .B(_0110_), .Y(_0121_) );
  NAND2 _0619_ ( .A(fo_net_10_g1), .B(_0109_), .Y(_0122_) );
  OAI22 _0620_ ( .A1(fo_net_10_g1), .A2(_0103_), .B1(_0116_), .B2(_0117_), .Y(_0123_) );
  AOI21 _0621_ ( .A1(_0117_), .A2(_0121_), .B(_0123_), .Y(_0124_) );
  NAND4 _0622_ ( .A(_0089_), .B(_0100_), .C(_0114_), .D(_0124_), .Y(_0125_) );
  AOI21 _0623_ ( .A1(fo_net_9_g0), .A2(_0109_), .B(_0002_), .Y(_0126_) );
  MUX2 _0624_ ( .A(buf_m_0), .B(sram_do[0]), .S(_0126_), .Y(_0127_) );
  MUX2 _0625_ ( .A(buf_h_0), .B(sram_do[0]), .S(pc_init_n), .Y(_0128_) );
  INV_X1 _0626_ ( .A(_0128_), .Y(_0129_) );
  NAND2 _0627_ ( .A(_0069_), .B(_0101_), .Y(_0130_) );
  AOI21 _0628_ ( .A1(fo_net_21_g1), .A2(_0129_), .B(_0130_), .Y(_0131_) );
  OAI21 _0629_ ( .A1(fo_net_21_g1), .A2(_0127_), .B(_0131_), .Y(_0132_) );
  MUX2 _0630_ ( .A(buf_l_0), .B(sram_do[0]), .S(_0126_), .Y(_0133_) );
  NOR2 _0631_ ( .A(phase_2), .B(_0101_), .Y(_0134_) );
  OAI21 _0632_ ( .A1(buf_l_0), .A2(_0096_), .B(phase_2), .Y(_0135_) );
  AOI21 _0633_ ( .A1(_0060_), .A2(_0096_), .B(_0135_), .Y(_0136_) );
  AOI21 _0634_ ( .A1(_0133_), .A2(_0134_), .B(_0136_), .Y(_0137_) );
  NOR4 _0635_ ( .A(_0546_), .B(_0004_), .C(fo_net_15_g0), .D(opr_0), .Y(_0138_) );
  OR4 _0636_ ( .A(_0546_), .B(_0004_), .C(fo_net_15_g0), .D(opr_0), .Y(_0139_) );
  NAND2 _0637_ ( .A(fo_net_3_g0), .B(fo_net_24_g0), .Y(_0140_) );
  NAND2 _0638_ ( .A(_0057_), .B(fo_net_24_g0), .Y(_0141_) );
  NOR2 _0639_ ( .A(_0004_), .B(opr_2), .Y(_0142_) );
  OR4 _0640_ ( .A(_0004_), .B(opr_2), .C(opr_1), .D(opr_0), .Y(_0143_) );
  OR4 _0641_ ( .A(_0004_), .B(_0547_), .C(opr_2), .D(opr_1), .Y(_0144_) );
  AND2_X1 _0642_ ( .A(_0143_), .B(_0144_), .Y(_0145_) );
  NOR2 _0643_ ( .A(opa_1), .B(fo_net_4_g1), .Y(_0146_) );
  NOR2 _0644_ ( .A(fo_net_2_g1), .B(_0001_), .Y(_0147_) );
  OR4 _0645_ ( .A(fo_net_2_g1), .B(opa_1), .C(fo_net_4_g1), .D(_0001_), .Y(_0148_) );
  OAI22 _0646_ ( .A1(din0_in_th), .A2(_0141_), .B1(_0148_), .B2(fo_net_24_g0), .Y(_0149_) );
  OAI21 _0647_ ( .A1(_0073_), .A2(_0140_), .B(_0145_), .Y(_0150_) );
  NAND2 _0648_ ( .A(phase_2), .B(_0096_), .Y(_0151_) );
  INV_X1 _0649_ ( .A(_0151_), .Y(_0152_) );
  NOR3 _0650_ ( .A(_0012_), .B(_0092_), .C(_0144_), .Y(_0153_) );
  NOR2 _0651_ ( .A(buf_l_0), .B(_0143_), .Y(_0154_) );
  NOR3 _0652_ ( .A(_0151_), .B(_0153_), .C(_0154_), .Y(_0155_) );
  OAI21 _0653_ ( .A1(_0149_), .A2(_0150_), .B(_0155_), .Y(_0156_) );
  AOI21 _0654_ ( .A1(_0132_), .A2(_0137_), .B(_0156_), .Y(_0157_) );
  AND3_X1 _0655_ ( .A(_0132_), .B(_0137_), .C(_0156_), .Y(_0158_) );
  NAND3 _0656_ ( .A(_0132_), .B(_0137_), .C(_0156_), .Y(_0159_) );
  NOR2 _0657_ ( .A(_0157_), .B(_0158_), .Y(_0160_) );
  NOR2 _0658_ ( .A(pc_cout), .B(_0130_), .Y(_0161_) );
  NAND3 _0659_ ( .A(fo_net_3_g0), .B(fo_net_24_g0), .C(_0144_), .Y(_0162_) );
  AOI21 _0660_ ( .A1(_0143_), .A2(_0162_), .B(cy), .Y(_0163_) );
  NAND2 _0661_ ( .A(_0068_), .B(_0143_), .Y(_0164_) );
  AOI21 _0662_ ( .A1(_0141_), .A2(_0144_), .B(_0164_), .Y(_0165_) );
  NOR2 _0663_ ( .A(fo_net_2_g1), .B(opa_3), .Y(_0166_) );
  NOR4 _0664_ ( .A(fo_net_2_g1), .B(fo_net_3_g0), .C(opa_3), .D(_0016_), .Y(_0167_) );
  INV_X1 _0665_ ( .A(_0167_), .Y(_0168_) );
  NAND3 _0666_ ( .A(_0139_), .B(_0143_), .C(_0144_), .Y(_0169_) );
  NOR2 _0667_ ( .A(_0167_), .B(_0169_), .Y(_0170_) );
  OR3 _0668_ ( .A(_0163_), .B(_0165_), .C(_0170_), .Y(_0171_) );
  AOI21 _0669_ ( .A1(_0152_), .A2(_0171_), .B(_0161_), .Y(_0172_) );
  XOR2 _0670_ ( .A(_0160_), .B(_0172_), .Y(_0173_) );
  NAND2 _0671_ ( .A(_0115_), .B(_0173_), .Y(_0174_) );
  AOI22 _0672_ ( .A1(buf_l_0), .A2(fo_net_17_g0), .B1(fo_net_22_g0), .B2(sram_do[0]), .Y(_0175_) );
  NAND2 _0673_ ( .A(din0_in_th), .B(_0102_), .Y(_0176_) );
  NAND3 _0674_ ( .A(_0174_), .B(_0175_), .C(_0176_), .Y(_0177_) );
  AOI21 _0676_ ( .A1(_0159_), .A2(_0172_), .B(_0157_), .Y(_0178_) );
  MUX2 _0677_ ( .A(buf_m_1), .B(sram_do[1]), .S(_0126_), .Y(_0179_) );
  MUX2 _0678_ ( .A(buf_h_1), .B(sram_do[1]), .S(pc_init_n), .Y(_0180_) );
  INV_X1 _0679_ ( .A(_0180_), .Y(_0181_) );
  AOI21 _0680_ ( .A1(fo_net_20_g0), .A2(_0181_), .B(_0130_), .Y(_0182_) );
  OAI21 _0681_ ( .A1(fo_net_21_g1), .A2(_0179_), .B(_0182_), .Y(_0183_) );
  MUX2 _0682_ ( .A(buf_l_1), .B(sram_do[1]), .S(_0126_), .Y(_0184_) );
  NAND2 _0683_ ( .A(_0134_), .B(_0184_), .Y(_0185_) );
  AOI21 _0684_ ( .A1(_0065_), .A2(_0096_), .B(_0069_), .Y(_0186_) );
  OAI21 _0685_ ( .A1(buf_l_1), .A2(_0096_), .B(_0186_), .Y(_0187_) );
  NAND3 _0686_ ( .A(_0183_), .B(_0185_), .C(_0187_), .Y(_0188_) );
  AND3_X1 _0687_ ( .A(acc_0), .B(_0544_), .C(_0543_), .Y(_0189_) );
  AOI21 _0688_ ( .A1(_0544_), .A2(fo_net_7_g0), .B(fo_net_5_g0), .Y(_0190_) );
  NOR3 _0689_ ( .A(_0064_), .B(_0189_), .C(_0190_), .Y(_0191_) );
  NAND2 _0690_ ( .A(_0062_), .B(_0148_), .Y(_0192_) );
  NOR2 _0691_ ( .A(_0015_), .B(_0016_), .Y(_0193_) );
  OR4 _0692_ ( .A(fo_net_1_g0), .B(_0001_), .C(_0015_), .D(_0016_), .Y(_0194_) );
  AND2_X1 _0693_ ( .A(_0148_), .B(_0194_), .Y(_0195_) );
  AOI21 _0694_ ( .A1(_0148_), .A2(_0194_), .B(fo_net_25_g1), .Y(_0196_) );
  OAI21 _0695_ ( .A1(_0191_), .A2(_0192_), .B(_0196_), .Y(_0197_) );
  MUX2 _0696_ ( .A(_0140_), .B(_0141_), .S(_0070_), .Y(_0198_) );
  NAND3 _0697_ ( .A(_0145_), .B(_0197_), .C(_0198_), .Y(_0199_) );
  OR2 _0698_ ( .A(buf_l_1), .B(_0143_), .Y(_0200_) );
  NOR3 _0699_ ( .A(_0013_), .B(_0092_), .C(_0144_), .Y(_0201_) );
  NOR2 _0700_ ( .A(_0151_), .B(_0201_), .Y(_0202_) );
  NAND3 _0701_ ( .A(_0199_), .B(_0200_), .C(_0202_), .Y(_0203_) );
  NAND4 _0702_ ( .A(_0188_), .B(_0199_), .C(_0200_), .D(_0202_), .Y(_0204_) );
  XOR2 _0703_ ( .A(_0188_), .B(_0203_), .Y(_0205_) );
  XOR2 _0704_ ( .A(_0178_), .B(_0205_), .Y(_0206_) );
  NAND2 _0705_ ( .A(_0115_), .B(_0206_), .Y(_0207_) );
  NAND2 _0706_ ( .A(din1_in_th), .B(_0102_), .Y(_0208_) );
  AOI22 _0707_ ( .A1(buf_l_1), .A2(fo_net_17_g0), .B1(fo_net_22_g0), .B2(sram_do[1]), .Y(_0209_) );
  NAND3 _0708_ ( .A(_0207_), .B(_0208_), .C(_0209_), .Y(_0210_) );
  OAI21 _0710_ ( .A1(_0178_), .A2(_0205_), .B(_0204_), .Y(_0211_) );
  MUX2 _0711_ ( .A(buf_m_2), .B(sram_do[2]), .S(_0126_), .Y(_0212_) );
  MUX2 _0712_ ( .A(buf_h_2), .B(sram_do[2]), .S(pc_init_n), .Y(_0213_) );
  INV_X1 _0713_ ( .A(_0213_), .Y(_0214_) );
  AOI21 _0714_ ( .A1(fo_net_20_g0), .A2(_0214_), .B(_0130_), .Y(_0215_) );
  OAI21 _0715_ ( .A1(fo_net_21_g1), .A2(_0212_), .B(_0215_), .Y(_0216_) );
  MUX2 _0716_ ( .A(buf_l_2), .B(sram_do[2]), .S(_0126_), .Y(_0217_) );
  NAND2 _0717_ ( .A(_0134_), .B(_0217_), .Y(_0218_) );
  AOI21 _0718_ ( .A1(_0063_), .A2(_0096_), .B(_0069_), .Y(_0219_) );
  OAI21 _0719_ ( .A1(buf_l_2), .A2(_0096_), .B(_0219_), .Y(_0220_) );
  AND3_X1 _0720_ ( .A(_0216_), .B(_0218_), .C(_0220_), .Y(_0221_) );
  MUX2 _0721_ ( .A(_0140_), .B(_0141_), .S(_0072_), .Y(_0222_) );
  NAND3 _0722_ ( .A(_0145_), .B(_0197_), .C(_0222_), .Y(_0223_) );
  NOR2 _0723_ ( .A(buf_l_2), .B(_0143_), .Y(_0224_) );
  NOR3 _0724_ ( .A(_0014_), .B(_0092_), .C(_0144_), .Y(_0225_) );
  NOR3 _0725_ ( .A(_0151_), .B(_0224_), .C(_0225_), .Y(_0226_) );
  NAND2 _0726_ ( .A(_0223_), .B(_0226_), .Y(_0227_) );
  NOR2 _0727_ ( .A(_0221_), .B(_0227_), .Y(_0228_) );
  NAND2 _0728_ ( .A(_0221_), .B(_0227_), .Y(_0229_) );
  XNOR2 _0729_ ( .A(_0221_), .B(_0227_), .Y(_0230_) );
  XOR2 _0730_ ( .A(_0211_), .B(_0230_), .Y(_0231_) );
  AOI22 _0731_ ( .A1(buf_l_2), .A2(fo_net_17_g0), .B1(fo_net_22_g0), .B2(sram_do[2]), .Y(_0232_) );
  AOI21 _0732_ ( .A1(din2_in_th), .A2(_0102_), .B(_0125_), .Y(_0233_) );
  OAI21 _0733_ ( .A1(_0116_), .A2(_0231_), .B(_0233_), .Y(_0234_) );
  INV_X1 _0734_ ( .A(_0234_), .Y(_0235_) );
  AOI22 _0735_ ( .A1(_0053_), .A2(_0125_), .B1(_0232_), .B2(_0235_), .Y(_0019_) );
  NOR3 _0736_ ( .A(phase_0), .B(_0018_), .C(_0000_), .Y(_0236_) );
  OR3 _0737_ ( .A(phase_0), .B(_0018_), .C(_0000_), .Y(_0237_) );
  NOR3 _0738_ ( .A(fo_net_16_g1), .B(opr_0), .C(_0104_), .Y(_0238_) );
  INV_X1 _0739_ ( .A(_0238_), .Y(_0239_) );
  NAND3 _0740_ ( .A(_0001_), .B(fo_net_11_g0), .C(fo_net_25_g1), .Y(_0240_) );
  AOI21 _0741_ ( .A1(_0239_), .A2(_0240_), .B(_0237_), .Y(_0241_) );
  MUX2 _0742_ ( .A(fo_net_5_g0), .B(buf_l_2), .S(_0238_), .Y(_0242_) );
  AOI22 _0743_ ( .A1(_0117_), .A2(_0212_), .B1(_0241_), .B2(_0242_), .Y(_0243_) );
  NOR3 _0744_ ( .A(phase_0), .B(_0018_), .C(phase_2), .Y(_0244_) );
  NOR2 _0745_ ( .A(fo_net_13_g0), .B(_0239_), .Y(_0245_) );
  AOI22 _0746_ ( .A1(_0213_), .A2(fo_net_26_g0), .B1(_0245_), .B2(sram_do[2]), .Y(_0246_) );
  NAND3 _0747_ ( .A(_0218_), .B(_0243_), .C(_0246_), .Y(d_out[2]) );
  AOI21 _0748_ ( .A1(_0547_), .A2(opr_0), .B(fo_net_16_g1), .Y(_0247_) );
  AND2_X1 _0749_ ( .A(_0091_), .B(_0247_), .Y(_0248_) );
  NAND2 _0750_ ( .A(_0091_), .B(_0247_), .Y(_0249_) );
  NAND3 _0751_ ( .A(_0546_), .B(opr_1), .C(opr_0), .Y(_0250_) );
  NAND2 _0752_ ( .A(opr_2), .B(_0250_), .Y(_0251_) );
  AOI21 _0753_ ( .A1(opr_3), .A2(_0251_), .B(_0248_), .Y(_0252_) );
  NOR2 _0754_ ( .A(_0079_), .B(_0252_), .Y(_0253_) );
  AND2_X1 _0755_ ( .A(_0105_), .B(_0239_), .Y(_0254_) );
  OAI21 _0756_ ( .A1(_0079_), .A2(_0252_), .B(_0254_), .Y(_0255_) );
  NAND2 _0757_ ( .A(_0105_), .B(_0112_), .Y(_0256_) );
  OR2 _0758_ ( .A(_0111_), .B(_0255_), .Y(_0257_) );
  NAND2 _0759_ ( .A(fo_net_23_g1), .B(_0257_), .Y(_0258_) );
  NOR2 _0760_ ( .A(fo_net_23_g1), .B(fo_net_29_g1), .Y(_0259_) );
  NAND2 _0761_ ( .A(_0119_), .B(fo_net_29_g1), .Y(_0260_) );
  AOI22 _0762_ ( .A1(fo_net_19_g2), .A2(_0120_), .B1(_0259_), .B2(_0103_), .Y(_0261_) );
  AND3_X1 _0763_ ( .A(_0258_), .B(_0260_), .C(_0261_), .Y(_0262_) );
  OR2 _0764_ ( .A(_0108_), .B(_0257_), .Y(_0263_) );
  INV_X1 _0765_ ( .A(_0263_), .Y(_0264_) );
  OAI21 _0766_ ( .A1(_0119_), .A2(_0237_), .B(_0263_), .Y(_0265_) );
  NAND2 _0767_ ( .A(fo_net_19_g2), .B(_0119_), .Y(_0266_) );
  OAI21 _0768_ ( .A1(_0000_), .A2(_0101_), .B(_0266_), .Y(_0267_) );
  AOI22 _0769_ ( .A1(buf_h_2), .A2(_0265_), .B1(_0267_), .B2(buf_m_2), .Y(_0268_) );
  OAI21 _0770_ ( .A1(_0055_), .A2(_0262_), .B(_0268_), .Y(sram_din[2]) );
  AOI22 _0771_ ( .A1(buf_h_1), .A2(_0265_), .B1(_0267_), .B2(buf_m_1), .Y(_0269_) );
  OAI21 _0772_ ( .A1(_0056_), .A2(_0262_), .B(_0269_), .Y(sram_din[1]) );
  NAND2 _0773_ ( .A(_0111_), .B(_0120_), .Y(_0270_) );
  NAND2 _0774_ ( .A(fo_net_14_g1), .B(_0260_), .Y(_0271_) );
  AOI22 _0775_ ( .A1(_0113_), .A2(_0255_), .B1(_0270_), .B2(_0271_), .Y(_0272_) );
  NAND2 _0776_ ( .A(fo_net_14_g1), .B(_0259_), .Y(_0273_) );
  NOR2 _0777_ ( .A(_0102_), .B(_0117_), .Y(_0274_) );
  AOI21 _0778_ ( .A1(_0120_), .A2(fo_net_29_g1), .B(fo_net_27_g1), .Y(_0275_) );
  AND4_X1 _0779_ ( .A(_0263_), .B(_0273_), .C(_0274_), .D(_0275_), .Y(_0276_) );
  INV_X1 _0780_ ( .A(_0276_), .Y(sram_addr_4) );
  OAI22 _0781_ ( .A1(_0054_), .A2(_0272_), .B1(_0276_), .B2(_0066_), .Y(sram_addr_2) );
  AOI22 _0782_ ( .A1(buf_h_0), .A2(_0265_), .B1(_0267_), .B2(buf_m_0), .Y(_0277_) );
  OAI21 _0783_ ( .A1(_0058_), .A2(_0262_), .B(_0277_), .Y(sram_din[0]) );
  OAI22 _0784_ ( .A1(_0059_), .A2(_0272_), .B1(_0276_), .B2(_0067_), .Y(sram_addr_3) );
  OAI21 _0785_ ( .A1(_0113_), .A2(fo_net_29_g1), .B(opa_1), .Y(_0278_) );
  NAND3 _0786_ ( .A(opa_1), .B(fo_net_19_g2), .C(_0270_), .Y(_0279_) );
  NAND4 _0787_ ( .A(_0263_), .B(_0275_), .C(_0278_), .D(_0279_), .Y(sram_addr_1) );
  NAND4 _0788_ ( .A(fo_net_4_g1), .B(fo_net_23_g1), .C(_0253_), .D(_0254_), .Y(_0280_) );
  NAND2 _0789_ ( .A(fo_net_11_g0), .B(fo_net_19_g2), .Y(_0281_) );
  NAND2 _0790_ ( .A(fo_net_3_g0), .B(fo_net_18_g1), .Y(_0282_) );
  OAI21 _0791_ ( .A1(_0111_), .A2(_0119_), .B(fo_net_19_g2), .Y(_0283_) );
  NAND4 _0792_ ( .A(_0274_), .B(_0280_), .C(_0282_), .D(_0283_), .Y(sram_addr_0) );
  MUX2 _0793_ ( .A(fo_net_7_g0), .B(buf_l_1), .S(_0238_), .Y(_0284_) );
  AOI22 _0794_ ( .A1(_0117_), .A2(_0179_), .B1(_0241_), .B2(_0284_), .Y(_0285_) );
  AOI22 _0795_ ( .A1(_0180_), .A2(fo_net_26_g0), .B1(_0245_), .B2(sram_do[1]), .Y(_0286_) );
  NAND3 _0796_ ( .A(_0185_), .B(_0285_), .C(_0286_), .Y(d_out[1]) );
  NOR2 _0797_ ( .A(_0079_), .B(_0237_), .Y(_0287_) );
  NAND2 _0798_ ( .A(fo_net_12_g1), .B(fo_net_29_g1), .Y(_0288_) );
  NOR4 _0799_ ( .A(_0546_), .B(_0004_), .C(_0547_), .D(fo_net_15_g0), .Y(_0289_) );
  OR4 _0800_ ( .A(_0546_), .B(_0004_), .C(_0547_), .D(fo_net_15_g0), .Y(_0290_) );
  NOR2 _0801_ ( .A(opa_1), .B(_0015_), .Y(_0291_) );
  NOR2 _0802_ ( .A(_0017_), .B(_0001_), .Y(_0292_) );
  NAND2 _0803_ ( .A(_0291_), .B(_0292_), .Y(_0293_) );
  OR3 _0804_ ( .A(_0288_), .B(_0290_), .C(_0293_), .Y(_0294_) );
  MUX2 _0806_ ( .A(acc_0), .B(buf_l_0), .S(_0238_), .Y(_0295_) );
  AOI22 _0807_ ( .A1(_0117_), .A2(_0127_), .B1(_0241_), .B2(_0295_), .Y(_0296_) );
  NAND2 _0808_ ( .A(sram_do[0]), .B(_0245_), .Y(_0297_) );
  AOI22 _0809_ ( .A1(_0133_), .A2(_0134_), .B1(fo_net_26_g0), .B2(_0128_), .Y(_0298_) );
  NAND3 _0810_ ( .A(_0296_), .B(_0297_), .C(_0298_), .Y(d_out[0]) );
  NAND2 _0811_ ( .A(phase_0), .B(phase_1), .Y(_0299_) );
  XNOR2 _0812_ ( .A(phase_2), .B(_0299_), .Y(_0541_) );
  NAND2 _0813_ ( .A(fo_net_11_g0), .B(_0102_), .Y(_0300_) );
  NOR2 _0815_ ( .A(fo_net_11_g0), .B(_0237_), .Y(_0301_) );
  OAI21 _0816_ ( .A1(_0090_), .A2(fo_net_29_g1), .B(_0079_), .Y(_0302_) );
  NOR2 _0817_ ( .A(fo_net_10_g1), .B(fo_net_14_g1), .Y(_0303_) );
  NOR2 _0818_ ( .A(fo_net_12_g1), .B(_0100_), .Y(_0304_) );
  AOI21 _0819_ ( .A1(_0110_), .A2(_0303_), .B(_0304_), .Y(_0305_) );
  NOR3 _0820_ ( .A(_0018_), .B(phase_2), .C(_0539_), .Y(_0306_) );
  NOR3 _0821_ ( .A(fo_net_23_g1), .B(fo_net_28_g0), .C(_0306_), .Y(_0307_) );
  OR3 _0822_ ( .A(fo_net_23_g1), .B(fo_net_28_g0), .C(_0306_), .Y(_0308_) );
  NOR2 _0823_ ( .A(fo_net_18_g1), .B(_0308_), .Y(_0309_) );
  NAND2 _0824_ ( .A(fo_net_13_g0), .B(_0307_), .Y(_0310_) );
  MUX2 _0825_ ( .A(_0309_), .B(_0121_), .S(_0134_), .Y(_0311_) );
  NOR3 _0826_ ( .A(_0108_), .B(_0238_), .C(_0253_), .Y(_0312_) );
  NAND2 _0827_ ( .A(fo_net_23_g1), .B(_0256_), .Y(_0313_) );
  AOI21 _0828_ ( .A1(_0095_), .A2(_0142_), .B(_0248_), .Y(_0314_) );
  AOI22 _0829_ ( .A1(_0074_), .A2(_0306_), .B1(_0314_), .B2(fo_net_28_g0), .Y(_0315_) );
  NAND2 _0830_ ( .A(_0313_), .B(_0315_), .Y(_0316_) );
  NOR3 _0831_ ( .A(_0311_), .B(_0312_), .C(_0316_), .Y(_0317_) );
  NAND3 _0832_ ( .A(_0302_), .B(_0305_), .C(_0317_), .Y(_0318_) );
  OAI21 _0833_ ( .A1(fo_net_6_g1), .A2(_0248_), .B(fo_net_28_g0), .Y(_0319_) );
  AOI21 _0834_ ( .A1(_0310_), .A2(_0319_), .B(_0231_), .Y(_0320_) );
  NAND3 _0835_ ( .A(fo_net_6_g1), .B(fo_net_28_g0), .C(_0249_), .Y(_0321_) );
  NAND2 _0836_ ( .A(din2_in_th), .B(_0306_), .Y(_0322_) );
  MUX2 _0837_ ( .A(sram_do[2]), .B(buf_m_2), .S(fo_net_9_g0), .Y(_0323_) );
  AOI22 _0838_ ( .A1(sram_do[2]), .A2(fo_net_22_g0), .B1(_0323_), .B2(fo_net_18_g1), .Y(_0324_) );
  NAND3 _0839_ ( .A(_0321_), .B(_0322_), .C(_0324_), .Y(_0325_) );
  OR2 _0840_ ( .A(_0320_), .B(_0325_), .Y(_0326_) );
  OR2 _0841_ ( .A(fo_net_18_g1), .B(_0231_), .Y(_0327_) );
  AOI21 _0843_ ( .A1(_0146_), .A2(_0147_), .B(_0167_), .Y(_0328_) );
  AND2_X1 _0844_ ( .A(_0168_), .B(_0195_), .Y(_0329_) );
  NOR2 _0845_ ( .A(opa_3), .B(_0017_), .Y(_0330_) );
  AND2_X1 _0846_ ( .A(_0193_), .B(_0330_), .Y(_0331_) );
  AND2_X1 _0847_ ( .A(_0147_), .B(_0291_), .Y(_0332_) );
  NAND2 _0848_ ( .A(_0147_), .B(_0291_), .Y(_0333_) );
  AOI21 _0849_ ( .A1(_0146_), .A2(_0166_), .B(_0331_), .Y(_0334_) );
  NAND2 _0850_ ( .A(_0333_), .B(_0334_), .Y(_0335_) );
  AND2_X1 _0851_ ( .A(_0146_), .B(_0330_), .Y(_0336_) );
  AND2_X1 _0852_ ( .A(_0291_), .B(_0330_), .Y(_0337_) );
  NOR4 _0853_ ( .A(fo_net_3_g0), .B(opa_3), .C(_0017_), .D(_0016_), .Y(_0338_) );
  NOR2 _0854_ ( .A(_0337_), .B(_0338_), .Y(_0339_) );
  NOR4 _0855_ ( .A(_0335_), .B(_0336_), .C(_0337_), .D(_0338_), .Y(_0340_) );
  AND2_X1 _0856_ ( .A(_0329_), .B(_0340_), .Y(_0341_) );
  AND2_X1 _0857_ ( .A(_0146_), .B(_0292_), .Y(_0342_) );
  NOR2 _0858_ ( .A(_0290_), .B(_0342_), .Y(_0343_) );
  AOI21 _0859_ ( .A1(fo_net_25_g1), .A2(_0195_), .B(_0288_), .Y(_0344_) );
  AOI21 _0860_ ( .A1(fo_net_4_g1), .A2(_0015_), .B(_0016_), .Y(_0345_) );
  NOR4 _0861_ ( .A(fo_net_2_g1), .B(fo_net_4_g1), .C(_0001_), .D(_0016_), .Y(_0346_) );
  NOR2 _0862_ ( .A(_0342_), .B(_0346_), .Y(_0347_) );
  AOI21 _0863_ ( .A1(_0292_), .A2(_0345_), .B(_0332_), .Y(_0348_) );
  NAND3 _0864_ ( .A(_0293_), .B(_0347_), .C(_0348_), .Y(_0349_) );
  AND2_X1 _0865_ ( .A(_0287_), .B(_0349_), .Y(_0350_) );
  NOR3 _0866_ ( .A(_0546_), .B(_0004_), .C(_0093_), .Y(_0351_) );
  AND2_X1 _0867_ ( .A(_0142_), .B(_0247_), .Y(_0352_) );
  OR3 _0868_ ( .A(_0169_), .B(_0351_), .C(_0352_), .Y(_0353_) );
  INV_X1 _0869_ ( .A(_0353_), .Y(_0354_) );
  OR2 _0870_ ( .A(_0169_), .B(_0289_), .Y(_0355_) );
  OAI22 _0871_ ( .A1(_0344_), .A2(_0350_), .B1(_0353_), .B2(_0289_), .Y(_0356_) );
  AOI21 _0872_ ( .A1(_0341_), .A2(_0343_), .B(_0356_), .Y(_0357_) );
  AOI21 _0873_ ( .A1(_0072_), .A2(_0349_), .B(_0139_), .Y(_0358_) );
  OAI21 _0874_ ( .A1(_0329_), .A2(_0353_), .B(_0145_), .Y(_0359_) );
  NOR2 _0875_ ( .A(_0358_), .B(_0359_), .Y(_0360_) );
  OR2 _0876_ ( .A(_0231_), .B(_0360_), .Y(_0361_) );
  NOR4 _0877_ ( .A(acc_0), .B(fo_net_5_g0), .C(_0008_), .D(fo_net_7_g0), .Y(_0362_) );
  NAND2 _0878_ ( .A(_0341_), .B(_0362_), .Y(_0363_) );
  NOR4 _0879_ ( .A(fo_net_5_g0), .B(acc_3), .C(fo_net_8_g1), .D(_0545_), .Y(_0364_) );
  NOR3 _0880_ ( .A(_0081_), .B(_0362_), .C(_0364_), .Y(_0365_) );
  NOR4 _0881_ ( .A(acc_0), .B(_0544_), .C(acc_3), .D(fo_net_7_g0), .Y(_0366_) );
  NOR3 _0882_ ( .A(fo_net_5_g0), .B(acc_3), .C(_0543_), .Y(_0367_) );
  AOI21 _0883_ ( .A1(_0060_), .A2(_0367_), .B(_0366_), .Y(_0368_) );
  INV_X1 _0884_ ( .A(_0368_), .Y(_0369_) );
  NAND3 _0885_ ( .A(_0341_), .B(_0365_), .C(_0368_), .Y(_0370_) );
  NAND2 _0886_ ( .A(_0544_), .B(_0336_), .Y(_0371_) );
  AOI22 _0887_ ( .A1(fo_net_8_g1), .A2(_0337_), .B1(_0338_), .B2(acc_3), .Y(_0372_) );
  NAND4 _0888_ ( .A(_0363_), .B(_0370_), .C(_0371_), .D(_0372_), .Y(_0373_) );
  NAND2 _0889_ ( .A(_0354_), .B(_0373_), .Y(_0374_) );
  NAND2 _0890_ ( .A(_0349_), .B(_0358_), .Y(_0375_) );
  AOI22 _0891_ ( .A1(fo_net_1_g0), .A2(_0351_), .B1(_0352_), .B2(buf_l_2), .Y(_0376_) );
  NAND4 _0892_ ( .A(_0361_), .B(_0374_), .C(_0375_), .D(_0376_), .Y(_0377_) );
  AOI21 _0894_ ( .A1(_0070_), .A2(_0349_), .B(_0139_), .Y(_0378_) );
  OAI21 _0895_ ( .A1(_0359_), .A2(_0378_), .B(_0206_), .Y(_0379_) );
  OAI21 _0896_ ( .A1(_0365_), .A2(_0369_), .B(_0341_), .Y(_0380_) );
  AOI22 _0897_ ( .A1(acc_0), .A2(_0337_), .B1(_0338_), .B2(fo_net_6_g1), .Y(_0381_) );
  AOI22 _0898_ ( .A1(cy), .A2(_0332_), .B1(_0336_), .B2(_0543_), .Y(_0382_) );
  NAND3 _0899_ ( .A(_0380_), .B(_0381_), .C(_0382_), .Y(_0383_) );
  NAND2 _0900_ ( .A(_0354_), .B(_0383_), .Y(_0384_) );
  AOI22 _0901_ ( .A1(opa_1), .A2(_0351_), .B1(_0352_), .B2(buf_l_1), .Y(_0385_) );
  NAND2 _0902_ ( .A(_0349_), .B(_0378_), .Y(_0386_) );
  NAND4 _0903_ ( .A(_0379_), .B(_0384_), .C(_0385_), .D(_0386_), .Y(_0387_) );
  AOI21 _0905_ ( .A1(fo_net_11_g0), .A2(fo_net_25_g1), .B(_0238_), .Y(_0388_) );
  OAI21 _0906_ ( .A1(_0290_), .A2(_0293_), .B(_0388_), .Y(_0389_) );
  AOI21 _0907_ ( .A1(_0287_), .A2(_0389_), .B(fo_net_27_g1), .Y(_0390_) );
  OR2 _0908_ ( .A(_0010_), .B(_0390_), .Y(cm_ram[2]) );
  OR2 _0909_ ( .A(_0009_), .B(_0390_), .Y(cm_ram[1]) );
  OR4 _0910_ ( .A(bank_sel_1), .B(bank_sel_3), .C(bank_sel_2), .D(_0390_), .Y(cm_ram[0]) );
  NAND2 _0912_ ( .A(fo_net_11_g0), .B(_0306_), .Y(_0391_) );
  NOR2 _0914_ ( .A(_0097_), .B(_0288_), .Y(_0392_) );
  OR4 _0915_ ( .A(_0012_), .B(_0013_), .C(_0014_), .D(_0003_), .Y(_0393_) );
  AOI21 _0917_ ( .A1(_0060_), .A2(_0249_), .B(_0237_), .Y(_0394_) );
  NAND2 _0918_ ( .A(din0_in_th), .B(_0306_), .Y(_0395_) );
  MUX2 _0919_ ( .A(sram_do[0]), .B(buf_m_0), .S(fo_net_9_g0), .Y(_0396_) );
  AOI22 _0920_ ( .A1(sram_do[0]), .A2(fo_net_22_g0), .B1(_0396_), .B2(fo_net_17_g0), .Y(_0397_) );
  OAI21 _0921_ ( .A1(_0173_), .A2(_0249_), .B(_0394_), .Y(_0398_) );
  NAND2 _0922_ ( .A(_0173_), .B(_0309_), .Y(_0399_) );
  NAND4 _0923_ ( .A(_0395_), .B(_0397_), .C(_0398_), .D(_0399_), .Y(_0400_) );
  AOI21 _0925_ ( .A1(_0211_), .A2(_0229_), .B(_0228_), .Y(_0401_) );
  MUX2 _0926_ ( .A(buf_m_3), .B(sram_do[3]), .S(_0126_), .Y(_0402_) );
  MUX2 _0927_ ( .A(buf_h_3), .B(sram_do[3]), .S(pc_init_n), .Y(_0403_) );
  INV_X1 _0928_ ( .A(_0403_), .Y(_0404_) );
  AOI21 _0929_ ( .A1(fo_net_20_g0), .A2(_0404_), .B(_0130_), .Y(_0405_) );
  OAI21 _0930_ ( .A1(fo_net_20_g0), .A2(_0402_), .B(_0405_), .Y(_0406_) );
  MUX2 _0931_ ( .A(buf_l_3), .B(sram_do[3]), .S(_0126_), .Y(_0407_) );
  NAND2 _0932_ ( .A(_0134_), .B(_0407_), .Y(_0408_) );
  AOI21 _0933_ ( .A1(_0064_), .A2(_0096_), .B(_0069_), .Y(_0409_) );
  OAI21 _0934_ ( .A1(buf_l_3), .A2(_0096_), .B(_0409_), .Y(_0410_) );
  NAND3 _0935_ ( .A(_0406_), .B(_0408_), .C(_0410_), .Y(_0411_) );
  NAND3 _0936_ ( .A(_0057_), .B(_0071_), .C(fo_net_24_g0), .Y(_0412_) );
  OAI21 _0937_ ( .A1(_0071_), .A2(_0140_), .B(_0412_), .Y(_0413_) );
  OAI21 _0938_ ( .A1(fo_net_24_g0), .A2(_0148_), .B(_0144_), .Y(_0414_) );
  OAI22 _0939_ ( .A1(_0003_), .A2(_0144_), .B1(_0413_), .B2(_0414_), .Y(_0415_) );
  AOI21 _0940_ ( .A1(_0143_), .A2(_0415_), .B(_0151_), .Y(_0416_) );
  OAI21 _0941_ ( .A1(buf_l_3), .A2(_0143_), .B(_0416_), .Y(_0417_) );
  INV_X1 _0942_ ( .A(_0417_), .Y(_0418_) );
  NAND2 _0943_ ( .A(_0411_), .B(_0418_), .Y(_0419_) );
  NOR2 _0944_ ( .A(_0411_), .B(_0418_), .Y(_0420_) );
  XNOR2 _0945_ ( .A(_0411_), .B(_0417_), .Y(_0421_) );
  XNOR2 _0946_ ( .A(_0401_), .B(_0421_), .Y(_0422_) );
  AOI22 _0947_ ( .A1(buf_l_3), .A2(fo_net_17_g0), .B1(fo_net_22_g0), .B2(sram_do[3]), .Y(_0423_) );
  AOI21 _0948_ ( .A1(din3_in_th), .A2(_0102_), .B(_0125_), .Y(_0424_) );
  NAND2 _0949_ ( .A(_0423_), .B(_0424_), .Y(_0425_) );
  AOI21 _0950_ ( .A1(_0115_), .A2(_0422_), .B(_0425_), .Y(_0426_) );
  AOI21 _0951_ ( .A1(_0061_), .A2(_0125_), .B(_0426_), .Y(_0051_) );
  AND2_X1 _0954_ ( .A(_0101_), .B(_0299_), .Y(_0540_) );
  OAI21 _0955_ ( .A1(fo_net_18_g1), .A2(_0122_), .B(_0307_), .Y(_0427_) );
  NAND2 _0956_ ( .A(_0092_), .B(fo_net_28_g0), .Y(_0428_) );
  NOR3 _0957_ ( .A(_0546_), .B(_0004_), .C(_0428_), .Y(_0429_) );
  AOI21 _0958_ ( .A1(fo_net_9_g0), .A2(_0237_), .B(fo_net_23_g1), .Y(_0430_) );
  NOR2 _0959_ ( .A(_0312_), .B(_0430_), .Y(_0431_) );
  OAI21 _0960_ ( .A1(_0429_), .A2(_0431_), .B(_0308_), .Y(_0432_) );
  NOR2 _0961_ ( .A(fo_net_27_g1), .B(_0310_), .Y(_0433_) );
  OR2 _0962_ ( .A(fo_net_27_g1), .B(_0310_), .Y(_0434_) );
  NAND4 _0963_ ( .A(_0302_), .B(_0305_), .C(_0313_), .D(_0434_), .Y(_0435_) );
  AOI22 _0964_ ( .A1(_0015_), .A2(_0303_), .B1(_0427_), .B2(pc_init_n), .Y(_0436_) );
  NAND2 _0965_ ( .A(_0432_), .B(_0436_), .Y(_0437_) );
  OAI21 _0967_ ( .A1(acc_3), .A2(_0248_), .B(fo_net_28_g0), .Y(_0438_) );
  INV_X1 _0968_ ( .A(_0438_), .Y(_0439_) );
  OAI21 _0969_ ( .A1(_0309_), .A2(_0439_), .B(_0422_), .Y(_0440_) );
  NOR2 _0970_ ( .A(sram_do[3]), .B(fo_net_9_g0), .Y(_0441_) );
  OAI21 _0971_ ( .A1(buf_m_3), .A2(_0074_), .B(fo_net_18_g1), .Y(_0442_) );
  AOI22 _0972_ ( .A1(sram_do[3]), .A2(fo_net_23_g1), .B1(_0306_), .B2(din3_in_th), .Y(_0443_) );
  OAI21 _0973_ ( .A1(_0441_), .A2(_0442_), .B(_0443_), .Y(_0444_) );
  NOR2 _0974_ ( .A(_0248_), .B(_0438_), .Y(_0445_) );
  NOR3 _0975_ ( .A(_0318_), .B(_0444_), .C(_0445_), .Y(_0446_) );
  NAND2 _0976_ ( .A(fo_net_13_g0), .B(_0422_), .Y(_0447_) );
  AOI22 _0977_ ( .A1(_0075_), .A2(_0318_), .B1(_0440_), .B2(_0446_), .Y(_0048_) );
  AOI21 _0980_ ( .A1(_0101_), .A2(fo_net_20_g0), .B(phase_2), .Y(_0448_) );
  NAND2 _0981_ ( .A(_0122_), .B(_0448_), .Y(_0449_) );
  OAI21 _0982_ ( .A1(_0401_), .A2(_0420_), .B(_0419_), .Y(_0450_) );
  AND4_X1 _0984_ ( .A(_0015_), .B(_0085_), .C(_0247_), .D(_0303_), .Y(_0451_) );
  AOI21 _0985_ ( .A1(_0098_), .A2(_0303_), .B(_0451_), .Y(_0452_) );
  OAI21 _0986_ ( .A1(_0074_), .A2(fo_net_19_g2), .B(_0452_), .Y(_0044_) );
  AOI21 _0987_ ( .A1(_0166_), .A2(_0193_), .B(_0346_), .Y(_0453_) );
  AOI21 _0988_ ( .A1(_0166_), .A2(_0291_), .B(_0335_), .Y(_0454_) );
  AND4_X1 _0989_ ( .A(_0328_), .B(_0339_), .C(_0453_), .D(_0454_), .Y(_0455_) );
  NAND3 _0990_ ( .A(_0194_), .B(_0289_), .C(_0455_), .Y(_0456_) );
  NAND3 _0991_ ( .A(_0344_), .B(_0355_), .C(_0456_), .Y(_0457_) );
  NAND2 _0992_ ( .A(_0289_), .B(_0328_), .Y(_0458_) );
  OAI21 _0993_ ( .A1(_0455_), .A2(_0458_), .B(_0450_), .Y(_0459_) );
  NAND2 _0994_ ( .A(cy), .B(_0455_), .Y(_0460_) );
  NAND2 _0995_ ( .A(acc_3), .B(_0337_), .Y(_0461_) );
  NAND3 _0996_ ( .A(_0007_), .B(_0166_), .C(_0193_), .Y(_0462_) );
  AOI21 _0997_ ( .A1(acc_0), .A2(_0338_), .B(_0346_), .Y(_0463_) );
  NAND4 _0998_ ( .A(_0460_), .B(_0461_), .C(_0462_), .D(_0463_), .Y(_0464_) );
  AOI21 _0999_ ( .A1(_0289_), .A2(_0464_), .B(_0457_), .Y(_0465_) );
  AOI22 _1000_ ( .A1(_0062_), .A2(_0457_), .B1(_0459_), .B2(_0465_), .Y(_0043_) );
  OR2 _1001_ ( .A(_0102_), .B(_0306_), .Y(_0466_) );
  OAI21 _1002_ ( .A1(_0264_), .A2(_0466_), .B(_0122_), .Y(_0467_) );
  OAI21 _1003_ ( .A1(_0238_), .A2(_0256_), .B(_0120_), .Y(_0468_) );
  OAI21 _1004_ ( .A1(_0281_), .A2(_0314_), .B(_0266_), .Y(_0469_) );
  NAND2 _1005_ ( .A(_0468_), .B(_0469_), .Y(_0470_) );
  OAI21 _1006_ ( .A1(_0119_), .A2(_0257_), .B(fo_net_28_g0), .Y(_0471_) );
  NAND3 _1007_ ( .A(_0467_), .B(_0470_), .C(_0471_), .Y(sram_we) );
  AOI21 _1008_ ( .A1(_0065_), .A2(_0249_), .B(_0237_), .Y(_0472_) );
  MUX2 _1009_ ( .A(sram_do[1]), .B(buf_m_1), .S(fo_net_9_g0), .Y(_0473_) );
  NAND2 _1010_ ( .A(fo_net_17_g0), .B(_0473_), .Y(_0474_) );
  AOI22 _1011_ ( .A1(sram_do[1]), .A2(fo_net_22_g0), .B1(_0306_), .B2(din1_in_th), .Y(_0475_) );
  OAI21 _1012_ ( .A1(_0206_), .A2(_0249_), .B(_0472_), .Y(_0476_) );
  NAND2 _1013_ ( .A(fo_net_13_g0), .B(_0206_), .Y(_0477_) );
  NAND2 _1014_ ( .A(_0206_), .B(_0309_), .Y(_0478_) );
  NAND4 _1015_ ( .A(_0474_), .B(_0475_), .C(_0476_), .D(_0478_), .Y(_0479_) );
  NOR4 _1017_ ( .A(_0241_), .B(fo_net_26_g0), .C(_0245_), .D(_0448_), .Y(d_hiz) );
  INV_X1 _1018_ ( .A(d_hiz), .Y(d_oe) );
  AOI22 _1019_ ( .A1(buf_h_3), .A2(_0265_), .B1(_0267_), .B2(buf_m_3), .Y(_0480_) );
  OAI21 _1020_ ( .A1(_0075_), .A2(_0262_), .B(_0480_), .Y(sram_din[3]) );
  NOR2 _1021_ ( .A(acc_3), .B(_0357_), .Y(_0481_) );
  AOI21 _1022_ ( .A1(_0071_), .A2(_0349_), .B(_0139_), .Y(_0482_) );
  OAI21 _1023_ ( .A1(_0359_), .A2(_0482_), .B(_0422_), .Y(_0483_) );
  NAND2 _1024_ ( .A(_0349_), .B(_0482_), .Y(_0484_) );
  AOI22 _1025_ ( .A1(opa_3), .A2(_0351_), .B1(_0352_), .B2(buf_l_3), .Y(_0485_) );
  NAND3 _1026_ ( .A(_0357_), .B(_0484_), .C(_0485_), .Y(_0486_) );
  AOI22 _1027_ ( .A1(_0008_), .A2(_0336_), .B1(_0337_), .B2(fo_net_6_g1), .Y(_0487_) );
  AOI21 _1028_ ( .A1(cy), .A2(_0338_), .B(_0332_), .Y(_0488_) );
  NAND3 _1029_ ( .A(_0370_), .B(_0487_), .C(_0488_), .Y(_0489_) );
  AOI21 _1030_ ( .A1(_0354_), .A2(_0489_), .B(_0486_), .Y(_0490_) );
  AOI21 _1031_ ( .A1(_0483_), .A2(_0490_), .B(_0481_), .Y(_0042_) );
  AOI22 _1032_ ( .A1(sram_do[3]), .A2(_0245_), .B1(_0403_), .B2(fo_net_26_g0), .Y(_0491_) );
  MUX2 _1033_ ( .A(acc_3), .B(buf_l_3), .S(_0238_), .Y(_0492_) );
  AOI22 _1034_ ( .A1(_0117_), .A2(_0402_), .B1(_0492_), .B2(_0241_), .Y(_0493_) );
  NAND3 _1035_ ( .A(_0408_), .B(_0491_), .C(_0493_), .Y(d_out[3]) );
  AOI21 _1036_ ( .A1(phase_0), .A2(fo_net_18_g1), .B(_0429_), .Y(_0494_) );
  AOI21 _1037_ ( .A1(_0086_), .A2(_0091_), .B(fo_net_14_g1), .Y(_0495_) );
  NOR4 _1038_ ( .A(_0301_), .B(_0303_), .C(_0494_), .D(_0495_), .Y(_0496_) );
  XNOR2 _1039_ ( .A(sp_0), .B(fo_net_18_g1), .Y(_0497_) );
  NAND2 _1040_ ( .A(_0496_), .B(_0497_), .Y(_0498_) );
  XNOR2 _1041_ ( .A(sp_1), .B(_0498_), .Y(_0041_) );
  MUX2 _1042_ ( .A(fo_net_17_g0), .B(_0122_), .S(fo_net_26_g0), .Y(_0499_) );
  OAI21 _1043_ ( .A1(_0074_), .A2(_0094_), .B(fo_net_18_g1), .Y(_0500_) );
  NAND2 _1044_ ( .A(_0499_), .B(_0500_), .Y(_0501_) );
  AOI21 _1045_ ( .A1(opa_3), .A2(fo_net_17_g0), .B(_0501_), .Y(_0502_) );
  AOI22 _1046_ ( .A1(_0080_), .A2(_0501_), .B1(_0502_), .B2(_0447_), .Y(_0040_) );
  NAND3 _1047_ ( .A(_0282_), .B(_0499_), .C(_0500_), .Y(_0503_) );
  AOI21 _1048_ ( .A1(fo_net_13_g0), .A2(_0173_), .B(_0503_), .Y(_0504_) );
  AOI21 _1049_ ( .A1(_0078_), .A2(_0501_), .B(_0504_), .Y(_0039_) );
  AOI21 _1050_ ( .A1(opa_1), .A2(fo_net_17_g0), .B(_0501_), .Y(_0505_) );
  AOI22 _1051_ ( .A1(_0077_), .A2(_0501_), .B1(_0505_), .B2(_0477_), .Y(_0038_) );
  AOI21 _1054_ ( .A1(fo_net_1_g0), .A2(fo_net_18_g1), .B(_0501_), .Y(_0506_) );
  AOI22 _1055_ ( .A1(_0076_), .A2(_0501_), .B1(_0506_), .B2(_0327_), .Y(_0037_) );
  OR2 _1056_ ( .A(_0005_), .B(_0390_), .Y(cm_ram[3]) );
  NAND3 _1057_ ( .A(fo_net_11_g0), .B(fo_net_25_g1), .C(fo_net_29_g1), .Y(_0507_) );
  AOI21 _1058_ ( .A1(_0168_), .A2(_0453_), .B(_0507_), .Y(_0508_) );
  NOR2 _1059_ ( .A(fo_net_27_g1), .B(_0508_), .Y(cm_rom) );
  AOI21 _1061_ ( .A1(pc_init_n), .A2(_0433_), .B(_0466_), .Y(_0509_) );
  AOI22 _1062_ ( .A1(_0121_), .A2(_0258_), .B1(_0509_), .B2(_0108_), .Y(_0510_) );
  OAI21 _1063_ ( .A1(_0238_), .A2(_0256_), .B(fo_net_19_g2), .Y(_0511_) );
  AOI21 _1064_ ( .A1(pc_init_n), .A2(fo_net_27_g1), .B(_0469_), .Y(_0512_) );
  NAND3 _1065_ ( .A(_0471_), .B(_0511_), .C(_0512_), .Y(_0513_) );
  NOR2 _1066_ ( .A(_0510_), .B(_0513_), .Y(_0514_) );
  NOR3 _1067_ ( .A(rst_in_th), .B(clk_buf_r10), .C(_0514_), .Y(sram_ce) );
  AOI21 _1069_ ( .A1(_0073_), .A2(_0349_), .B(_0139_), .Y(_0515_) );
  OAI21 _1070_ ( .A1(_0359_), .A2(_0515_), .B(_0173_), .Y(_0516_) );
  OAI21 _1071_ ( .A1(_0364_), .A2(_0366_), .B(_0341_), .Y(_0517_) );
  OAI21 _1072_ ( .A1(_0331_), .A2(_0337_), .B(cy), .Y(_0518_) );
  NAND2 _1073_ ( .A(fo_net_8_g1), .B(_0338_), .Y(_0519_) );
  AOI22 _1074_ ( .A1(_0007_), .A2(_0332_), .B1(_0336_), .B2(_0545_), .Y(_0520_) );
  AND4_X1 _1075_ ( .A(_0370_), .B(_0518_), .C(_0519_), .D(_0520_), .Y(_0521_) );
  AOI21 _1076_ ( .A1(_0517_), .A2(_0521_), .B(_0353_), .Y(_0522_) );
  NAND2 _1077_ ( .A(_0349_), .B(_0515_), .Y(_0523_) );
  AOI22 _1078_ ( .A1(fo_net_3_g0), .A2(_0351_), .B1(_0352_), .B2(buf_l_0), .Y(_0524_) );
  NAND3 _1079_ ( .A(_0357_), .B(_0523_), .C(_0524_), .Y(_0525_) );
  NOR2 _1080_ ( .A(_0522_), .B(_0525_), .Y(_0526_) );
  NOR2 _1081_ ( .A(acc_0), .B(_0357_), .Y(_0527_) );
  AOI21 _1082_ ( .A1(_0516_), .A2(_0526_), .B(_0527_), .Y(_0035_) );
  MUXDFFRB _1083_ ( .CK(clk_buf_r5), .Q(pc_cout), .QB(_0530_), .RSTB(rst_n_buf_r5), .A(_0450_), .B(pc_cout), .S(_0449_) );
  DFFRB _1084_ ( .CK(clk_buf_r8), .D(_0039_), .Q(buf_h_0), .QB(_0533_), .RSTB(rst_n_buf_r8) );
  DFFRB _1085_ ( .CK(clk_buf_r8), .D(_0038_), .Q(buf_h_1), .QB(_0534_), .RSTB(rst_n_buf_r8) );
  DFFRB _1086_ ( .CK(clk_buf_r10), .D(_0037_), .Q(buf_h_2), .QB(_0535_), .RSTB(rst_n_buf_r10) );
  DFFRB _1087_ ( .CK(clk_buf_r8), .D(_0040_), .Q(buf_h_3), .QB(_0532_), .RSTB(rst_n_buf_r8) );
  MUXDFFRB _1088_ ( .CK(clk_buf_r10), .Q(sp_0), .QB(_0542_), .RSTB(rst_n_buf_r10), .A(sp_0), .B(_0542_), .S(_0496_) );
  DFFRB _1089_ ( .CK(clk_buf_r10), .D(_0041_), .Q(sp_1), .QB(_0531_), .RSTB(rst_n_buf_r10) );
  DFFRB _1090_ ( .CK(clk_buf_r1), .D(_0035_), .Q(acc_0), .QB(_0545_), .RSTB(rst_n_buf_r1) );
  MUXDFFRB _1091_ ( .CK(clk_buf_r2), .Q(acc_1), .QB(_0543_), .RSTB(rst_n_buf_r2), .A(fo_net_7_g0), .B(_0387_), .S(_0357_) );
  MUXDFFRB _1092_ ( .CK(clk_buf_r2), .Q(acc_2), .QB(_0544_), .RSTB(rst_n_buf_r2), .A(fo_net_5_g0), .B(_0377_), .S(_0357_) );
  DFFRB _1093_ ( .CK(clk_buf_r1), .D(_0042_), .Q(acc_3), .QB(_0008_), .RSTB(rst_n_buf_r1) );
  DFFRB _1094_ ( .CK(clk_buf_r1), .D(_0043_), .Q(cy), .QB(_0007_), .RSTB(rst_n_buf_r1) );
  DFFRB _1095_ ( .CK(clk_buf_r6), .D(_0044_), .Q(two_cycle), .QB(_0006_), .RSTB(rst_n_buf_r6) );
  MUXDFFRB _1096_ ( .CK(clk_buf_r3), .Q(bank_sel_1), .QB(_0009_), .RSTB(rst_n_buf_r3), .A(acc_0), .B(bank_sel_1), .S(_0294_) );
  MUXDFFRB _1097_ ( .CK(clk_buf_r2), .Q(bank_sel_2), .QB(_0010_), .RSTB(rst_n_buf_r2), .A(fo_net_8_g1), .B(bank_sel_2), .S(_0294_) );
  MUXDFFRB _1098_ ( .CK(clk_buf_r3), .Q(bank_sel_3), .QB(_0005_), .RSTB(rst_n_buf_r3), .A(fo_net_6_g1), .B(bank_sel_3), .S(_0294_) );
  MUXDFFRB _1099_ ( .CK(clk_buf_r3), .Q(opr_0), .QB(_0547_), .RSTB(rst_n_buf_r3), .A(din0_in_th), .B(opr_0), .S(_0391_) );
  MUXDFFRB _1100_ ( .CK(clk_buf_r3), .Q(opr_1), .QB(_0011_), .RSTB(rst_n_buf_r3), .A(din1_in_th), .B(opr_1), .S(_0391_) );
  MUXDFFRB _1101_ ( .CK(clk_buf_r4), .Q(opr_2), .QB(_0546_), .RSTB(rst_n_buf_r4), .A(din2_in_th), .B(opr_2), .S(_0391_) );
  MUXDFFRB _1102_ ( .CK(clk_buf_r5), .Q(opr_3), .QB(_0004_), .RSTB(rst_n_buf_r5), .A(din3_in_th), .B(opr_3), .S(_0391_) );
  MUXDFFRB _1103_ ( .CK(clk_buf_r4), .Q(buf_l_0), .QB(_0012_), .RSTB(rst_n_buf_r4), .A(_0400_), .B(buf_l_0), .S(_0318_) );
  MUXDFFRB _1104_ ( .CK(clk_buf_r4), .Q(buf_l_1), .QB(_0013_), .RSTB(rst_n_buf_r4), .A(_0479_), .B(buf_l_1), .S(_0318_) );
  MUXDFFRB _1105_ ( .CK(clk_buf_r5), .Q(buf_l_2), .QB(_0014_), .RSTB(rst_n_buf_r5), .A(_0326_), .B(buf_l_2), .S(_0318_) );
  DFFRB _1106_ ( .CK(clk_buf_r5), .D(_0048_), .Q(buf_l_3), .QB(_0003_), .RSTB(rst_n_buf_r5) );
  MUXDFFRB _1107_ ( .CK(clk_buf_r7), .Q(pc_init_n), .QB(_0002_), .RSTB(rst_n_buf_r7), .A(_0437_), .B(pc_init_n), .S(_0435_) );
  MUXDFFRB _1108_ ( .CK(clk_buf_r6), .Q(opa_0), .QB(_0015_), .RSTB(rst_n_buf_r6), .A(din0_in_th), .B(fo_net_3_g0), .S(_0300_) );
  MUXDFFRB _1109_ ( .CK(clk_buf_r6), .Q(opa_1), .QB(_0016_), .RSTB(rst_n_buf_r6), .A(din1_in_th), .B(opa_1), .S(_0300_) );
  MUXDFFRB _1110_ ( .CK(clk_buf_r2), .Q(opa_2), .QB(_0017_), .RSTB(rst_n_buf_r2), .A(din2_in_th), .B(fo_net_1_g0), .S(_0300_) );
  MUXDFFRB _1111_ ( .CK(clk_buf_r4), .Q(opa_3), .QB(_0001_), .RSTB(rst_n_buf_r4), .A(din3_in_th), .B(opa_3), .S(_0300_) );
  MUXDFFRB _1112_ ( .CK(clk_buf_r7), .Q(buf_m_0), .QB(_0536_), .RSTB(rst_n_buf_r7), .A(_0177_), .B(buf_m_0), .S(_0125_) );
  MUXDFFRB _1113_ ( .CK(clk_buf_r7), .Q(buf_m_1), .QB(_0537_), .RSTB(rst_n_buf_r7), .A(_0210_), .B(buf_m_1), .S(_0125_) );
  DFFRB _1114_ ( .CK(clk_buf_r8), .D(_0019_), .Q(buf_m_2), .QB(_0538_), .RSTB(rst_n_buf_r8) );
  DFFRB _1115_ ( .CK(clk_buf_r7), .D(_0051_), .Q(buf_m_3), .QB(_0529_), .RSTB(rst_n_buf_r7) );
  MUXDFFRB _1116_ ( .CK(clk_buf_r6), .Q(isz_taken), .QB(_0528_), .RSTB(rst_n_buf_r6), .A(isz_taken), .B(_0393_), .S(_0392_) );
  DFFRB _1117_ ( .CK(clk_buf_r9), .D(_0539_), .Q(phase_0), .QB(_0539_), .RSTB(rst_n_buf_r9) );
  DFFRB _1118_ ( .CK(clk_buf_r9), .D(_0540_), .Q(phase_1), .QB(_0018_), .RSTB(rst_n_buf_r9) );
  DFFRB _1119_ ( .CK(clk_buf_r9), .D(_0541_), .Q(phase_2), .QB(_0000_), .RSTB(rst_n_buf_r9) );
  SRAM128 u_sram ( .A0(sram_addr_0), .A1(sram_addr_1), .A2(sram_addr_2), .A3(sram_addr_3), .A4(sram_addr_4), .CE(sram_ce), .DIN(sram_din), .DO(sram_do), .WR(sram_we) );
  BUFTH u_bufth_clk ( .A(clk), .Y(clk_in_th) );
  BUFTH u_bufth_rst ( .A(rst), .Y(rst_in_th) );
  BUFTH u_bufth_test ( .A(test), .Y(test_in_th) );
  BUFTH u_bufth_din0 ( .A(d_in[0]), .Y(din0_in_th) );
  BUFTH u_bufth_din1 ( .A(d_in[1]), .Y(din1_in_th) );
  BUFTH u_bufth_din2 ( .A(d_in[2]), .Y(din2_in_th) );
  BUFTH u_bufth_din3 ( .A(d_in[3]), .Y(din3_in_th) );
  BUF_X2 u_clk_buf_r1 ( .A(clk_in_th), .Y(clk_buf_r1) );
  BUF_X2 u_rst_buf_r1 ( .A(rst_n), .Y(rst_n_buf_r1) );
  BUF_X2 u_clk_buf_r2 ( .A(clk_in_th), .Y(clk_buf_r2) );
  BUF_X2 u_rst_buf_r2 ( .A(rst_n), .Y(rst_n_buf_r2) );
  BUF_X2 u_clk_buf_r3 ( .A(clk_in_th), .Y(clk_buf_r3) );
  BUF_X2 u_rst_buf_r3 ( .A(rst_n), .Y(rst_n_buf_r3) );
  BUF_X2 u_clk_buf_r4 ( .A(clk_in_th), .Y(clk_buf_r4) );
  BUF_X2 u_rst_buf_r4 ( .A(rst_n), .Y(rst_n_buf_r4) );
  BUF_X2 u_clk_buf_r5 ( .A(clk_in_th), .Y(clk_buf_r5) );
  BUF_X2 u_rst_buf_r5 ( .A(rst_n), .Y(rst_n_buf_r5) );
  BUF_X2 u_clk_buf_r6 ( .A(clk_in_th), .Y(clk_buf_r6) );
  BUF_X2 u_rst_buf_r6 ( .A(rst_n), .Y(rst_n_buf_r6) );
  BUF_X2 u_clk_buf_r7 ( .A(clk_in_th), .Y(clk_buf_r7) );
  BUF_X2 u_rst_buf_r7 ( .A(rst_n), .Y(rst_n_buf_r7) );
  BUF_X2 u_clk_buf_r8 ( .A(clk_in_th), .Y(clk_buf_r8) );
  BUF_X2 u_rst_buf_r8 ( .A(rst_n), .Y(rst_n_buf_r8) );
  BUF_X2 u_clk_buf_r9 ( .A(clk_in_th), .Y(clk_buf_r9) );
  BUF_X2 u_rst_buf_r9 ( .A(rst_n), .Y(rst_n_buf_r9) );
  BUF_X2 u_clk_buf_r10 ( .A(clk_in_th), .Y(clk_buf_r10) );
  BUF_X2 u_rst_buf_r10 ( .A(rst_n), .Y(rst_n_buf_r10) );
  BUF_X2 u_fobuf_1_g0 ( .A(opa_2), .Y(fo_net_1_g0) );
  BUF_X2 u_fobuf_2_g1 ( .A(opa_2), .Y(fo_net_2_g1) );
  BUF_X2 u_fobuf_3_g0 ( .A(opa_0), .Y(fo_net_3_g0) );
  BUF_X2 u_fobuf_4_g1 ( .A(opa_0), .Y(fo_net_4_g1) );
  BUF_X2 u_fobuf_5_g0 ( .A(acc_2), .Y(fo_net_5_g0) );
  BUF_X2 u_fobuf_6_g1 ( .A(acc_2), .Y(fo_net_6_g1) );
  BUF_X2 u_fobuf_7_g0 ( .A(acc_1), .Y(fo_net_7_g0) );
  BUF_X2 u_fobuf_8_g1 ( .A(acc_1), .Y(fo_net_8_g1) );
  BUF_X2 u_fobuf_9_g0 ( .A(two_cycle), .Y(fo_net_9_g0) );
  BUF_X2 u_fobuf_10_g1 ( .A(two_cycle), .Y(fo_net_10_g1) );
  BUF_X2 u_fobuf_11_g0 ( .A(_0006_), .Y(fo_net_11_g0) );
  BUF_X2 u_fobuf_12_g1 ( .A(_0006_), .Y(fo_net_12_g1) );
  BUF_X2 u_fobuf_13_g0 ( .A(_0084_), .Y(fo_net_13_g0) );
  BUF_X2 u_fobuf_14_g1 ( .A(_0084_), .Y(fo_net_14_g1) );
  BUF_X2 u_fobuf_15_g0 ( .A(_0011_), .Y(fo_net_15_g0) );
  BUF_X2 u_fobuf_16_g1 ( .A(_0011_), .Y(fo_net_16_g1) );
  BUF_X2 u_fobuf_17_g0 ( .A(sync), .Y(fo_net_17_g0) );
  BUF_X2 u_fobuf_18_g1 ( .A(sync), .Y(fo_net_18_g1) );
  BUF_X2 u_fobuf_19_g2 ( .A(sync), .Y(fo_net_19_g2) );
  BUF_X2 u_fobuf_20_g0 ( .A(_0106_), .Y(fo_net_20_g0) );
  BUF_X2 u_fobuf_21_g1 ( .A(_0106_), .Y(fo_net_21_g1) );
  BUF_X2 u_fobuf_22_g0 ( .A(_0107_), .Y(fo_net_22_g0) );
  BUF_X2 u_fobuf_23_g1 ( .A(_0107_), .Y(fo_net_23_g1) );
  BUF_X2 u_fobuf_24_g0 ( .A(_0138_), .Y(fo_net_24_g0) );
  BUF_X2 u_fobuf_25_g1 ( .A(_0138_), .Y(fo_net_25_g1) );
  BUF_X2 u_fobuf_26_g0 ( .A(_0244_), .Y(fo_net_26_g0) );
  BUF_X2 u_fobuf_27_g1 ( .A(_0244_), .Y(fo_net_27_g1) );
  BUF_X2 u_fobuf_28_g0 ( .A(_0236_), .Y(fo_net_28_g0) );
  BUF_X2 u_fobuf_29_g1 ( .A(_0236_), .Y(fo_net_29_g1) );
endmodule
