jun1okamura/TR-1um_C4004_Clone2Build/TR-1um_C4004_04/openroad/c4004_core_syn.v

// Synthesized and Buffered Gate-Level Netlist for c4004_core (Trial 02: 10 Rows)
module c4004_core (
  clk,
  rst,
  test,
  d_in,
  d_out,
  d_oe,
  d_hiz,
  sync,
  cm_rom,
  cm_ram
);
  input clk;
  input rst;
  input test;
  input [3:0] d_in;
  output [3:0] d_out;
  output d_oe;
  output d_hiz;
  output sync;
  output cm_rom;
  output [3:0] cm_ram;

  wire [3:0] sram_din;
  wire [3:0] sram_do;
  wire _0000_;
  wire _0001_;
  wire _0002_;
  wire _0003_;
  wire _0004_;
  wire _0005_;
  wire _0006_;
  wire _0007_;
  wire _0008_;
  wire _0009_;
  wire _0010_;
  wire _0011_;
  wire _0012_;
  wire _0013_;
  wire _0014_;
  wire _0015_;
  wire _0016_;
  wire _0017_;
  wire _0018_;
  wire _0022_;
  wire _0023_;
  wire _0039_;
  wire _0040_;
  wire _0043_;
  wire _0044_;
  wire _0045_;
  wire _0048_;
  wire _0051_;
  wire _0053_;
  wire _0054_;
  wire _0055_;
  wire _0056_;
  wire _0057_;
  wire _0058_;
  wire _0059_;
  wire _0060_;
  wire _0061_;
  wire _0062_;
  wire _0063_;
  wire _0064_;
  wire _0065_;
  wire _0066_;
  wire _0067_;
  wire _0068_;
  wire _0069_;
  wire _0070_;
  wire _0071_;
  wire _0072_;
  wire _0073_;
  wire _0074_;
  wire _0075_;
  wire _0076_;
  wire _0077_;
  wire _0078_;
  wire _0079_;
  wire _0080_;
  wire _0081_;
  wire _0082_;
  wire _0083_;
  wire _0084_;
  wire _0085_;
  wire _0086_;
  wire _0087_;
  wire _0088_;
  wire _0089_;
  wire _0090_;
  wire _0091_;
  wire _0092_;
  wire _0093_;
  wire _0094_;
  wire _0095_;
  wire _0096_;
  wire _0097_;
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
  wire buf_l_2;
  wire buf_l_3;
  wire buf_m_0;
  wire buf_m_1;
  wire buf_m_2;
  wire buf_m_3;
  wire clk_buf_r1;
  wire clk_buf_r10;
  wire clk_buf_r2;
  wire clk_buf_r3;
  wire clk_buf_r4;
  wire clk_buf_r5;
  wire clk_buf_r6;
  wire clk_buf_r7;
  wire clk_buf_r8;
  wire clk_buf_r9;
  wire clk_in_th;
  wire cy;
  wire din0_in_th;
  wire din1_in_th;
  wire din2_in_th;
  wire din3_in_th;
  wire fo_net_10_g1;
  wire fo_net_11_g0;
  wire fo_net_12_g1;
  wire fo_net_13_g0;
  wire fo_net_14_g1;
  wire fo_net_15_g0;
  wire fo_net_16_g1;
  wire fo_net_17_g0;
  wire fo_net_18_g1;
  wire fo_net_19_g0;
  wire fo_net_1_g0;
  wire fo_net_20_g1;
  wire fo_net_21_g0;
  wire fo_net_22_g1;
  wire fo_net_23_g2;
  wire fo_net_24_g0;
  wire fo_net_25_g1;
  wire fo_net_2_g1;
  wire fo_net_3_g0;
  wire fo_net_4_g1;
  wire fo_net_5_g0;
  wire fo_net_6_g1;
  wire fo_net_7_g0;
  wire fo_net_8_g1;
  wire fo_net_9_g0;
  wire isz_taken;
  wire opa_0;
  wire opa_1;
  wire opa_2;
  wire opa_3;
  wire opr_0;
  wire opr_1;
  wire opr_2;
  wire opr_3;
  wire pc_cout;
  wire pc_init_n;
  wire phase_0;
  wire phase_1;
  wire phase_2;
  wire reg_buf_0;
  wire reg_buf_1;
  wire reg_buf_2;
  wire reg_buf_3;
  wire rst_in_th;
  wire rst_n;
  wire rst_n_buf_r1;
  wire rst_n_buf_r10;
  wire rst_n_buf_r2;
  wire rst_n_buf_r3;
  wire rst_n_buf_r4;
  wire rst_n_buf_r5;
  wire rst_n_buf_r6;
  wire rst_n_buf_r7;
  wire rst_n_buf_r8;
  wire rst_n_buf_r9;
  wire sp_0;
  wire sp_1;
  wire sram_addr_0;
  wire sram_addr_1;
  wire sram_addr_2;
  wire sram_addr_3;
  wire sram_addr_4;
  wire sram_ce;
  wire sram_we;
  wire test_in_th;
  wire two_cycle;
  INV_X1 _0564_ ( .A(acc_0), .Y(_0057_) );
  INV_X1 _0565_ ( .A(acc_1), .Y(_0058_) );
  INV_X1 _0566_ ( .A(acc_2), .Y(_0059_) );
  INV_X1 _0567_ ( .A(reg_buf_0), .Y(_0060_) );
  INV_X1 _0568_ ( .A(reg_buf_2), .Y(_0061_) );
  INV_X1 _0569_ ( .A(phase_2), .Y(_0062_) );
  INV_X1 _0570_ ( .A(fo_net_2_g1), .Y(_0063_) );
  INV_X1 _0571_ ( .A(fo_net_3_g0), .Y(_0064_) );
  INV_X1 _0572_ ( .A(reg_buf_3), .Y(_0065_) );
  INV_X1 _0573_ ( .A(fo_net_5_g0), .Y(_0066_) );
  INV_X1 _0574_ ( .A(din0_in_th), .Y(_0067_) );
  INV_X1 _0575_ ( .A(opr_3), .Y(_0068_) );
  INV_X1 _0576_ ( .A(_0004_), .Y(_0069_) );
  INV_X1 _0577_ ( .A(acc_3), .Y(_0070_) );
  INV_X1 _0578_ ( .A(din1_in_th), .Y(_0071_) );
  INV_X1 _0579_ ( .A(din3_in_th), .Y(_0072_) );
  INV_X1 _0580_ ( .A(din2_in_th), .Y(_0073_) );
  INV_X1 _0581_ ( .A(buf_h_2), .Y(_0074_) );
  INV_X1 _0582_ ( .A(pc_init_n), .Y(_0075_) );
  INV_X1 _0583_ ( .A(buf_h_1), .Y(_0076_) );
  INV_X1 _0584_ ( .A(rst_in_th), .Y(rst_n) );
  INV_X1 _0585_ ( .A(buf_m_3), .Y(_0077_) );
  INV_X1 _0586_ ( .A(buf_h_3), .Y(_0078_) );
  INV_X1 _0587_ ( .A(test_in_th), .Y(_0079_) );
  OR2 _0588_ ( .A(opa_3), .B(_0015_), .Y(_0080_) );
  OR2 _0589_ ( .A(fo_net_4_g1), .B(_0013_), .Y(_0081_) );
  NOR2 _0590_ ( .A(_0080_), .B(_0081_), .Y(_0082_) );
  NOR2 _0591_ ( .A(_0013_), .B(_0014_), .Y(_0083_) );
  INV_X1 _0592_ ( .A(_0083_), .Y(_0084_) );
  AOI21 _0593_ ( .A1(_0081_), .A2(_0084_), .B(_0080_), .Y(_0085_) );
  NOR3 _0594_ ( .A(fo_net_2_g1), .B(_0004_), .C(_0081_), .Y(_0086_) );
  NOR2 _0595_ ( .A(fo_net_6_g1), .B(_0014_), .Y(_0087_) );
  NOR3 _0596_ ( .A(fo_net_6_g1), .B(_0014_), .C(_0080_), .Y(_0088_) );
  NOR2 _0597_ ( .A(fo_net_2_g1), .B(opa_3), .Y(_0089_) );
  NOR4 _0598_ ( .A(fo_net_1_g0), .B(fo_net_3_g0), .C(opa_3), .D(fo_net_6_g1), .Y(_0090_) );
  AND2_X1 _0599_ ( .A(_0087_), .B(_0089_), .Y(_0091_) );
  NOR4 _0600_ ( .A(fo_net_2_g1), .B(_0004_), .C(_0013_), .D(_0014_), .Y(_0092_) );
  INV_X1 _0601_ ( .A(_0092_), .Y(_0093_) );
  NOR4 _0602_ ( .A(fo_net_1_g0), .B(fo_net_3_g0), .C(fo_net_5_g0), .D(_0004_), .Y(_0094_) );
  NOR2 _0603_ ( .A(_0091_), .B(_0094_), .Y(_0095_) );
  NOR3 _0604_ ( .A(_0091_), .B(_0092_), .C(_0094_), .Y(_0096_) );
  NOR3 _0605_ ( .A(fo_net_4_g1), .B(fo_net_6_g1), .C(_0080_), .Y(_0097_) );
  NOR3 _0606_ ( .A(_0085_), .B(_0086_), .C(_0088_), .Y(_0098_) );
  NOR2 _0607_ ( .A(_0090_), .B(_0097_), .Y(_0099_) );
  AND3_X1 _0608_ ( .A(_0096_), .B(_0098_), .C(_0099_), .Y(_0100_) );
  NOR2 _0609_ ( .A(_0015_), .B(_0004_), .Y(_0101_) );
  NOR4 _0610_ ( .A(fo_net_4_g1), .B(fo_net_6_g1), .C(_0015_), .D(_0004_), .Y(_0102_) );
  NOR2 _0611_ ( .A(_0562_), .B(_0006_), .Y(_0103_) );
  NOR2 _0612_ ( .A(_0010_), .B(_0563_), .Y(_0104_) );
  INV_X1 _0613_ ( .A(_0104_), .Y(_0105_) );
  AND2_X1 _0614_ ( .A(_0103_), .B(_0104_), .Y(_0106_) );
  NAND2 _0615_ ( .A(_0103_), .B(_0104_), .Y(_0107_) );
  NOR2 _0616_ ( .A(_0102_), .B(_0107_), .Y(_0108_) );
  OR2 _0617_ ( .A(opr_2), .B(_0006_), .Y(_0109_) );
  NOR3 _0618_ ( .A(opr_0), .B(opr_1), .C(_0109_), .Y(_0110_) );
  OR3 _0619_ ( .A(opr_0), .B(opr_1), .C(_0109_), .Y(_0111_) );
  NOR2 _0620_ ( .A(opr_0), .B(_0010_), .Y(_0112_) );
  AND2_X1 _0621_ ( .A(_0103_), .B(_0112_), .Y(_0113_) );
  OR4 _0622_ ( .A(opr_0), .B(_0010_), .C(_0562_), .D(_0006_), .Y(_0114_) );
  NOR2 _0623_ ( .A(_0563_), .B(opr_1), .Y(_0115_) );
  NOR3 _0624_ ( .A(_0563_), .B(opr_1), .C(_0109_), .Y(_0116_) );
  AOI21 _0625_ ( .A1(opr_0), .A2(_0563_), .B(opr_1), .Y(_0117_) );
  NOR2 _0626_ ( .A(_0110_), .B(fo_net_8_g1), .Y(_0118_) );
  NOR3 _0627_ ( .A(_0110_), .B(_0113_), .C(fo_net_8_g1), .Y(_0119_) );
  AOI21 _0628_ ( .A1(opr_0), .A2(_0563_), .B(_0010_), .Y(_0120_) );
  INV_X1 _0629_ ( .A(_0120_), .Y(_0121_) );
  NOR2 _0630_ ( .A(_0109_), .B(_0121_), .Y(_0122_) );
  AND2_X1 _0631_ ( .A(_0103_), .B(_0117_), .Y(_0123_) );
  NOR2 _0632_ ( .A(_0122_), .B(_0123_), .Y(_0124_) );
  NAND2 _0633_ ( .A(_0119_), .B(_0124_), .Y(_0125_) );
  INV_X1 _0634_ ( .A(_0125_), .Y(_0126_) );
  OAI21 _0635_ ( .A1(_0083_), .A2(_0087_), .B(_0101_), .Y(_0127_) );
  NOR2 _0636_ ( .A(_0086_), .B(_0102_), .Y(_0128_) );
  NAND3 _0637_ ( .A(_0063_), .B(_0069_), .C(_0087_), .Y(_0129_) );
  OR3 _0638_ ( .A(_0015_), .B(_0004_), .C(_0081_), .Y(_0130_) );
  NAND4 _0639_ ( .A(_0127_), .B(_0128_), .C(_0129_), .D(_0130_), .Y(_0131_) );
  OR3 _0640_ ( .A(_0092_), .B(_0094_), .C(fo_net_10_g1), .Y(_0132_) );
  NOR2 _0641_ ( .A(_0131_), .B(_0132_), .Y(_0133_) );
  NOR3 _0642_ ( .A(phase_0), .B(_0008_), .C(_0009_), .Y(_0134_) );
  OR3 _0643_ ( .A(phase_0), .B(_0008_), .C(_0009_), .Y(_0135_) );
  NAND2 _0644_ ( .A(fo_net_11_g0), .B(_0134_), .Y(_0136_) );
  NOR2 _0645_ ( .A(_0133_), .B(_0136_), .Y(_0137_) );
  OAI21 _0646_ ( .A1(_0106_), .A2(_0125_), .B(_0137_), .Y(_0138_) );
  AOI21 _0647_ ( .A1(_0100_), .A2(_0108_), .B(_0138_), .Y(_0139_) );
  OR2 _0648_ ( .A(phase_1), .B(_0555_), .Y(_0140_) );
  NOR2 _0649_ ( .A(opr_3), .B(opr_2), .Y(_0141_) );
  NAND2 _0650_ ( .A(fo_net_14_g1), .B(_0141_), .Y(_0142_) );
  NOR2 _0651_ ( .A(_0010_), .B(_0142_), .Y(_0143_) );
  OR2 _0652_ ( .A(_0010_), .B(_0142_), .Y(_0144_) );
  NOR4 _0653_ ( .A(_0010_), .B(_0563_), .C(opr_3), .D(opr_2), .Y(_0145_) );
  NOR2 _0654_ ( .A(_0105_), .B(_0142_), .Y(_0146_) );
  NAND2 _0655_ ( .A(fo_net_13_g0), .B(_0145_), .Y(_0147_) );
  AOI21 _0656_ ( .A1(fo_net_13_g0), .A2(_0145_), .B(_0007_), .Y(_0148_) );
  MUX2 _0657_ ( .A(buf_m_0), .B(sram_do[0]), .S(_0148_), .Y(_0149_) );
  MUX2 _0658_ ( .A(buf_h_0), .B(sram_do[0]), .S(pc_init_n), .Y(_0150_) );
  INV_X1 _0659_ ( .A(_0150_), .Y(_0151_) );
  OAI21 _0660_ ( .A1(phase_0), .A2(phase_1), .B(_0062_), .Y(_0152_) );
  AOI21 _0661_ ( .A1(_0140_), .A2(_0151_), .B(_0152_), .Y(_0153_) );
  OAI21 _0662_ ( .A1(_0140_), .A2(_0149_), .B(_0153_), .Y(_0154_) );
  MUX2 _0663_ ( .A(buf_l_0), .B(sram_do[0]), .S(_0148_), .Y(_0155_) );
  NOR3 _0664_ ( .A(phase_2), .B(phase_0), .C(phase_1), .Y(_0156_) );
  NAND2 _0665_ ( .A(_0155_), .B(_0156_), .Y(_0157_) );
  NOR2 _0666_ ( .A(opr_3), .B(_0562_), .Y(_0158_) );
  NOR3 _0667_ ( .A(_0010_), .B(opr_3), .C(_0562_), .Y(_0159_) );
  OR3 _0668_ ( .A(_0010_), .B(opr_3), .C(_0562_), .Y(_0160_) );
  AOI21 _0669_ ( .A1(_0060_), .A2(_0159_), .B(_0062_), .Y(_0161_) );
  OAI21 _0670_ ( .A1(acc_0), .A2(_0159_), .B(_0161_), .Y(_0162_) );
  NAND3 _0671_ ( .A(_0154_), .B(_0157_), .C(_0162_), .Y(_0163_) );
  NOR2 _0672_ ( .A(fo_net_5_g0), .B(fo_net_9_g0), .Y(_0164_) );
  NOR3 _0673_ ( .A(fo_net_5_g0), .B(din0_in_th), .C(fo_net_9_g0), .Y(_0165_) );
  NOR2 _0674_ ( .A(_0066_), .B(fo_net_9_g0), .Y(_0166_) );
  NAND2 _0675_ ( .A(fo_net_5_g0), .B(_0113_), .Y(_0167_) );
  NOR3 _0676_ ( .A(_0066_), .B(_0067_), .C(fo_net_9_g0), .Y(_0168_) );
  AND2_X1 _0677_ ( .A(_0094_), .B(fo_net_9_g0), .Y(_0169_) );
  NOR3 _0678_ ( .A(_0165_), .B(_0168_), .C(_0169_), .Y(_0170_) );
  AOI21 _0679_ ( .A1(_0016_), .A2(fo_net_8_g1), .B(_0110_), .Y(_0171_) );
  OAI21 _0680_ ( .A1(fo_net_8_g1), .A2(_0170_), .B(_0171_), .Y(_0172_) );
  OR2 _0681_ ( .A(reg_buf_0), .B(_0111_), .Y(_0173_) );
  NOR2 _0682_ ( .A(_0062_), .B(_0159_), .Y(_0174_) );
  NAND3 _0683_ ( .A(_0172_), .B(_0173_), .C(_0174_), .Y(_0175_) );
  AND4_X1 _0684_ ( .A(_0163_), .B(_0172_), .C(_0173_), .D(_0174_), .Y(_0176_) );
  XNOR2 _0685_ ( .A(_0163_), .B(_0175_), .Y(_0177_) );
  NOR2 _0686_ ( .A(pc_cout), .B(_0152_), .Y(_0178_) );
  OAI21 _0687_ ( .A1(fo_net_8_g1), .A2(_0167_), .B(_0111_), .Y(_0179_) );
  NAND2 _0688_ ( .A(cy), .B(_0179_), .Y(_0180_) );
  NOR2 _0689_ ( .A(fo_net_8_g1), .B(_0164_), .Y(_0181_) );
  NAND2 _0690_ ( .A(_0000_), .B(_0111_), .Y(_0182_) );
  OAI21 _0691_ ( .A1(_0181_), .A2(_0182_), .B(_0174_), .Y(_0183_) );
  AOI21 _0692_ ( .A1(_0091_), .A2(_0119_), .B(_0183_), .Y(_0184_) );
  AOI21 _0693_ ( .A1(_0180_), .A2(_0184_), .B(_0178_), .Y(_0185_) );
  XOR2 _0694_ ( .A(_0177_), .B(_0185_), .Y(_0186_) );
  OAI21 _0695_ ( .A1(_0096_), .A2(_0125_), .B(_0118_), .Y(_0187_) );
  NAND2 _0696_ ( .A(_0057_), .B(_0058_), .Y(_0188_) );
  NOR3 _0697_ ( .A(acc_3), .B(_0560_), .C(_0188_), .Y(_0189_) );
  NAND2 _0698_ ( .A(_0059_), .B(_0070_), .Y(_0190_) );
  NOR3 _0699_ ( .A(acc_0), .B(_0559_), .C(_0190_), .Y(_0191_) );
  NOR2 _0700_ ( .A(_0189_), .B(_0191_), .Y(_0192_) );
  NOR3 _0701_ ( .A(acc_1), .B(_0561_), .C(_0190_), .Y(_0193_) );
  NOR3 _0702_ ( .A(acc_2), .B(_0003_), .C(_0188_), .Y(_0194_) );
  NOR2 _0703_ ( .A(_0193_), .B(_0194_), .Y(_0195_) );
  OAI21 _0704_ ( .A1(_0188_), .A2(_0190_), .B(_0195_), .Y(_0196_) );
  NOR3 _0705_ ( .A(_0189_), .B(_0191_), .C(_0196_), .Y(_0197_) );
  NAND2 _0706_ ( .A(_0100_), .B(_0197_), .Y(_0198_) );
  NAND2 _0707_ ( .A(_0561_), .B(_0097_), .Y(_0199_) );
  AOI22 _0708_ ( .A1(_0000_), .A2(_0086_), .B1(_0088_), .B2(acc_1), .Y(_0200_) );
  NAND2 _0709_ ( .A(_0199_), .B(_0200_), .Y(_0201_) );
  AOI21 _0710_ ( .A1(cy), .A2(_0085_), .B(_0201_), .Y(_0202_) );
  OAI21 _0711_ ( .A1(_0189_), .A2(_0193_), .B(_0100_), .Y(_0203_) );
  AND3_X1 _0712_ ( .A(_0198_), .B(_0202_), .C(_0203_), .Y(_0204_) );
  AOI21 _0713_ ( .A1(_0067_), .A2(_0131_), .B(fo_net_9_g0), .Y(_0205_) );
  OAI21 _0714_ ( .A1(_0187_), .A2(_0205_), .B(_0186_), .Y(_0206_) );
  AOI22 _0715_ ( .A1(fo_net_5_g0), .A2(_0123_), .B1(_0131_), .B2(_0205_), .Y(_0207_) );
  OAI21 _0716_ ( .A1(_0125_), .A2(_0204_), .B(_0207_), .Y(_0208_) );
  AOI21 _0717_ ( .A1(reg_buf_0), .A2(_0122_), .B(_0208_), .Y(_0209_) );
  NAND2 _0718_ ( .A(_0206_), .B(_0209_), .Y(_0210_) );
  NOR2 _0720_ ( .A(acc_1), .B(_0139_), .Y(_0211_) );
  AOI21 _0721_ ( .A1(_0177_), .A2(_0185_), .B(_0176_), .Y(_0212_) );
  MUX2 _0722_ ( .A(buf_m_1), .B(sram_do[1]), .S(_0148_), .Y(_0213_) );
  MUX2 _0723_ ( .A(buf_h_1), .B(sram_do[1]), .S(pc_init_n), .Y(_0214_) );
  INV_X1 _0724_ ( .A(_0214_), .Y(_0215_) );
  AOI21 _0725_ ( .A1(_0140_), .A2(_0215_), .B(_0152_), .Y(_0216_) );
  OAI21 _0726_ ( .A1(_0140_), .A2(_0213_), .B(_0216_), .Y(_0217_) );
  MUX2 _0727_ ( .A(buf_l_1), .B(sram_do[1]), .S(_0148_), .Y(_0218_) );
  NAND2 _0728_ ( .A(_0156_), .B(_0218_), .Y(_0219_) );
  OAI21 _0729_ ( .A1(acc_1), .A2(_0159_), .B(phase_2), .Y(_0220_) );
  INV_X1 _0730_ ( .A(_0220_), .Y(_0221_) );
  OAI21 _0731_ ( .A1(reg_buf_1), .A2(_0160_), .B(_0221_), .Y(_0222_) );
  NAND3 _0732_ ( .A(_0217_), .B(_0219_), .C(_0222_), .Y(_0223_) );
  AND3_X1 _0733_ ( .A(acc_0), .B(_0560_), .C(_0559_), .Y(_0224_) );
  AOI21 _0734_ ( .A1(acc_1), .A2(_0560_), .B(acc_2), .Y(_0225_) );
  OR3 _0735_ ( .A(_0070_), .B(_0224_), .C(_0225_), .Y(_0226_) );
  NOR2 _0736_ ( .A(cy), .B(_0094_), .Y(_0227_) );
  OAI21 _0737_ ( .A1(_0092_), .A2(_0094_), .B(fo_net_10_g1), .Y(_0228_) );
  AOI21 _0738_ ( .A1(_0226_), .A2(_0227_), .B(_0228_), .Y(_0229_) );
  MUX2 _0739_ ( .A(_0164_), .B(_0166_), .S(din1_in_th), .Y(_0230_) );
  NOR2 _0740_ ( .A(_0229_), .B(_0230_), .Y(_0231_) );
  AOI21 _0741_ ( .A1(_0017_), .A2(fo_net_7_g0), .B(_0110_), .Y(_0232_) );
  OAI21 _0742_ ( .A1(fo_net_7_g0), .A2(_0231_), .B(_0232_), .Y(_0233_) );
  OR2 _0743_ ( .A(reg_buf_1), .B(_0111_), .Y(_0234_) );
  AND3_X1 _0744_ ( .A(_0174_), .B(_0233_), .C(_0234_), .Y(_0235_) );
  NAND2 _0745_ ( .A(_0223_), .B(_0235_), .Y(_0236_) );
  XNOR2 _0746_ ( .A(_0223_), .B(_0235_), .Y(_0237_) );
  XOR2 _0747_ ( .A(_0212_), .B(_0237_), .Y(_0238_) );
  AOI21 _0748_ ( .A1(_0071_), .A2(_0131_), .B(fo_net_10_g1), .Y(_0239_) );
  OAI21 _0749_ ( .A1(_0187_), .A2(_0239_), .B(_0238_), .Y(_0240_) );
  NAND2 _0750_ ( .A(_0131_), .B(_0239_), .Y(_0241_) );
  AOI22 _0751_ ( .A1(reg_buf_1), .A2(_0122_), .B1(_0123_), .B2(fo_net_3_g0), .Y(_0242_) );
  AOI22 _0752_ ( .A1(cy), .A2(_0086_), .B1(_0097_), .B2(_0559_), .Y(_0243_) );
  AOI22 _0753_ ( .A1(acc_0), .A2(_0082_), .B1(_0088_), .B2(acc_2), .Y(_0244_) );
  NAND2 _0754_ ( .A(_0192_), .B(_0196_), .Y(_0245_) );
  NAND2 _0755_ ( .A(_0100_), .B(_0245_), .Y(_0246_) );
  NAND3 _0756_ ( .A(_0243_), .B(_0244_), .C(_0246_), .Y(_0247_) );
  NAND2 _0757_ ( .A(_0126_), .B(_0247_), .Y(_0248_) );
  AND4_X1 _0758_ ( .A(_0139_), .B(_0241_), .C(_0242_), .D(_0248_), .Y(_0249_) );
  AOI21 _0759_ ( .A1(_0240_), .A2(_0249_), .B(_0211_), .Y(_0023_) );
  NOR2 _0760_ ( .A(acc_2), .B(_0139_), .Y(_0250_) );
  OAI21 _0761_ ( .A1(_0212_), .A2(_0237_), .B(_0236_), .Y(_0251_) );
  MUX2 _0762_ ( .A(buf_m_2), .B(sram_do[2]), .S(_0148_), .Y(_0252_) );
  MUX2 _0763_ ( .A(buf_h_2), .B(sram_do[2]), .S(pc_init_n), .Y(_0253_) );
  INV_X1 _0764_ ( .A(_0253_), .Y(_0254_) );
  AOI21 _0765_ ( .A1(_0140_), .A2(_0254_), .B(_0152_), .Y(_0255_) );
  OAI21 _0766_ ( .A1(_0140_), .A2(_0252_), .B(_0255_), .Y(_0256_) );
  MUX2 _0767_ ( .A(buf_l_2), .B(sram_do[2]), .S(_0148_), .Y(_0257_) );
  NAND2 _0768_ ( .A(_0156_), .B(_0257_), .Y(_0258_) );
  AOI21 _0769_ ( .A1(_0061_), .A2(_0159_), .B(_0062_), .Y(_0259_) );
  OAI21 _0770_ ( .A1(acc_2), .A2(_0159_), .B(_0259_), .Y(_0260_) );
  NAND3 _0771_ ( .A(_0256_), .B(_0258_), .C(_0260_), .Y(_0261_) );
  INV_X1 _0772_ ( .A(_0261_), .Y(_0262_) );
  MUX2 _0773_ ( .A(_0164_), .B(_0166_), .S(din2_in_th), .Y(_0263_) );
  NOR2 _0774_ ( .A(_0229_), .B(_0263_), .Y(_0264_) );
  AOI21 _0775_ ( .A1(_0018_), .A2(fo_net_7_g0), .B(_0110_), .Y(_0265_) );
  OAI21 _0776_ ( .A1(fo_net_7_g0), .A2(_0264_), .B(_0265_), .Y(_0266_) );
  OR2 _0777_ ( .A(reg_buf_2), .B(_0111_), .Y(_0267_) );
  NAND3 _0778_ ( .A(_0174_), .B(_0266_), .C(_0267_), .Y(_0268_) );
  NOR2 _0779_ ( .A(_0262_), .B(_0268_), .Y(_0269_) );
  NAND2 _0780_ ( .A(_0262_), .B(_0268_), .Y(_0270_) );
  XNOR2 _0781_ ( .A(_0262_), .B(_0268_), .Y(_0271_) );
  XNOR2 _0782_ ( .A(_0251_), .B(_0271_), .Y(_0272_) );
  AOI21 _0783_ ( .A1(_0073_), .A2(_0131_), .B(fo_net_10_g1), .Y(_0273_) );
  OAI21 _0784_ ( .A1(_0187_), .A2(_0273_), .B(_0272_), .Y(_0274_) );
  NAND2 _0785_ ( .A(_0100_), .B(_0194_), .Y(_0275_) );
  NAND2 _0786_ ( .A(acc_1), .B(_0082_), .Y(_0276_) );
  AOI22 _0787_ ( .A1(acc_3), .A2(_0088_), .B1(_0097_), .B2(_0560_), .Y(_0277_) );
  NAND4 _0788_ ( .A(_0198_), .B(_0275_), .C(_0276_), .D(_0277_), .Y(_0278_) );
  NAND2 _0789_ ( .A(_0131_), .B(_0273_), .Y(_0279_) );
  AOI22 _0790_ ( .A1(reg_buf_2), .A2(_0122_), .B1(_0123_), .B2(fo_net_1_g0), .Y(_0280_) );
  NAND3 _0791_ ( .A(_0139_), .B(_0279_), .C(_0280_), .Y(_0281_) );
  AOI21 _0792_ ( .A1(_0126_), .A2(_0278_), .B(_0281_), .Y(_0282_) );
  AOI21 _0793_ ( .A1(_0274_), .A2(_0282_), .B(_0250_), .Y(_0022_) );
  NOR2 _0794_ ( .A(_0008_), .B(_0140_), .Y(_0283_) );
  INV_X1 _0795_ ( .A(fo_net_16_g1), .Y(_0284_) );
  NAND2 _0796_ ( .A(_0120_), .B(_0158_), .Y(_0285_) );
  INV_X1 _0797_ ( .A(_0285_), .Y(_0286_) );
  NAND3 _0798_ ( .A(opr_0), .B(_0562_), .C(opr_1), .Y(_0287_) );
  AOI21 _0799_ ( .A1(opr_2), .A2(_0287_), .B(_0068_), .Y(_0288_) );
  OAI21 _0800_ ( .A1(_0286_), .A2(_0288_), .B(fo_net_12_g1), .Y(_0289_) );
  NAND4 _0801_ ( .A(fo_net_5_g0), .B(fo_net_11_g0), .C(_0112_), .D(_0141_), .Y(_0290_) );
  NAND2 _0802_ ( .A(_0289_), .B(_0290_), .Y(_0291_) );
  AND3_X1 _0803_ ( .A(_0013_), .B(fo_net_12_g1), .C(_0145_), .Y(_0292_) );
  AND3_X1 _0804_ ( .A(fo_net_6_g1), .B(fo_net_12_g1), .C(_0145_), .Y(_0293_) );
  NOR2 _0805_ ( .A(_0292_), .B(_0293_), .Y(_0294_) );
  AOI21 _0806_ ( .A1(_0291_), .A2(_0294_), .B(_0284_), .Y(_0295_) );
  OAI21 _0807_ ( .A1(_0105_), .A2(_0109_), .B(_0285_), .Y(_0296_) );
  AND2_X1 _0808_ ( .A(fo_net_11_g0), .B(_0296_), .Y(_0297_) );
  NOR2 _0809_ ( .A(fo_net_18_g1), .B(_0297_), .Y(_0298_) );
  NOR3 _0810_ ( .A(phase_0), .B(phase_1), .C(_0008_), .Y(_0299_) );
  OR2 _0811_ ( .A(fo_net_16_g1), .B(_0299_), .Y(_0300_) );
  NOR3 _0812_ ( .A(phase_2), .B(_0555_), .C(_0009_), .Y(_0301_) );
  OR3 _0813_ ( .A(phase_2), .B(_0555_), .C(_0009_), .Y(_0302_) );
  NOR3 _0814_ ( .A(_0134_), .B(_0300_), .C(_0301_), .Y(_0303_) );
  NAND2 _0815_ ( .A(_0144_), .B(_0299_), .Y(_0304_) );
  OAI21 _0816_ ( .A1(fo_net_13_g0), .A2(_0302_), .B(_0304_), .Y(_0305_) );
  NOR2 _0817_ ( .A(fo_net_11_g0), .B(fo_net_18_g1), .Y(_0306_) );
  NOR4 _0818_ ( .A(_0295_), .B(_0298_), .C(_0303_), .D(_0305_), .Y(_0307_) );
  AOI21 _0819_ ( .A1(_0057_), .A2(_0285_), .B(fo_net_17_g0), .Y(_0308_) );
  OAI21 _0820_ ( .A1(_0186_), .A2(_0285_), .B(_0308_), .Y(_0309_) );
  NAND2 _0821_ ( .A(sram_do[0]), .B(fo_net_15_g0), .Y(_0310_) );
  NOR2 _0822_ ( .A(_0134_), .B(fo_net_15_g0), .Y(_0311_) );
  NAND2 _0823_ ( .A(din0_in_th), .B(_0311_), .Y(_0312_) );
  NAND3 _0824_ ( .A(_0309_), .B(_0310_), .C(_0312_), .Y(_0313_) );
  AOI21 _0826_ ( .A1(_0058_), .A2(_0285_), .B(fo_net_17_g0), .Y(_0314_) );
  OAI21 _0827_ ( .A1(_0238_), .A2(_0285_), .B(_0314_), .Y(_0315_) );
  NAND2 _0828_ ( .A(sram_do[1]), .B(fo_net_15_g0), .Y(_0316_) );
  NAND2 _0829_ ( .A(din1_in_th), .B(_0311_), .Y(_0317_) );
  NAND3 _0830_ ( .A(_0315_), .B(_0316_), .C(_0317_), .Y(_0318_) );
  AOI21 _0832_ ( .A1(_0059_), .A2(_0285_), .B(fo_net_17_g0), .Y(_0319_) );
  OAI21 _0833_ ( .A1(_0272_), .A2(_0285_), .B(_0319_), .Y(_0320_) );
  NAND2 _0834_ ( .A(sram_do[2]), .B(fo_net_15_g0), .Y(_0321_) );
  NAND2 _0835_ ( .A(din2_in_th), .B(_0311_), .Y(_0322_) );
  NAND3 _0836_ ( .A(_0320_), .B(_0321_), .C(_0322_), .Y(_0323_) );
  NAND2 _0838_ ( .A(fo_net_12_g1), .B(_0299_), .Y(_0324_) );
  OR3 _0840_ ( .A(_0008_), .B(_0555_), .C(_0009_), .Y(_0325_) );
  INV_X1 _0841_ ( .A(fo_net_19_g0), .Y(sync) );
  OR3 _0842_ ( .A(_0107_), .B(_0130_), .C(_0136_), .Y(_0326_) );
  INV_X1 _0843_ ( .A(_0326_), .Y(_0327_) );
  AND2_X1 _0845_ ( .A(_0290_), .B(_0294_), .Y(_0328_) );
  AND2_X1 _0846_ ( .A(_0289_), .B(_0328_), .Y(_0329_) );
  NAND2 _0847_ ( .A(_0144_), .B(fo_net_16_g1), .Y(_0330_) );
  NOR3 _0848_ ( .A(_0134_), .B(_0300_), .C(fo_net_23_g2), .Y(_0331_) );
  NAND2 _0849_ ( .A(_0297_), .B(_0328_), .Y(_0332_) );
  NOR2 _0850_ ( .A(opr_0), .B(_0144_), .Y(_0333_) );
  NAND3 _0851_ ( .A(fo_net_14_g1), .B(_0112_), .C(_0141_), .Y(_0334_) );
  NOR2 _0852_ ( .A(fo_net_20_g1), .B(_0333_), .Y(_0335_) );
  NAND2 _0853_ ( .A(fo_net_22_g1), .B(_0334_), .Y(_0336_) );
  AOI21 _0854_ ( .A1(_0332_), .A2(_0335_), .B(_0331_), .Y(_0337_) );
  OAI21 _0855_ ( .A1(_0329_), .A2(_0330_), .B(_0337_), .Y(_0338_) );
  NOR2 _0856_ ( .A(_0292_), .B(_0330_), .Y(_0339_) );
  NAND3 _0857_ ( .A(_0144_), .B(fo_net_15_g0), .C(_0329_), .Y(_0340_) );
  NOR2 _0858_ ( .A(fo_net_19_g0), .B(_0334_), .Y(_0341_) );
  AOI21 _0859_ ( .A1(_0134_), .A2(_0334_), .B(_0341_), .Y(_0342_) );
  NAND2 _0860_ ( .A(_0340_), .B(_0342_), .Y(_0343_) );
  NAND2 _0861_ ( .A(fo_net_17_g0), .B(_0304_), .Y(_0344_) );
  OAI21 _0862_ ( .A1(fo_net_17_g0), .A2(_0334_), .B(_0304_), .Y(_0345_) );
  NAND2 _0863_ ( .A(_0143_), .B(_0300_), .Y(_0346_) );
  OAI21 _0864_ ( .A1(_0332_), .A2(_0336_), .B(_0346_), .Y(_0347_) );
  AOI22 _0865_ ( .A1(buf_l_2), .A2(_0338_), .B1(_0345_), .B2(buf_m_2), .Y(_0348_) );
  AOI22 _0866_ ( .A1(buf_h_2), .A2(_0343_), .B1(_0347_), .B2(reg_buf_2), .Y(_0349_) );
  NAND2 _0867_ ( .A(_0348_), .B(_0349_), .Y(sram_din[2]) );
  NAND2 _0868_ ( .A(buf_h_1), .B(_0343_), .Y(_0350_) );
  NAND2 _0869_ ( .A(buf_l_1), .B(_0338_), .Y(_0351_) );
  AOI22 _0870_ ( .A1(buf_m_1), .A2(_0345_), .B1(_0347_), .B2(reg_buf_1), .Y(_0352_) );
  NAND3 _0871_ ( .A(_0350_), .B(_0351_), .C(_0352_), .Y(sram_din[1]) );
  NAND2 _0872_ ( .A(buf_h_0), .B(_0343_), .Y(_0353_) );
  AOI22 _0873_ ( .A1(buf_m_0), .A2(_0345_), .B1(_0347_), .B2(reg_buf_0), .Y(_0354_) );
  NAND2 _0874_ ( .A(buf_l_0), .B(_0338_), .Y(_0355_) );
  NAND3 _0875_ ( .A(_0353_), .B(_0354_), .C(_0355_), .Y(sram_din[0]) );
  NOR2 _0876_ ( .A(phase_2), .B(_0140_), .Y(_0356_) );
  NOR3 _0877_ ( .A(phase_2), .B(phase_0), .C(_0009_), .Y(_0357_) );
  OR2 _0878_ ( .A(_0356_), .B(fo_net_24_g0), .Y(_0358_) );
  NOR2 _0879_ ( .A(_0300_), .B(fo_net_22_g1), .Y(_0359_) );
  NOR4 _0880_ ( .A(_0341_), .B(_0344_), .C(_0358_), .D(_0359_), .Y(_0360_) );
  NAND2 _0881_ ( .A(_0340_), .B(_0360_), .Y(sram_addr_4) );
  NOR2 _0882_ ( .A(_0292_), .B(_0333_), .Y(_0361_) );
  NAND3 _0883_ ( .A(opa_3), .B(fo_net_23_g2), .C(_0361_), .Y(_0362_) );
  OAI21 _0884_ ( .A1(_0291_), .A2(_0293_), .B(_0339_), .Y(_0363_) );
  NAND2 _0885_ ( .A(_0346_), .B(_0363_), .Y(_0364_) );
  AOI22 _0886_ ( .A1(sp_1), .A2(sram_addr_4), .B1(_0364_), .B2(opa_3), .Y(_0365_) );
  NAND2 _0887_ ( .A(_0362_), .B(_0365_), .Y(sram_addr_3) );
  NAND2 _0888_ ( .A(sp_0), .B(sram_addr_4), .Y(_0366_) );
  NAND2 _0889_ ( .A(fo_net_2_g1), .B(_0364_), .Y(_0367_) );
  NAND3 _0890_ ( .A(fo_net_1_g0), .B(fo_net_23_g2), .C(_0361_), .Y(_0368_) );
  NAND3 _0891_ ( .A(_0366_), .B(_0367_), .C(_0368_), .Y(sram_addr_2) );
  MUX2 _0892_ ( .A(fo_net_19_g0), .B(_0146_), .S(_0156_), .Y(_0369_) );
  NOR2 _0893_ ( .A(fo_net_14_g1), .B(fo_net_20_g1), .Y(_0370_) );
  OR2 _0894_ ( .A(fo_net_14_g1), .B(fo_net_20_g1), .Y(_0371_) );
  NAND2 _0895_ ( .A(_0104_), .B(_0158_), .Y(_0372_) );
  OR3 _0896_ ( .A(_0063_), .B(_0188_), .C(_0190_), .Y(_0373_) );
  AOI22 _0897_ ( .A1(fo_net_4_g1), .A2(cy), .B1(_0079_), .B2(fo_net_6_g1), .Y(_0374_) );
  NAND2 _0898_ ( .A(_0373_), .B(_0374_), .Y(_0375_) );
  XOR2 _0899_ ( .A(opa_3), .B(_0375_), .Y(_0376_) );
  NAND2 _0900_ ( .A(_0115_), .B(_0141_), .Y(_0377_) );
  OAI22 _0901_ ( .A1(isz_taken), .A2(_0372_), .B1(_0376_), .B2(_0377_), .Y(_0378_) );
  NAND2 _0902_ ( .A(fo_net_23_g2), .B(_0378_), .Y(_0379_) );
  NAND2 _0903_ ( .A(_0117_), .B(_0158_), .Y(_0380_) );
  NAND3 _0904_ ( .A(_0372_), .B(_0377_), .C(_0380_), .Y(_0381_) );
  OR2 _0905_ ( .A(fo_net_20_g1), .B(_0381_), .Y(_0382_) );
  AND2_X1 _0906_ ( .A(_0379_), .B(_0382_), .Y(_0383_) );
  OAI22 _0907_ ( .A1(_0145_), .A2(_0371_), .B1(_0383_), .B2(fo_net_12_g1), .Y(_0384_) );
  NOR2 _0908_ ( .A(_0369_), .B(_0384_), .Y(_0385_) );
  MUX2 _0909_ ( .A(sram_do[0]), .B(buf_m_0), .S(fo_net_13_g0), .Y(_0386_) );
  MUX2 _0910_ ( .A(_0186_), .B(_0386_), .S(fo_net_21_g0), .Y(_0387_) );
  OAI21 _0912_ ( .A1(fo_net_16_g1), .A2(fo_net_23_g2), .B(fo_net_3_g0), .Y(_0388_) );
  OAI22 _0913_ ( .A1(_0064_), .A2(_0346_), .B1(_0388_), .B2(_0292_), .Y(_0389_) );
  OR3 _0914_ ( .A(_0343_), .B(fo_net_24_g0), .C(_0389_), .Y(sram_addr_1) );
  NOR2 _0916_ ( .A(_0290_), .B(fo_net_19_g0), .Y(_0390_) );
  AOI22 _0917_ ( .A1(_0253_), .A2(fo_net_24_g0), .B1(_0390_), .B2(sram_do[2]), .Y(_0391_) );
  NAND2 _0918_ ( .A(fo_net_12_g1), .B(_0113_), .Y(_0392_) );
  NAND3 _0919_ ( .A(_0004_), .B(fo_net_11_g0), .C(_0113_), .Y(_0393_) );
  AOI21 _0920_ ( .A1(_0290_), .A2(_0393_), .B(fo_net_17_g0), .Y(_0394_) );
  MUX2 _0921_ ( .A(reg_buf_2), .B(acc_2), .S(_0290_), .Y(_0395_) );
  AOI22 _0922_ ( .A1(_0252_), .A2(_0356_), .B1(_0394_), .B2(_0395_), .Y(_0396_) );
  NAND3 _0923_ ( .A(_0258_), .B(_0391_), .C(_0396_), .Y(d_out[2]) );
  AOI22 _0924_ ( .A1(_0214_), .A2(fo_net_24_g0), .B1(_0390_), .B2(sram_do[1]), .Y(_0397_) );
  MUX2 _0925_ ( .A(reg_buf_1), .B(acc_1), .S(_0290_), .Y(_0398_) );
  AOI22 _0926_ ( .A1(_0213_), .A2(_0356_), .B1(_0394_), .B2(_0398_), .Y(_0399_) );
  NAND3 _0927_ ( .A(_0219_), .B(_0397_), .C(_0399_), .Y(d_out[1]) );
  NAND2 _0928_ ( .A(phase_0), .B(phase_1), .Y(_0400_) );
  XOR2 _0929_ ( .A(phase_0), .B(phase_1), .Y(_0556_) );
  NAND2 _0930_ ( .A(_0147_), .B(_0356_), .Y(_0401_) );
  OAI21 _0931_ ( .A1(_0356_), .A2(_0359_), .B(_0401_), .Y(_0402_) );
  NOR2 _0932_ ( .A(_0299_), .B(_0370_), .Y(_0403_) );
  AOI21 _0933_ ( .A1(fo_net_14_g1), .A2(_0144_), .B(_0403_), .Y(_0404_) );
  AOI21 _0934_ ( .A1(fo_net_16_g1), .A2(_0294_), .B(_0404_), .Y(_0405_) );
  NAND4 _0935_ ( .A(_0379_), .B(_0382_), .C(_0402_), .D(_0405_), .Y(_0406_) );
  INV_X1 _0936_ ( .A(_0406_), .Y(_0407_) );
  NAND2 _0937_ ( .A(_0186_), .B(_0359_), .Y(_0408_) );
  AOI22 _0938_ ( .A1(din0_in_th), .A2(_0299_), .B1(fo_net_21_g0), .B2(reg_buf_0), .Y(_0409_) );
  NAND3 _0939_ ( .A(_0310_), .B(_0408_), .C(_0409_), .Y(_0410_) );
  AOI22 _0941_ ( .A1(_0150_), .A2(fo_net_24_g0), .B1(_0390_), .B2(sram_do[0]), .Y(_0411_) );
  MUX2 _0942_ ( .A(reg_buf_0), .B(acc_0), .S(_0290_), .Y(_0412_) );
  AOI22 _0943_ ( .A1(_0149_), .A2(_0356_), .B1(_0394_), .B2(_0412_), .Y(_0413_) );
  NAND3 _0944_ ( .A(_0157_), .B(_0411_), .C(_0413_), .Y(d_out[0]) );
  NAND2 _0945_ ( .A(fo_net_11_g0), .B(_0301_), .Y(_0414_) );
  AOI21 _0948_ ( .A1(_0290_), .A2(_0392_), .B(_0136_), .Y(_0415_) );
  NOR3 _0949_ ( .A(_0327_), .B(fo_net_25_g1), .C(_0415_), .Y(_0416_) );
  OR2 _0950_ ( .A(_0012_), .B(_0416_), .Y(cm_ram[2]) );
  OR2 _0951_ ( .A(_0011_), .B(_0416_), .Y(cm_ram[1]) );
  OR4 _0952_ ( .A(bank_sel_1), .B(bank_sel_3), .C(bank_sel_2), .D(_0416_), .Y(cm_ram[0]) );
  NAND2 _0953_ ( .A(_0238_), .B(_0359_), .Y(_0417_) );
  AOI22 _0954_ ( .A1(din1_in_th), .A2(_0299_), .B1(fo_net_21_g0), .B2(reg_buf_1), .Y(_0418_) );
  NAND3 _0955_ ( .A(_0316_), .B(_0417_), .C(_0418_), .Y(_0419_) );
  NAND2 _0957_ ( .A(fo_net_6_g1), .B(_0290_), .Y(_0420_) );
  OR2 _0958_ ( .A(_0293_), .B(_0420_), .Y(_0421_) );
  OAI21 _0959_ ( .A1(_0289_), .A2(_0421_), .B(_0144_), .Y(_0422_) );
  NAND2 _0960_ ( .A(fo_net_16_g1), .B(_0422_), .Y(_0423_) );
  OAI21 _0961_ ( .A1(fo_net_5_g0), .A2(_0292_), .B(_0335_), .Y(_0424_) );
  NOR2 _0962_ ( .A(_0345_), .B(_0356_), .Y(_0425_) );
  NAND3 _0963_ ( .A(_0423_), .B(_0424_), .C(_0425_), .Y(sram_addr_0) );
  NAND2 _0964_ ( .A(_0083_), .B(_0089_), .Y(_0426_) );
  NAND2 _0965_ ( .A(_0129_), .B(_0426_), .Y(_0427_) );
  NOR3 _0966_ ( .A(fo_net_1_g0), .B(opa_3), .C(_0081_), .Y(_0428_) );
  NOR3 _0967_ ( .A(_0090_), .B(_0427_), .C(_0428_), .Y(_0429_) );
  AND4_X1 _0968_ ( .A(_0095_), .B(_0098_), .C(_0106_), .D(_0429_), .Y(_0430_) );
  AOI21 _0969_ ( .A1(_0107_), .A2(_0119_), .B(_0136_), .Y(_0431_) );
  NAND2 _0970_ ( .A(_0132_), .B(_0431_), .Y(_0432_) );
  AOI21 _0971_ ( .A1(_0093_), .A2(_0430_), .B(_0432_), .Y(_0433_) );
  NOR2 _0972_ ( .A(cy), .B(_0433_), .Y(_0434_) );
  MUX2 _0973_ ( .A(buf_m_3), .B(sram_do[3]), .S(_0148_), .Y(_0435_) );
  MUX2 _0974_ ( .A(buf_h_3), .B(sram_do[3]), .S(pc_init_n), .Y(_0436_) );
  INV_X1 _0975_ ( .A(_0436_), .Y(_0437_) );
  AOI21 _0976_ ( .A1(_0140_), .A2(_0437_), .B(_0152_), .Y(_0438_) );
  OAI21 _0977_ ( .A1(_0140_), .A2(_0435_), .B(_0438_), .Y(_0439_) );
  MUX2 _0978_ ( .A(buf_l_3), .B(sram_do[3]), .S(_0148_), .Y(_0440_) );
  NAND2 _0979_ ( .A(_0156_), .B(_0440_), .Y(_0441_) );
  AOI21 _0980_ ( .A1(_0065_), .A2(_0159_), .B(_0062_), .Y(_0442_) );
  OAI21 _0981_ ( .A1(acc_3), .A2(_0159_), .B(_0442_), .Y(_0443_) );
  NAND3 _0982_ ( .A(_0439_), .B(_0441_), .C(_0443_), .Y(_0444_) );
  MUX2 _0983_ ( .A(_0164_), .B(_0166_), .S(din3_in_th), .Y(_0445_) );
  NOR2 _0984_ ( .A(_0169_), .B(_0445_), .Y(_0446_) );
  AOI21 _0985_ ( .A1(_0002_), .A2(fo_net_7_g0), .B(_0110_), .Y(_0447_) );
  OAI21 _0986_ ( .A1(fo_net_7_g0), .A2(_0446_), .B(_0447_), .Y(_0448_) );
  OR2 _0987_ ( .A(reg_buf_3), .B(_0111_), .Y(_0449_) );
  NAND3 _0988_ ( .A(_0174_), .B(_0448_), .C(_0449_), .Y(_0450_) );
  NAND4 _0989_ ( .A(_0174_), .B(_0444_), .C(_0448_), .D(_0449_), .Y(_0451_) );
  AOI21 _0990_ ( .A1(_0251_), .A2(_0270_), .B(_0269_), .Y(_0452_) );
  XOR2 _0991_ ( .A(_0444_), .B(_0450_), .Y(_0453_) );
  OAI21 _0992_ ( .A1(_0452_), .A2(_0453_), .B(_0451_), .Y(_0454_) );
  NAND2 _0993_ ( .A(_0095_), .B(_0106_), .Y(_0455_) );
  OAI21 _0994_ ( .A1(_0430_), .A2(_0455_), .B(_0454_), .Y(_0456_) );
  NAND3 _0995_ ( .A(_0000_), .B(_0083_), .C(_0089_), .Y(_0457_) );
  AOI22 _0996_ ( .A1(acc_3), .A2(_0082_), .B1(_0088_), .B2(acc_0), .Y(_0458_) );
  NAND3 _0997_ ( .A(_0129_), .B(_0457_), .C(_0458_), .Y(_0459_) );
  AOI22 _0998_ ( .A1(cy), .A2(_0430_), .B1(_0459_), .B2(_0106_), .Y(_0460_) );
  AND2_X1 _0999_ ( .A(_0433_), .B(_0460_), .Y(_0461_) );
  AOI21 _1000_ ( .A1(_0456_), .A2(_0461_), .B(_0434_), .Y(_0056_) );
  NAND2 _1001_ ( .A(_0370_), .B(_0381_), .Y(_0462_) );
  NAND4 _1002_ ( .A(_0013_), .B(_0120_), .C(_0141_), .D(_0370_), .Y(_0463_) );
  NAND2 _1003_ ( .A(fo_net_14_g1), .B(fo_net_20_g1), .Y(_0464_) );
  NAND3 _1004_ ( .A(_0462_), .B(_0463_), .C(_0464_), .Y(_0055_) );
  NOR2 _1005_ ( .A(reg_buf_3), .B(_0307_), .Y(_0465_) );
  XOR2 _1006_ ( .A(_0452_), .B(_0453_), .Y(_0466_) );
  AOI21 _1007_ ( .A1(_0070_), .A2(_0285_), .B(fo_net_17_g0), .Y(_0467_) );
  OAI21 _1008_ ( .A1(_0285_), .A2(_0466_), .B(_0467_), .Y(_0468_) );
  NAND2 _1009_ ( .A(sram_do[3]), .B(fo_net_15_g0), .Y(_0469_) );
  NAND2 _1010_ ( .A(din3_in_th), .B(_0311_), .Y(_0470_) );
  AND3_X1 _1011_ ( .A(_0307_), .B(_0469_), .C(_0470_), .Y(_0471_) );
  AOI21 _1012_ ( .A1(_0468_), .A2(_0471_), .B(_0465_), .Y(_0054_) );
  NOR2 _1013_ ( .A(acc_3), .B(_0139_), .Y(_0472_) );
  AOI21 _1014_ ( .A1(_0072_), .A2(_0131_), .B(fo_net_10_g1), .Y(_0473_) );
  OAI21 _1015_ ( .A1(_0187_), .A2(_0473_), .B(_0466_), .Y(_0474_) );
  NAND2 _1016_ ( .A(_0131_), .B(_0473_), .Y(_0475_) );
  AOI22 _1017_ ( .A1(reg_buf_3), .A2(_0122_), .B1(_0123_), .B2(opa_3), .Y(_0476_) );
  NAND3 _1018_ ( .A(_0139_), .B(_0475_), .C(_0476_), .Y(_0477_) );
  AOI21 _1019_ ( .A1(cy), .A2(_0088_), .B(_0086_), .Y(_0478_) );
  AOI22 _1020_ ( .A1(acc_2), .A2(_0082_), .B1(_0097_), .B2(_0003_), .Y(_0479_) );
  NAND3 _1021_ ( .A(_0198_), .B(_0478_), .C(_0479_), .Y(_0480_) );
  AOI21 _1022_ ( .A1(_0126_), .A2(_0480_), .B(_0477_), .Y(_0481_) );
  AOI21 _1023_ ( .A1(_0474_), .A2(_0481_), .B(_0472_), .Y(_0053_) );
  OAI21 _1024_ ( .A1(_0156_), .A2(_0356_), .B(_0147_), .Y(_0482_) );
  AOI22 _1026_ ( .A1(din3_in_th), .A2(_0299_), .B1(fo_net_22_g1), .B2(reg_buf_3), .Y(_0483_) );
  NAND3 _1027_ ( .A(_0407_), .B(_0469_), .C(_0483_), .Y(_0484_) );
  AOI21 _1028_ ( .A1(_0359_), .A2(_0466_), .B(_0484_), .Y(_0485_) );
  AOI21 _1029_ ( .A1(_0077_), .A2(_0406_), .B(_0485_), .Y(_0051_) );
  OR4 _1032_ ( .A(opr_0), .B(_0562_), .C(opr_1), .D(_0006_), .Y(_0486_) );
  AOI21 _1033_ ( .A1(_0115_), .A2(_0158_), .B(fo_net_20_g1), .Y(_0487_) );
  AOI21 _1034_ ( .A1(_0134_), .A2(_0486_), .B(_0487_), .Y(_0488_) );
  AOI21 _1035_ ( .A1(fo_net_18_g1), .A2(fo_net_20_g1), .B(_0306_), .Y(_0489_) );
  NAND3 _1036_ ( .A(_0371_), .B(_0488_), .C(_0489_), .Y(_0490_) );
  XNOR2 _1037_ ( .A(sp_0), .B(fo_net_20_g1), .Y(_0491_) );
  NOR2 _1038_ ( .A(_0490_), .B(_0491_), .Y(_0492_) );
  XOR2 _1039_ ( .A(sp_1), .B(_0492_), .Y(_0048_) );
  MUX2 _1041_ ( .A(sram_do[3]), .B(buf_m_3), .S(fo_net_13_g0), .Y(_0493_) );
  NAND2 _1042_ ( .A(fo_net_19_g0), .B(_0466_), .Y(_0494_) );
  MUX2 _1043_ ( .A(_0466_), .B(_0493_), .S(fo_net_22_g1), .Y(_0495_) );
  OR2 _1046_ ( .A(fo_net_22_g1), .B(fo_net_25_g1), .Y(_0496_) );
  NOR3 _1047_ ( .A(_0134_), .B(_0301_), .C(_0496_), .Y(_0497_) );
  AOI21 _1048_ ( .A1(fo_net_14_g1), .A2(_0144_), .B(_0302_), .Y(_0498_) );
  OR4 _1049_ ( .A(_0306_), .B(_0384_), .C(_0497_), .D(_0498_), .Y(_0499_) );
  OAI21 _1050_ ( .A1(_0147_), .A2(fo_net_23_g2), .B(fo_net_18_g1), .Y(_0500_) );
  OAI21 _1051_ ( .A1(_0499_), .A2(_0500_), .B(pc_init_n), .Y(_0501_) );
  OAI21 _1052_ ( .A1(fo_net_18_g1), .A2(_0486_), .B(_0302_), .Y(_0502_) );
  AOI21 _1053_ ( .A1(_0013_), .A2(_0370_), .B(_0502_), .Y(_0503_) );
  OAI21 _1054_ ( .A1(_0499_), .A2(_0503_), .B(_0501_), .Y(_0045_) );
  MUX2 _1055_ ( .A(sram_do[2]), .B(buf_m_2), .S(fo_net_13_g0), .Y(_0504_) );
  NAND2 _1056_ ( .A(_0272_), .B(fo_net_19_g0), .Y(_0505_) );
  MUX2 _1057_ ( .A(_0272_), .B(_0504_), .S(fo_net_21_g0), .Y(_0506_) );
  NAND2 _1059_ ( .A(_0238_), .B(fo_net_19_g0), .Y(_0507_) );
  MUX2 _1060_ ( .A(sram_do[1]), .B(buf_m_1), .S(fo_net_13_g0), .Y(_0508_) );
  MUX2 _1061_ ( .A(_0238_), .B(_0508_), .S(fo_net_21_g0), .Y(_0509_) );
  AOI22 _1063_ ( .A1(buf_l_3), .A2(_0338_), .B1(_0345_), .B2(buf_m_3), .Y(_0510_) );
  AOI22 _1064_ ( .A1(buf_h_3), .A2(_0343_), .B1(_0347_), .B2(reg_buf_3), .Y(_0511_) );
  NAND2 _1065_ ( .A(_0510_), .B(_0511_), .Y(sram_din[3]) );
  NAND2 _1066_ ( .A(_0146_), .B(fo_net_25_g1), .Y(_0512_) );
  AOI21 _1067_ ( .A1(fo_net_23_g2), .A2(_0380_), .B(_0370_), .Y(_0513_) );
  NAND3 _1068_ ( .A(_0496_), .B(_0512_), .C(_0513_), .Y(_0514_) );
  AOI21 _1069_ ( .A1(opa_3), .A2(fo_net_22_g1), .B(_0514_), .Y(_0515_) );
  AOI22 _1070_ ( .A1(_0078_), .A2(_0514_), .B1(_0515_), .B2(_0494_), .Y(_0044_) );
  NOR4 _1071_ ( .A(_0156_), .B(_0358_), .C(_0390_), .D(_0394_), .Y(d_hiz) );
  INV_X1 _1072_ ( .A(d_hiz), .Y(d_oe) );
  AOI22 _1073_ ( .A1(sram_do[3]), .A2(_0390_), .B1(_0436_), .B2(fo_net_24_g0), .Y(_0516_) );
  MUX2 _1074_ ( .A(reg_buf_3), .B(acc_3), .S(_0290_), .Y(_0517_) );
  AOI22 _1075_ ( .A1(_0356_), .A2(_0435_), .B1(_0517_), .B2(_0394_), .Y(_0518_) );
  NAND3 _1076_ ( .A(_0441_), .B(_0516_), .C(_0518_), .Y(d_out[3]) );
  NOR2 _1077_ ( .A(_0136_), .B(_0372_), .Y(_0519_) );
  NOR4 _1078_ ( .A(_0018_), .B(_0017_), .C(_0016_), .D(_0002_), .Y(_0520_) );
  NOR2 _1079_ ( .A(isz_taken), .B(_0519_), .Y(_0521_) );
  AOI21 _1080_ ( .A1(_0519_), .A2(_0520_), .B(_0521_), .Y(_0043_) );
  XNOR2 _1082_ ( .A(phase_2), .B(_0400_), .Y(_0557_) );
  MUX2 _1083_ ( .A(fo_net_5_g0), .B(_0186_), .S(fo_net_19_g0), .Y(_0522_) );
  AOI21 _1085_ ( .A1(fo_net_3_g0), .A2(fo_net_22_g1), .B(_0514_), .Y(_0523_) );
  AOI22 _1086_ ( .A1(_0076_), .A2(_0514_), .B1(_0523_), .B2(_0507_), .Y(_0040_) );
  OR2 _1087_ ( .A(_0005_), .B(_0416_), .Y(cm_ram[3]) );
  NOR2 _1089_ ( .A(_0091_), .B(_0427_), .Y(_0524_) );
  NOR3 _1090_ ( .A(fo_net_10_g1), .B(_0136_), .C(_0524_), .Y(_0525_) );
  NOR2 _1091_ ( .A(fo_net_25_g1), .B(_0525_), .Y(cm_rom) );
  NAND2 _1092_ ( .A(_0272_), .B(_0359_), .Y(_0526_) );
  AOI22 _1093_ ( .A1(din2_in_th), .A2(_0299_), .B1(fo_net_21_g0), .B2(reg_buf_2), .Y(_0527_) );
  NAND3 _1094_ ( .A(_0321_), .B(_0526_), .C(_0527_), .Y(_0528_) );
  AOI21 _1096_ ( .A1(_0329_), .A2(_0334_), .B(fo_net_18_g1), .Y(_0529_) );
  NOR2 _1097_ ( .A(_0297_), .B(_0333_), .Y(_0530_) );
  AOI21 _1098_ ( .A1(_0328_), .A2(_0530_), .B(fo_net_20_g1), .Y(_0531_) );
  AOI21 _1099_ ( .A1(_0147_), .A2(_0497_), .B(fo_net_25_g1), .Y(_0532_) );
  OAI22 _1100_ ( .A1(_0146_), .A2(_0302_), .B1(_0532_), .B2(_0075_), .Y(_0533_) );
  NOR4 _1101_ ( .A(_0300_), .B(_0529_), .C(_0531_), .D(_0533_), .Y(_0534_) );
  NOR3 _1102_ ( .A(rst_in_th), .B(clk_buf_r10), .C(_0534_), .Y(sram_ce) );
  AOI21 _1103_ ( .A1(fo_net_1_g0), .A2(fo_net_21_g0), .B(_0514_), .Y(_0535_) );
  AOI22 _1104_ ( .A1(_0074_), .A2(_0514_), .B1(_0535_), .B2(_0505_), .Y(_0039_) );
  OAI21 _1105_ ( .A1(_0143_), .A2(_0329_), .B(fo_net_15_g0), .Y(_0536_) );
  INV_X1 _1106_ ( .A(_0536_), .Y(_0537_) );
  AOI21 _1107_ ( .A1(_0147_), .A2(_0301_), .B(_0299_), .Y(_0538_) );
  OAI21 _1108_ ( .A1(fo_net_19_g0), .A2(_0332_), .B(_0538_), .Y(_0539_) );
  OR4 _1109_ ( .A(_0341_), .B(_0529_), .C(_0537_), .D(_0539_), .Y(sram_we) );
  MUXDFFRB _1111_ ( .CK(clk_buf_r8), .Q(pc_cout), .QB(_0540_), .RSTB(rst_n_buf_r8), .A(_0454_), .B(pc_cout), .S(_0482_) );
  MUXDFFRB _1112_ ( .CK(clk_buf_r10), .Q(sp_0), .QB(_0558_), .RSTB(rst_n_buf_r10), .A(_0558_), .B(sp_0), .S(_0490_) );
  DFFRB _1113_ ( .CK(clk_buf_r9), .D(_0048_), .Q(sp_1), .QB(_0542_), .RSTB(rst_n_buf_r9) );
  DFFRB _1114_ ( .CK(clk_buf_r7), .D(_0043_), .Q(isz_taken), .QB(_0545_), .RSTB(rst_n_buf_r7) );
  MUXDFFRB _1115_ ( .CK(clk_buf_r9), .Q(buf_h_0), .QB(_0546_), .RSTB(rst_n_buf_r9), .A(_0522_), .B(buf_h_0), .S(_0514_) );
  DFFRB _1116_ ( .CK(clk_buf_r10), .D(_0040_), .Q(buf_h_1), .QB(_0547_), .RSTB(rst_n_buf_r10) );
  DFFRB _1117_ ( .CK(clk_buf_r10), .D(_0039_), .Q(buf_h_2), .QB(_0548_), .RSTB(rst_n_buf_r10) );
  DFFRB _1118_ ( .CK(clk_buf_r8), .D(_0044_), .Q(buf_h_3), .QB(_0544_), .RSTB(rst_n_buf_r8) );
  DFFRB _1119_ ( .CK(clk_buf_r7), .D(_0045_), .Q(pc_init_n), .QB(_0007_), .RSTB(rst_n_buf_r7) );
  MUXDFFRB _1120_ ( .CK(clk_buf_r5), .Q(opr_0), .QB(_0563_), .RSTB(rst_n_buf_r5), .A(din0_in_th), .B(opr_0), .S(_0414_) );
  MUXDFFRB _1121_ ( .CK(clk_buf_r5), .Q(opr_1), .QB(_0010_), .RSTB(rst_n_buf_r5), .A(din1_in_th), .B(opr_1), .S(_0414_) );
  MUXDFFRB _1122_ ( .CK(clk_buf_r6), .Q(opr_2), .QB(_0562_), .RSTB(rst_n_buf_r6), .A(din2_in_th), .B(opr_2), .S(_0414_) );
  MUXDFFRB _1123_ ( .CK(clk_buf_r6), .Q(opr_3), .QB(_0006_), .RSTB(rst_n_buf_r6), .A(din3_in_th), .B(opr_3), .S(_0414_) );
  MUXDFFRB _1124_ ( .CK(clk_buf_r9), .Q(buf_l_0), .QB(_0549_), .RSTB(rst_n_buf_r9), .A(buf_l_0), .B(_0387_), .S(_0385_) );
  MUXDFFRB _1125_ ( .CK(clk_buf_r9), .Q(buf_l_1), .QB(_0550_), .RSTB(rst_n_buf_r9), .A(buf_l_1), .B(_0509_), .S(_0385_) );
  MUXDFFRB _1126_ ( .CK(clk_buf_r8), .Q(buf_l_2), .QB(_0551_), .RSTB(rst_n_buf_r8), .A(buf_l_2), .B(_0506_), .S(_0385_) );
  MUXDFFRB _1127_ ( .CK(clk_buf_r8), .Q(buf_l_3), .QB(_0543_), .RSTB(rst_n_buf_r8), .A(buf_l_3), .B(_0495_), .S(_0385_) );
  MUXDFFRB _1128_ ( .CK(clk_buf_r5), .Q(bank_sel_1), .QB(_0011_), .RSTB(rst_n_buf_r5), .A(acc_0), .B(bank_sel_1), .S(_0326_) );
  MUXDFFRB _1129_ ( .CK(clk_buf_r6), .Q(bank_sel_2), .QB(_0012_), .RSTB(rst_n_buf_r6), .A(acc_1), .B(bank_sel_2), .S(_0326_) );
  MUXDFFRB _1130_ ( .CK(clk_buf_r4), .Q(bank_sel_3), .QB(_0005_), .RSTB(rst_n_buf_r4), .A(acc_2), .B(bank_sel_3), .S(_0326_) );
  MUXDFFRB _1131_ ( .CK(clk_buf_r3), .Q(opa_0), .QB(_0013_), .RSTB(rst_n_buf_r3), .A(din0_in_th), .B(fo_net_6_g1), .S(_0324_) );
  MUXDFFRB _1132_ ( .CK(clk_buf_r4), .Q(opa_1), .QB(_0014_), .RSTB(rst_n_buf_r4), .A(din1_in_th), .B(fo_net_4_g1), .S(_0324_) );
  MUXDFFRB _1133_ ( .CK(clk_buf_r3), .Q(opa_2), .QB(_0015_), .RSTB(rst_n_buf_r3), .A(din2_in_th), .B(fo_net_2_g1), .S(_0324_) );
  MUXDFFRB _1134_ ( .CK(clk_buf_r4), .Q(opa_3), .QB(_0004_), .RSTB(rst_n_buf_r4), .A(din3_in_th), .B(opa_3), .S(_0324_) );
  MUXDFFRB _1135_ ( .CK(clk_buf_r5), .Q(buf_m_0), .QB(_0552_), .RSTB(rst_n_buf_r5), .A(buf_m_0), .B(_0410_), .S(_0407_) );
  MUXDFFRB _1136_ ( .CK(clk_buf_r6), .Q(buf_m_1), .QB(_0553_), .RSTB(rst_n_buf_r6), .A(buf_m_1), .B(_0419_), .S(_0407_) );
  MUXDFFRB _1137_ ( .CK(clk_buf_r7), .Q(buf_m_2), .QB(_0554_), .RSTB(rst_n_buf_r7), .A(buf_m_2), .B(_0528_), .S(_0407_) );
  DFFRB _1138_ ( .CK(clk_buf_r4), .D(_0051_), .Q(buf_m_3), .QB(_0541_), .RSTB(rst_n_buf_r4) );
  MUXDFFRB _1139_ ( .CK(clk_buf_r1), .Q(acc_0), .QB(_0561_), .RSTB(rst_n_buf_r1), .A(acc_0), .B(_0210_), .S(_0139_) );
  DFFRB _1140_ ( .CK(clk_buf_r1), .D(_0023_), .Q(acc_1), .QB(_0559_), .RSTB(rst_n_buf_r1) );
  DFFRB _1141_ ( .CK(clk_buf_r1), .D(_0022_), .Q(acc_2), .QB(_0560_), .RSTB(rst_n_buf_r1) );
  DFFRB _1142_ ( .CK(clk_buf_r2), .D(_0053_), .Q(acc_3), .QB(_0003_), .RSTB(rst_n_buf_r2) );
  MUXDFFRB _1143_ ( .CK(clk_buf_r2), .Q(reg_buf_0), .QB(_0016_), .RSTB(rst_n_buf_r2), .A(reg_buf_0), .B(_0313_), .S(_0307_) );
  MUXDFFRB _1144_ ( .CK(clk_buf_r2), .Q(reg_buf_1), .QB(_0017_), .RSTB(rst_n_buf_r2), .A(reg_buf_1), .B(_0318_), .S(_0307_) );
  MUXDFFRB _1145_ ( .CK(clk_buf_r2), .Q(reg_buf_2), .QB(_0018_), .RSTB(rst_n_buf_r2), .A(reg_buf_2), .B(_0323_), .S(_0307_) );
  DFFRB _1146_ ( .CK(clk_buf_r3), .D(_0054_), .Q(reg_buf_3), .QB(_0002_), .RSTB(rst_n_buf_r3) );
  DFFRB _1147_ ( .CK(clk_buf_r7), .D(_0055_), .Q(two_cycle), .QB(_0001_), .RSTB(rst_n_buf_r7) );
  DFFRB _1148_ ( .CK(clk_buf_r3), .D(_0056_), .Q(cy), .QB(_0000_), .RSTB(rst_n_buf_r3) );
  DFFRB _1149_ ( .CK(clk_buf_r10), .D(_0555_), .Q(phase_0), .QB(_0555_), .RSTB(rst_n_buf_r10) );
  DFFRB _1150_ ( .CK(clk_buf_r10), .D(_0556_), .Q(phase_1), .QB(_0009_), .RSTB(rst_n_buf_r10) );
  DFFRB _1151_ ( .CK(clk_buf_r10), .D(_0557_), .Q(phase_2), .QB(_0008_), .RSTB(rst_n_buf_r10) );
  SRAM128 u_sram ( .A0(sram_addr_0), .A1(sram_addr_1), .A2(sram_addr_2), .A3(sram_addr_3), .A4(sram_addr_4), .CE(sram_ce), .DIN(sram_din), .DO(sram_do), .WR(sram_we) );
  BUFTH u_bufth_clk ( .A(clk), .Y(clk_in_th) );
  BUFTH u_bufth_rst ( .A(rst), .Y(rst_in_th) );
  BUFTH u_bufth_test ( .A(test), .Y(test_in_th) );
  BUFTH u_bufth_din0 ( .A(d_in[0]), .Y(din0_in_th) );
  BUFTH u_bufth_din1 ( .A(d_in[1]), .Y(din1_in_th) );
  BUFTH u_bufth_din2 ( .A(d_in[2]), .Y(din2_in_th) );
  BUFTH u_bufth_din3 ( .A(d_in[3]), .Y(din3_in_th) );
  BUF_X2 u_clk_buf_r1 ( .A(clk_in_th), .Y(clk_buf_r1) );
  BUF_X2 u_rst_buf_r1 ( .A(rst_n), .Y(rst_n_buf_r1) );
  BUF_X2 u_clk_buf_r2 ( .A(clk_in_th), .Y(clk_buf_r2) );
  BUF_X2 u_rst_buf_r2 ( .A(rst_n), .Y(rst_n_buf_r2) );
  BUF_X2 u_clk_buf_r3 ( .A(clk_in_th), .Y(clk_buf_r3) );
  BUF_X2 u_rst_buf_r3 ( .A(rst_n), .Y(rst_n_buf_r3) );
  BUF_X2 u_clk_buf_r4 ( .A(clk_in_th), .Y(clk_buf_r4) );
  BUF_X2 u_rst_buf_r4 ( .A(rst_n), .Y(rst_n_buf_r4) );
  BUF_X2 u_clk_buf_r5 ( .A(clk_in_th), .Y(clk_buf_r5) );
  BUF_X2 u_rst_buf_r5 ( .A(rst_n), .Y(rst_n_buf_r5) );
  BUF_X2 u_clk_buf_r6 ( .A(clk_in_th), .Y(clk_buf_r6) );
  BUF_X2 u_rst_buf_r6 ( .A(rst_n), .Y(rst_n_buf_r6) );
  BUF_X2 u_clk_buf_r7 ( .A(clk_in_th), .Y(clk_buf_r7) );
  BUF_X2 u_rst_buf_r7 ( .A(rst_n), .Y(rst_n_buf_r7) );
  BUF_X2 u_clk_buf_r8 ( .A(clk_in_th), .Y(clk_buf_r8) );
  BUF_X2 u_rst_buf_r8 ( .A(rst_n), .Y(rst_n_buf_r8) );
  BUF_X2 u_clk_buf_r9 ( .A(clk_in_th), .Y(clk_buf_r9) );
  BUF_X2 u_rst_buf_r9 ( .A(rst_n), .Y(rst_n_buf_r9) );
  BUF_X2 u_clk_buf_r10 ( .A(clk_in_th), .Y(clk_buf_r10) );
  BUF_X2 u_rst_buf_r10 ( .A(rst_n), .Y(rst_n_buf_r10) );
  BUF_X2 u_fobuf_1_g0 ( .A(opa_2), .Y(fo_net_1_g0) );
  BUF_X2 u_fobuf_2_g1 ( .A(opa_2), .Y(fo_net_2_g1) );
  BUF_X2 u_fobuf_3_g0 ( .A(opa_1), .Y(fo_net_3_g0) );
  BUF_X2 u_fobuf_4_g1 ( .A(opa_1), .Y(fo_net_4_g1) );
  BUF_X2 u_fobuf_5_g0 ( .A(opa_0), .Y(fo_net_5_g0) );
  BUF_X2 u_fobuf_6_g1 ( .A(opa_0), .Y(fo_net_6_g1) );
  BUF_X2 u_fobuf_7_g0 ( .A(_0116_), .Y(fo_net_7_g0) );
  BUF_X2 u_fobuf_8_g1 ( .A(_0116_), .Y(fo_net_8_g1) );
  BUF_X2 u_fobuf_9_g0 ( .A(_0114_), .Y(fo_net_9_g0) );
  BUF_X2 u_fobuf_10_g1 ( .A(_0114_), .Y(fo_net_10_g1) );
  BUF_X2 u_fobuf_11_g0 ( .A(_0001_), .Y(fo_net_11_g0) );
  BUF_X2 u_fobuf_12_g1 ( .A(_0001_), .Y(fo_net_12_g1) );
  BUF_X2 u_fobuf_13_g0 ( .A(two_cycle), .Y(fo_net_13_g0) );
  BUF_X2 u_fobuf_14_g1 ( .A(two_cycle), .Y(fo_net_14_g1) );
  BUF_X2 u_fobuf_15_g0 ( .A(_0283_), .Y(fo_net_15_g0) );
  BUF_X2 u_fobuf_16_g1 ( .A(_0283_), .Y(fo_net_16_g1) );
  BUF_X2 u_fobuf_17_g0 ( .A(_0135_), .Y(fo_net_17_g0) );
  BUF_X2 u_fobuf_18_g1 ( .A(_0135_), .Y(fo_net_18_g1) );
  BUF_X2 u_fobuf_19_g0 ( .A(_0325_), .Y(fo_net_19_g0) );
  BUF_X2 u_fobuf_20_g1 ( .A(_0325_), .Y(fo_net_20_g1) );
  BUF_X2 u_fobuf_21_g0 ( .A(sync), .Y(fo_net_21_g0) );
  BUF_X2 u_fobuf_22_g1 ( .A(sync), .Y(fo_net_22_g1) );
  BUF_X2 u_fobuf_23_g2 ( .A(sync), .Y(fo_net_23_g2) );
  BUF_X2 u_fobuf_24_g0 ( .A(_0357_), .Y(fo_net_24_g0) );
  BUF_X2 u_fobuf_25_g1 ( .A(_0357_), .Y(fo_net_25_g1) );
endmodule
