jun1okamura/TR-1um_C4004_Clone2Build/(commit log)

2026-11-10 Add 10 iterative C4004 ASIC design trials (TR-1um_C4004_01..10) and summaries
    [ADB.sch, BIT_CELL.sch, BIT_CELL32.sch, DEC.sch, PDEC.sch, SA.sch, SACTR.sch, SRAM128.sch]
2026-11-11 Replace hardcoded local absolute paths with portable relative paths
    [Summary_EN.xlsx]
