jun1okamura/TR-1um_C4004_Clone2Build/(notices)

Notices in the files:
README.md:
License: Apache 2.0
